2AMLogic/gf180-sar-adc/sim/README.md

# sim/ — evidence record format

This directory holds simulation testbenches and their results. Results are
**append-only evidence**: once a record is written, it is never edited or
deleted. A re-run — even one that corrects a mistake — mints a new record
with a new ID; a correction references the record it supersedes rather than
overwriting it in place.

This convention exists because CLAUDE.md commits this repo to two rules that
need a concrete schema to be enforceable:

- **Verification is the product.** No claim without a testbench. PVT
  corners on every recorded result (see "Corner matrix run" below).
- **`sim/` results are append-only evidence.** Re-runs get new records;
  records are never edited or deleted.

## Provenance: ported from gf180-bandgap

Per CLAUDE.md ("bootstrap from the sim-harness pattern... once it lands"),
this format is **ported from `2AMLogic/gf180-bandgap`'s `sim/README.md`**
rather than designed from scratch. The directory/naming convention,
record-id and corner-id schemes, and the base summary-record schema are kept
identical to upstream. Divergences exist only where an ADC-specific need
requires them; each is called out at the point it occurs, and summarized
here:

1. **Corner matrix is not fixed to a specific PVT list.** Upstream's
   bandgap `CLAUDE.md` states an explicit matrix (−40/27/125 °C, ±10%
   supply, process corners) that its README quotes directly. This repo's
   `CLAUDE.md` states the *rule* ("PVT corners on every recorded result")
   without a repo-wide fixed matrix — the actual corner list is pinned by
   the ratified spec (#1) and produced by the corner runner (#2), neither of
   which exists yet. The "Corner matrix run" field below is therefore
   normative on *what a record must state*, not on a specific numeric list.
2. **Five ADC-specific field groups added**: dynamic-test (FFT) metadata,
   a linearity methodology field, an extended Monte Carlo convention (seed +
   mismatch scope), a noise methodology field, and a characterization
   record variant. None of these exist upstream — the bandgap block has no
   analog-to-digital conversion, code density, or coherent-sampling
   concerns. See "ADC-specific extensions" below.
3. Everything else (directory layout, `<record-id>` / `<corner-id>` schemes,
   the base summary-record field list, the append-only rule, and the
   extracted-vs-schematic / `Supersedes` semantics) is unchanged from
   upstream, so that #2 (this repo's corner runner, bootstrapped from the
   same upstream repo) does not have to reconcile gratuitous drift.

## Directory / naming convention

Each testbench topic gets its own experiment directory:

```
sim/
  <experiment-slug>/                 # e.g. inl-dnl, enob-fft, comparator-noise,
                                      # mc-cdac-mismatch, device-characterization
    testbench/                       # testbench netlist(s) / xschem export used
    netlist-snapshots/
      <record-id>.spice              # frozen DUT netlist used for this record
    corners/
      <record-id>/
        <corner-id>.log              # raw ngspice output per PVT point
                                      # e.g. ss_-40c_2.97v.log
    records/
      <record-id>.md                 # append-only summary record
```

- **`<experiment-slug>`** — short, descriptive, kebab-case name for what is
  being verified (`inl-dnl`, `enob-fft`, `comparator-noise`,
  `mc-cdac-mismatch`, `device-characterization`, ...). One directory per
  distinct claim being tested, not per run.
- **`<record-id>`** — unique and traceable:
  `<YYYYMMDD>-<HHMMSS>-<short-git-sha>` (e.g. `20260730-143000-9f2a1cd`).
  Re-runs simply mint a new `<record-id>`; nothing under `records/` is ever
  edited in place. The same `<record-id>` ties together the netlist
  snapshot, the raw per-corner logs, and the summary record for one run.
- **`<corner-id>`** — `<process-corner>_<temp>c_<supply>v.log`, e.g.
  `ss_-40c_2.97v.log`, `tt_27c_3.30v.log`, `ff_125c_3.63v.log`.
- **`testbench/`** is not versioned per record — it holds the current
  testbench netlist(s)/xschem export(s) used to generate records. If the
  testbench itself changes in a way that could affect comparability across
  records, note that in the new record's summary (e.g. under Claim or a
  free-text note).

## Summary record format

Each run produces one `records/<record-id>.md` file. All records carry the
base fields below; records substantiating specific kinds of claims (dynamic
test, linearity, Monte Carlo, noise, characterization) also carry the
matching ADC-specific extension fields.

### Base fields (ported from upstream, unchanged)

- **Record ID** — the `<record-id>` for this run (matches the filename and
  the corresponding `netlist-snapshots/` / `corners/` subdirectory).
- **Claim** — which spec parameter/line this record substantiates (reference
  the ratified spec, e.g. `spec/<file>.md#<anchor>`, once ratified specs
  exist — see #1).
- **Netlist provenance** — `schematic` (`design/...`) or `extracted`
  (post-layout, `layout/...`). Required so post-layout re-runs are
  distinguishable from the original schematic-level record.
- **Corner matrix run** — explicit list of (process corner, temperature,
  supply) points actually executed. Must be the full PVT matrix pinned by
  the ratified spec (#1) / produced by the corner runner (#2) unless the
  record states why a subset was used (see "Subset-corner justification"
  below).
- **Statistical convention** (when applicable, e.g. Monte Carlo mismatch
  analysis) — see the Monte Carlo extension below for the ADC-specific
  fields this carries in addition to upstream's base N-samples-and-sigma.
- **Result** — per-corner pass/fail, plus an overall pass/fail against the
  ratified spec value. (Characterization records use "Measured value(s)"
  instead — see the Characterization-record variant below.)
- **Links** — paths to the testbench file(s), the frozen netlist snapshot,
  and the raw per-corner logs used to produce this record.
- **Timestamp / author** — when the record was created and who (human or
  agent) created it.
- **Supersedes** (optional) — the prior `<record-id>` this record
  supersedes, for corrections or for a post-layout extracted re-run that
  reports a schematic-vs-extracted delta against the schematic-level
  record. Mirrors the status/supersession language used for `spec/`
  decision records (see #6), so both conventions read as one house style.

  **A record with no `ok` point supersedes nothing.** A run in which every
  point errored (fleet timeout, Spot reclamation, a broken deck) measured
  nothing, so it cannot replace a record that did measure the deck — and
  because `sim/` is append-only, a measurement-free chain tip is permanent
  once committed. `run_corners.py` therefore **withholds** a requested
  `--supersedes` pointer when `points_ok` is 0: the record is still written
  as evidence of the attempt, but its field reads
  `(none — no point reached ok, so this record supersedes nothing; requested
  <id> withheld)`, which the chain checker reads as "no edge". The run also
  prints a note to stderr saying so; the exit code is unchanged. A run with
  **at least one** `ok` point keeps its pointer, partial or not.

  One record predates this rule and is wrong:
  `sim/sar-logic-functional-gates/records/20261113-080712-3eed6a0.md` has
  0/45 points `ok` yet declares `Supersedes: 20260917-044312-c7ff0ff`. It
  cannot be edited (append-only) and no measurement-free record can undo a
  `Supersedes` edge — only a measured successor can move the tip. The repair
  is therefore the next measured `sar-logic-functional-gates` record naming
  `20261113-080712-3eed6a0` as its own `Supersedes` target (owned by #753).

#### Subset-corner justification

A record may legitimately run fewer than the full PVT matrix (e.g. a
Monte Carlo mismatch distribution evaluated at nominal PVT only, or a
behaviorally-accelerated linearity sweep run at a reduced corner set to
bound simulation time). This is allowed, but the record's "Corner matrix
run" field must **state which corners were run and why the rest were
omitted** — an unexplained subset is not a valid record.

#### Correction-supersession vs distinct-claim distinction

`Supersedes` is only for records that **replace** a prior result for the
*same claim* (a correction, or a schematic → extracted re-run of the same
claim). A new record that tests a **different** claim about the same DUT
(e.g. a Monte Carlo distribution check following a corner-matrix pass/fail
check on the same parameter) is not a correction and must leave
`Supersedes` empty — see the two base worked-example records below, which
illustrate exactly this distinction.

### ADC-specific extensions

These fields have no upstream equivalent; each is required only on records
substantiating the corresponding kind of claim.

- **Dynamic-test (FFT) metadata** — required on any record substantiating an
  FFT-derived claim (ENOB, SNDR, SFDR, THD, ...):
  - **N samples** — FFT record length.
  - **Input frequency / coherent bin** — analog input frequency and the
    integer FFT bin it lands on under coherent sampling
    (`f_in = bin * f_s / N`, with `bin` coprime to `N`).
  - **Window** — `none` for coherent sampling (the default and preferred
    method); otherwise the windowing function name (e.g. `hann`,
    `blackman-harris`) and why coherent sampling was not used.
  - **Sampling rate** — `f_s` in Hz/MS/s.
- **Linearity methodology** — required on any INL/DNL record; states the
  code-set/method used, not left implied:
  - `full-1024-code-ramp` — every code exercised (exhaustive, most
    expensive).
  - `reduced-code-set-major-carry` — a reduced set concentrated at
    major-carry transitions (CDAC segment boundaries).
  - `code-density` — histogram/code-density method (e.g. sine-wave
    histogram) rather than a deterministic ramp.
  - `behavioral-accelerated` — a behaviorally-accelerated block substitutes
    for full transistor-level simulation on some portion of the codes;
    state which portion.
  - Free text after the tag should give the exact code count / transition
    list / acceleration method used.
- **Monte Carlo convention** — extends the base "Statistical convention"
  field. In addition to upstream's N samples and sigma level, a Monte Carlo
  record on this repo also states:
  - **Seed handling** — fixed seed value(s) used, or the seed-sweep policy
    (e.g. `seeds 1-500`, or ngspice's `.options seed=...` value(s)).
  - **Scope** — `mismatch-only` or `mismatch+process`, i.e. whether process
    (global) variation was included alongside device mismatch.
  - **Sigma level** — the sigma level the pass/fail criterion corresponds to
    (e.g. "±3σ within spec target").
- **Noise methodology** — required on any noise-budget record; states which
  method the claim rests on:
  - `transient-noise` — ngspice transient-noise analysis; must also state
    the **seed** and a **duration justification** (e.g. settling-time
    margin, noise-floor convergence check) so the run is reproducible and
    its length is defensible.
  - `ac-based` — an AC-noise-analysis-derived estimate (e.g. integrated
    output-referred noise from an `.noise` or `.ac` analysis with a stated
    integration bandwidth).
  - `both` — both methods were run and reported; state how they were
    reconciled (e.g. AC estimate as a bound, transient-noise as the
    reported claim).

### Characterization-record variant

A subset of records (e.g. device characterization, #4) report **measured
values under stated corner conditions** rather than pass/fail against a
ratified spec line — there may be no spec line yet, or the record's purpose
is to inform one. These records use the same base fields with two
modifications:

- **Result** is replaced by **Measured value(s)** — the measured
  quantity/quantities, each paired with the corner condition(s) it was
  measured at. No pass/fail verdict is required (though one may be added
  once a ratified spec line exists, via a later record referencing this one
  under Links).
- **Data provenance** (new, required) — where the measured value's inputs
  came from:
  - `model-card-monte-carlo` — derived from the gf180mcu PDK model card's
    Monte Carlo mismatch statistics.
  - `foundry-documentation` — taken from foundry-published device
    documentation/datasheets.
  - `literature-assumption-with-derating` — a literature-sourced assumption,
    with the derating applied and its rationale stated.
  - Free text after the tag should identify the specific source (model
    card revision, document title/section, or literature citation) and any
    derating factor applied.

## Extracted vs schematic semantics

Unchanged from upstream. **Netlist provenance** states `schematic` or
`extracted`; a post-layout extracted re-run of an existing claim lives in
the *same* experiment directory with its own `<record-id>`,
`Netlist provenance: extracted`, and a `Supersedes` field carrying a
schematic-vs-extracted delta summary in its Result (or Measured value(s))
section. The extracted record **appends alongside** the schematic record —
it never replaces or edits it; both remain readable as the evidence trail
CLAUDE.md requires.

## Digital-flow evidence (synthesis, place-and-route, STA) lives outside `sim/`

The SAR-logic sequencer's digital flow (`klt synthesize` / `klt
place-and-route` / STA against the DR-0023 gate-level netlist) is **not**
an ngspice testbench, so it does not use this directory's
`testbench/`/`corners/`-per-PVT-point shape. It follows a parallel,
analogous convention instead, established by issue #272's synthesis driver
and reused by every follow-on:

```
design/sar-logic/flow/
  synth_sar_ctrl.py / sta_sar_ctrl.py    # flow drivers (one per klt verb)
  sta_sar_ctrl_postroute.py              # post-route klt sta re-run, once a routed DEF exists
  flow_env.py                            # the one git/klt provenance implementation every driver imports
  sar_ctrl/
    netlist/<top>.<lib-tag>.synth.v      # regenerated in place, like sim/'s testbench/
    sta/<top>.sdc                        # documentation SDC, regenerated in place
    reports/<record-id>.<lib-tag>.*.json # exact klt request/response per run
    records/<record-id>.<lib-tag>.<verb>.md  # append-only evidence record
```

Same append-only rule for `records/`, same `<record-id>` grammar
(`<YYYYMMDD>-<HHMMSS>-<short-git-sha>`, `<lib-tag>`-suffixed — e.g.
`mcu7t5v0`), same "PVT corners on every recorded result" discipline
(CLAUDE.md) — just keyed to the standard-cell library's liberty corners
(`tt_025C_3v30`, `ss_125C_3v00`, ...) rather to this directory's
`<process>_<temp>c_<supply>v` transistor-level corner-id scheme. See
`design/sar-logic/flow/sar_ctrl/records/` for the synthesis (#272),
pre-route STA (#275, DR-0023 follow-on (c) — placement-estimate
substitution, superseded for signoff purposes but kept as historical
evidence per the append-only rule below), place-and-route (#274/#279), and
post-route STA (#275 addendum — real `klt sta` against the routed DEF; the
signoff-relevant timing record going forward, per its own `Supersedes`
field) evidence.

## Running a grid on the batch fleet (`--backend`)

Dispatch workers are shared hosts that must not run multi-corner `ngspice -b`
grids themselves; they export `KLT_SIM_BACKEND=batch` and send grids to the
Spot batch fleet through `klt sim`. `sim/run_corners.py` does this natively
(`sim/harness/batch.py`), and the result lands in the **same** append-only
record format as a local run:

```
# on a dispatch host ($KLT_SIM_BACKEND=batch): a multi-point grid goes to the fleet
python3 sim/run_corners.py sar-logic-timing-gates --timeout 3600

# explicit
python3 sim/run_corners.py <experiment> --backend batch      # or: remote
python3 sim/run_corners.py <experiment> --backend local      # on THIS host (single point, or no dispatch marker)
```

- **`--backend auto` (default)** follows `$KLT_SIM_BACKEND`. When it names an
  off-host backend and the grid has more than one point, the grid is exported
  as a `klt sim` request and is never run on this host; a single point stays
  local (what `klt sim` itself does). With the variable unset the behaviour
  is exactly what it always was.
- **Dispatch hosts refuse local grids.** `--backend local` on a multi-point
  grid while `$KLT_SIM_BACKEND` is `batch`/`remote` is an error unless
  `--allow-local-grid` is also given (for a host that really is a simulation
  box).
- **The backend is always passed to `klt` explicitly** (`klt sim --backend
  batch`, resolved from `$KLT_SIM_BACKEND` under `auto`). A `klt` release that
  predates `$KLT_SIM_BACKEND` (0.5.x, e.g. a `--klt-cmd` pinned to match an
  older fleet runner) ignores the variable and would run the grid on this
  host; the explicit flag makes it submit or fail, never run locally. For
  `batch` the harness uses `klt sim --batch-set`, which is batch-only by
  contract; a klt that predates `--batch-set` (klayout-tools#2869) fails the
  submit with a usage error rather than running anything.
- **No local fallback.** A failed submit (no capacity, rejected request, job
  failure with no report) exits 3 having recorded nothing. It is not retried
  on this host's cores; report the error and re-submit.
- **What is exported.** `tb.json` -> **one `klt sim` request per supply
  value** (issue #505), submitted together with `klt sim --batch-set` (the
  batch backend; `--backend remote` submits them one by one). Each request
  carries the corner bundles as `corners.process` (one `.lib` section per
  device family, in the PDK's order), the temperatures as
  `corners.temperature_c`, `--timeout` as `options.timeout_s`, and the
  analysis + `meas` lines + `measure` expressions as the analysis and
  `measurements[]`; together the requests cover the same process x supply x
  temperature factorial as a local run. Each request's circuit body (`.param`
  set, `design.ngspice`, the `mim_cap_*` aliases, `.options`, the testbench
  fragment) binds `.param vdd_val=<that supply>` at parse time, exactly as
  the local runner's per-point deck does, and the bodies differ in that line
  only. There is deliberately **no `corners.supply_v`**: that axis is an
  ngspice `alter` on a *source*, `vdd_val` is a `.param` (klt rejects it), and
  re-keying the axis onto the DC rails would leave everything else the
  testbenches derive from `vdd_val` -- clock pulse amplitudes, `vref`/`vcm`,
  the XSPICE bridge thresholds, `/vdd_val` terms in measurements -- at nominal
  (a silently wrong corner). Results are matched back to grid points by
  (process, temperature, *the supply of the request that produced them*). A
  request that comes back without a report (refused, capacity, job failure)
  turns every point of its supply into an `error` point, never `ok`; only a
  set in which no request produced a report exits 3 with nothing recorded.
  The generated files are `sim/.work/<experiment>/<record-id>/klt/vdd<i>-<V>v.{spice,json}`
  (plus `set-report.json`, klt's aggregate envelope); the frozen copies are
  `netlist-snapshots/<record-id>.batch-body.vdd<i>-<V>v.spice` and
  `corners/<record-id>/klt-request.vdd<i>-<V>v.json` /
  `klt-report.vdd<i>-<V>v.json` / `klt-set-report.json`. When klt grows a
  parameter corner axis (`corners.params`, klayout-tools#3035) this can
  collapse back to a single request. `--klt-cmd` must name a klt that has
  `--batch-set`.
- **What is refused (never approximated).** `klt sim` runs one analysis per
  corner, then `.meas` cards and expressions. A manifest whose `analyses`
  contain anything else (`setseed`, `let`, `linearize`, `alterparam`,
  `noise` after another analysis, ...) is refused with the offending line
  named, as is a testbench fragment that reads the per-point `temp_c`
  `.param` (klt's temperature axis sets `.temp` only). Run those with
  `--backend local`.
- **Record format.** Unchanged: netlist hash, manifest hash, corner matrix,
  per-point status, git commit and clean-tree flag (sampled before the run),
  toolchain pins and their check. A batch record adds an *Executed via*
  line in the Environment section: backend, runner PDK, the models-library
  hash, and per supply request its fleet job id, instance, the runner's klt
  version and compatibility, and the generated-body / request hashes.
- **Pins are checked on the fleet's values.** The open_pdks hash and ngspice
  major are compared against `sim/toolchain.json` using what `klt` reports
  the *runner* used (not this host's tools); a drift is refused unless
  `--allow-toolchain-drift`, exactly as locally.
- **Per-point honesty is preserved.** A corner `klt` reports as timed out is
  an `error` point reading `ngspice timed out after <--timeout>s` (the same
  text the local runner writes); a corner whose ngspice log shows an aborted
  analysis (`Timestep too small`, issue #341) or whose log could not be
  retrieved is `failed`, never `ok`; a point missing from the report is an
  `error`, never dropped.
- **Runner/client version skew.** The fleet image's `klt` must equal the
  submitting client's (`--runner-version-check enforce`, default; use
  `--klt-cmd 'uvx --from klayout-tools==X.Y.Z klt'` for a throwaway matching
  client rather than touching the host's tool). `--runner-version-check
  warn` runs anyway; the skew and its one certain consequence (the
  `numdgt=10` print precision may not have been applied) are stamped into
  the record, and a run that depends on `--ngspice-threads` or
  `--save-measured-vectors` (which an older runner silently ignores) is
  refused rather than recorded.
- **Smoke record.** `sim/sar-logic-timing/records/20261008-160023-8477a2e.md` is
  a 3-point (tt/ss/ff, 27 C) grid that ran end to end on the batch fleet
  (job `klt-sim-06a37517edf7`), recorded as a labelled subset.
- **Fleet runner image caveat.** A runner klt older than the client refuses
  the job under `enforce`, and one older than 0.6 rejects `measurements[].expr`
  (any measurement that reads a vector or operating point); `.meas`-only
  experiments run under `--runner-version-check warn` with the skew stamped.
- **Runner version observed (2026-10-14, issue #505).** Client klt
  `0.7.1.dev410+ge992cfa5a699` (the host tool); the fleet runner reported
  klt `0.7.0`, ngspice 46, `runner_compatibility: match`, for all three jobs
  of a 3-supply x tt x 27 C smoke of the **extracted** `adc-inl-dnl` deck
  (`klt-sim-c3eefee9ea5e`, `klt-sim-649402e7b443`, `klt-sim-74ba93b19301`;
  `--no-write`, so no record). All three points `ok`; klt's
  `environment.netlist_sha256` for each job equals the sha256 of the body
  carrying that job's `.param vdd_val=` line, and the body's one `.include`
  (`design.ngspice`; the extracted fragment itself is inline) was staged by
  that runner. No runner/client mismatch was
  found; the client-side rejection of the old `corners.supply_v` request was
  reproduced first with client `0.7.1.dev407+g051c1336210e`.
- **Measurements.** An expression over `meas` results (`(b-a)*1e9`) is sent as
  a `.meas ... param='...'` card, which every runner version can run; one
  that reads a vector or an operating point (`v(out)`, `i(vsup)`) is sent as
  a `measurements[].expr`, which needs a runner that has it.

## Stored evidence (artifact store, not git)

Since issue #636 ([DR-0041](../spec/decision-records/DR-0041-evidence-bytes-in-artifact-store.md))
the bytes of a **new** recorded run are not committed. `sim/run_corners.py`
stages the netlist snapshot(s) and the raw per-corner logs in the git-ignored
`sim/.work/.stage/<experiment>/`, stores each file with
`klt artifact put`, and commits only:

- `manifests/artifacts/<experiment>-<record-id>.manifest.json` — name, size,
  sha256 and `artifact:<key>` URI of every stored object; and
- `records/<record-id>.md` — the usual record, whose **Netlist snapshot** and
  **Raw logs** links read `(stored, not in git; manifest ...)` and which ends
  in a `## Stored evidence` table (name, size, sha256 per object).

So `netlist-snapshots/` and `corners/<record-id>/` exist in this tree only for
records taken before #636; for newer records they are the *logical* paths in the
manifest's `name` fields. Fetch one object, hash-verified, with
`klt artifact get <manifest>#<name> -o <out>`; check them all with
`klt artifact verify <manifest>` (needs `$KLT_ARTIFACT_BROKER`, set on fleet
workers). Evidence bytes are private, manifests are public.

**Fail closed.** If `$KLT_ARTIFACT_BROKER` is unset, `klt` lacks `artifact put`
(or predates klayout-tools `7e3561f`), or the broker is unreachable or refuses,
a recorded run exits **10 before simulating**, and a store that fails after the
grid keeps the staged bytes under `sim/.work/.stage/` and commits nothing.
There is no fallback that commits the bytes. `--no-write` runs need no store.

Campaign outputs that do not go through the corner runner (a `klt sim`
campaign, a PEX batch, a layout-side run) are staged anywhere git-ignored or
outside the repo and stored with:

```bash
python3 sim/run_store_evidence.py <bench> <run-id> <staged-dir> --summary <summary.md> \
    [--kind campaigns|records|corners|reports] [--under layout/adc-top/economy]
```

which commits the manifest plus `<home>/<kind>/<run-id>.md` (the summary with
the "Stored evidence" table appended) and refuses a staged directory inside the
tracked tree. Older evidence stays committed where it is; nothing is rewritten.

**Enforced in CI.** `scripts/check_artifact_manifests.py check` (stdlib only)
validates every manifest, requires `artifact:` URIs, fails if a stored object's
bytes are also committed and fails if a PR adds new files under
`sim/*/corners/`; manifests are append-only like `records/`. Tests:
`sim/tests/test_check_artifact_manifests.py`, `sim/tests/test_evidence_store.py`.

## Append-only rule

`records/*.md` files are never edited or deleted after creation. A re-run or
a correction always creates a new record with a new `<record-id>`. If it
corrects or replaces a prior result, it references that prior record via
**Supersedes** rather than overwriting it. This applies even to typo fixes —
the append-only guarantee is what makes `sim/` usable as an evidence trail;
"fixing" an existing record in place would defeat that.

**Enforced in CI.** `sim/tools/check_append_only_records.py` (`npm run
check:records`, part of `check:ci`) diffs the PR head against its merge base
and fails on any modified, renamed, deleted or type-changed file under any
directory named `records/` (`sim/*/records`, `signoff/records`,
`layout/**/records`, `design/**/records`, ...). New files pass; a correction
is a new superseding record. `signoff/evidence` is regenerated, not
append-only, and is not guarded. The only escape hatch is a reviewed entry in
`sim/tools/append_only_allowlist.txt` (`<path>  # <justification>`,
justification mandatory; empty by default). Negative control:
`sim/tests/test_check_append_only_records.py`.

**Index superseded records.** A record cannot be edited to point forward at
its replacement, so list each superseding record next to the record it
supersedes, in an index that is *not* under a `records/` directory: the
`README.md` of the directory that owns the `records/` directory (for example
`layout/adc-top/economy/README.md`). A `records/INDEX.md` would be frozen by
the check above after its first commit. The index is an ordinary editable
file; adding an entry never touches a record file.

**Footprint (report-only).** `sim/tools/evidence_footprint.py` (`npm run
report:evidence-footprint`, last step of `check:ci`) lists tracked bytes per
`sim/<experiment>/` (`--records` adds per-record rows) and compares them with
the ceilings in `sim/tools/evidence_footprint_budget.json`. It never fails CI
unless run with `--strict`, and never modifies evidence. The retention
question it measures is DR-0039 (proposed). Test:
`sim/tests/test_evidence_footprint.py`.

## Worked example

Directory layout for an INL/DNL linearity claim, followed by a Monte Carlo
mismatch re-check of a related claim on the same DUT (illustrating the
correction-supersession vs distinct-claim distinction):

```
sim/
  inl-dnl/
    testbench/
      tb_inl_dnl_ramp.spice
    netlist-snapshots/
      20260730-143000-9f2a1cd.spice
      20260731-101500-2b6e0f1.spice
    corners/
      20260730-143000-9f2a1cd/
        tt_27c_3.30v.log
        ss_-40c_2.97v.log
        ff_125c_3.63v.log
        ...
      20260731-101500-2b6e0f1/
        tt_27c_3.30v.log
        ...
    records/
      20260730-143000-9f2a1cd.md
      20260731-101500-2b6e0f1.md
```

`records/20260730-143000-9f2a1cd.md` (placeholder values — no ratified spec
values exist yet, see #1):

```markdown
# Record 20260730-143000-9f2a1cd

- **Record ID**: 20260730-143000-9f2a1cd
- **Claim**: `spec/adc.md#inl-dnl` — INL/DNL over the full code range,
  TBD LSB target (placeholder; ratified spec pending #1; draft target in
  README.md is < 1 LSB / stretch < 0.5 LSB)
- **Netlist provenance**: schematic (`design/sar_adc.sch`)
- **Corner matrix run**:
  - Process: tt, ss, ff
  - Temperature: −40 °C, 27 °C, 125 °C
  - Supply: 2.97 V, 3.30 V, 3.63 V (±10% of 3.3 V)
  - (9 corner points total; see testbench for exact point list — matrix
    pinned by ratified spec #1 / produced by corner runner #2, both
    pending, so this list is illustrative pending those)
- **Statistical convention**: N/A (corner-matrix claim, not a distribution
  claim)
- **Linearity methodology**: `full-1024-code-ramp` — all 1024 codes
  exercised via a monotonic ramp input (placeholder methodology; issue #13
  will confirm the production method)
- **Result**:
  - tt/27C/3.30V: PASS, max|INL| = 0.42 LSB, max|DNL| = 0.31 LSB
    (placeholder values)
  - ss/-40C/2.97V: PASS (placeholder value)
  - ff/125C/3.63V: PASS (placeholder value)
  - ... (remaining corners: PASS, placeholder values)
  - **Overall: PASS** (placeholder — pending ratified spec, #1)
- **Links**:
  - Testbench: `sim/inl-dnl/testbench/tb_inl_dnl_ramp.spice`
  - Netlist snapshot: `sim/inl-dnl/netlist-snapshots/20260730-143000-9f2a1cd.spice`
  - Raw logs: `sim/inl-dnl/corners/20260730-143000-9f2a1cd/`
- **Timestamp / author**: 2026-07-30T14:30:00Z, agent-builder
- **Supersedes**: (none — first record for this claim)
```

`records/20260731-101500-2b6e0f1.md` — a later Monte Carlo mismatch check of
CDAC-induced linearity spread on the same DUT (illustrates the Monte Carlo
extension fields; this is a distinct claim from the corner-matrix record
above, not a correction of it, so it does not use Supersedes):

```markdown
# Record 20260731-101500-2b6e0f1

- **Record ID**: 20260731-101500-2b6e0f1
- **Claim**: `spec/adc.md#inl-dnl-mismatch-spread` — INL/DNL spread under
  CDAC capacitor mismatch, untrimmed (placeholder; ratified spec pending
  #1)
- **Netlist provenance**: schematic (`design/sar_adc.sch`)
- **Corner matrix run**: nominal corner (tt/27C/3.30V) only — mismatch
  distribution is evaluated at nominal PVT; see Statistical convention and
  Subset-corner justification above
- **Statistical convention**: N = 500 Monte Carlo samples, ±3σ spread
  reported against the untrimmed spec target
  - **Seed handling**: seeds 1–500 (`.options seed=<n>`, one run per seed)
  - **Scope**: mismatch-only (process held at nominal `tt` corner)
- **Linearity methodology**: `reduced-code-set-major-carry` — mismatch
  spread evaluated at CDAC major-carry transitions only, not the full
  1024-code ramp, to keep the 500-sample sweep tractable (placeholder
  methodology)
- **Result**: ±3σ max|INL| and max|DNL| spread within untrimmed spec
  (placeholder value) — **Overall: PASS** (placeholder — pending ratified
  spec, #1)
- **Links**:
  - Testbench: `sim/inl-dnl/testbench/tb_inl_dnl_mc.spice`
  - Netlist snapshot: `sim/inl-dnl/netlist-snapshots/20260731-101500-2b6e0f1.spice`
  - Raw logs: `sim/inl-dnl/corners/20260731-101500-2b6e0f1/`
- **Timestamp / author**: 2026-07-31T10:15:00Z, agent-builder
- **Supersedes**: (none — distinct claim from 20260730-143000-9f2a1cd, not a
  correction of it)
```

A later post-layout extracted re-run of the original corner-matrix claim
would live under the same `inl-dnl/` experiment directory with its own
`<record-id>`, `Netlist provenance: extracted (layout/sar_adc.gds ->
extracted netlist)`, and a `Supersedes: 20260730-143000-9f2a1cd` field
carrying a schematic-vs-extracted delta summary in its Result section — see
#17.

The remaining ADC-specific field groups not shown in the two records above
follow the same pattern; each is a required addition to the base schema on
the record types below, not a separate document:

- A dynamic-test (ENOB/SNDR/SFDR/THD) record adds the **Dynamic-test (FFT)
  metadata** block (N samples, input frequency / coherent bin, window,
  sampling rate) alongside the base fields — see #13.
- A noise-budget record adds the **Noise methodology** field
  (`transient-noise` with seed/duration justification, `ac-based`, or
  `both`) — see #9.
- A device-characterization record (e.g. CDAC cap, switch, comparator
  input-pair characterization) uses the **Characterization-record variant**
  (Measured value(s) + Data provenance instead of Result) — see #4.
