2AMLogic/gf180-sar-adc/layout/adc-top/README.md

# layout/adc-top/ — the block-level layout of `design/adc-top/`

Issue #57. This directory holds the **drawn block layout** for the ADC's
analog core and the code that generates it, plus the flat SPICE references
`klt lvs` compares the extraction against.

Everything here is generated. The generators are the reviewable source of
the GDS, not the GDS itself — same rule `layout/drc/cells/` already set for
its proof cells, for the same reason: the deck is upstream-owned and grows,
so a stream that cannot be rebuilt is evidence with a short shelf life.

```
layout/adc-top/
  lib/
    geometry.py      gf180mcu primitives + the two-layer channel router
    place.py         flattened-device-list -> placed, routed row
    netlist.py       design/ SPICE parser, flattener, LVS-reference writer
  cells/
    gen_adc_cells.py       generates the five leaf cells below
    adc_drv.*              local T-gate driver          (2 devices)
    adc_tgate.*            CDAC bottom-plate T-gate     (2 devices)
    adc_tgate_dum.*        superseded input sampling switch (4 devices) --
                            DR-0014 dropped it from `adc_top`/`adc_block`'s
                            composition; still drawn/LVS-matched standalone
                            (`design/adc-top/adc_top.spice` still defines it)
    adc_cdac_cell.*        one weighted CDAC position   (16 devices + 1 cap,
                            the cap wired and LVS-checked -- issue #70)
    adc_tp_sw.*            top-plate V_cm switch (DR-0014) (4 devices)
  gen_comparator.py        generates the comparator cells
    comparator.*           comparator + load resistors  (27 devices + 2 R)
    comparator_nores.*     same, resistor bodies omitted
  gen_adc_top.py           generates the block
    adc_top.*              the block: exactly adc_top.spice
                            (296 transistors + 1024 unit MiM caps)
    adc_block.*            the assembled block: + comparator
                            (323 transistors + 1024 unit MiM caps)
    area.json              the as-drawn area tally
  parasitics/              PDK-bound, parasitic-aware extraction (issue #17)
                           -- see parasitics/README.md, a separate directory
                           with its own runner/records/reports
  sar_ctrl/                the SAR-logic sequencer's placed-and-routed macro
                           (issue #274) -- see sar_ctrl/README.md; driven by
                           design/sar-logic/flow/pnr_sar_ctrl.py, not by a
                           generator in this directory (its "source" is the
                           synthesized netlist + `klt place-and-route`, not
                           hand-placed KLayout primitives)
```

For each cell `X`: `X.gds` (the layout), `X.spice` (`klt extract`'s output,
regenerated, never hand-edited), `X.ref.spice` (the flat LVS reference) and
`X.lvs.json` (the `klt lvs` request document).

## Reproducing it

```bash
python3 layout/adc-top/cells/gen_adc_cells.py
python3 layout/adc-top/gen_comparator.py
python3 layout/adc-top/gen_adc_top.py
git status --short layout/adc-top/          # should be empty: byte-reproducible

python3 layout/drc/run_drc.py --check       # every cell here, asserted
python3 layout/lvs/run_lvs.py --check       # every extraction + LVS case, asserted
```

The two runners are `layout/`'s existing ones (issues #15 and #51). These
cells are listed in their manifests rather than given a third runner, so
this repo keeps **one** append-only DRC record trail and **one** LVS record
trail with one set of assertions behind them.

## Results

**Latest records (issue #378, `adc_block.gds` `501f3985…`)**: DRC
[`layout/drc/records/20260923-084515-5f13cf9.md`](../drc/records/20260923-084515-5f13cf9.md)
(clean on both streams), LVS
[`layout/lvs/records/20260923-084536-5f13cf9.md`](../lvs/records/20260923-084536-5f13cf9.md)
(`match`, 0 mismatches, **extracted netlists byte-identical** to the
pre-#378 ones), ERC
[`layout/erc/records/20260923-084733-5f13cf9.md`](../erc/records/20260923-084733-5f13cf9.md),
IR/EM
[`layout/power/records/20260923-084734-5f13cf9.md`](../power/records/20260923-084734-5f13cf9.md)
and signoff
[`signoff/records/20260923-084903-5f13cf9.md`](../../signoff/records/20260923-084903-5f13cf9.md).
The change is the block-level supply straps moving from Poly2 to Metal2
([DR-0037](../../spec/decision-records/DR-0037-block-level-supply-straps-on-metal2.md)):
it moves conductors, not connectivity, so every structural verdict is where
it was and the droop verdict is what moved — all four labelled landing sites
now meet DR-0034's 33 mV budget at both resistance corners.

Earlier records, kept as written — note that this list predates issues #356
and #378 and is not re-derived here: DRC
[`layout/drc/records/20260817-185713-40cfeb8.md`](../drc/records/20260817-185713-40cfeb8.md),
LVS
[`layout/lvs/records/20260817-185722-40cfeb8.md`](../lvs/records/20260817-185722-40cfeb8.md)
— issue #215's **strap-corridor re-derivation** (both top-level supply
corridors derived from the geometry they tie rather than from
`top.bbox().right`): devices, nets and pin counts are unchanged everywhere
(1349/198/71 for `adc_block`, as before), and so are the extracted netlists
themselves, byte for byte — this step moves corridors, not connectivity;
`klt drc`/`klt lvs` are clean and matched on `comparator`/`comparator_nores`/
`adc_top`/`adc_block`. Prior records: issue #215's load-resistor **fold**
(each 150 kΩ `ppolyf_u_1k` body drawn as a four-leg serpentine instead of a
150 µm straight run; counts unchanged, each body still ONE connected polygon
extracting as ONE device at exactly 150 000 Ω), DRC
[`layout/drc/records/20260817-144045-ae0b956.md`](../drc/records/20260817-144045-ae0b956.md)
/ LVS
[`layout/lvs/records/20260817-144056-ae0b956.md`](../lvs/records/20260817-144056-ae0b956.md);
issue #196's DR-0019 unit-cap resize
(`C_u` = 17.24 fF / 2.7136 µm plate → 35.6528 fF / 4.0 µm plate, tiling
pitch 5.1136 µm → 6.4 µm; devices, nets and pin counts unchanged — the
resize moves plate geometry, not connectivity), DRC
[`layout/drc/records/20260817-010430-e38d9b7.md`](../drc/records/20260817-010430-e38d9b7.md),
LVS
[`layout/lvs/records/20260817-010443-e38d9b7.md`](../lvs/records/20260817-010443-e38d9b7.md);
issue #118's resistor markers (`comparator`/
`adc_block` device_count, net_count and pin_count all move; see "Resistors,
and why there are two comparator cells" below for the full re-baseline and
`layout/lvs/cells/cells.json` for the exact numbers), DRC
[`layout/drc/records/20260806-233236-56be937.md`](../drc/records/20260806-233236-56be937.md),
LVS
[`layout/lvs/records/20260806-233251-56be937.md`](../lvs/records/20260806-233251-56be937.md).
Prior records: issue #116's floating differential-input fix, DRC
[`layout/drc/records/20260806-193859-68ad582.md`](../drc/records/20260806-193859-68ad582.md),
LVS
[`layout/lvs/records/20260806-193909-68ad582.md`](../lvs/records/20260806-193909-68ad582.md);
before that, issue #91's fourth-leg input-pin label (`pinp`/`pinn`,
`ADC_TOP`/`ADC_BLOCK` pin_count 63→65 / 67→69; devices/nets/DRC status
unchanged, a label adds no geometry or connectivity), DRC
[`layout/drc/records/20260805-122538-e8017f2.md`](../drc/records/20260805-122538-e8017f2.md),
LVS
[`layout/lvs/records/20260805-122516-e8017f2.md`](../lvs/records/20260805-122516-e8017f2.md).
Prior records: the CDAC array's plate routing and
its 1024 extracted unit capacitors (issues #85/#86), DRC
[`layout/drc/records/20260804-184332-9d8422d.md`](../drc/records/20260804-184332-9d8422d.md),
LVS
[`layout/lvs/records/20260804-184401-9d8422d.md`](../lvs/records/20260804-184401-9d8422d.md),
taken against the pinned `klt` at `af5791b`. Prior to that: the MiM-stack fix (issue #70), DRC
[`layout/drc/records/20260804-205502-a0f8784.md`](../drc/records/20260804-205502-a0f8784.md),
LVS
[`layout/lvs/records/20260804-205512-a0f8784.md`](../lvs/records/20260804-205512-a0f8784.md);
the area re-pitch (issue #67),
DRC
[`layout/drc/records/20260804-181054-4097611.md`](../drc/records/20260804-181054-4097611.md),
LVS
[`layout/lvs/records/20260804-181107-c672a81.md`](../lvs/records/20260804-181107-c672a81.md);
the DR-0014 redraw (issue #66), DRC
[`layout/drc/records/20260804-100548-688c2eb.md`](../drc/records/20260804-100548-688c2eb.md),
LVS
[`layout/lvs/records/20260804-100640-688c2eb.md`](../lvs/records/20260804-100640-688c2eb.md);
and the pre-DR-0014 bring-up (issue #62), DRC
[`layout/drc/records/20260801-225603-7866d03.md`](../drc/records/20260801-225603-7866d03.md),
LVS
[`layout/lvs/records/20260801-225959-7866d03.md`](../lvs/records/20260801-225959-7866d03.md).

| Cell | Devices | `klt drc` | `klt lvs` vs. `design/` |
|---|---|---|---|
| `adc_drv` | 2 | clean | match, 0 mismatches |
| `adc_tgate` | 2 | clean | match, 0 mismatches |
| `adc_tgate_dum` (superseded, standalone only) | 4 | clean | match, 0 mismatches |
| `adc_cdac_cell` | 16 + **1 MiM cap** | clean | match, 0 mismatches |
| `adc_tp_sw` | 4 | clean | match, 0 mismatches |
| `comparator_nores` | 27 | clean | match, 0 mismatches |
| `comparator` | 27 + **2 R** | clean | match, 0 mismatches |
| **`adc_top`** | **296 + 1024 MiM caps** | **clean** | **match, 0 mismatches** |
| **`adc_block`** | **323 + 2 R + 1024 MiM caps** | **clean** | **match, 0 mismatches** |

Every case above is a genuine `mismatch_count: 0` as of issue #118 -- the
comparator's two 150 kohm load resistors are now real `ppolyf_u_1k` devices
(not a Poly2 short needing a net merge, see "Resistors" below), so `pop`/
`pon` are LVS-checked, not just DRC-checked geometry, in both the
`comparator` and `adc_block` cases.

**`adc_top`'s LVS target is `design/adc-top/adc_top.spice` exactly** — two
`adc_cdac_side` arrays (each cell's fourth, one-hot leg to `V_in` included,
DR-0014) and the two per-side top-plate `V_cm` switches (`adc_tp_sw`,
DR-0014), the same composition `sim/adc-enob-fft/testbench/` instantiates.
`adc_block` is that plus `design/comparator/comparator.spice`'s comparator,
strapped to the top plates and the analog rails. `adc_tgate_dum` (the
dedicated input sampling switch DR-0014 superseded) is no longer part of
either composition, but `design/adc-top/adc_top.spice` still defines it
(DR-0014-comment-marked), so it stays drawn and LVS-matched standalone —
see `cells/gen_adc_cells.py`'s own docstring.

## What the matching plan asked for, and what is drawn

Against [`../floorplan-matching-plan.md`](../floorplan-matching-plan.md).
Every row is either *implemented* or a **stated deviation** — nothing is
silently skipped.

| Plan | Status | Where / why |
|---|---|---|
| §1.1 512 unit positions per side, plain binary, free-MSB | implemented | 32 × 16 grid per side, 1024 units total; per-weight census in `area.json` (`256`:256 … `1`:1, `term`:1) |
| §1.2 MiM `cap_mim_2f0fF`, `C_u` = 35.6528 fF at 4.0 µm (DR-0019; was 17.24 fF at 2.7136 µm) | implemented, **and now DRC-checked** | `geometry.draw_mim_cap`; the FuseTop plate is drawn at the ratified 4.0 µm and Metal4 is derived from `MIMTM.3`. The deck checks `MIMTM.1`/`.2`/`.3` and Metal2/3/5 as of the issue #70 pin — see "The MiM stack" below |
| §1.3 common-centroid unit-cap tiling | implemented, with a stated caveat | `gen_adc_top.centroid_tiling` — centro-symmetric position pairs, bit-reversed deal; common-centroid *by construction*, not by inspection. Exact for every even-count weight; the two single-unit groups are exact only *combined* — see "Caveat" below. Asserted by [`sim/tests/test_layout_centroid_tiling.py`](../../sim/tests/test_layout_centroid_tiling.py) |
| §1.3 full dummy ring | implemented | one extra tile all round, identical drawn geometry, electrically floating |
| §1.3 routing kept off the capacitor dielectric | implemented | nothing crosses a plate: over the array there is only the Metal5 top-plate mesh (the plates' own terminal). The per-weight bottom-plate interconnect (#85) runs in the inter-row and inter-column gaps between MiM footprints — Metal1 row trunks below each row, Metal2 spines in a gap — and the block-level routing (#86) runs *under* both arrays, below their bottom edge. All switch/driver routing stays Metal1/Poly2 in a separate region |
| §1.4 single top-plate net per side, short path from the electrical centre, P/N symmetric | implemented, **and now verified** | Metal5 row straps + a spine on the array's own centre, identical on both sides, continued down out of the cell to `topp`/`topn` (#86). `klt extract` reports each side's 512 top plates on one net, and `klt lvs` matches it |
| §1.4 no daisy-chaining | implemented | mesh, not chain |
| §1.5 sampling switch at the array's input edge, not inside the array | implemented | `ADC_TOP_SW` (the `adc_tp_sw` top-plate `V_cm` switch, DR-0014) placed beside the arrays, same floorplan slot the superseded `adc_tgate_dum` used to occupy |
| §1.5 dummy placed symmetrically w.r.t. its main device | **superseded** | this row describes DR-0013's dummy-compensated input sampling switch (`adc_tgate_dum`), which DR-0014 removed from the converter. Still true of `adc_tgate_dum` where it is still drawn (device order `XDN XN | XN XDN` / `XDP XP | XP XDP`), but that cell is no longer in `adc_top`/`adc_block`'s composition. The switch that IS in the composition now, `adc_tp_sw`, is deliberately NOT dummy-compensated — `design/adc-top/adc_top.spice`'s own comment on the subckt explains why (its channel always opens at `V_cm`, a signal-independent node, so there is no input-dependent injection left to compensate) |
| §1.5/DR-0013 dummy drawn as a **finger count** (7 of 16 fingers) | **superseded** | applied to `adc_tgate_dum`, no longer in the composition (see row above); N/A to `adc_tp_sw` |
| §1.6 decode switches adjacent to their own weighted position | implemented | one placement group per weighted cell, in MSB→LSB order |
| §2.1 preamp branches common-centroid **including** the load resistors | **partial** | resistors: yes, genuinely (A-B-B-A, two segments each). Transistors: mirror-symmetric adjacent pairs, **not** common-centroid. See "Single-finger devices" |
| §2.3 regeneration nodes kept away from top-plate routing | implemented | placement order preamp → latch → inverters → SR latch, so `outp`/`outn` and `clk` sit at the far end of the cell from `vinp`/`vinn` |
| §2.4 guard rings around the comparator and the CDAC array | implemented | one contacted `Comp`/`Contact`/`Metal1` ring around the whole analog core, and a second around the reserved digital region. Since issue #356 (DR-0035) both are **closed** annuli (the `Metal1` used to be four corner-open bars), `Pplus` 31/0-marked, contacted with `CO.1`-compliant 0.22 µm square arrays rather than long bars, labelled `vss` and routed into the block's own `vss` island — they were drawn but strapped to nothing before that |
| §2.4 physical spacing between SAR logic and the analog core, ring on the boundary | implemented | 20 µm gap, separately-ringed reserved region. Since issue #667 (DR-0043) the reserve sits in a **top-right notch** of the analog core and the analog ring is L-shaped around it (`geo.draw_notched_guard_ring`); block bbox 151,827 → 128,765 µm² (measured, `economy/records/20261101-063000-f44f1140.md`). Area figures further down that quote 599.35 × 253.32 µm / 151,827 µm² describe the earlier band placement |
| §3 dedicated analog supply routing | implemented | `vdd`/`vss`/`vref`/`vcm` are analog-domain trunks strapped between the two decode banks and the comparator; the digital region carries its own, separate, unlabelled rails |
| §2.4/§3 the SAR-logic sequencer itself | **placed and routed, as a separate macro** | DR-0010 keeps the sequencer and output register at rung 1 as the executable specification. A gate-level netlist exists (DR-0023 adopted the PDK's thick-oxide `gf180mcu_fd_sc_mcu7t5v0`/`mcu9t5v0` standard cells at the block's 3.3 V digital rail — their netlists bind `nfet_05v0`/`pfet_05v0` under the pinned open_pdks `f6eeac7`, subcircuit wrappers on the `*fet_06v0` model cards DR-0023 cited by name, re-counted in [DR-0044](../../spec/decision-records/DR-0044-standard-cell-device-under-f6eeac7.md); issue #272 synthesized `design/sar-logic/rtl/sar_ctrl.v` against both and chose `mcu7t5v0` — `design/sar-logic/rtl/README.md`) and, as of issue #274 (DR-0023 follow-on (b), `klt place-and-route`), it is placed, routed and DRC-clean at `layout/adc-top/sar_ctrl/sar_ctrl.gds` — see "Area, as drawn" below for the fit evidence against the reserved footprint. It is a standalone macro artifact, not yet merged into `adc_top.gds`/`adc_block.gds`'s own top cell (hard-macro composition is out of this issue's scope). **Timing** (DR-0023 follow-on (c), issue #275): the `mcu7t5v0` netlist meets DR-0003's 62.5 ns bit-cycle budget with wide margin at every corner in DR-0023's ratified 3.3 V corner grid plus the two supplementary corners the library ships. An initial **PRE-ROUTE** result (`klt place-and-route --target_stage place`, worst-corner setup slack +56.21 ns at `ss_125C_3v00`, 90% of the period) has since been superseded by a **post-route** result: real `klt sta` (`design/sar-logic/flow/sta_sar_ctrl_postroute.py`) against #274/#279's routed, DRC-clean DEF (`layout/adc-top/sar_ctrl/sar_ctrl.def`) also **PASSes** at every corner — worst-corner setup slack +56.37 ns at `ss_125C_3v00` (90% of the period), worst-corner hold slack +0.65 ns at `ff_n40C_3v60`. See `design/sar-logic/flow/sar_ctrl/records/20260915-093934-7ab8971.mcu7t5v0.sta_postroute.md` (signoff-relevant going forward, disclosed limitations included) and the earlier `design/sar-logic/flow/sar_ctrl/records/20260914-235615-7022eab.mcu7t5v0.sta.md` (pre-route, kept for history). The post-route run still times from OpenSTA's own DEF/LEF-geometry RC estimate, not routing-extracted parasitics — a **SPEF-annotated** signoff number (`klt extract --parasitics`, not yet run) is still owed |

### Deviation: single-finger devices, not multi-finger / split matched pairs

Every MOSFET is drawn as **one** gate stripe at its full drawn `W`. A real
tapeout of a 80 µm PMOS would fold it into fingers, and a real matched pair
would be split and interleaved. Both are impossible to *verify* here, and
this repo's standard is that an unverifiable claim is not made:

* `design/adc-top/adc_top.spice` models each switch leg as one lumped SPICE
  device at its full `W` — that is the literal LVS target;
* the pinned `klt`'s LVS engine (`klayout_tools/lvs.py`, wrapping
  `klayout.db.NetlistComparer`) never calls `Netlist.combine_devices()` on
  either side, so a folded or interleaved device extracts as N parallel
  MOSFETs and is reported as `device.unmatched` against that one lumped
  device. Read out of the installed `klt`, not assumed.

Consequences, stated rather than hidden:

* **DR-0013's finger-count dummy** ("7 of the main device's 16 fingers, so
  the ratio survives process bias on the drawn width") is not literally
  drawn on `adc_tgate_dum` (kept standalone-drawable and LVS-matched, but no
  longer in `adc_top`/`adc_block`'s composition — DR-0014). The ratio is
  drawn as a width instead — which is exactly the construction DR-0013
  rejected. What *is* honoured is the placement half of the requirement:
  symmetric, immediately-adjacent dummies. Moot for the switch actually IN
  the composition now, `adc_tp_sw`: it is deliberately not dummy-compensated
  at all (see the matching-plan table above).
* **§2.1's common-centroid input pair** is drawn as a mirror-symmetric
  adjacent pair (`Xmb Xmip Xmin Xmt`, identically oriented, in one row),
  which cancels a gradient *between* the pair's local environments but not
  the first-order gradient across each device — that needs splitting. The
  **load resistors**, which the extraction deck cannot see as devices at
  all, ARE split and placed genuinely common-centroid (A-B-B-A).

Filed generically upstream as
[klayout-tools#261](https://github.com/2AMLogic/klayout-tools/issues/261),
now **closed**: klt's LVS has an opt-in `options.combine_devices` (off in every
committed `*.lvs.json`; the unchanged single-finger layout still matches with
it on — `economy/records/20261030-223000-be1c350.md`). The text above describes
the pin this section was written against.

### Deviation: contacts as bars, not discrete squares

The real DRM (`CO.1`) fixes contacts at 0.22 × 0.22 µm in an array. This
deck's `contact.width.1` enforces only the minimum-width half of that rule
(`decks/gf180mcu.py`'s own docstring says so), so one wide contact bar per
source/drain is legal *here* and is not legal on a real mask deck. A
deliberate use of an already-documented curated-deck approximation, taken to
keep the geometry tractable at 323 transistors.

### The MiM stack, and what issue #70 changed

The unit capacitor used to be drawn with `cw`/`cl` taken as the **Metal4**
size and FuseTop derived by insetting it (capped at 0.3 µm). That is
backwards, and it was wrong twice over:

* `cw`/`cl` are the PDK subcircuit's own `c_width`/`c_length`, i.e. the
  **FuseTop plate** — the thing whose area sets the capacitance. Insetting
  it drew a 2.114 µm plate where the then-ratified device was 2.7136 µm, i.e.
  a 10.9 fF unit where `C_u` was 17.24 fF (the ratified plate is now 4.0 µm /
  35.6528 fF — DR-0019, issue #196 — but the defect and its fix predate that
  resize and are stated here at the sizes they happened at);
* the inset could not reach `MIMTM.3`'s 0.6 µm Metal4-over-FuseTop overlap
  at any size, because it was capped at 0.3 µm. Every one of the 1224 drawn
  stacks per block was illegal — invisibly, because the deck had no rule on
  those layers at the old pin.

`geometry.draw_mim_cap` now takes the **plate** and derives everything else
from the DRM:

| Drawn | Size | Rule |
|---|---|---|
| FuseTop (the device) | `cw` × `cl` = 4.0 µm | ratified `C_u`, `spec/cdac-sizing-memo.md` §4 / [DR-0019](../../spec/decision-records/DR-0019-cdac-unit-cap-resize-for-gain-error-margin.md) |
| Metal4 (bottom plate) | plate + 0.6 µm each side | `MIMTM.3` = `mim.enclosing.fusetop.1` |
| tiling pitch | plate + 2 × 0.6 + 1.2 = **6.4 µm** | + `MIMTM.1` = `mim.space.1` |
| Via4 + Metal5 pad (device mode only) | 0.26 µm, ≥ 0.4 µm inside Metal4 | `MIMTM.2` = `mim.enclosing.via4.1` |

All three MiM rules, plus Metal2/Metal3/Metal5 width and space, are checked
by the pinned deck. `adc_cdac_cell`, `adc_top` and `adc_block` report
**clean** against them — the first time a clean report over this block's
capacitor geometry has meant anything at all.

**The area cost is real and is the DRM's, not this layout's**: 6.4 µm is
the tightest a 4.0 µm MiM unit can legally be tiled on gf180mcu (it was
5.1136 µm at the pre-DR-0019 2.7136 µm plate). See
"Area, as drawn" — the block no longer fits DR-0006's row, and that is
recorded rather than dialled away.

### The CDAC plate interconnect, as drawn (issues #85 + #86)

Landed in two parts under issue #81, and now complete. Every one of the
1024 real unit positions is a **recognised** MiM device
(`CAP_MK`/`MIM_L_MK` + Via4) with **both** plates wired to the net
`design/adc-top/adc_top.spice` names, so `klt extract` reports 1024
`cap_mim_2f0_m4m5_noshield` devices in each block and `klt lvs` matches them.
The 200 dummy-ring tiles per block stay unmarked and inert — same drawn MiM
stack, no markers, no Via4, no riser — which is what makes them edge-matching
geometry rather than 200 extracted devices on floating nets.

**Part 1 (#85), inside each `ADC_CDAC_ARRAY_{P,N}` cell:** one full-width
Metal1 "row trunk" per (row, weight-present-in-that-row), placed just below
the row and marching downward by `TRUNK_PITCH`; one Via3/Via2/Via1 riser per
real unit (`geometry.draw_mim_bottom_riser`) onto its own trunk; and one
vertical Metal2 "spine" per weight in a dedicated inter-column gap, landing a
Via1 on every row's trunk so the per-row segments merge into one array-wide
net.

**Part 2 (#86), at the block level (`_route_cdac_plates`):** each spine now
runs on down to the array cell's own bottom edge (`SPINE_EXIT_Y`), so all ten
present themselves at one known Y, and twenty-two top-level routes join them
to the rest of the block —

* nine per side: spine → that side's decode-bank trunk for the same internal
  node its four T-gates share (`XS<P|N>.X<w>.bp`);
* one per side: the terminating unit's spine → the shared `vcm` rail
  (DR-0011's 512th position, fixed to `V_cm` and never switched);
* one per side: the Metal5 top-plate mesh → `topp`/`topn`, the nets the
  top-plate `V_cm` switches already drive. Without this the 512 caps of a side
  sat on a *floating* 512-device net, which the extraction showed plainly.

**Why this is a Metal2/Metal3 route and not this file's usual Metal1/Poly2.**
Every other top-level tie here (`geometry.stitch`, the `vdd`/`vss`/`vcm`
bridge) is a Metal1 trunk plus a Poly2 strap, because when they were drawn the
extraction deck exposed one metal level. That constraint is gone at the pinned
commit, and `draw_mim_bottom_riser` already relies on its replacement: **Metal2
carries no connectivity to Metal1 except through a Via1**, so a Metal2 route
may run straight over a decode bank's whole device row and over every trunk in
its channel and touch only the one trunk it drops a via onto.

That matters because the two-layer model made this a genuinely hard floorplan
problem: side P's array sits at the **top** of the block while side P's decode
bank sits at the **bottom**, with side N's full-width transistor row physically
in between, so no Metal1 path exists at all. On Metal2 it is an ordinary
channel route. Each net is one "Z" — a vertical Metal2 drop at the spine's own
X, a horizontal Metal3 lane at a Y unique to that net, and a vertical Metal2
rise/drop at a landing X inside the target trunk, ending in one Via1. Lanes are
Metal3 and verticals are Metal2, so a vertical crossing a foreign lane carries
no connectivity, and correctness reduces to two independent *checked*
conditions: every lane has its own Y, and every vertical has its own X
(`_pick_column` searches for one and raises if it cannot find one — the same
search-and-assert discipline `_clear_offset` and the `bridge_y0` loop use, one
metal level down, for the same reason: a same-layer touch between two
differently-named nets is an LVS merge, not a DRC violation).

**It costs no area.** The band between the decode banks and the arrays carries
no Metal2 or Metal3 whatsoever, so the twenty-two lanes are drawn into space
the block already occupies; the spines' extension runs down an inter-column gap
they already sit in, inside the dummy ring's own bounding box. `adc_top` and
`adc_block` measure 0.10585 mm² and 0.12100 mm² — byte-identical dimensions to
issue #70's draw. Nothing in this change moves the DR-0017 overrun in either
direction.

The same construction was already proven end to end at the leaf before it was
replicated: `adc_cdac_cell` draws one unit cap with both plates wired — Via4 up
to a Metal5 `top` pin, Via3/Via2/Via1 down onto the `bp` trunk — and
`klt extract` reports a `cap_mim_2f0_m4m5_noshield` between exactly those two
nets (issue #70).

**One thing the reference had to get right**, because it is easy to get wrong:
`adc_cdac_side` models each weight as **one lumped capacitor of the whole
weight's area** (its own comment says why — 1022 unit cells would multiply
simulation cost and change no number), while the layout draws `m` **unit-size**
caps in parallel. Same capacitance, different device list. So
`gen_adc_top.py` constructs 1024 fresh unit-size `nl.Device(kind="cap", …)`
objects — one per real drawn position, at `topp`/`topn` and its weight's `bp`
net — rather than reusing the flattened schematic's nine-per-side lumped
devices, and passes those to `netlist.write_reference(..., include_caps=True)`.

### Capacitance: what the extractor says, and why it used to differ

`klt extract` reports **35.6528 fF** for the drawn 4.0 µm unit plate
(`cells/adc_cdac_cell.spice`, `C$17 bp top 3.56528e-14`). The PDK model card
(`cap_mim_2f0fF` in `sm141064.ngspice`, and
`sim/device-characterization-report.md` §1.2, which reproduces it to four
significant figures against measurement) gives the same number for the same
geometry:

```
model card:  C = 1.99 fF/µm² · W·L + 0.2383 fF/µm · 2(W+L)
             = 31.840 + 3.813 = 35.6528 fF
deck:        C = 1.99 fF/µm² · W·L + 0.2383 fF/µm · 2(W+L)
             = 35.6528 fF                      (0.0 %)
```

**This section used to record a −14.6 % gap, and that gap is now closed.**
The extraction deck's MiM model originally carried an area term only
(`C = 2.0 fF/µm² · W·L`, 14.7316 fF at the old 2.7136 µm plate against the
card's 17.245 fF), so the whole difference was the missing **perimeter/fringe
term** — proportionally worse the smaller the plate, which put a unit
capacitor close to the worst case. That was filed generically upstream and
fixed: the pinned deck has both terms (`lib/netlist.py` mirrors it as
`DECK_MIM_AREA_CAP_F_UM2` + `DECK_MIM_PERIM_CAP_F_UM`), and the two models
now agree exactly. The closure is recorded here rather than the gap.

**The decision this section records still stands**, and is what made the
closure possible without touching silicon: the layout draws the plate at the
ratified size (now 4.0 µm, [DR-0019](../../spec/decision-records/DR-0019-cdac-unit-cap-resize-for-gain-error-margin.md);
2.7136 µm before it) and any delta is *reported*. The alternative — growing
the plate so the extractor's number lands on the ratified `C_u` — would have
changed the physical device to compensate for a missing term in a tool's
model, i.e. made the drawn capacitor no longer the capacitor `design/` and
`sim/` simulate. Nothing in `spec/` moves either: `C_u` at the ratified plate
is untouched, because the drawn geometry *is* that device. The LVS reference
states the deck's number so `klt lvs` checks what it can actually check — the
capacitor's connectivity and its drawn plate geometry — instead of failing on
a modelling difference no layout change could close.

Filed generically upstream:
[klayout-tools#512](https://github.com/2AMLogic/klayout-tools/issues/512).

### Caveat: the two single-unit groups are on-centre only *combined*

`centroid_tiling` puts every **even**-count weight group on the array centre
exactly, because each such group owns whole centro-symmetric position pairs
— no first-order gradient term can survive. The two **odd**-count groups
(the weight-1 bit and DR-0011's terminating unit, one unit each) cannot own
a whole pair, so they share one: their *combined* centroid is exact, and
that is the only guarantee.

The pair they share is dealt like any other, so it is **not** the
centre-most pair. As drawn, it is `(30, 7)` / `(1, 8)` in the 32 × 16 array
— each of the two units sits (14.5, 0.5) pitches, ≈ (56.8, 2.0) µm, off
centre in opposite directions. The resulting error is a
`displacement × gradient × C_u` term against a **one**-unit weight, i.e. the
two smallest and least DNL-consequential positions in the array, which is
why the deal is left alone rather than special-cased. It is recorded here,
and pinned by
[`sim/tests/test_layout_centroid_tiling.py`](../../sim/tests/test_layout_centroid_tiling.py),
so it cannot change — in either direction — without a test saying so.

*(This corrects a `centroid_tiling` docstring that claimed the two odd
groups were each displaced by "half a pitch", found in review of PR #62; the
placement is unchanged, only the claim about it.)*

## What is and is not verified

**Verified, by a committed record:**

* every Comp / Poly2 / Contact / Metal1 / Nwell width, space and enclosure
  rule in the pinned deck, over all nine cells (`klt drc`, clean);
* **the MiM capacitor stack's geometry** — `MIMTM.1` (bottom-plate spacing,
  1.2 µm), `MIMTM.2` (bottom-plate overlap of Via4, 0.4 µm) and `MIMTM.3`
  (bottom-plate overlap of the top plate, 0.6 µm), plus Metal2/Metal3/Metal5
  width and space, over all 1224 unit-capacitor footprints per block
  (`klt drc`, clean, issue #70). This row was in the "not claimable" list
  below until the pin bump, and the geometry failed `MIMTM.3` 4896 times
  when the rule first ran against it;
* the full transistor-level connectivity and every `W`/`L` of all 296
  devices `design/adc-top/adc_top.spice` defines, and of the comparator's 27
  (`klt lvs`, match);
* **one MiM capacitor as a device**, end to end: `adc_cdac_cell`'s unit cap
  extracts as a `cap_mim_2f0_m4m5_noshield` between `top` and `bp` and
  `klt lvs` matches it against `design/`. Its extracted capacitance is
  35.6528 fF for the drawn 4.0 µm plate, which now agrees exactly with the
  model card — see "Capacitance" above for the fringe-term gap this used to
  carry, and why the plate was never resized to close it;
* **the CDAC array's capacitors, as devices** (issues #85 + #86). Both blocks
  extract **1024** `cap_mim_2f0_m4m5_noshield` devices — 512 real unit
  positions per side, 511 weighted plus DR-0011's terminating unit — and
  `klt lvs` matches every one of them against a reference generated from the
  drawn unit list. Each side's 512 top plates land on one `topp`/`topn` net
  (degree 514 with the top-plate switch's own two transistors); each weight's
  units land on that weight's own decode-bank node `XS<P|N>.X<w>.bp`; each
  side's terminating unit lands on `vcm`. The extracted net count falls from
  199 to 177 in `adc_top` — the twenty-two nets that were floating after #85
  are exactly the twenty-two this routing joined, which is a stronger check
  than the device count alone (a mis-routed spine would leave a stray net, not
  a missing device);
* the CDAC tiling's own matching claim — every even-count weight group's
  centroid is the array centre exactly, the two single-unit groups' combined
  centroid is the array centre exactly, and their individual offset is the
  one stated in the caveat above (`sim/tests/test_layout_centroid_tiling.py`,
  exact rational arithmetic, no PDK and no KLayout needed). DRC and LVS are
  both blind to *which* unit position belongs to which weight, so without
  this test nothing checks the tiling at all.

**Not verified, and not claimable:**

* **array capacitance to the model card's accuracy.** The array's *topology*
  is now verified (512 units per side on the right nets, above), and with it
  the extracted per-side total — 512 × 14.7316 fF = 7.543 pF. That is not
  512 · `C_u` = 8.827 pF, and the whole difference is the deck's missing
  fringe term, not the drawn geometry: the plate is the ratified 2.7136 µm and
  the unit count is the census in `area.json`. See "Capacitance" below, and
  [klayout-tools#512](https://github.com/2AMLogic/klayout-tools/issues/512).
  Nothing here re-measures the array against the model card; that is `sim/`'s
  claim, not `layout/`'s.
* **capacitance to the model card's accuracy.** Even where a capacitor
  *is* extracted, the deck's MiM model is area-only and reads 14.6 % low on
  a unit-sized plate — see "Capacitance" above and
  [klayout-tools#512](https://github.com/2AMLogic/klayout-tools/issues/512).
* **resistance.** The pinned deck now *has* a `ppolyf_u` resistor device
  class, but it recognises a resistor by its `RES_MK`/`SAB`/`Pplus`
  markers, none of which this layout draws — so the comparator's two 150 kΩ
  poly bodies still extract as plain Poly2 conductors, and `klt extract`
  now says so out loud (the "unmodelled poly" warning both block cells
  carry, pinned by shape count in `layout/lvs/cells/cells.json`). `klt drc`
  checks their drawn width/space/enclosure; nothing checks that they are
  150 kΩ. Marking them is the resistor analogue of what #70 did for the
  MiM cap and is not done here.
* **parasitics.** Out of scope by construction — that is #17, which the
  pin bump in this change unblocks (`klt extract --parasitics` exists at
  the pinned commit and runs on these cells).

## Resistors, and why there are two comparator cells

**Issue #118.** The comparator's two 150 kohm p+ poly load resistors are
drawn WITH `SAB` (49/0) + `RES_MK` (110/5) + `Resistor` (62/0) markers
(`lib/place.draw_poly_resistor`), so `klt extract`'s gf180mcu deck recognises
each body as a real device (`klayout-tools#222`/`#299`) instead of an
ordinary Poly2 conductor. `pop`/`pon` stay distinct nets in the full
`comparator` cell too, and both resistors are genuinely LVS-checked, not
just DRC-checked geometry.

**What is NOT reachable: the schematic's original `ppolyf_u_2k` (2000
ohm/sq) assumption.** At this repo's pinned `klt` commit, the PDK's
`_1k`/`_2k`/`_3k` high-sheet-rho poly flavours all key off the SAME drawn
marker geometry (`SAB`+`RES_MK`+`Resistor`), selected only by a build-time
deck option (`POLY_RES`) this curated deck does not implement — so a drawn
resistor can only ever extract as `ppolyf_u_1k` (1000 ohm/sq, the PDK's own
default) here, never `_2k`/`_3k`, regardless of how the markers are drawn.
Tracked upstream, open: [klayout-tools#595](https://github.com/2AMLogic/klayout-tools/issues/595)
("no way to select WHICH shared-geometry sheet-rho flavour a resistor
family extracts as"). `design/comparator/comparator.spice` is sized for
`ppolyf_u_1k` (`r_width=1u r_length=150u`, `150 * 1000 ohm/sq = 150 kohm`),
not for the schematic's original `_2k` assumption at half the length.

**Why each resistor is now ONE straight body, not two series segments.**
Before issue #118, each 150 kohm resistor was split into two series
segments placed A-B-B-A for a common-centroid layout — free to do while the
resistors were unmodelled shorts, since the LVS reference could apply
whatever net merge the split needed. Now that each resistor is a real,
class-and-value-identical device, a two-segment split extracts as two
75 kohm devices in series against the schematic's one lumped 150 kohm
device — a genuine device-count mismatch. So each resistor is drawn as one
single body: a **stated deviation** from the matching plan's common-centroid
recommendation for the resistors specifically (not the transistors, see
"What the matching plan asked for" below), at the benefit of a genuinely
LVS-verified resistance and topology. At issue #118 that single body was a
150 µm **straight run**, and it grew the comparator cell's footprint
(99.3 x 158.5 um / 15 739 um^2, was 99.3 x ~93 um pre-#118 — `adc_block`
moved 0.121 mm^2 -> 0.154 mm^2, +27%). Issue #215 folded it; see the next
section.

**Why the body is now FOLDED, and why that is not the split (issue #215).**
Each body is drawn as a serpentine of four vertical legs joined alternately
at the top and the bottom (`lib/place.draw_poly_resistor`,
`gen_comparator.RESISTOR_LEGS`). That is a **shape** change, not a series
split: the merged serpentine is ONE connected polygon, so `klt extract`
still recognises exactly one `ppolyf_u_1k` device per resistor, and the
device-count mismatch #118 exists to prevent is not reintroduced. The
generator asserts both properties before it inserts the shapes — one polygon,
and a merged drawn area exactly `r_width * r_length`.

*Why the area identity is what is asserted.* This deck's
`DeviceExtractorResistorWithBulk` derives resistance from the marked
region's **area over the port width**, not from a centre-line length —
measured directly: a two-leg fold of a nominal 150 µm x 1 µm body at a
600 nm leg gap extracts as `150600` Ω, i.e. exactly
`sheet_rho * drawn_area / port_width`, the 600 nm of extra corner metal
included. The leg length is therefore solved from that model
(`legs * leg_len + (legs - 1) * leg_gap = r_length`), so both bodies still
extract at exactly `150000` Ω and LVS compares clean on the device VALUE,
not merely its presence.

*What the area model does not capture, stated rather than compensated.* A
right-angle corner carries roughly 0.56 of a square, not the full square its
area contributes, so the **physical** resistance of a folded body is about
0.44 squares per corner under the extracted number — ~1.8 % at four legs
(6 corners of 150 squares). That error is common-mode across the two
identically drawn loads, so the preamp's differential balance is untouched;
it moves the pair's absolute value, which the design already treats as a
process-spread quantity (poly sheet-rho spread is tens of percent).
Compensating for it would mean drawing MORE area than the schematic
declares, which would put the extracted value at odds with the reference —
trading a checked property for an unchecked one. Recorded here instead.

*Why four legs and not two.* Both were built and measured, and re-measured
after the strap corridors moved (below), so the trade is quoted at the
shipped geometry: `legs=2` gives a slightly smaller BLOCK bbox
(148,928 vs. 150,536 µm², −1.07 %) but leaves the body 75.2 µm tall, so the
cell is still resistor-bound and its local utilization is 0.175 — still
under the 0.25 "matched pairs" red-flag floor the economy review measured
this cell against. At `legs=4` the body stands 37.75 µm above the row
baseline, under the 40 µm the preamp's own `w=40u` input pair already
occupies, so the resistor stops setting the cell's height at all:
`COMPARATOR` is 112.63 x 47.05 µm at 0.291 local utilization.
`gen_comparator.RESISTOR_LEGS`' own comment carries the full table so #198
can weigh the 1.07 % against it directly.

*One more constant went away with it.* The comparator's right-hand escape
margin — the reach its `vdd`/`vss` trunks must have to clear the resistor
columns before the channel is packed — was a hand-tuned 18 µm at
`gen_adc_top.py`'s call site, with ~10 µm of unexplained slack over the
columns it was sized for. `gen_comparator.build_into` now derives that floor
from the columns' own span (`place.resistor_column_width`), so a change to
the fold count or to the schematic's resistor sizing moves it instead of
silently outgrowing it.

**Why `pop`/`pon` carry a Metal1 label even though they are not
hierarchical ports.** Empirically, `klt lvs`'s `NetlistComparer` cannot
always deterministically resolve which of `pop`/`pon` is which once both
resistors are present as real, class-and-value-identical devices hanging
off the same `vdd` hub: without a label, the full `comparator` case reports
9 mismatches (`device.unmatched`, `net.merged`, `topology`) even though the
drawn connectivity is correct (confirmed: an isolated
differential-pair-plus-resistor-load reproduction compares clean; only the
full circuit's much larger `vdd` fan-out trips it). A Metal1 label gives
both sides the same net NAME, so the comparer's name-based matching
resolves the pair directly — a standard LVS disambiguation technique, not a
hack. The cost is two extra declared pins on `COMPARATOR` (9 -> 11) and
`ADC_BLOCK` (69 -> 71); see `gen_comparator.draw_load_resistors`'s
docstring.

`comparator_nores` (identical placement and routing, resistor bodies not
drawn) predates this fix — it originally existed to give LVS a case where
`pop`/`pon` could not collapse onto `vdd` through an unmodelled resistor
short. It is KEPT here as an independent standalone check of the
preamp-to-latch connectivity in isolation from the resistor devices, not
because the full `comparator` case still needs it to keep `pop`/`pon`
distinct (it does not, as of issue #118).

## The routing model, in one paragraph

When this block was drawn, `klt extract`'s gf180mcu deck declared **one**
metal level and no vias, so the only interconnect LVS could see was Metal1
plus Poly2 (joined only through Contact). Every net therefore had to close
in a two-layer planar graph. *(That constraint has since lifted — the pinned
deck carries Metal1–Metal5 and Via1–Via4, klayout-tools#220/#238 — and the
MiM stack's plate wiring uses the upper levels. The transistor-level routing
below is deliberately left as drawn: it is DRC-clean and LVS-matched, and
re-routing 323 devices onto a five-level stack is its own piece of work with
its own evidence to produce, not a free side-effect of a toolchain bump.)*
The
construction: devices in one row with their gate heads down; one horizontal
Metal1 "trunk" per net in a channel below, **left-edge packed** so nets whose
spans do not overlap share a track; every terminal drops to its trunk on a
vertical Poly2 riser that passes under every foreign trunk without
connecting to it. Top-level straps between separately-placed blocks use the
same discipline (`geometry.stitch`), with the corridor asserted free of Comp
(a Poly2 strap over diffusion is a parasitic MOSFET) and free of Poly2 (it
would short to whatever riser is already there). **The three block-level
`vdd`/`vss` straps are the exception since issue #378**
(`geometry.stitch_metal2`,
[DR-0037](../../spec/decision-records/DR-0037-block-level-supply-straps-on-metal2.md)):
they run on Metal2 with one Via1 per trunk, because poly at 7.3 Ω/sq made
the block's droop verdict depend on which labelled site a parent landed the
supply at. Metal2 needs no Comp/Poly2 clearance — it carries no
connectivity downward without a drawn via — so that variant asserts
`metal2.space.1` clearance against existing Metal2/Via1 instead. This is the single biggest
shape driver in the directory and it is a tool limitation, not a design
choice — already tracked upstream as
[klayout-tools#220](https://github.com/2AMLogic/klayout-tools/issues/220),
independently re-encountered here. That fix is now IN this repo's pinned
commit, so the constraint no longer binds; what still holds this shape is
that nothing has re-drawn it yet.

Three real defects this bring-up hit and the assertions that now catch them,
recorded because each one produced a *DRC-clean* layout that was
electrically wrong:

1. per-net Metal1 buses with Metal1 stubs merged four nets into one
   (`klt extract` reported the net as `"clk,clkb,vin,vout"`) — fixed by the
   Poly2-riser scheme, which cannot express that failure;
2. a trunk extension requested *after* the channel was packed silently drew
   nothing, leaving two `vdd` pins and two `vss` pins in the extracted block
   — now `Channel.extend()` is declared before packing and
   `Channel.drop()` after `finish()` is a hard error;
3. a top-level strap grown along its own track shorted to the net sitting
   next along it (`cmpclk,ibias,topn`) — now `Channel.extend_drawn()`
   refuses to grow a trunk past a track-mate, and `geometry.stitch()`
   refuses to place a contact outside the trunk it is meant to land on.

## Area, as drawn

Supersedes [`../floorplan-matching-plan.md`](../floorplan-matching-plan.md)
§4's planning tally, per that section's own instruction ("should be
superseded … rather than edited in place") — it is left untouched. Numbers
below are bounding boxes from `area.json`, written by the generator, as of
the MiM-stack correction (issue #70).

| Region | As drawn (issue #118) | Previous (#116/#91, pre-#118) | §4.2's estimate |
|---|---|---|---|
| CDAC array, per side (512 units + dummy ring + top-plate mesh) | 15,688 µm² (172.7 × 90.9 µm) | 15,688 µm² | — |
| CDAC arrays, both sides | **31,376 µm²** | 31,376 µm² | 12,000–16,000 µm² (§4.2 subtotal) |
| CDAC decode bank, per side (144 devices — DR-0014's fourth leg, 9 × 16) | 15,787 µm² | 15,787 µm² | (inside the §4.2 subtotal) |
| CDAC decode banks, both sides | **31,575 µm²** | 31,575 µm² | — |
| Top-plate `V_cm` switches, both sides (8 devices, DR-0014's `adc_tp_sw`) | **889 µm²** | 889 µm² | 800–1,500 µm² |
| Comparator (27 devices + 2 resistors) | **19,272 µm²** (99.3 × 158.5 µm) | 12,100 µm² (99.3 × ~93 µm) | 1,500–3,000 µm² |
| Analog core incl. guard ring | **121,752 µm²** | 88,387 µm² | — |
| SAR-logic reserved region incl. its ring | **7,624 µm²** | 7,624 µm² | 1,000–5,000 µm² |
| **Block total (`adc_block`, 527.4 × 292.9 µm)** | **154,458 µm² = 0.15446 mm²** | 121,005 µm² = 0.12100 mm² | ~0.02–0.03 mm² |
| `adc_top` alone (no comparator), 461.4 × 229.4 µm | 105,853 µm² = 0.10585 mm² | 105,853 µm² = 0.10585 mm² | — |

> The decode bank and comparator rows are cell bounding boxes measured
> *after* the block-level rail stitch has been drawn into them, so they
> track the position of the far stitch column, not the number of devices in
> the cell. The banks did not grow — the same 144 devices sit at the same
> pitch; their rail trunks now reach further right (see below). Stated
> because the raw number invites the opposite reading.

**Issue #118 grows the comparator, and therefore `adc_block`, again.**
Making the load resistors real, individually-recognised devices retired the
two-series-segment common-centroid split (see "Resistors, and why there are
two comparator cells" above): each 150 kohm resistor is now one single
straight `ppolyf_u_1k` body at `r_length=150u` (was two 37.5 µm segments at
`ppolyf_u_2k`'s `r_length=75u`, halved). The comparator cell's height alone
carries that: 99.3 × ~93 µm -> 99.3 × 158.5 µm, +65.5 µm, +14,272 µm² for
the cell; `adc_block`'s own height moves 229.4 -> 292.9 µm (the same +63.5
µm, propagated through the block-level rail stitch), and its total area
moves **0.12100 mm² -> 0.15446 mm² (+27.6%, +33,453 µm²)**. This is a real,
stated cost of the fix, not an oversight: keeping the split would have
extracted as two 75 kohm devices in series against the schematic's one
lumped 150 kohm device -- a genuine LVS device-count mismatch, not a
cosmetic one (see "Resistors" above for the full reasoning). A denser
single-body layout (e.g. folding the 150 µm run, or narrowing `r_width`
instead of doubling `r_length`) was not pursued in this increment; it is a
candidate for a follow-up if the area cost below is not acceptable.
**That follow-up landed — issue #215 took the "folding" option; see the
issue #215 update at the end of this section.**

**Against the ratified `< 0.1 mm²` row (DR-0006): 0.15446 mm², i.e. 154 % of
budget — OVER it, by 54,458 µm², and now also OVER the `< 0.13 mm²` bound
[`DR-0017`](../../spec/decision-records/DR-0017-adc-top-area-budget-overrun.md)
proposed (still status **proposed**, not ratified) for the PRE-#118 overrun.**
DR-0006's own row is left exactly as ratified — an agent does not edit a
ratified spec row to make a result pass, and this increment does not bump
DR-0017's proposed number either, since DR-0017 is itself not yet ratified
and doing so would compound one unratified proposal on top of another. The
recovery pass the ORIGINAL overrun asked for (issue #80) was done and came
up empty: see "Why recovery to `< 0.1 mm²` is infeasible" below -- issue
#118's growth is layered on top of that already-negative result, not a new
attempt at recovery. **This is routed to the operator alongside DR-0017**:
the ratified target revision DR-0017 asks for needs to account for this
new number (0.15446 mm², not 0.12100 mm²) before it is ratified, or a
follow-up issue needs to fund a denser resistor layout first. Nothing
downstream may quote 0.09619 mm² OR 0.12100 mm² as this design's area any
more.

**Update (issue #196, DR-0019 unit-cap resize): the as-drawn block area is
now `0.18045 mm²`** (`area.json`; `adc_top` alone is `0.12424 mm²`). The CDAC
unit plate moved 2.7136 µm → 4.0 µm and its legal tiling pitch with it
(5.1136 µm → 6.4 µm), so the two arrays grow 31,376 → 49,339 µm² and the
decode banks and reserved SAR-logic region grow with the taller array they
pitch against. This is the physically-built consequence of a ratified sizing
decision, recorded here as-measured. **It is deliberately NOT reconciled
against DR-0006's ratified `< 0.1 mm²` row or DR-0017's proposed `< 0.13 mm²`
bound in this increment** — that reconciliation is issue #198, and DR-0019
already anticipated it ("surfaced, not absorbed"). Nothing downstream may
quote 0.15446 mm² as this design's area any more either.

**Update (issue #215, load-resistor fold): the as-drawn block area is now
`0.15365 mm²`** (`area.json`, `block_total: 153652.359`; `adc_top` alone is
unchanged at `0.12424 mm²` — its GDS is byte-identical, the comparator is
not in it). Each 150 kΩ load-resistor body is drawn as a four-leg
serpentine instead of a 150 µm straight run (see "Resistors, and why there
are two comparator cells" above), which takes `COMPARATOR` from
121.63 × 158.45 µm (19,272 µm²) to 116.93 × 47.05 µm (5,502 µm²) and, with
it, the block's own comparator-bound top and right edges: 616.13 × 292.87 µm
→ 611.43 × 251.30 µm, i.e. **180,446 → 153,652 µm² (−26,794 µm², −14.85 %)**
at utilization 0.3516 → 0.4094. Nothing else moved: the CDAC arrays'
`cdac_array_per_side` and the top-plate switches' `tp_switches` rows of
`area.json` are unchanged to the digit, the ratified `C_u` (DR-0019) and the
decode banks' `comp.space.1`-floored pitch (#67/#69) are untouched, and both
resistors still extract as one `ppolyf_u_1k` device each at exactly
150 000 Ω. **This is still deliberately NOT reconciled against DR-0006's
ratified `< 0.1 mm²` row or DR-0017's proposed `< 0.13 mm²` bound** — that
reconciliation is issue #198, to which this recovery is an input. Nothing
downstream may quote 0.18045 mm² as this design's area any more either.

**Update (issue #215, strap-corridor re-derivation): the as-drawn block area
is now `0.15054 mm²`** (`area.json`, `block_total: 150536.239`; `adc_top`
alone is now `0.12319 mm²`). This is R1, the right-side dead corridor, and
it took the issue's second candidate: re-derive the block's right-edge
computation so the reached span matches the routing that actually needs it.
Two corridors were derived from `top.bbox().right` and therefore chased
whatever happened to be furthest right when they ran —

* the top-plate switch cell's `vdd`/`vss`/`vcm` bridge dropped into the
  **decode banks** at `max(bank_w, top.bbox().right) + 6 µm` = 595.73 µm,
  i.e. 152 µm past the banks it exists to reach. It now lands one column
  pitch past the banks' own cross-bank stitch corridor (443.86 µm), the
  nearest X already proven clear of both things `geometry.stitch` asserts;
* the comparator's own `vdd`/`vss` strapped at `top.bbox().right + 2.5 µm`,
  i.e. past the comparator, which is what made a *corridor* — not any drawn
  device — the block's rightmost geometry. It now straps in
  `SWITCH_CMP_GAP` (477.00 / 477.70 µm), the same Comp-free gap
  `topp`/`topn` and the bridge's near end already use.

**616.13 × 292.87 µm → 611.43 × 251.30 → 599.03 × 251.30 µm**, i.e.
**180,446 → 153,652 → 150,536 µm² across the two #215 steps (−29,910 µm²,
−16.57 %)**, at utilization 0.3516 → 0.4094 → **0.4146**. The block's right
edge is now `COMPARATOR`'s own cell edge plus the guard ring, not air. Both
decode banks lose 3,673 µm² of *cell* bbox each (−20 %, utilization
0.449 → 0.552) because their bbox no longer carries a 112 µm rail stub that
existed only to reach the far corridor. Nothing electrical moved: the
extracted netlists are byte-identical, `klt lvs` still matches at 1,349
devices / 198 nets / 71 pins, and `cdac_array_per_side` / `tp_switches` are
unchanged to the digit. **Still deliberately NOT reconciled against
DR-0006's ratified `< 0.1 mm²` row or DR-0017's proposed `< 0.13 mm²`
bound** — that is issue #198. Nothing downstream may quote 0.15365 mm² as
this design's area any more either.

**Update (issue #274, SAR-logic sequencer place-and-route): the "SAR-logic
reserved region incl. its ring" row in the table above (7,624 µm², an
issue #118-era snapshot) is stale.** The same #215 strap-corridor
re-derivation above grows the analog core, and `gen_adc_top.py`'s digital
footprint tracks it — `digital_box`'s own width is
`max(SAR_RESERVED_W, analog_ring.width() // 3)`, and the wider analog ring
now drives that `// 3` term past the nominal `SAR_RESERVED_W` floor. The
currently committed `area.json` (regenerated byte-identical against
`origin/main` at this update's own commit) reports
`areas_um2.sar_logic_reserved` = **8,646.028 µm²** (ring-inclusive), i.e. a
ring-exclusive core box of 199.21 × 40.0 µm = **7,968.4 µm²** — not
7,624 µm². Nothing downstream may quote 7,624 µm² as the reserved
SAR-logic footprint any more; that table cell is left as drawn, per this
file's own "supersede rather than edit in place" convention for the "Area,
as drawn" table.

Issue #274 (DR-0023 follow-on (b)) placed and routed #272's synthesized
`sar_ctrl_a` gate netlist (`gf180mcu_fd_sc_mcu7t5v0`) via
`klt place-and-route` inside an EXPLICIT floorplan sized to exactly match
this current 199.21 × 40.0 µm core box (0 margin either dimension) — see
`design/sar-logic/flow/pnr_sar_ctrl.py` and its own evidence record under
`design/sar-logic/flow/sar_ctrl/records/`. **It fits**: `target_stage:
"route"` completed (`status: "ok"`), `route_drc_violation_count: 0`,
`antenna_violation_count: 0`, `klt drc --deck gf180mcu` clean (0
violations) against the merged, routed GDS at `utilization_pct` 67.72 % of
the reserved core. The routed layout artifacts (merged GDS, DEF, as-built
Verilog) are committed at `layout/adc-top/sar_ctrl/sar_ctrl.{gds,def,v}` —
a **separate** macro alongside `adc_top.gds`/`adc_block.gds`, not merged
into either's own top cell (hard-macro composition into the analog block's
GDS is not this issue's scope). No SDC/STA claim is made (follow-on (c),
issue #275, a separate filed issue) — see that record's own "No SDC/STA
claim" section.

**Silicon-economy evidence (issues #208, #215).** Current record: the
post-corridor re-measure
[`layout/adc-top/economy/records/20260817-185745-40cfeb8.md`](economy/records/20260817-185745-40cfeb8.md)
(raw JSON/renders under the sibling
[`economy/reports/20260817-185745-40cfeb8/`](economy/reports/20260817-185745-40cfeb8/)
directory) — `bbox_area_um2` cross-checked against `area.json`'s
`block_total` (exact match, both `150536.239`), utilization **0.4146**,
inside the review rubric's 0.40–0.65 mixed-signal band. It quantifies issue
#215's R1 step, tabulates the width chain the block now sits 0.8 µm above,
and states plainly which part of the right-column whitespace is a
re-partitioning artefact of `largest_empty_regions` and which left the
layout outright (1,873 µm², measured directly). It issues **no verdict** (it
is a re-measure, not a review).

Intermediate record — the post-fold (R2) re-measure:
[`layout/adc-top/economy/records/20260817-144100-ae0b956.md`](economy/records/20260817-144100-ae0b956.md)
(sibling
[`economy/reports/20260817-144100-ae0b956/`](economy/reports/20260817-144100-ae0b956/)) —
`bbox_area_um2` `153652.359`, utilization 0.4094.

Prior record — the `revise` review that raised R1/R2: `klt economy` +
`economy-review`
[`layout/adc-top/economy/records/20260817-130012-09d8259.md`](economy/records/20260817-130012-09d8259.md)
(sibling
[`economy/reports/20260817-130012-09d8259/`](economy/reports/20260817-130012-09d8259/)) —
`bbox_area_um2` `180445.9931`, utilization 0.3516, verdict **revise**: the
CDAC arrays and decode banks are legitimately spent (DR-0019-driven and
DRC-floor-driven respectively), but the review named a ~23,000 µm²
right-side dead corridor and the comparator's own 8.55%-utilized internal
bbox as recoverable area, filed as follow-up issue #215 and recovered
above. Both records are inputs to #198's ratification decision, not
ratifications themselves.

**Update (issue #198): a reconciliation is proposed, pending operator
ratification.**
[DR-0024](../../spec/decision-records/DR-0024-adc-top-area-budget-reconciliation.md)
proposes revising DR-0006's `Area` row to `< 0.16 mm²` and recording the
current as-built `150,536.239 µm²` (0.150536 mm², 94.1 % of that bound) as
the value it bounds — using the current, post-#215 figure rather than the
stale `0.18045 mm²` DR-0019 built or DR-0017's own stale `0.12100 mm²` /
`< 0.13 mm²` proposal, and explicitly superseding DR-0017. Status
**proposed**; DR-0006's own row and DR-0017's `Superseded by` back-pointer
are edited at ratification, not by this update. Until that lands, the
"deliberately NOT reconciled" statements above still describe the
as-ratified state of the repo accurately — only a *proposal* for the
reconciliation exists so far, not the reconciliation itself.

**Update (issue #280): the "Area, as drawn" table above is an issue #118
snapshot and was never regenerated after #196/#215's geometry moved it —
this refreshes every row from the currently committed `area.json`, not
just the totals the #196/#215/#274 updates above happened to call out.**
The original table's own rows (`As drawn (issue #118)` / `Previous
(#116/#91, pre-#118)`) are left exactly as drawn, per this section's own
"supersede rather than edit in place" rule; nothing below changes any
geometry, only what is reported about it (out of scope per this issue).

| Region | Current, read live off `area.json` | Source |
|---|---|---|
| CDAC array, per side (512 units + dummy ring + top-plate mesh) | 24,669.600 µm² (216.4 × 114.0 µm) | `areas_um2.cdac_array_per_side` / `dimensions_um.cdac_array` |
| CDAC arrays, both sides | **49,339.200 µm²** | `areas_um2.cdac_arrays_total` |
| CDAC decode bank, per side (144 devices) | 14,650.700 µm² | `areas_um2.decode_bank_per_side` |
| CDAC decode banks, both sides | **29,301.400 µm²** | `areas_um2.decode_banks_total` |
| Top-plate `V_cm` switches, both sides (8 devices, DR-0014's `adc_tp_sw`) | **889.278 µm²** | `areas_um2.tp_switches` |
| Comparator (27 devices + 2 resistors) | **5,299.2415 µm²** (112.63 × 47.05 µm) | `areas_um2.comparator`; dims from a live `build()` query — `area.json` does not persist a per-cell comparator dimension pair |
| Analog core incl. guard ring | **113,489.937 µm²** | `areas_um2.analog_core_with_guard_ring` |
| SAR-logic reserved region incl. its ring | **8,646.028 µm²** | `areas_um2.sar_logic_reserved` (already read live as of issue #274, unchanged here) |
| **Block total (`adc_block`, 599.03 × 251.3 µm)** | **150,536.239 µm² = 0.150536 mm²** | `areas_um2.block_total` / `dimensions_um.block` |
| `adc_top` alone (no comparator), 490.2 × 251.3 µm | 123,187.260 µm² = 0.123187 mm² | live `build(subckts, None, cell_name=CELL_NAME)` query — `area.json` only tallies whichever cell `gen_adc_top.py`'s own `main()` built *last* (`adc_block`), so `adc_top`'s own standalone figure is not persisted in the file at all, only printed to stdout when the generator runs |

Read at the committed `area.json`'s own last-touching commit
(`076d545`, 2026-08-17, issue #215's strap-corridor re-derivation PR
#223) — see that file's own `git log -p -- layout/adc-top/area.json` for
provenance, the same citation discipline
`design/sar-logic/flow/pnr_sar_ctrl.py`'s `derive_reserved_footprint()`
uses for the SAR-logic row. `git status --short layout/adc-top/` was
empty when this table was built (this update ran the same regeneration
recipe "Reproducing it" above gives, and diffed nothing), so every figure
above is the same one a fresh `python3 layout/adc-top/gen_adc_top.py` run
produces today, not a value copied out of prose elsewhere in this file.

What moved and was never given its own row-level update before now:

* **CDAC array/decode bank per side** grew with DR-0019's unit-cap resize
  (issue #196, 2.7136 µm → 4.0 µm plate; committed `area.json` at
  `6dfb50b`) — the array from 15,688 to 24,669.6 µm², the decode bank from
  15,787 to 18,467.5445 µm² — then issue #215's strap-corridor
  re-derivation (`076d545`, the same commit this table reads) narrowed the
  decode bank back down to 14,650.700 µm² per side (its far rail-stitch
  column pulled in with the re-derived corridor, same mechanism as the
  block-level width recovery). Only the block/analog-core *totals* were
  called out at either update at the time; these two per-cell rows were
  left silently stale until now.
* **Comparator** is smaller than either issue #215 update paragraph
  states (5,502 µm² after the load-resistor fold) because the *second*
  #215 step — the strap-corridor re-derivation — also pulled in the
  comparator's own `vdd`/`vss` corridor (see "strap-corridor
  re-derivation" above), narrowing its cell from 116.93 × 47.05 µm to
  112.63 × 47.05 µm. Both #215 paragraphs quote the block-level total
  correctly (153,652 → 150,536 µm²); neither restates the comparator's
  own cell area at the final figure, which is why it reads low here
  against that prose.
* **Decode bank, per side** as tallied in the current `adc_block` build
  (14,650.700 µm², used above) differs from the same cell measured inside
  a standalone `adc_top` build (13,585.919 µm², no comparator in the
  composition) — both are genuine, live numbers for two different
  compositions of the same generator; the table above reports the
  `adc_block` figure throughout, matching this file's existing convention
  of tallying `adc_block`'s composition except in the `adc_top`-alone row.
* **Analog core, SAR-logic reserved region and block total** already
  carried live figures via the #274 update above; this table just puts
  them alongside the rest instead of leaving them as the only rows an
  outside reader could trust.

Nothing downstream may quote the issue #118 table's per-row figures
(15,688 / 15,787 / 19,272 / 121,752 / 7,624 µm² etc.) as this design's
current area breakdown any more; use the table immediately above instead.

**Update (issue #356): the table above is a pre-tap snapshot.** Drawing an
n+ well tap inside all 25 `Nwell` islands and strapping both substrate-tie
rings to `vss`
([DR-0035](../../spec/decision-records/DR-0035-well-taps-and-tie-straps.md))
grew the block. Per this section's own "supersede rather than edit in place"
rule the #280 table is left exactly as drawn; these are the same rows read
live off the currently committed `area.json`, with the delta stated:

| Region | Current (`501f3985…`) | Was (#280 table) | Δ |
|---|---|---|---|
| CDAC array, per side | 24,669.600 µm² | 24,669.600 | — |
| CDAC arrays, both sides | **49,339.200 µm²** | 49,339.200 | — |
| CDAC decode bank, per side | 15,069.600 µm² | 14,650.700 | +418.900 (+2.86 %) |
| CDAC decode banks, both sides | **30,139.200 µm²** | 29,301.400 | +837.800 |
| Top-plate `V_cm` switches, both sides | **916.318 µm²** | 889.278 | +27.040 (+3.04 %) |
| Comparator | **5,304.873 µm²** | 5,299.2415 | +5.632 (+0.11 %) |
| Analog core incl. guard ring | **114,505.908 µm²** | 113,489.937 | +1,015.971 (+0.90 %) |
| SAR-logic reserved region incl. its ring | **8,646.028 µm²** | 8,646.028 | — |
| **Block total (`adc_block`, 599.35 × 253.32 µm)** | **151,827.342 µm² = 0.151827 mm²** | 150,536.239 = 0.150536 mm² | **+1,291.103 (+0.86 %)** |

**Update (issue #378): the decode-bank rows above moved again, by 12.600 µm²
per side.** [DR-0037](../../spec/decision-records/DR-0037-block-level-supply-straps-on-metal2.md)
carries the block-level `vdd`/`vss` straps on Metal2, and
`CMP_SUPPLY_PITCH` widens the comparator's two supply columns from a 700 nm
to a 900 nm pitch (`metal2.space.1` is 280 nm against `poly2.space.1`'s
240), so both banks' trunks reach 200 nm further into that corridor. The
block's own bounding box, `block_total` and every other row are unchanged —
this is +0.08 % on one region, not a floorplan move.
| `adc_top` alone (no comparator), 490.5 × 253.3 µm | 0.12426 mm² | 0.123187 mm² | +0.00107 mm² |

The growth is **one 0.8 µm horizontal strip per stacked device row**, not per
well: `TAP_ACTIVE_GAP` (0.4 µm of `comp.space.1` clearance) plus `TAP_COMP_H`
(0.4 µm of tap diffusion) added to the top of each `Nwell` island, which is
why the shallow decode banks pay the largest *relative* cost (+2.77 %) and
the deep CDAC arrays — which contain no PMOS and therefore no well — pay
nothing at all. The rings' `Pplus` markers add 0.16 µm on each side of the
block's bounding box, which is most of the width change.

**This does not reopen DR-0024.** That record proposes bounding the area at
`< 0.16 mm²` against a then-current 0.150536 mm² (94.1 % of the bound); the
new figure is 94.9 % of the same bound. DR-0035 ratifies no new area value
and DR-0024 continues to stand on its own terms, against the new number.
Documents that still quote `0.150536 mm²` as the as-built figure —
`signoff/evidence/characterization-summary.analog.json` and the
characterization summary it wraps, `docs/chipalooza/challenge-3-proposal.md`,
`sim/t1-checklist-reread-20260825.md`, DR-0024's own context table — are
append-only evidence or dated re-reads carrying their own vintage, and the
verdict each of them records (**FAIL** against the ratified `< 0.1 mm²` row)
is unchanged by a 0.86 % move.

### Why it went over (issue #70)

The 0.09619 mm² above was measured on a MiM stack that could not be
manufactured as drawn. Every unit capacitor violated `MIMTM.3` (0.6 µm
Metal4-over-FuseTop overlap; 0.3 µm was drawn) and the tiling pitch was set
from the plate + `MIMTM.1` alone, with the 2 × 0.6 µm of bottom-plate ring
simply missing. Drawing it legally costs, per unit position,
2.7136 + 2 × 0.6 + 1.2 = 5.1136 µm of pitch instead of 3.914 µm — a factor
of 1.31 in each direction, on the one structure the block has 1224 of.

The three contributions, in order of size:

* **the arrays themselves**: 18,265 → 31,376 µm² (+13,111). Unavoidable at
  this unit size; it is the DRM's number.
* **the block got taller with them**: 209.0 → 229.4 µm, i.e. exactly the
  array's own +21.6 µm. Nothing else in the vertical stack moved.
* **`adc_block` got wider than `adc_top` for the first time**: 461.4 →
  527.4 µm. The arrays sit side by side, so their +40.8 µm each pushes the
  top-plate switch and the comparator right — far enough that the
  comparator now extends past the decode banks' own right edge. The far
  rail-stitch column has to clear all of it, and the fix at the time was to
  derive it from what is actually drawn (`max(bank_w, top.bbox().right) +
  6 µm`) rather than from `bank_w`, which is what it assumed before.
  Without *some* fix the block does not build at all: `geometry.stitch`
  refuses to run a Poly2 strap over the comparator's diffusion, which is
  exactly how the stale assumption surfaced.

  *Superseded by issue #215.* R1 named this expression as a candidate to
  re-derive, and re-deriving it is what the R1 step did. The `max(bank_w,
  top.bbox().right)` form is correct but far more than the requirement: it
  reaches past every cell placed *after* it too, so in `adc_block` the
  bridge landed 152 µm past the decode banks it exists to reach — a
  right-side corridor whose only content was three rail trunks crossing it
  to get there. The requirement is the **banks'** own geometry (their device
  rows end at `row_x1`; their last cross-bank riser sits at
  `stitch_x0 + (n−1) × 1 µm`), and `far_x` is now one column pitch past
  that. Both properties `geometry.stitch` asserts still hold by
  construction, and the derivation no longer depends on placement order —
  it is computed with the comparator's own supply corridor, before the
  comparator is built, so neither corridor can be pushed outward by
  something drawn later. The block's width is now a chain of drawn cells and
  seven strap columns with 0.8 µm of slack in it, tabulated in
  [`economy/records/20260817-185745-40cfeb8.md`](economy/records/20260817-185745-40cfeb8.md)
  → "The width floor this floorplan now sits against".

  What #215 did **not** do is move `COMPARATOR` itself, R1's other named
  candidate. Its left edge is pinned behind the `topp`/`topn` strap columns,
  those behind the top-plate switch cell's diffusion, and that behind the
  CDAC arrays; every alternative placement examined moves the `topp`/`topn`
  strap to the comparator's right and adds ~190–250 µm of Metal1 to the CDAC
  **top plate**, which under DR-0011 top-plate sampling is the converter's
  summing node. That is a parasitics trade needing its own decision record
  and PEX re-run, not a silent layout tweak; the ~24,800 µm² still empty in
  the right column is named and measured in the same record rather than left
  to look un-noticed.

**What was NOT done to get the number down**: the plate was not shrunk. A
2.114 µm plate (what the old construction actually drew) tiles at 4.514 µm
and would have brought the block back to ~0.104 mm², but it is a 10.9 fF
unit capacitor, not the ratified 17.24 fF one — see "Capacitance" above.
Making a ratified area row pass by quietly drawing a different device than
the one `design/` and `sim/` use is precisely the trade `CLAUDE.md` forbids.

### Why recovery to `< 0.1 mm²` is infeasible (issue #80)

Issue #80 asked whether a *legal* floorplan pass — the same category of fix
#67/#69 used — could recover the overrun without shrinking the plate or the
decode bank below its DRC floor. It cannot, and the two levers it named are
both spent. The check is reproducible:
[`area_feasibility.py`](area_feasibility.py) rebuilds the block in-memory at
each candidate and reports the resulting bounding box.

* **CDAC-array aspect ratio is already at its minimum.** The array is
  common-centroid tiled over 512 unit positions, so only factor pairs of 512
  are legal shapes, and the shipped **32 × 16 is the smallest block of them
  all** (0.12100 mm²). Every other pair is worse — 16 × 32 → 0.14494,
  64 × 8 → 0.16113, 8 × 64 → 0.22114 mm² — because the two arrays sit side by
  side, so a taller/narrower array multiplies its added height against the
  block's larger width and its saved width against the smaller height. Making
  the arrays wider/shorter loses even faster (the width change is doubled
  across the two sides).
* **The block's packing floor already exceeds the budget.** The decode bank is
  one row of 144 single-finger devices at the `comp.space.1` DRC floor #69
  established, so its width `bank_w` = 440.94 µm is a rule, not a choice; the
  block height 229.4 µm is the analog stack (two banks + the DRM-floored array
  + region gaps + guard ring) plus DR-0008's 20 µm analog/digital isolation
  gap and DR-0010's 40 µm SAR-logic reserve. Their product,
  **440.94 × 229.4 = 101,168 µm² > 100,000 µm²**, bounds the block from below
  *before any whitespace, comparator overhang, or corridor is counted* — so no
  legal packing pass, however tight, gets under the row.
* **Folding the decode devices does not recover area.** This bullet used to
  say the lever was blocked on LVS device-merge
  ([klayout-tools#261](https://github.com/2AMLogic/klayout-tools/issues/261));
  that is fixed upstream (opt-in `combine_devices`), and issue #668 measured the
  lever: folding shrinks a bank's height but grows its width faster, so the
  block got larger in every case tried
  (`economy/records/20261030-223000-be1c350.md`).

Every remaining path to `< 0.1 mm²` requires relaxing something ratified or
DRC-checked (the `C_u` plate, the `comp.space.1` bank pitch, or the
DR-0008/DR-0010 isolation reserve), which an agent does not do silently. The
decision is therefore routed to the operator as **proposed**
[DR-0017](../../spec/decision-records/DR-0017-adc-top-area-budget-overrun.md),
which recommends revising the target row to `< 0.13 mm²` rather than dialling
the layout to fit a number the pinned DRM makes unreachable.

### How it got back inside the row (issue #67) — superseded by the above

DR-0014's redraw (#66) measured 0.1136 mm² — 114 % of budget, over it by
13,623 µm², a regression from the pre-DR-0014 draw's 0.0991 mm² (#62). That
number stands as recorded; it is not restated away here. What changed is the
layout, in one place:

* **Two construction constants were sized by nothing in particular, and a
  decode bank pays for both on every device column it draws.**
  `geometry.COLUMN_GAP` — the gap between adjacent device columns' active
  islands — sat at 900 nm against a `comp.space.1` of 280 nm, and
  `place.NWELL_KEEPOUT` at 1600 nm against a clearance whose governing rule
  (`nwell.space.1`) is 600 nm. Both are now set from the threshold they exist
  for plus stated headroom: 400 nm (= 280 + 120) and 900 nm (giving
  Nwell-edge-to-foreign-NMOS-active `COLUMN_GAP + NWELL_KEEPOUT -
  NWELL_MARGIN` = 800 nm = 600 + 200). A bank crosses a column boundary 144
  times and a well boundary 17 times per side, so that is ~83 µm off the
  bank's own width per side, 16,319 → 13,763 µm² (−16 %).
* **The banks set the block's right edge, so the block narrowed with them.**
  543.6 → 460.2 µm. The height is **unchanged at 209.0 µm** — nothing in the
  vertical stack (bank channel depths, `REGION_GAP`, the array, the
  analog/digital separation) moved at all, which is the clearest evidence
  that this was a width-only, per-column change and not a floorplan
  rearrangement.
* **The comparator's reported area falls the same way it rose** (10,318 →
  6,657 µm², vs. 6,564 pre-DR-0014). Its 27-device cell is unchanged in kind;
  it is narrower for the same per-column reason as everything else, and its
  `vdd`/`vss` trunks no longer have to reach as far right, because the decode
  banks' rail column came back left with them.
* **The SAR-logic reserved region shrank with the block** (7,855 → 6,665 µm²)
  because its footprint is `max(120 µm, analog-ring-width / 3)` wide by
  40 µm tall, and the analog ring narrowed. It is still 152.9 × 40 µm of
  reserved area, comfortably above its own 120 × 40 µm floor — the reserve
  was not shaved to buy budget.
* **Nothing else moved.** Same 323 devices, same netlist, same placement
  order, same common-centroid tiling (`test_layout_centroid_tiling.py` still
  passes unchanged), same two-layer routing model, same floorplan structure.
  The arrays' own numbers (9,133 µm² per side) are byte-identical, because
  the MiM pitch is set by the PDK's `MIMTM.3` spacing and not by any of this.
  *(That last sentence was true of #67's change and false about the pitch:
  the pitch was missing `MIMTM.3`'s ring entirely — issue #70.)*

Why this is a verified change and not an argued one: `comp.space.1` is a rule
the pinned deck **checks**, so drawing at 400 nm is a claim `klt drc` can
falsify — and the DRC record above is it. Every other clearance that crosses
a column boundary (S/D poly risers, S/D Metal1 drop stubs, S/D contact bars,
gate heads) is looser than `comp.space.1` by construction, and each is now
asserted at import in `lib/geometry.py` beside the pre-existing
device-internal asserts, so "`comp.space.1` is the binding rule here" is
checked rather than asserted in prose. The one clearance the deck does **not**
cover — the DRM's "Nwell to unrelated COMP", which is not in the pinned deck
at all — is asserted per drawn row in `place._assert_nwell_clearances`, which
is the only place it could be caught.

What has **not** changed is the pair of verification-driven constructions that
still dominate this block's area: single-finger devices spending area linearly
in `W`, and single-metal-level planar routing forcing one horizontal track per
simultaneously-live net. Closing either upstream gap
([#261](https://github.com/2AMLogic/klayout-tools/issues/261),
[#220](https://github.com/2AMLogic/klayout-tools/issues/220)) would still move
this number by roughly a factor of two on the dominant term; neither is
available at this repo's pinned `klt` commit, and nothing here claims
otherwise. This change bought margin inside the current toolchain's
constraints, which is what was available to buy.

## Friction filed upstream

Per `CLAUDE.md`'s friction protocol — tool capability only, described
generically, never this design's specifics.

| Gap | Upstream issue | Filed by this work? |
|---|---|---|
| MiM capacitor device model is plate-**area** only — no perimeter/fringe term — so extracted `C` is systematically low against the PDK's own model card (−14.6 % at a unit-sized plate, worse as plates shrink) | [#512](https://github.com/2AMLogic/klayout-tools/issues/512) | **yes — new** (issue #70) |
| LVS has no device-merge step, so a folded / split / interleaved matched device cannot be compared against a lumped schematic device | [#261](https://github.com/2AMLogic/klayout-tools/issues/261) | closed upstream (opt-in `combine_devices`, see the deviation section above); filed by #57 |
| Extraction deck exposes one metal level and no vias, so an LVS-verifiable layout must be two-layer planar | [#220](https://github.com/2AMLogic/klayout-tools/issues/220) | no — filed and closed upstream, and **the fix is now in this repo's pinned commit** |
| Extraction decks recognise MOS only — no capacitor or resistor device class | [#219](https://github.com/2AMLogic/klayout-tools/issues/219), [#222](https://github.com/2AMLogic/klayout-tools/issues/222), [#225](https://github.com/2AMLogic/klayout-tools/issues/225) | no — closed upstream, and **the capacitor half is now in the pinned commit and used here** |
| DRC deck has no MiM / upper-metal rule coverage | [#188](https://github.com/2AMLogic/klayout-tools/issues/188) | no — filed by #15; **closed upstream and now in the pin**, which is what found this block's 4896 `MIMTM.3` violations |
| A stream drawn entirely on uncovered layers reports `clean`; no coverage manifest | [#189](https://github.com/2AMLogic/klayout-tools/issues/189) | no — filed by #15; the deck now emits a `coverage` block naming checked layers and skipped rules |
| No `klt extract` RC parasitic path (matters for #17) | [#216](https://github.com/2AMLogic/klayout-tools/issues/216) | no — filed and closed upstream; **`--parasitics` is in the pin as of issue #70** |
| gf180mcu's curated extraction deck has no tap/well-label layer, so every PMOS body lands on an anonymous, un-biased, non-pin net — blocks a faithful resimulation of the extracted netlist, distinct from the LVS-compare accommodation `body_net_of` already implements | [#555](https://github.com/2AMLogic/klayout-tools/issues/555) | **yes** — filed by #17; **no longer bites this block as of issue #356.** `ExtractionDeck.tap` is still `None`, but the deck *does* carry implant-narrowed `tap_pplus` (31/0) / `tap_nplus` (32/0) derivations, and now that DR-0035 draws and marks the taps, `klt extract` reports every PMOS body on `vdd` and every NMOS body on `vss` in `adc_top`/`adc_block` — `vsubs` is gone from both extracted netlists and the deck's own "anonymous net with no DC bias path" warning no longer fires. The filing stands for **unmarked** streams, which this repo still has (`lvs_unit`, the stand-alone comparator cells) |

## What this unblocks, and what it does not

**#17 (post-layout extracted re-run) is unblocked by this change.** It
needed three things that did not exist together before: a DRC-clean layout
including its MiM stack, `klt extract --parasitics`, and an extracted
netlist that contains a capacitor at all. The first two are now true of
`adc_top.gds`/`adc_block.gds` at the pinned commit — `klt extract
--parasitics` runs on them and emits lumped RC per net.

The third is now true at the block too (issues #85 + #86): `adc_top.gds` and
`adc_block.gds` extract 1024 `cap_mim_2f0_m4m5_noshield` devices on the nets
`design/adc-top/adc_top.spice` names, so a block-level post-layout netlist from
this flow is a netlist of switches **with the CDAC in it**, not without. #17 no
longer has to work from the leaf cell plus a schematic array. What it must
still carry into its own record is the extractor's area-only MiM model (each
unit reads 14.7316 fF against the model card's 17.245 fF — see "Capacitance"
above), which is a modelling difference no layout change closes and which
therefore belongs in #17's provenance rather than being silently absorbed.

**#17's own follow-on work — the parasitic extraction itself, a PDK-bound
extraction that resimulates against `sm141064.ngspice` directly, and a newly
found blocking gap in doing so — lives in
[`parasitics/`](parasitics/README.md)**, not in this file: `gen_adc_top.py`
regenerates `adc_top.gds`/`adc_block.gds` here, and `parasitics/`'s own runner
(`run_extract_parasitics.py`) extracts parasitics from the committed output,
so the two stay cleanly separated (this directory draws and LVS-matches the
layout; `parasitics/` is the one downstream consumer of it #17 needs).
