2AMLogic/gf180-sar-adc/sim/harness/README.md

# sim/harness — the PVT corner runner

Reproducible ngspice simulation against the gf180mcu PDK. This document covers
**how to run** the harness, **how to write a testbench**, and **how this
harness diverges from the gf180-bandgap pattern it was ported from**.

The *output* of a run — directory layout, record-id format, the summary record
field set, and the append-only rule — is defined by
[`sim/README.md`](../README.md), not here. That convention is authoritative;
this harness exists to produce records that conform to it.

```
sim/
  run_corners.py            CLI entry point (stdlib python3, no venv)
  env.sh                    `source sim/env.sh` to export the same PDK to your shell
  selftest.sh               harness acceptance test (unit tests, PVT run, negative control)
  pdk.json                  committed PDK defaults (variant, extra search roots)
  toolchain.json            pinned tool versions, checked before every run
  harness/                  the runner itself (this directory)
  tests/                    harness unit tests (no PDK, no ngspice required)
  .work/                    generated ngspice decks (git-ignored, disposable)

  <experiment-slug>/        one per claim under test -- see sim/README.md
    testbench/              tb.json + netlist fragment      <- you write these
    netlist-snapshots/      frozen netlist per record       <- pre-#636 records only; newer ones are
    corners/<record-id>/    raw <corner-id>.log per PVT point   stored (manifests/artifacts/)
    records/<record-id>.md  append-only summary record
```

## Quick start

```bash
python3 sim/run_corners.py --check-env      # is ngspice + the PDK present?
python3 sim/run_corners.py --list           # experiments, corners, corner sets
python3 sim/run_corners.py smoke-sar-bias   # run the full PVT grid, mint a record
bash sim/selftest.sh                        # prove the harness works (writes nothing)
```

`sim/selftest.sh` takes ~25 minutes on a laptop: it runs all eight committed
testbenches twice (once normally, once sabotaged), and the Monte Carlo and
transient ones dominate. `--quick` skips to a single PVT point, but see the
warning it prints: a single point cannot verify corner switching.

## Prerequisites

| Tool | Why | Install |
|---|---|---|
| `ngspice` | simulation | `brew install ngspice` / `apt-get install ngspice` |
| gf180mcu PDK | device models | `pip install ciel==2.6.1 && ciel enable --pdk-family gf180mcu -l gf180mcu_fd_pr <hash>` (hash = `open_pdks` in `sim/toolchain.json`) |
| `xschem` | schematic capture (optional for simulation) | build from source, see `docs/environment-setup.md` |
| python3 ≥ 3.9 | the harness | stdlib only, no packages |

Full bootstrap, including pinned versions: [`docs/environment-setup.md`](../../docs/environment-setup.md).

The harness never hardcodes a PDK path. It resolves one, in order:

1. `GF180_PDK_PATH` — the *variant* directory, e.g. `~/.ciel/gf180mcuD`
   (the one containing `libs.tech/`).
2. `PDK_ROOT` (+ `PDK`, default `gf180mcuD`) — the open_pdks / OpenLane convention.
3. `sim/pdk.local.json` — machine-local, git-ignored.
4. `sim/pdk.json` — committed defaults.
5. Built-in search roots: `~/.ciel`, `~/.volare` (legacy, lower priority),
   `/usr/share/pdk`, `/usr/local/share/pdk`, `~/share/pdk`, `/opt/pdk`.
   Among the hits, a tree whose `SOURCES` open_pdks revision equals the
   `sim/toolchain.json` pin wins over an earlier stray one; if none matches,
   the first is used and the toolchain gate reports the pin mismatch (fatal
   unless `--allow-toolchain-drift`). A tree with no readable `SOURCES` is
   `unknown`, never a pass.

If nothing is found the runner exits 3 with install instructions rather than
producing a misleading result. `sim/run_corners.py --print-env` emits the
resolved paths as shell exports; `source sim/env.sh` applies them so that an
interactive ngspice or xschem session uses the identical PDK.
`sim/smoke_test/run_smoke_test.sh` uses the same resolver when `PDK_ROOT`/`PDK`
are unset, so the install check and the corner runner can never end up testing
different PDKs.

### Pinned versions are checked, not just recorded

Finding *a* PDK is not enough. The open_pdks hash **is** the device model set:
a run against a different revision produces numbers that are not comparable
with anything already under `sim/`, and it produces them silently — no error,
no obviously wrong value. That is the same class of failure as a corner runner
stuck on typical.

So `sim/toolchain.json` pins the toolchain and the runner checks it **before
simulating a single point**:

| Pin | Rule |
|---|---|
| `open_pdks` | exact hash match |
| `ngspice_min_major` | floor — newer is allowed and recorded, older is refused |
| `python_min` | floor |

A drift is fatal (exit 3, nothing simulated, nothing written). To re-validate
against a newer PDK on purpose, pass `--allow-toolchain-drift`: the run
proceeds and every record it writes carries the drift as a banner at the top
and a line in its Environment section, so drifted evidence cannot be mistaken
for pinned evidence. `--check-env` reports pin status separately from tool
availability — exit `3` means something is **missing**, exit `1` means
everything is installed but a pin **drifted** — and `sim/selftest.sh` keys off
that distinction so a drifted machine gets a hard failure rather than a
misleading "tools unavailable, skipping".

The pins and the version table in `docs/environment-setup.md` §1 are kept in
sync by a unit test; changing one without the other fails the self-test.

### Execution-environment provenance in the record (issue #468)

A record's Environment section carries, besides the short `ngspice` string the
pin check uses:

- **Platform and hostname** of the process that ran the harness. On a
  `--backend batch` run these describe the *launcher*, not the worker, and the
  record says so; worker platform/hostname are listed only if klt reported them
  (otherwise unavailable).
- **The full `ngspice --version` output**, verbatim, in a fenced block (local
  runs). Nothing is inferred beyond it: compiler, KLU and OpenMP appear only if
  the banner prints them. An empty or failed version command renders as
  "unavailable".
- **The front-end compatibility note** each point's own output printed
  (`No compatibility mode selected!` / `Compatibility modes selected: hs a`),
  as `uniform`, `inconsistent` (more than one note, with the corners that
  printed each) or `unavailable`. A point with no note (timeout, batch point
  with no log) contributes nothing; a missing note is **never** read as "no
  compatibility mode". The init file (`spinit` / `~/.spiceinit`) that supplied
  the mode is not identified.

Records written before this change lack these keys and render
"not recorded"; no existing record is edited.

**Front-end-mode policy: left host-controlled.** The harness does not write a
`.spiceinit` or neutralise host init files. The only controlled one-binary A/B
on record (`sim/dr0014-sampling/investigations/20261021-issue-623-compat-probe.txt`,
ngspice-46, `ff_-40c_3.63v`) found that forcing `ngbehavior=hsa` changed the
compatibility note and nothing else in the ngspice output, so pinning the mode
would not remove the cross-host difference it was meant to; and changing the
simulation default would need its own `spec/` decision record and a paired
before/after. The observed note is now recorded per point instead. That A/B
was one corner on one worker and is diagnostic, not a PVT result.

## The PVT grid

`CLAUDE.md` requires PVT corners on every recorded result. The defaults are
baked into `corners.py` and are what a testbench gets unless its manifest says
otherwise:

- **Temperature**: −40, 27, 125 °C
- **Voltage**: nominal ±10 % (3.3 V flavor → 2.97 / 3.3 / 3.63 V)
- **Process**: see below

gf180mcu has no single global corner switch — each device family carries its
own `.lib` section in `sm141064.ngspice`, so a named corner here is a bundle of
six sections (MOS, resistor, BJT, diode, MOS cap, MIM cap):

| Corner | Meaning |
|---|---|
| `tt` | everything typical |
| `ff` / `ss` | every device family fast / slow |
| `fs` / `sf` | fast-N/slow-P and slow-N/fast-P, passives typical |
| `cap_ff` / `cap_ss` | **both** capacitor families skewed, rest typical |
| `mim_ff` / `mim_ss` | MiM cap skewed (the CDAC unit element), rest typical |
| `moscap_ff` / `moscap_ss` | MOS cap skewed, rest typical |
| `res_ff` / `res_ss` | resistor sheet rho skewed, rest typical |

Corner sets: `tt` (1), `mos` (5, the default), `cdac` (7 — the capacitor
families a CDAC's linearity rides on), `full` (13, every defined corner).
`full` × 3 temperatures × 3 supplies = 117 operating points.

**Why the capacitor corners matter here.** The five MOS corners leave both
capacitor families at `*_typical`, so a MOS-only sweep would never notice a
broken `mimcap`/`moscap` include — and a 10-bit CDAC's accuracy rides on the
unit capacitor far more than on the MOS skew. Any experiment whose claim
depends on capacitance must use `cdac` or `full`, not the default `mos`.

**MoM capacitors are not modelled.** The open gf180mcu PDK ships no MoM /
lateral-flux capacitor subckt (neither `sm141064.ngspice` nor
`sm141064_mim.ngspice` defines one), so there is no MoM `.lib` section to
sweep. A MoM-based CDAC would have to be substantiated by parasitic extraction
rather than a model corner. This is a PDK limitation, not a harness one, and
it is an input to the CDAC topology decision — not something the harness can
paper over.

Each point becomes one `<corner-id>` — `<process>_<temp>c_<supply>v`, the
naming `sim/README.md` ratifies — and one raw log under `corners/<record-id>/`.

A recorded run (no `--no-write`) needs the fleet artifact store: the logs and
the netlist snapshot are stored with `klt artifact put` and only a manifest and
the record are committed (`evidence_store.py`; `sim/README.md`, "Stored
evidence"). With no broker the run exits 10 before simulating.

**Friction filed upstream.** The corner bundles above, and the
variant→metal-stack table in `pdk.py` that binds the `mim_cap_*` aliases, are
both hand-maintained tables of PDK metadata that no tool exposes — and both
fail silently when wrong (the deck still runs; a family just stays typical, or
a plausible-but-wrong device model gets instantiated). Per `CLAUDE.md`'s
friction protocol that is logged generically on the public tracker as
[`2AMLogic/klayout-tools#68`](https://github.com/2AMLogic/klayout-tools/issues/68).
Until a tool owns it, these tables are the workaround, and
`--sabotage-corners` is what keeps them honest.

Override any axis from the command line:

```bash
python3 sim/run_corners.py device-cdac-cap --corner-set full -j 8
python3 sim/run_corners.py smoke-sar-bias --corners tt mim_ss --temps -40 125
python3 sim/run_corners.py smoke-sar-bias --supply 1.8 --supply-tol 0.10
```

**Subsets need a reason.** `sim/README.md` requires every record's *Corner
matrix run* field to be the full mandated matrix "unless the record states why
a subset was used". The runner enforces that: if the grid you asked for is
missing a mandated temperature, a mandated supply, or has fewer than three
process corners, it refuses to write a record unless you supply
`--subset-reason '<why>'` (copied verbatim into the record), or pass
`--no-write` because you are only debugging.

```bash
# debugging: runs, records nothing
python3 sim/run_corners.py smoke-sar-bias --corners tt --temps 27 --supply-tol 0 --no-write

# a deliberate, justified subset: runs and records, with the reason on the record
python3 sim/run_corners.py smoke-sar-bias --corners tt --temps 27 \
    --subset-reason "nominal-only mismatch sweep; distribution claim, see Statistical convention"
```

## Corner-sensitivity: proving the sweep is real

The failure this harness is built to prevent is **silent**: a runner that
appears to sweep PVT but simulates typical everywhere — a wrong model include,
an ignored parameter, a mistyped corner-bundle name — produces plausible
numbers with no error, and every record built on it is worthless. Three
mechanisms guard against it, in increasing strength.

**1. `min_spread_pct` (grid-wide).** Ported from upstream. Asserts a
PVT-sensitive measurement moved *somewhere* across the grid.

**2. `min_spread_pct_by_axis` / `max_spread_pct_by_axis` (per axis).** The
grid-wide floor is not enough: it passes happily when the temperature axis
moves and the process axis is stuck on typical. For each axis, the harness
slices the grid so the other two axes are held fixed, measures the spread
within each slice, and checks the **weakest** slice against the floor — so one
dead slice cannot hide behind the others. `report.axis_sensitivity()` computes
this, and every record carries the resulting table whether or not the
testbench checks it.

An axis with fewer than two levels in the grid was never swept, so nothing
about it was verified. That is reported as a **failure**, not a pass — unless
the run is already declared non-evidence (`--no-write`) or carries a written
`--subset-reason`.

**3. `--sabotage-corners` (the negative control).** Flags and thresholds can
themselves be wrong. This flag keeps every corner *name* but forces every
model section to typical, reproducing the exact silent failure above. A
healthy testbench **must fail** under it. `sim/selftest.sh` stage 4 runs both
repo testbenches this way and fails the whole self-test if either passes.
Sabotaged runs force `--no-write`, so they can never enter the evidence tree.

Concretely, on `smoke-sar-bias`: sabotage leaves the grid-wide spread of
`vgs_nfet` at ~17 % (temperature is still moving it), which a grid-wide floor
would accept — while the process-axis spread collapses to 0 % and the per-axis
floor catches it. That gap is exactly why mechanism 2 exists.

### A point that aborted mid-transient is never `ok` (issue #341)

The same silent-failure argument applies one level down, to a single point.
When ngspice gives up on a transient part-way through — `doAnalyses: TRAN:
Timestep too small`, then `tran simulation(s) aborted` — it still evaluates
and prints every `meas` it can compute from the data it *did* get. So the
truncated run's output is not visibly different from a completed one if you
only check that the measurements the manifest named came back.

On a manifest with exactly one measurement, and that measurement an
unbounded-right `meas ... MAX ... FROM=...`, this is guaranteed to fool a
parse-only check: `MAX` over a sixth of the requested window always yields a
number. `runner.analysis_aborted()` therefore scans the raw output for the
abort markers and `run_point` consults it **before** scoring anything `ok`,
regardless of whether every measurement parsed. An aborted point comes back
`status="failed"` with the abort line in its message, which is what makes the
record render `ERROR — …` for it and keeps the whole record out of `pass`.

This is deliberately narrower than the harness's general `Error`/`Fatal`
scan: ngspice also prints recoverable per-measurement complaints (`Error:
measure tdr_b when(WHEN) : out of interval`) while the analysis itself runs
to completion, and those must not disqualify a point whose manifest
measurements all came back. Only the three markers that mean *the analysis
stopped* do.

There is no second, stop-time-based check, and the reason is measured rather
than assumed: ngspice's trailing `Reference value :` progress lines are
throttled, so on committed evidence a run that genuinely reached its stop
time can print a last reference value as low as 20 % of it
(`sim/adc-inl-dnl/corners/20260805-230438-048ff7e/tt_-40c_2.97v.log`,
3.91 µs of a `tran ... 20u`). Comparing that number against the manifest's
`tran` stop time would fail completed runs across the tree. Catching a silent
early stop that prints no marker at all needs a sentinel measurement in the
deck, not a heuristic on the log.

## Where the grid runs: `--backend`

`run_corners.py` runs the grid on this host's ngspice by default, or exports it
as a `klt sim` request for the batch fleet (`--backend batch`, or automatically
when `$KLT_SIM_BACKEND` names an off-host backend and the grid has more than one
point). The exporter is `harness/batch.py`; the format of the record it writes,
what it refuses to export and the version-skew policy are in
`sim/README.md` section "Running a grid on the batch fleet".

## Writing a testbench

Create `sim/<experiment-slug>/testbench/` with a manifest and a netlist
fragment. The slug is the experiment directory from `sim/README.md`: one per
distinct claim under test, kebab-case.

`tb.json`:

```json
{
  "name": "my-experiment",
  "description": "one line, shows up in --list and in the record",
  "claim": "spec/adc.md#inl-dnl",
  "netlist": "my_tb.spice",
  "nominal_supply_v": 3.3,
  "supply_tolerance": 0.1,
  "temperatures_c": [-40, 27, 125],
  "corners": ["cdac"],
  "analyses": ["op"],
  "params": {"iload": "10u"},
  "options": ["reltol=1e-5"],
  "measure": {"vref": "v(vref)", "iq_ua": "-i(vsup)*1e6"},
  "checks": {
    "vref": {
      "min": 1.15,
      "max": 1.25,
      "max_spread_pct": 2.0,
      "min_spread_pct_by_axis": {"process": 2.0}
    }
  },
  "evidence": {"record_kind": "corner-matrix"}
}
```

`claim` is the default for the record's **Claim** field — the ratified spec
line this experiment substantiates. `--claim` overrides it per run.

The netlist is a **fragment**, not a complete deck. It must not contain
`.include`, `.lib`, `.temp`, `.control`, `.endc` or `.end` — the harness owns
all of those, which is what lets one netlist sweep the whole grid unedited.
The loader rejects fragments that break this rule instead of silently pinning
every corner to 27 °C. The harness hands the fragment:

| Parameter | Value |
|---|---|
| `vdd_val` | supply for this PVT point |
| `vdd_nom` | nominal supply, for ratio measurements |
| `temp_c` | temperature for this PVT point (also applied via `.temp`) |
| `mim_cap_1f0` / `mim_cap_1f5` / `mim_cap_2f0` | CDAC unit-cap subckts, see below |

The PDK names its MIM subckts after the metal pair the capacitor sits between
(`cap_mim_2f0_m4m5_noshield`), which is a property of the **variant**, not of
the device. So no testbench in this repo names a metal stack: the harness
emits `mim_cap_<density>` wrapper subckts bound to the resolved variant's
stack (`MIM_STACK_BY_VARIANT` in `pdk.py`, derived from the PDK's own DRC
variant table). An unrecognised variant is a loud error, never a guessed
stack.

Those wrappers take `c_width`, `c_length` and `dtemp` (default 0). `dtemp` is
forwarded because `.temp` is global to a deck, so a temperature coefficient
cannot be measured *within* one PVT point without a per-instance temperature
offset — a tempco read off the grid's temperature axis is arithmetic a reader
performs on the record table, not a measured quantity a `checks` entry can
bound. `sim/device-cdac-cap/` uses `dtemp={125-temp_c}` and friends to pin
instances to absolute temperatures, and the grid's own temperature axis then
serves as the independent cross-check.

Each `measure` entry becomes `let m_<name> = <expr>` followed by `print` inside
the control block, so the expression must reduce to a **scalar**: fine for
`op`; for `tran`/`ac` reduce with `maximum()`, `mean()`, `v(out)[0]`, etc.
Note that manifest `params` become `.param` directives in *netlist* scope and
are **not** visible inside the `.control` block — write literals in `measure`
expressions.

### The `meas` result-precision floor

**A `meas` result is carried at ~6 significant digits, so a quantity read off a
node biased near mid-rail is quantized to ~1 µV before any `measure` expression
sees it.** On a 3.3 V design that floor is ~1 µV at a 1.65–1.7 V node and ~2 µV
at the rail. It is a property of the `meas` result, not of the solver:
`.options vntol`, `reltol` and `set numdgt` do **not** move it. Tightening
`vntol` buys solver accuracy; it buys no reported resolution.

This matters whenever a deck differences two large levels to extract a small
displacement — kickback, charge injection, droop, any "before minus after" on a
biased node. The symptom is unmistakable and worth grepping a record for: every
point reports an **exact integer** count of the floor step (…, −1, 0, +1, +2 µV
…) across the whole grid, and the corner log shows the two levels differing in
their last printed digit (`bp0 = 1.70000e+00`, `bp1 = 1.70001e+00`).

Rules:

- **Do not claim resolution below the floor**, and do not quote a
  floor-quantized quantity to more figures than the floor supports. State the
  result as a **bound** ("below the ±1 µV resolution of this measurement, which
  is N decades under the budget") rather than as a point value.
- **Do not "fix" it with `.options`.** If a deck needs the extra decades, `meas`
  a quantity that is *already small* — a behavioural node carrying the
  difference itself, referenced near 0 V — so the 6 significant digits land on
  the effect instead of on the bias point.
- Worked example and its correction: `sim/comparator-kickback/` and
  `spec/comparator-budget-memo.md` §5.2.

`checks` are evaluated after the sweep. Unknown keys and unknown axis names
are rejected at load time, because a silently-ignored `min_spread_pct` is the
exact failure this harness exists to catch:

| Key | Applies to | Meaning |
|---|---|---|
| `min` / `max` | every point | hard limit; failure names the offending corner-id |
| `max_spread_pct` | the grid | `(max−min)/\|mean\|` must stay under the limit |
| `min_spread_pct` | the grid | must *exceed* it — asserts the sweep really moved |
| `min_spread_pct_by_axis` | one named axis | the **weakest** slice must exceed it |
| `max_spread_pct_by_axis` | one named axis | the **strongest** slice must stay under it |

Axis names: `process`, `temperature`, `supply`.

### Evidence extensions

`sim/README.md` adds five ADC-specific field groups on top of the base record.
Declare them in the manifest's `evidence` block or pass them per run; both are
**validated** (`harness/evidence.py`), so a mistyped methodology tag is an
error rather than free text nobody notices:

| Group | Manifest keys / CLI flags |
|---|---|
| Dynamic-test (FFT) | `fft_n`, `fft_input_hz`, `fft_bin`, `fft_window`, `fft_fs_hz` |
| Linearity methodology | `linearity_method` (one of the four ratified tags) |
| Monte Carlo convention | `mc_seed`, `mc_scope`, `mc_sigma` |
| Noise methodology | `noise_method`, `noise_seed`, `noise_duration_justification` |
| Characterization variant | `record_kind: characterization` + `data_provenance` |

Rules the validator enforces, straight from `sim/README.md`: a
characterization record must carry `data_provenance`; a windowed FFT record
must say why coherent sampling was not used; a `transient-noise` record must
state its seed and justify its duration; a Monte Carlo record must state seed
handling, scope and sigma level together.

## What a run writes

One run mints one `<record-id>` (`<YYYYMMDD>-<HHMMSS>-<short-git-sha>`) and
writes, under `sim/<experiment-slug>/`:

| Path | Contents |
|---|---|
| `records/<record-id>.md` | the append-only summary record (the fields from `sim/README.md`, the per-axis sensitivity table, and an Environment section with PDK / MIM stack / ngspice / platform / hostname / full ngspice banner / observed front-end mode / harness / git provenance) |
| `netlist-snapshots/<record-id>.spice` | verbatim frozen copy of the testbench fragment, with its sha256 |
| `corners/<record-id>/<corner-id>.log` | raw ngspice output, one file per PVT point |

Nothing is ever overwritten: the runner refuses to write over an existing
record or snapshot, and mints a later record-id if one is somehow already
taken. Corrections and re-runs get a new record-id and reference the prior one
with `--supersedes <record-id>`. Do not edit or delete anything under
`records/`, `netlist-snapshots/` or `corners/` — see the append-only rule in
`sim/README.md`. (The repo's `.gitignore` has a blanket `*.log`; it explicitly
re-admits `sim/*/corners/*/*.log` so the evidence a record links to is
actually committed.)

A run taken against a dirty working tree says so in the record's **Netlist
provenance** field and is not citable as a clean-tree result.

Exit codes: `0` pass · `1` a check failed (or, for `--check-env`, a pinned
version drifted) · `2` a simulation failed or did not converge · `3`
environment problem (no ngspice, no PDK, unknown PDK variant, unpinned
toolchain drift, bad manifest, unjustified PVT subset, non-conforming evidence
fields).

Generated decks land in `sim/.work/<experiment-slug>/<record-id>/` and are
git-ignored, so a failing corner can be reproduced by hand with
`ngspice -b sim/.work/<slug>/<record-id>/<corner-id>.spice`.

On the `klt sim` batch path, the deck of every point that did not score `ok`
(error, timed out, failed) is also copied next to its committed log under
`corners/<record-id>/`, so the exact deck ngspice ran survives the disposable
`.work/` tree. `ok` points keep only the `.work/` copy.

## Re-running one manifest against a different (extracted) netlist

A post-layout re-run must measure **the same claim, the same way**, or the
schematic-vs-extracted delta is a delta between two measurement decks and not
between two circuits. So the harness does not want a second copy of the
manifest — it wants the same manifest pointed at a different netlist:

```bash
python3 sim/run_corners.py adc-inl-dnl \
    --netlist sim/adc-inl-dnl/testbench/tb_adc_inl_dnl_extracted.spice \
    --netlist-provenance "extracted (<what was extracted, and any remediation>)" \
    --corners tt ss ff --ngspice-threads 1 -j 6 --timeout 600 --supersedes <schematic-record-id>
```

### Correction: cap ngspice's own thread count instead of forcing `-j 1`

The subsection below (`-j 1 --timeout 1200`) is the original, and still
correct, diagnosis of the oversubscription hazard — read it first. But `-j 1`
is a **stronger fix than necessary**: it forecloses parallelism entirely to
avoid oversubscription, when `--ngspice-threads 1` (added after that section
was written) removes the oversubscription directly, by capping what each
`ngspice` point spins up rather than how many run concurrently. That leaves
`-j` free to scale with the host again.

Measured directly on this issue's `cdac`-set extracted re-run (63 points,
8-core host): a single point at `--ngspice-threads 1` is genuinely
single-threaded (**~71 s wall ≈ ~70 s user CPU**, a ~1.0× ratio, vs. the
~7.3× ratio the section below measures at the OpenMP default). At
`--ngspice-threads 1 -j 6` the full 63-point grid completed in **1100 s
wall** — no timeouts, no retries — against a naive extrapolation of the
`-j 1` guidance's own 27-point/2436 s figure to 63 points (~5680 s). That is
better than a 5× wall-time improvement from one flag, with **bit-identical
measured results** (per `--ngspice-threads`'s own `--help` text) because it
changes ngspice's internal scheduling, not the circuit or the analysis.

**"Bit-identical" is a claim about the measured values, not about the step
sequence** — the two come apart on stiff decks, and only the first of them
holds everywhere. Measured full-length on `sim/sar-logic-functional-gates`
(synthesized standard cells, `tran 20n 64500n`, issue #309): `num_threads=1`
and `num_threads=4` give all 16 `m_*` values identical to all ten printed
digits, while their accepted-timestep sequences diverge at the **2nd** accepted
timepoint and end 11590 against 11538 points. See the
`--save-measured-vectors` section below for the same distinction and the full
derivation.

**Updated guidance**: pass `--ngspice-threads 1` on every deck whose
single-point CPU/wall ratio is high (both extracted and schematic decks
qualify — see the timing rule two paragraphs below), then pick `-j` from the
host's core count as you normally would. Reserve bare `-j 1` (no
`--ngspice-threads`) for hosts where `--ngspice-threads` is unavailable
(pre-dates this flag) or when debugging a single point in isolation.

#### Pick `-j` from your CPU *quota*, not from `nproc`

"The host's core count" is the wrong input if the process is running under a
cgroup CPU quota — an agent session, a container, a CI runner. Check it
before sizing a grid, because the answer is not visible in `nproc`:

```bash
cat /sys/fs/cgroup"$(cut -d: -f3 /proc/self/cgroup)"/cpu.max   # "<quota> <period>"; "max" = unlimited
```

A value of `100000 100000` is a hard **1.0 CPU**, whatever `nproc` says. Under
a fixed quota `-j N` does not buy N-way throughput — it divides the same
quota N ways, so every point runs N times slower and none of them finish any
sooner. Measured on `sim/sar-logic-timing-gates` under exactly that quota:
`-j 5` gave each of five points 0.17–0.18 of a core, while the same work at
`-j 1` ran one point at ~0.9 of a core. **When the quota is 1.0 CPU and a
single point costs hours, run one point.** Corollary for a long deck: a
subset chosen for cost should be chosen as *which points*, never as "more
points, each slower".

…**but a cgroup quota is only one of the ways a host lies to you**, and the
corollary above does not survive a change of host class. Measured on an
18-core Apple M5 Max running the same deck (issue #303,
`sim/sar-logic-timing-gates/investigations/20260917-issue-303-five-loop-composition-cost.md`):
there is no cgroup, `nproc` says 18, `top` reports a steady **61 % idle** —
and a CPU-bound process still gets only **0.089–0.110 of a core**, with
`taskpolicy -B`, `taskpolicy -t 0 -l 0` and `nice` unable to move it. There
`-j` behaved the *opposite* way to the quota case: four concurrent ngspice
processes measured ~0.17 core each and sixteen measured ~0.13 each, i.e.
aggregate throughput rose from ~0.7 to ~2.1 cores as processes were added,
even though each individual point ran slower.

So do not port either rule between hosts — port the measurement. Before
sizing a grid, ask the host directly what a CPU-bound process gets:

```bash
python3 - <<'PY'
import time, os
t0 = time.time(); c0 = os.times()
while time.time() - t0 < 10: pass
c1 = os.times()
print('cpu_frac %.3f' % ((c1.user - c0.user) / (time.time() - t0)))
PY
```

Then repeat it with a candidate `-j` worth of load running. If the per-process
share holds up as processes are added, `-j` buys throughput; if it divides,
it does not. Neither `nproc`, nor load average, nor `cpu.max` answers that on
its own.

### When output *retention*, not CPU, is what stops a long run: `--save-measured-vectors`

The knob above is about CPU. On a long transient over a large deck the
binding constraint is often **memory**, and it fails much less legibly: by
default ngspice keeps *every* node voltage and branch current of the deck,
at every accepted timepoint, in RAM for the whole run — whether or not any
`meas` line reads it.

Measured on `sim/sar-logic-timing-gates/` (five synthesized ~181-cell DUT
instances sharing one clock, ~6300 output vectors), issue #303:

| | resident set | wall to a 0.25 µs truncation | accepted timepoints |
|---|---|---|---|
| default retention | 686 MB at 190 ns → 866 MB at 229 ns (**~4.6 MB per simulated ns**) | 708 s | 2574 |
| `--save-measured-vectors` | flat **~160 MiB** | 549 s | 2039 |

Extrapolated over that manifest's ratified `tran 5n 8.5u 0 5n`, the default
needs **~39 GB for one point** — so on a 15.7 GB host the ratified transient
cannot finish at all, at any `-j`, and a *grid* of concurrent points
exhausts RAM within the first simulated microsecond. The failure mode is
an OOM kill or a swap-death hours in, not a clean error, which is why this
is worth checking *before* a long grid rather than after.

**Buy this knob for memory, not for speed.** The 708 s → 549 s column above
looks like a 22% speed-up and is not one: the two runs took *different
numbers of accepted timepoints* (2574 against 2039), and per accepted
timepoint they cost 0.275 s and 0.269 s — the same to within 2%.

`--save-measured-vectors` emits an ngspice `save v(a) v(b) …` line naming
exactly the node voltages the manifest itself reads — both its `analyses`
lines and its `measure` expressions. It restricts **output**, not the
system: the solver is handed the identical network either way. What that
does *not* license is an assumption that the **accepted-timestep sequence** is
also invariant. Those are two separate claims, and they come apart on stiff
decks — so keep them apart when reading a record:

| deck | measured values, full A/B | accepted-timepoint counts |
|---|---|---|
| `sim/sar-logic-timing` (ideal XSPICE) | identical, 10/10 digits | **identical** (19/19) |
| `sim/cdac-bit-settling` (real PDK devices) | identical, 10/10 digits | **identical** (13/13) |
| `sim/sar-logic-functional-gates` (synthesized standard cells, full 64.5 µs) | identical, 10/10 digits, all 16 measurements | **differ**: 11589 (no save list) vs 11590 (save list) |
| `sim/sar-logic-timing-gates` (synthesized standard cells) | untested at full length — see below | **differ**: 2574 vs 2039 to the same 250 ns |

The same split holds for `--ngspice-threads` on the gate-level decks: 11590
vs 11538 accepted timepoints at `num_threads` 1 vs 4 on
`sar-logic-functional-gates` (same 16 identical measured values), and 2039 vs
4311 on `sar-logic-timing-gates`. On the gate-level class the divergence
starts at the **2nd or 3rd accepted timepoint** — i.e. essentially at once,
before the circuit has done anything — and the measurements still agree to
ten digits 64.5 µs later. Every such trajectory is a valid solution of the
same system within the solver's own tolerance; the perturbation lands in a
thresholded local-truncation-error comparison, not in the network.

**Practical consequence.** Both flags are safe to turn on or off without
invalidating a measured value, on every deck A/B'd so far including a
full-length gate-level one. They are *not* provenance you can vary when you
are reproducing a **step sequence** or comparing accepted-timepoint counts
between records — quote and match them for that. `sar-logic-timing-gates`
itself is still untested at full length (the only A/B there is the 0.25 µs
truncation above, which stops before every measurement window, so its
"identical" all-zero, partly `out of interval` `meas` output is vacuous rather
than reassuring); treat its values as reproducible to the solver's tolerance
until someone can afford two full-length points there.

Derivation and raw data: the full-length A/B is
`sim/sar-logic-functional-gates/investigations/20260918-issue-309-flag-measurement-neutrality.md`
(issue #309); the cost and truncated-probe work is
`sim/sar-logic-timing-gates/investigations/20260917-issue-303-transient-cost-and-retention.md`
(issue #303).

**Do not try to price either flag on a shared host.** Three concurrent
full-length `sar-logic-functional-gates` runs of measurably different work
(11589 / 11590 / 11538 accepted timepoints, at `num_threads` 1 / 1 / 4)
finished within **27 s of each other after 2 h 27 min**, and four concurrent
runs of the same 2×2 accrued CPU time equal to within 2.6 s out of 1082. The
scheduler equalises the share; wall time measures that, not the knob. Use the
per-accepted-timepoint normalisation instead (#303 Finding 3), which survives
contention.

It is **off by default**, so every deck composes byte-identically to before
the flag existed and no existing record's deck changes under it. It
**refuses** (exit `3`, before any point runs) on a manifest that references
a vector the save list cannot express — a differential `v(a,b)`, a branch
current `i(...)`, or a device parameter `@dev[param]` — rather than silently
omitting a vector a `meas` line needs; 9 of this repo's manifests are
refused on that rule today (`adc-power`, `comparator-preamp-noise`,
`comparator-regeneration`, `device-comparator-gm-id`, `device-switch-leakage`,
`device-switch-ron`, `dr0014-sampling`, `smoke-sar-bias`, `top-plate-cpar`)
and simply run at the default retention.

**Rule of thumb**: watch `ps -o rss= -C ngspice` for the first minute of any
new long-transient deck. If the resident set is climbing by tens of MB per
minute, work out where it lands at the manifest's own stop time before
committing a grid to it.

### KLU was evaluated for the gate-level decks and not adopted (no flag)

`ngspice-46` on this repo's hosts is compiled with the KLU direct linear
solver (`** Compiled with KLU Direct Linear Solver` in its own banner), but
every deck the harness generates uses the default, SPARSE 1.3. KLU is
normally faster than SPARSE for large, sparse, strongly asymmetric matrices
— exactly the shape of `sim/sar-logic-timing-gates/`'s synthesized
standard-cell deck, the one deck in this repo whose per-point cost actually
blocks a ratified grid (issue #303). That made it worth measuring — issue
#308.

**Measured, and not adopted.** On `sim/sar-logic-timing-gates/` at the same
0.25 µs truncation #303 used, KLU and SPARSE cost the same to within 0.6%
per accepted timepoint (user CPU time) — indistinguishable from noise on a
host shared with other agents' runs — and KLU's peak resident set was
slightly *higher*, not lower (174 MB against 169 MB). The wall-time gap
between the two runs (766 s → 672 s, 12%) is explained almost entirely by a
different number of accepted timesteps (2669 → 2357, 12% fewer), the exact
same false-positive shape `--save-measured-vectors` above turned out to
have on this deck. There is no measured reason to add a `--solver`/`--klu`
flag: it would add API surface for an effect too small to distinguish from
host contention, on the one deck that would need a genuine per-step win to
matter.

**Measurement-neutral, for what that is worth.** A full-length A/B on
`sim/sar-logic-timing` (ideal XSPICE, 18/18 accepted timepoints) and
`sim/cdac-bit-settling` (real gf180mcu devices, 11/11 accepted timepoints)
gives measured values identical to all ten printed digits under both
solvers, even though the two solvers pick *different* accepted-timestep
sequences to get there (expected: different factorisations of the same
tolerance-bounded problem). So switching solvers is safe on this repo's
testbenches; it is just not a fix for anything here. Full derivation:
`sim/sar-logic-timing-gates/investigations/20260918-issue-308-klu-solver-evaluation.md`.

If a future deck's profile differs enough that KLU's asymptotic advantage
over SPARSE actually shows up outside measurement noise, re-run this A/B on
that deck specifically rather than assuming this negative result transfers
— `option klu` inside the `.control` block (or `.options klu` at netlist
scope) is the confirmed ngspice-46 syntax, verified against
`src/spicelib/analysis/cktsopt.c`'s `OPT_KLU` handling and empirically
against this repo's own decks; see the investigation doc for exactly how to
inject it into a harness-generated deck.

### Run an extracted deck at `-j 1`, with a raised `--timeout`

`-j 1 --timeout 1200` above is **load-bearing, not a stylistic preference**, and
is the single most likely thing to waste an hour on this path.

`ngspice-46` is itself OpenMP-multithreaded and a single point of an extracted
deck already saturates the host: one point of `tb_adc_inl_dnl_extracted.spice`
measured **86 s wall / 628 s CPU on an 8-core machine**. `run_corners.py`'s
default `jobs = min(8, cpu_count)` therefore oversubscribes ~8× on a deck like
this. Total throughput is not merely unimproved — the wall time of *each* point
inflates past the default **300 s** per-point timeout and the whole grid fails
at once. A first attempt at the 27-point `tt/ss/ff` grid under the defaults
returned **0/27 points, every one `ngspice timed out after 300s`**, after 1200 s
of wall clock. The same grid at `-j 1 --timeout 1200` completes normally.

The schematic decks are ~10× smaller and so complete a *single* point much
faster in absolute terms, but **the same OpenMP oversubscription applies to
them too — smaller is not immune, just cheaper to hit.** A single point of
the schematic `adc-inl-dnl` deck (`tb_adc_inl_dnl.spice`, the `cdac`
corner-set baseline behind record `20260805-220405-bff6eaf`) measured **32 s
wall / 249 s CPU** standalone — a ~7.8× ratio, not materially better than the
extracted deck's ~7.3×. Confirmed directly: the same corner that converges in
34 s alone timed out past the default 300 s when run as one of four
concurrent points under `-j 4`. The rule of thumb is therefore **not**
"schematic decks are safe at higher `-j`" — it is: **any deck whose
single-point CPU time exceeds its wall time by more than ~2× is already
parallel, and `-j` above 1 will only take wall time away from it, regardless
of device count.** Time one point with `--corners tt --temps 27
--supply-tol 0 --no-write` before committing to a grid, on *every* deck, not
just extracted-netlist ones.

`--netlist` substitutes the fragment named by `tb.json` and re-validates the
substitute against the same forbidden-directive rule (a substituted netlist may
no more pin `.temp` or the supply than the manifest's own may). Everything else
— `analyses`, `measure`, `checks`, `evidence`, the claim — is the manifest's,
unmodified. **The substitute must therefore use the same net names** the
manifest's measure expressions read; generating it from the same source the
schematic deck is generated from is the way to guarantee that (see
`layout/adc-top/parasitics/gen_extracted_inl_dnl_tb.py`, which ports
`gen_adc_top.py`'s input ladder and shadow DAC rather than restating them).

`--netlist-provenance` is **mandatory** whenever `--netlist` is given: the
runner exits `3` rather than record a post-layout run under the manifest's
default `schematic` provenance. It accepts `schematic` or any string starting
with `extracted`; a testbench that is *always* run post-layout can instead
carry `"netlist_provenance": "extracted (...)"` in its own `tb.json`.

The extracted record appends **alongside** the schematic record in the same
experiment directory (`sim/README.md` → "Extracted vs schematic semantics"),
and the delta between the two is derived from the two committed records by

```bash
python3 sim/tools/schematic_vs_extracted.py adc-inl-dnl \
    --schematic <record-id> --extracted <record-id> [--only NAME ...]
```

so no number in a published delta table is transcribed by hand. The
project-level write-up that tool feeds is
[`sim/extracted-delta-summary.md`](../extracted-delta-summary.md).

### When the extraction cannot resolve a block boundary the schematic deck measured

Some manifests measure *per-block* quantities on separately-instantiated
sources. An extraction can merge those blocks: `sim/adc-power/` splits the
supply five ways (`vddc`/`vddd`/`vddt`/`vrefs`/`vcms`), but the drawn layout
has **one** supply rail, so the extracted `.SUBCKT ADC_TOP` exposes a single
`vdd` pin and `vddd` (CDAC bottom-plate drivers) and `vddt` (the top-plate
V_cm switch) cannot be told apart post-layout.

The rule when this happens: **coarsen the reported breakdown, never the
claim, and say so in the record.** The extracted deck still runs the
unmodified manifest — the merged block's whole current lands on one of the
two measure expressions and the other reads a construction-zero, so the
`p_total_*` spec-line row is unchanged. The comparison is then made
like-for-like by summing the *same* columns on *both* sides:

```bash
python3 sim/tools/schematic_vs_extracted.py adc-power \
    --schematic <record-id> --extracted <record-id> \
    --sum p_core_f050_uw=p_cdac_f050_uw+p_trk_f050_uw \
    --only p_core_f050_uw p_total_f050_uw
```

`--sum` accepts only a sum of bare column names and is applied identically to
both records, so it cannot be used to make two different quantities look
comparable. What it must **not** be used for is hiding the merge: the record
has to state which blocks merged and which column now reads zero by
construction, or a reader will read that zero as "this block draws no power".

## The repo testbenches

`sim/smoke-sar-bias/` and `sim/device-cdac-cap/` are the harness's own
acceptance tests, not circuit deliverables. Both are needed: sabotaging only
one hides the other.

**`smoke-sar-bias`** (`op`, `mos` corner set) — four independent branches:

1. an ideal resistor divider — its *ratio* must read exactly 0.5 at all 45
   points (the PVT-invariant control), while its *absolute* value must track
   the supply and nothing else;
2. a diode-connected `nfet_03v3` at a supply-independent 10 µA — proves the
   MOS `.lib` section and `.temp` both take effect;
3. an `nfet_03v3` sampling switch, gate at vdd, 50 mV across the channel —
   `Ron` moves with all three axes, so it is what the per-axis floors lean on;
4. a `ppolyf_u` poly resistor — proves the resistor sections load.

**`device-cdac-cap`** (`ac`, `cdac` corner set) — effective capacitance of the
MiM unit cap (2.0 / 1.5 / 1.0 fF/µm²) and the 3.3 V MOS cap, from a 1 MHz AC
probe, plus effective density vs unit size, voltage coefficient and (via
per-instance `dtemp`) temperature coefficient. This is the only thing in the
repo that exercises the `mimcap`/`moscap` sections, and it is written as a
**characterization** record (measured values + data provenance, no spec
pass/fail) because no ratified spec line exists yet.

### The device-characterization testbenches (#4)

Six further experiments produce the device numbers the CDAC, comparator and
switch design issues budget against. Their results are summarized, with
provenance and corner conditions per number, in
[`sim/device-characterization-report.md`](../device-characterization-report.md). They are ordinary
testbenches — nothing about them is special to the harness — but they are all
in `selftest.sh`'s `EXPERIMENTS` list, because a characterization record built
on a fake corner sweep would silently corrupt four downstream design efforts:

| Slug | Analysis / corner set | Answers |
|---|---|---|
| `device-switch-ron` | `op`, `mos` | R_on vs input level for NMOS / PMOS / T-gate, and which PVT corner is worst |
| `device-switch-charge-injection` | `tran`, `mos` | pedestal and its input-dependence onto a CDAC-plausible hold cap |
| `device-switch-leakage` | `op`, `mos` | off-state hold-node leakage, with null controls for junction leakage and for the deck's own numerical floor |
| `device-comparator-gm-id` | `op`, `mos` | gm/Id over three decades and constant-current V_th |
| `device-comparator-flicker-noise` | `noise`, `mos` | input-referred noise density and flicker corner at both `fnoicor` settings |
| `device-mismatch-mc` | `op` + Monte Carlo, `mos` | the Pelgrom A_Vt the PDK actually applies |

Two things these testbenches taught the harness, both preserved as comments in
the manifests concerned:

- **A per-axis floor on temperature or supply does not survive
  `--sabotage-corners`.** Sabotage forces the *model sections* to typical; the
  temperature and supply axes keep moving. Three of the six passed sabotage
  when first written for exactly that reason. Every one now carries a
  **process**-axis floor on at least one measurement.
- **`device-mismatch-mc` is the documented exception in kind**: its headline
  result (A_Vt) is corner-independent *by construction*, since `par_vth` lives
  in the `fets_mm` subckt rather than in any corner section. Rather than invent
  a floor its physics cannot support, it measures a subthreshold V_th proxy
  (`vgs_n_a_mv`) purely as a corner-sensitivity anchor, and asserts the
  corner-*invariance* of the sigma with a `max_spread_pct_by_axis` ceiling.

### `sim/smoke-sar-bias/` vs `sim/smoke_test/` — two different jobs

The repo has two things with "smoke" in the name. They are deliberately
distinct and neither replaces the other:

| | `sim/smoke_test/` | `sim/smoke-sar-bias/` |
|---|---|---|
| Question it answers | "is my *install* correct?" | "is the *harness* correct?" |
| Scope | one point (tt, 27 °C, nominal) | the full 45-point PVT grid, plus the negative control |
| Path exercised | xschem netlisting → `$PDK_ROOT/$PDK` shim → ngspice | `sim/run_corners.py` → corner shim → ngspice → record writer |
| Run it | `sim/smoke_test/run_smoke_test.sh` | `bash sim/selftest.sh` |
| Output | `sim/smoke_test/smoke_test.log` (evidence of an install) | an append-only record under `sim/smoke-sar-bias/records/` |
| Owns | `docs/environment-setup.md`'s acceptance step | this harness's acceptance criteria |

`sim/smoke_test/` is the first thing to run on a fresh machine. `sim/selftest.sh`
runs *after* that passes. A green `smoke_test` with a red `selftest.sh` means
the harness is broken; the reverse cannot happen, because the harness cannot
run without a working install.

## xschem

`design/xschemrc` resolves the PDK the same way the harness does and sources
the PDK's own xschemrc, so gf180mcu symbols and this repo's `design/`,
`design/symbols/` and every `sim/<experiment-slug>/testbench/` are all on the
library path:

```bash
source sim/env.sh
cd design && xschem
```

Schematic netlists are written to `design/netlist/`. To simulate a schematic,
strip it to a fragment (or netlist a testbench schematic without its
`.control`/`.end` block) and point a `tb.json` at it — the corner runner is
agnostic about whether the fragment was typed or generated.

Note: xschem itself is not required to run any of the above; the corner runner
only needs ngspice and the PDK.

## Divergences from the gf180-bandgap pattern

Per `CLAUDE.md`, this harness is **ported from `2AMLogic/gf180-bandgap`**
(commit `58024be`) rather than designed from scratch. Module layout, PDK
resolution, deck composition, manifest schema, record-id scheme and the
append-only writer are kept identical so a future upstream reconciliation is
cheap. `sim/README.md` records the same provenance for the record format
itself, and this list is the harness-side companion to it. Nothing below is a
silent fork.

1. **Capacitor-dominated corners replace the bandgap's BJT/resistor ones.**
   Upstream adds `res_*` and `bjt_*` corners because a bandgap rides on
   resistor rho and BJT Is/beta. A SAR ADC has no BJT and rides on the CDAC,
   so this repo adds `cap_ff/ss`, `mim_ff/ss`, `moscap_ff/ss` and a `cdac`
   corner set, and keeps `res_*` for the bias/reference network. The
   six-family bundle structure is unchanged.
2. **Per-axis sensitivity checks (`*_spread_pct_by_axis`) are new.** Upstream
   has only the grid-wide `min_spread_pct`, which passes when one axis is
   stuck. See "Corner-sensitivity" above for why that is not sufficient here.
3. **`--sabotage-corners` and `sim/selftest.sh` stage 4 are new.** Upstream's
   self-test verifies the harness runs; it does not verify that corner
   switching is detectable when it breaks.
4. **The evidence writer implements `sim/README.md`'s five ADC extension
   groups** (`harness/evidence.py`), which have no upstream equivalent, and
   validates them. Upstream's writer knows only the base fields — and
   upstream's own harness PR had to be reworked because it was built before
   its record format was ratified. Building the extensions in from the start
   is the direct lesson from that.
5. **MIM subckts are bound to the PDK variant** (`MIM_STACK_BY_VARIANT`,
   `mim_cap_*` wrapper subckts). Upstream has no CDAC and never instantiates a
   MIM cap, so it has no equivalent.
6. **Manifest validation is stricter**: unknown `checks` keys and unknown axis
   names are rejected at load time.
7. **Testbench names differ** (`smoke-sar-bias` / `device-cdac-cap` vs
   upstream's `smoke-bias`), because the acceptance circuits are ADC devices.
8. **The toolchain is pinned and enforced** (`sim/toolchain.json`,
   `harness/toolchain.py`, `--allow-toolchain-drift`). Upstream records the
   versions it found in each record but does not check them, so a PDK bump
   silently changes every subsequent result. See "Pinned versions are checked"
   above.

A formal `spec/` decision record for these divergences is deferred to #6,
which lands the decision-record template this repo does not yet have; until
then this section is the authoritative list.
