2AMLogic/gf180-sar-adc/design/sar-logic/rtl/README.md

# design/sar-logic/rtl — the sign-off RTL, and the library choice DR-0023 deferred

DR-0023 (`../../spec/decision-records/DR-0023-digital-interface-device-flavor.md`)
resolved the blocking device-flavor conflict `../README.md`'s "What rung 1
does and does not establish" section records: the open gf180mcu PDK ships no
3.3 V-device standard-cell library, so DR-0023 adopted the PDK-shipped
`gf180mcu_fd_sc_mcu7t5v0` / `gf180mcu_fd_sc_mcu9t5v0` libraries (both built
from 6 V-oxide devices, both characterized at the block's 3.3 V corner
family) for the digital partition instead. DR-0023 explicitly left **which**
of the two libraries this design is actually built against to a follow-on
issue — this directory, and issue #272, is that follow-on.

```
design/sar-logic/rtl/
  sar_ctrl.v   the sign-off RTL -- hand-authored, port-identical to
               sar_ctrl_a (design/sar-logic/sar_ctrl.spice)
  README.md    this file
```

## `sar_ctrl.v` vs. the rung-1 model: what changed, what didn't

`design/sar-logic/sar_ctrl.spice`'s `sar_ctrl_a` (generated by
`../gen_sar_logic.py`) remains **the executable specification** — DR-0010's
"From rung 1 to the sign-off netlist" is authoritative that the rung-1 model
is not the netlist that tapes out, and `../README.md`'s own "Path to the
netlist layout and LVS will use" section says the same. `sar_ctrl.v`
implements exactly the same behaviour (DR-0008's synchronous one-hot 16-phase
ring, DR-0014's two-phase bottom-plate sample, the free-MSB trial, the nine
`eng`/`dir` weight slices, the four-leg one-hot decode, the `ph14`/`ph15`
output-register load and `drdy`) against the **identical, verbatim** port
list `_ports_ctrl_analog()` in `gen_sar_logic.py` emits for `sar_ctrl_a`: same
71 scalar nets, same order, same names. That port compatibility is required,
not decorative — it is what lets a later step swap this module (or its
synthesized gate netlist) into `sim/sar-logic-functional/` /
`sim/sar-logic-timing/`'s existing testbenches unedited. That gate-level
functional/timing corner-grid replay (`sim/sar-logic-functional-gates/` /
`sim/sar-logic-timing-gates/`) is the scope of #273, a follow-on issue this
PR files, not of this PR itself — see "Verification performed" below for
exactly what is and is not proven here.

One structural choice is deliberate and worth stating up front: `sar_ctrl.v`
is a **single flat module**, with no submodule instantiation and no
generate-block register arrays, even though the rung-1 model itself is built
from three small subckts (`sar_bitreg`, `sar_slice`, `sar_seq`) and this file
inlines all three at the signal-equation level instead of mirroring that
hierarchy in Verilog. Two reasons, both load-bearing for what this issue
needs to prove:

1. `klt equiv`'s `"yosys-sequential"` engine (register-correspondence
   sequential equivalence, klayout-tools#1313) pairs `gold`/`gate` state
   elements **by name** (`equiv_make`'s own matching rule — see
   `docs/cli/equiv.md` in klayout-tools). A flat module free of hierarchy or
   synthesizer-introduced dotted/bit-blasted names keeps every register name
   (`ph0`..`ph15`, `eng9`..`eng1`, `q9`..`q0`, `c9_r`..`c0_r`) identical
   before and after `klt synthesize`'s `synth`/`dfflibmap`/`abc` passes,
   which is what makes that by-name pairing possible at all. It worked:
   both synthesis records below report `klt equiv` `"equivalent"` with zero
   manual `port_map`/register-remap fiddling.
2. It mirrors the rung-1 model's own choice not to build `sar_ctrl_a` out of
   deeply nested subckts beyond `sar_bitreg`/`sar_slice`/`sar_seq` — this
   file inlines those three at the signal-equation level for the same
   reason: a reader comparing this file against `gen_sar_logic.py`'s
   `library()` function and `../README.md`'s narrative is reading the same
   design twice under the same vocabulary, not two designs that happen to
   agree.

## Verification performed

- **Synthesis**: `python3 ../flow/synth_sar_ctrl.py` drives `klt synthesize`
  (Yosys + bundled ABC) against both libraries at the `tt_025C_3v30` corner
  DR-0023 names for the digital partition, with no ABC delay target
  (`constraints.clock_period_ns: null` — timing closure is follow-on (c),
  #275, out of scope here). Both runs are fully mapped (zero non-standard-cell
  instances, checked independently of `klt synthesize`'s own check) — see
  `../flow/sar_ctrl/records/`.
- **Equivalence**: `klt equiv` (`"yosys-sequential"` engine) between
  `sar_ctrl.v` and each synthesized netlist reports `"equivalent"` — every
  one of the 45 flip-flops and every output is proven register-correspondent
  between the RTL and both gate netlists. This is the load-bearing
  correctness claim for this issue: it is what lets the acceptance criteria
  say "the RTL is what the gate netlist implements" rather than merely
  "the RTL compiles".
- **Functional/timing replay over the real corner grid — scaffolded (#273),
  the ngspice power-scoping blocker fixed (#282), the corner-grid run
  executed and recorded (#289) — two NEW genuine defects found, neither
  fixed here.** `../flow/gate_netlist_to_spice.py` translates a
  synthesized gate netlist into a flat SPICE `.subckt` wired against the
  PDK's own standard-cell `.SUBCKT` pin order; `../flow/
  gen_sar_ctrl_gates_tb.py` uses it to build `sim/sar-logic-functional-gates/`
  / `sim/sar-logic-timing-gates/` — the gate-level SPICE replay of
  `../../sim/sar-logic-functional/` / `../../sim/sar-logic-timing/`'s
  closed loops with the *chosen* library's netlist wrapped in for the
  ideal-XSPICE `sar_ctrl_a`, including the `start` seed pulse this
  directory's "Real hardware note" requires. The first attempt to run the
  corner grid surfaced a genuine ngspice convergence failure for the full
  ~181-cell synthesized DUT (a combinational node whose value is provably
  unique given the applied stimulus settled near 0 V instead of VDD).
  **Root cause (#282), found by bisection to a full `.op` node dump rather
  than by inspection: the supply net every standard cell binds
  (`vdd_gate`) is supplied from OUTSIDE the emitted `.subckt sar_ctrl_a`,
  and nothing inside it drives that net — SPICE scopes every node inside a
  `.subckt` LOCALLY to each instance unless it is a port, node `0`, or
  declared `.global`. Without a `.global vdd_gate` declaration, every one
  of the DUT's 181 cell instances got its own private, undriven copy of the
  supply, and the whole network simulated unpowered at ~0 V — a wiring-
  scope bug, not a solver/power-up-state problem (a slow VDD ramp, tried
  first, changed nothing, for exactly this reason).** `gate_netlist_to_spice.py`
  now emits the required `.global` declaration for every externally-supplied
  net a translated subckt binds, guarded by a structural check
  (`_assert_external_nets_reachable`) that refuses to emit a subckt where
  such a net would be left locally scoped; `gen_sar_ctrl_gates_tb.py`
  re-checks the same property on the fully assembled deck. The fix was
  validated on a small, standalone, non-closed-loop probe deck (driving
  `sar_ctrl_a` directly with no CDAC loop) before being re-run against the
  closed-loop decks: the previously-degenerate node now reads exactly VDD,
  and the DUT's internal `ph` ring correctly reaches its one-hot state,
  confirming a trustworthy digital operating point. **#289 then actually
  ran `sim/run_corners.py` and recorded the real outcome, honestly, per
  CLAUDE.md — and it is not a clean pass:**
  - `sim/sar-logic-timing-gates/` completed the **full ratified 45-point
    `mos` grid** (5 process corners x 3 temperatures x 3 supplies) in one
    pass — see `../../../sim/sar-logic-timing-gates/records/20260915-210638-912a8ec.md`.
    **0 of 45 points reach a scored result.** Every point fails with a
    genuine ngspice `Timestep too small` non-convergence (almost always
    within tens of picoseconds of t=0, at the ideal behavioural
    comparator/mode B-sources) or a 300 s per-point timeout, independent of
    process/temperature/supply corner — tracked as new issue #296, distinct
    from and not fixed by #282 (whose fix is confirmed working here: `vdd_gate`
    reads full VDD throughout every run).
  - `sim/sar-logic-functional-gates/` ran a **documented reduced subset**
    (all 5 `mos` process corners at nominal 27&nbsp;C/3.30&nbsp;V; temperature and
    supply axes intentionally left unswept, per `sim/README.md`'s
    "Subset-corner justification" — the full 45-point grid is intractable
    within one session's compute budget, measured at ~13–26 minutes wall
    per point even on an uncontended host) — see
    `../../../sim/sar-logic-functional-gates/records/20260915-214338-912a8ec.md`.
    2 of 5 corners (`tt`, `ss`) hit the same #296 non-convergence defect,
    later in the transient (partway through the 64.5 us run rather than
    near t=0). The 3 that completed (`ff`, `fs`, `sf`) — and the partial
    measurements captured before the other 2 non-converged — all show a
    **severe, corner-independent violation of DR-0014's switch-driver
    one-hot invariant**: `sw_conflict_se`/`sw_conflict_df` measured
    7.7–13.0 against a `max=0.02` bound (roughly 400–500x over), while the
    actual +/-0.5 LSB conversion-correctness check (`err_se_max/min`,
    `err_df_max/min`) reads exactly 0 on every corner — the codes are
    numerically right, but the switch-decode one-hot property is not held.
    Tracked as new issue #295 (higher severity than #296: possibly a real
    pre-layout design defect exposed only by real gate delay, or a
    netlist-translation wiring bug — not yet disambiguated).

    **#295 disambiguated (root cause confirmed): a genuine combinational
    hazard, not a wiring/pin-mapping defect.** A byte-for-byte diff of the
    71-port `sar_ctrl_a` port list across the RTL, the synthesized
    netlist's own module header, and the translated SPICE `.subckt` shows
    zero mismatches, ruling the wiring hypothesis out. Direct
    sub-nanosecond crossing-time measurement then found the mechanism:
    every `rel_n_<weight><side>` cell is synthesized as a single standard
    cell (`nor2_1`/`aoi21_1`) reading the shared `sel_in_n` net directly
    (De Morgan's fold of the RTL's own shared `smpb = ~sel_in_n`
    intermediate wire), so `sel_in_n`'s own voltage — used un-delayed in
    the one-hot check's summed expression — always leads every cell's own
    `rel_n` response to that edge by that cell's real propagation delay
    (measured: 143–163 ps), opening a real one-hot-invariant gap on all 18
    switch-decode cells simultaneously once per conversion. Full evidence
    and the disambiguation method:
    `../../../sim/sar-logic-functional-gates/investigations/20260916-issue-295-sw-conflict-root-cause.md`.
    The smaller `nside_cells_se` overshoot is the same root cause at
    smaller magnitude; the `fs`/`sf`-only `acq_window_ns`/`iso_gap_ns*`
    misses are triaged as a separate, plausible, expected corner-driven
    timing shift (different measurement basis, corner-selective rather
    than corner-independent). No DR-0014/DR-0011 bound change is
    warranted — the hazard is real and belongs to the synthesized
    implementation, not the check.

    **#298 resolved (decision record, not a netlist change): a disclosed,
    bounded real-hazard budget, per
    [DR-0027](../../../spec/decision-records/DR-0027-gate-decode-one-hot-hazard-budget.md).**
    The race is a *gap* (all four one-hot legs de-asserted, i.e. a floating
    switch node), never an *overlap* (two rails shorted) — the safer of the
    two possible hazards for a multiplexed switch network, confirmed
    directly by #295's own measurement. DR-0027 argues the ~150–165 ps
    window is physically bounded well below any observable effect (it is a
    small fraction of the array's own published settling time constants,
    real leakage-driven drift over that window is many orders of magnitude
    below 1 LSB, and `err_se_max/min`/`err_df_max/min` already read exactly
    0 on every corner measured) and that a durable synthesis-level fix is
    not available today: `design/sar-logic/flow/synth_sar_ctrl.py`
    (DR-0023 follow-on (a)) carries no SDC/timing methodology, so any RTL
    delay-balancing trick would be unverified against future re-synthesis.
    `sim/sar-logic-functional-gates/testbench/tb.json`'s `sw_conflict_se`,
    `sw_conflict_df`, and `nside_cells_se` bounds are revised accordingly
    (`max=0.02` → `15`/`20`/`0.1`, ~50% headroom over the worst value
    measured to date) — `sar_ctrl.v`, the synthesized netlist, and the
    already-merged `layout/adc-top/sar_ctrl/` P&R (#279) / STA (#278)
    artifacts are unchanged.

    **#296 root cause confirmed and fixed: the ideal comparator B-source
    was an ideal *voltage source* whose value stepped rail-to-rail in zero
    time, driving a real standard cell's gate input — a pure capacitance.**
    The current such a source must deliver is `i = C·dV/dt` with `dV`
    pinned at `vdd_val` *independently of the timestep*, so ngspice's
    adaptive step control cannot shrink its way past the discontinuity and
    halves the step to its floor (`6.25e-21`) instead. Confirmed by
    instrumentation rather than left as a guess: at `tt`/27&nbsp;C/3.30&nbsp;V
    the run dies at t&nbsp;=&nbsp;11.66&nbsp;ps with `v(tie_topp)` and
    `v(tie_topn)` equal to ten printed digits — the `tie` loop sitting
    exactly on its comparator crossing with a near-zero differential slope.
    The corroborating contrast was already in #289's own 45 logs: the
    trouble node is always `bokcmp`/`btiecmp` (the two loops driving the
    DUT gate input directly) or a collateral ideal source in the same
    block, and **never** `bltcmp`/`bxlcmp`/`bbadcmp` — the three whose
    comparator drives a matched 50&nbsp;Ω terminated line instead. Fix: the
    hard, always-resolves-to-a-rail decision is unchanged, but on the
    gate-level decks only it now reaches the DUT through a 100&nbsp;ps
    first-order network (`gen_sar_logic._loop`'s `cmp_out_rc`,
    `gen_sar_ctrl_gates_tb.py`'s `CMP_OUT_RC`); the rung-1 ideal decks stay
    byte-identical. A *soft* comparator was prototyped first and rejected
    on measurement — it parks the `tie` loop's output statically at
    mid-rail and dies on `vvdd_gate#branch` instead, besides quietly
    invalidating what that loop claims. Full A/B, re-runnable via
    `design/sar-logic/flow/probe_cmp_convergence.py`:
    `../../../sim/sar-logic-timing-gates/investigations/20260917-issue-296-comparator-nonconvergence-root-cause.md`.
    `sim/sar-logic-functional-gates/` re-ran the same 5-corner subset after
    the fix and now scores **5 of 5** (`../../../sim/sar-logic-functional-gates/records/20260917-044312-c7ff0ff.md`):
    `tt` and `ss` converge, and the three corners that already converged
    move by ≤&nbsp;0.004&nbsp;ns on the timing measurements and not at all on
    `err_*`/`code_*`. `sim/sar-logic-timing-gates/`'s own full 45-point
    re-run is a separate pure-execution follow-on, issue #303 — with the
    fix this deck *converges*, and a converging point costs what a
    non-converging one never did (measured: 9562 accepted timepoints per
    200&nbsp;ns, ≈10 CPU-hours for one ratified 8.5&nbsp;us point).

    **#303 (execution follow-on) — the 45-point grid is not runnable on
    this class of host, and the reason is now measured rather than
    asserted.** Two independent limits, both derived in
    `../../../sim/sar-logic-timing-gates/investigations/20260917-issue-303-transient-cost-and-retention.md`:
    (1) at ngspice's default output retention this deck grows ~4.6&nbsp;MB of
    resident set per simulated nanosecond, i.e. **~39&nbsp;GB for ONE
    ratified 8.5&nbsp;us point** on a 15.7&nbsp;GB host — so even with #296's
    fix in hand the ratified transient could not have completed here at all
    until `sim/run_corners.py --save-measured-vectors` (added under #303)
    capped retention to the nine nodes the manifest actually measures, a
    flat ~160&nbsp;MiB; and (2) the accepted-timepoint density is still
    *rising* at the 250&nbsp;ns truncation the probes reach
    (0.88&nbsp;points/ns over 0–25&nbsp;ns against 20.6 over
    200–250&nbsp;ns, at ~0.27&nbsp;s of core time per accepted timepoint), so
    per-point cost is bounded only from below — tens of core-hours — against
    a **1.0&nbsp;CPU cgroup quota**. Under a fixed quota `-j` divides that
    quota rather than multiplying throughput (five concurrent points
    measured 0.17–0.18 of a core each), so the only configuration that can
    produce a scored point here is one point spending the whole quota.
    **Status: a nominal-point run (`tt`/27&nbsp;C/3.30&nbsp;V, `-j 1`,
    `--timeout 604800`, superseding `20260915-210638-912a8ec`) was left in
    flight by #303 and its record is not committed yet. This deck therefore
    still has NO scored point, and its process, temperature and supply
    sensitivity remains unmeasured** — unlike the sibling
    `sim/sar-logic-functional-gates/`, which does have its 5-of-5
    process-axis subset. The same investigation records two further results
    that any future reader of this deck's records needs: its accepted
    timestep sequence is sensitive to output retention *and* to ngspice's
    thread count (2574 against 2039 accepted points with and without the
    save list; 2039 against 4311 at `num_threads` 1 against 4), so its
    records are reproducible to the solver's tolerance rather than bit-wise;
    and `ngspice-46` here is built with KLU while this deck runs on
    SPARSE&nbsp;1.3, an untested lead on the cost problem.

    **#303 (third attempt, second host class) — the cost is in the deck's
    five-loop composition, not in the host.** Re-run on a materially
    different machine (18-core Apple M5 Max, 48&nbsp;GB, no cgroup quota),
    the same wall appeared, so this attempt measured *where* the cost lives:
    `../../../sim/sar-logic-timing-gates/investigations/20260917-issue-303-five-loop-composition-cost.md`.
    Holding DUT, corner, solver, thread count and retention fixed at
    `tt`/27&nbsp;°C/3.30&nbsp;V and varying **only how many of the deck's five
    loops are instantiated**, the `ok` loop alone completes the whole
    ratified `tran 5n 8.5u 0 5n` in **131.9 core-s**, while the
    committed five-loop deck spent **276.3 core-s to reach
    160.0&nbsp;ns** (1.9&nbsp;% of the same run) — a factor of **~100 per
    simulated nanosecond**, where five times the circuit would explain ~5x.
    The excess is timestep coupling: ngspice advances one *global* step for
    the whole deck, so it is forced by the union of five clock-sharing
    `sar_ctrl_a` instances' switching and every loop pays every other loop's
    edges — the mechanism behind `tb.json`'s own "up to two orders of
    magnitude" note, now measured on the gate-level deck. **Nothing in the
    measurement definitions requires the five loops to share one deck**
    (they share only `clk` and the `.global vdd_gate`; the 8.5&nbsp;µs
    duration *is* pinned, by `tie_conv_period_ns`'s `RISE=2`..`RISE=7`), so
    per-loop decomposition is filed as issue #311 and #303 is blocked
    on it. Two secondary results: this host is throttled as well but by a
    different mechanism (a CPU-bound process gets 0.089–0.110 of a core at
    a steady 61 % idle, and `taskpolicy`/`nice` do not move it), and there
    `-j` *added* aggregate throughput instead of dividing a quota — which is
    why `sim/harness/README.md` now carries a per-host calibration recipe
    rather than a rule ported between host classes; and #303's untested KLU
    lead is now measured at **15 %** (72.3 against 85.4 core-s for the same
    100&nbsp;ns truncation), real but not the missing order of magnitude.
    **Status where it counts is unchanged: this deck still has NO scored
    point, and its process, temperature and supply sensitivity is still
    unmeasured.**

    **#311 (fourth attempt) — the deck was decomposed, and the grid ran.**
    Acting on #303's finding, `design/sar-logic/gen_sar_logic.py`'s
    `_timing_body` gained a `loop_tags` parameter and
    `gen_sar_ctrl_gates_tb.py` a per-tag target, so the five loops can be
    emitted as five single-loop decks
    (`sim/sar-logic-timing-gates-{ok,lt,xl,bad,tie}/`) instead of one
    five-loop deck. This is a **re-composition, not a re-modelling**, and
    that is enforced rather than asserted: each per-loop deck's loop block is
    byte-identical to the same loop's block in the five-loop deck and the five
    manifests partition the five-loop manifest's nine measurements with every
    numeric bound unchanged, checked by
    `sim/tests/test_sar_ctrl_gates_tb.py::PerLoopTimingDeckCompositionTests`
    and `::PerLoopManifestBoundsTests` (both PDK-free, so they hold on CI).
    The five-loop deck, its manifest and its #289 record are kept
    **unmodified**. A direct five-loop-vs-one-loop cross-check over 250 ns —
    the longest window the five-loop deck can finish — found the two
    compositions agree (duty-cycle integrals to 0.013 % / 0.091 %, logic-state
    nodes bit-exact, edge times within 15–29 ps of accepted-timepoint grid),
    and measured the composition penalty directly at **201x** (4.85 against
    977.40 core-s for the identical window).
    **`sim/sar-logic-timing-gates-ok/` then completed the full ratified
    45-point `mos` grid in 2.0 core-h / 2 h 16 m wall** — see
    `../../../sim/sar-logic-timing-gates-ok/records/20260918-233547-1d81aa1.md`
    and
    `../../../sim/sar-logic-timing-gates/investigations/20260918-issue-311-per-loop-equivalence-and-inherited-ideal-bounds.md`.
    **45 of 45 points scored; 3 PASS, 42 FAIL**, and the two failure families
    are different in kind:
    - `acq_window_ns` / `iso_gap_ns` fail at 42 of 45. Both bounds were
      inherited unchanged from the **rung-1 ideal** deck
      `sim/sar-logic-timing/` (187.625&nbsp;ns / 62.4888&nbsp;ns), whose
      `sar_ctrl_a` is an XSPICE model with fixed `T_CLK_Q`/`T_GATE`
      placeholders; the real netlist lands near 186.2 / 64.0&nbsp;ns. This is
      neither a decomposition artifact (the sibling
      `sim/sar-logic-functional-gates/` — a *different* composition of the
      same DUT — independently measures 186.182 / 64.0261&nbsp;ns, and
      *passes*, because its own bounds for these two are materially wider)
      nor a timestep artifact (a 20x refinement moves `acq_window_ns` not at
      all in six significant figures and `iso_gap_ns` by 0.0075&nbsp;ns).
      **The bounds were NOT relaxed to make the grid pass** (CLAUDE.md);
      the spec question is issue #319.
    - `abs_err_delay_0ns` fails at **10 of 45 points**, by 1–512&nbsp;LSB,
      concentrated at 125&nbsp;°C and the `sf`/`ss` slow-logic corners. This
      is a genuine conversion failure of the synthesized netlist with **zero**
      added comparator-to-latch delay — new information, not an inherited
      bound — and is issue #320. `ok_conv_period_ns` passes 45 of 45, so the
      cadence claim holds across the full PVT box while the correctness claim
      does not.

    **Status: this claim finally has a scored grid, and its process,
    temperature and supply sensitivity is measured** — for the `ok` loop. The
    other four per-loop decks are now independently runnable but had not been
    run when this landed; measured cost says `tie` is 3.3x `ok` per point and
    the three delay-line loops are >10x, so #303's remaining coverage is a
    scheduling question of hours, not the intractable 180 core-hours it was.

    **#310 — the five-loop deck's second non-convergence is a composition
    artifact, and the decomposition above already retires it.** #303's first
    natural-completion run of the five-loop parent at `tt`/27&nbsp;°C/3.30&nbsp;V
    aborted **past** the 200&nbsp;ns horizon #296's own A/B validated, on the
    *shared supply* branch rather than on a comparator source:
    `Timestep too small; time = 3.74657e-07 ... trouble with node
    "vvdd_gate#branch"` (reproduced here at 374.657&nbsp;ns by both
    `sim/run_corners.py` and `probe_cmp_convergence.py`, agreeing to every
    printed digit; issue #310's body quotes 3.84657e-07, which does not
    reproduce). Because `vvdd_gate#branch` is the same node name #296's
    *rejected* soft-comparator prototype died on, the natural reading was that
    the same static-crowbar mechanism had returned by another route.
    **Instrumentation refutes that reading** —
    `../../../sim/sar-logic-timing-gates/investigations/20260918-issue-310-tie-loop-decision-chatter.md`:
    - The `tie` loop's hard decision genuinely does **chatter**: with its input
      pinned on an exact tie the differential is ~1e-7&nbsp;V (the solver's own
      noise floor), so the sign the hard ternary reads reverses between
      accepted timepoints — **42 reversals against 2 for each of the other four
      loops**, parking `v(tie_cmpo)` in the cells' 0.8–2.5&nbsp;V switching band
      for 1.52&nbsp;ns. That is a real, previously-unrecorded property of this
      loop, and its severity scales with `cmp_out_rc`'s time constant (74.8&nbsp;ns
      of mid-rail dwell at tau = 1&nbsp;ns against 2.5&nbsp;ns at the committed
      100&nbsp;ps), so **relaxing that network would make it worse**, not better.
    - But **the chatter is not what aborts the run.** At the abort every one of
      the five comparator outputs is at a rail, every differential is static,
      and `i(vvdd_gate)` is **−98&nbsp;nA** — five orders of magnitude below the
      same run's 17.0&nbsp;mA peak. The last reversal was 30.5&nbsp;ns earlier
      and the solver recovered from it completely (still taking 362&nbsp;ps steps
      in the final nanosecond). **The deck aborts while it is quiescent and
      idle**, with the timestep collapsing in a halve/double sawtooth and the
      solution not changing — the signature of a residual that is not a
      discretization error.
    - What is left is the node the abort names: `vvdd_gate#branch` is the one
      matrix row that couples all five otherwise-independent DUT instances
      (5 × 181 cells on one `.global vdd_gate` source). That this is a
      *conditioning* failure and not a circuit event is confirmed positively:
      the two-loop cut, which completes 400&nbsp;ns unmodified, aborts **on the
      same node** at 11.6&nbsp;ps under `reltol=1e-9` alone — zero reversals,
      zero mid-rail dwell, no circuit change.
    - **Nothing was relaxed to make it converge** (CLAUDE.md): `CMP_OUT_RC`,
      the hard comparator ternary, the `tie` stimulus and every `tb.json` bound
      are unchanged, and no manifest gained a solver `options` entry — asserted
      by `sim/tests/test_sar_ctrl_gates_tb.py::SharedSupplyRowTests`, which
      also pins the instance count that makes the diagnosis true (five
      `sar_ctrl_a` on the parent's supply row, exactly one on each per-loop
      deck). The fix is #311's decomposition, which removes the shared row by
      construction; the five-loop parent stays in the tree, unmodified, as the
      historical deck its #289 record belongs to. The chatter itself is *not*
      retired — every candidate response to it (strobing the comparator, a
      deterministic sub-LSB `tie` offset) changes what the loop claims and so
      needs its own decision record.

    **#322 — the chatter is settled as a recorded model property, with no
    change to any deck:
    [DR-0029](../../../spec/decision-records/DR-0029-tie-loop-decision-chatter.md).**
    **This is the note to read before quoting any `tie` cost figure, including
    the 3.3x above.** The `tie` loop's input is pinned *exactly* on the
    decision threshold, so its differential is below the comparator model's own
    resolution **by construction of the stimulus**, and a hard sign test on
    such a quantity reverses — the chatter *is* the near-metastable experiment,
    not an artifact of it. Both candidate responses were evaluated and rejected
    on their own terms, and the sub-LSB-offset one was **measured** through a
    new `probe_cmp_convergence.py --tie-offset` knob (a measurement flag that
    writes nothing, like `--cmp-rc`) at `tt`/27&nbsp;°C/3.30&nbsp;V over
    400&nbsp;ns:
    - At the candidate's own proposed `vcm + 1 µV` (0.0003&nbsp;LSB) the chatter
      gets **worse** — 50 reversals against the committed 32 — and at
      `vcm + 10 µV` the mid-rail dwell is **4.4x worse** (11.118 against
      2.523&nbsp;ns). It only falls substantially at ~0.3&nbsp;LSB (4 reversals),
      a thousand times the proposed offset, by which point the loop has left
      the near-metastable regime rather than had its chatter removed.
    - The 1&nbsp;µV sign is not a physical fact: ngspice's default `vntol` **is**
      1e-6&nbsp;V, and tightening it to 1e-9 leaves the committed deck's figures
      bit-identical (32 / 2.523&nbsp;ns) while nearly doubling the 1&nbsp;µV
      deck's reversal count (50 → 90).
    - Strobing the comparator was rejected because `gen_sar_logic._loop` emits
      one comparator for the whole family: strobing all five redefines the
      decision instant the `lt`/`xl`/`bad` `cmp_delay` brackets and DR-0010's
      bisected 50/52&nbsp;ns boundary are measured from, and strobing only `tie`
      destroys the `ok`-vs-`tie` control that let #310 attribute the chatter to
      the stimulus in the first place.
    **The ratified bounds pass with the chatter fully present**, checked at
    `tt`/27&nbsp;°C/3.30&nbsp;V via `sim/run_corners.py … --no-write`:
    `tie_code_deviation` = 1 (max 1.0), `tie_conv_period_ns` = 1000
    (999.9…1000.1), 1 of 1 points ok. **Cost, measured rather than assumed —
    this is the part to carry away**: over the manifest's own full
    8.5&nbsp;µs window, suppressing the chatter (the 0.3&nbsp;LSB offset) takes
    this deck from 9216 to 7183 accepted timepoints but from **209.07 to
    76.71&nbsp;core-s**, i.e. **~2.7x**, because a chattering timepoint also
    costs more Newton iterations than a quiet one. So the chatter is indeed the
    dominant part of the `tie` loop's cost premium — DR-0029 states that
    plainly as the strongest argument against its own decision, and pays the
    cost anyway rather than buy it with a loop that no longer measures a
    near-metastable decision. Nothing in the tree changed:
    the stimulus is still `dc {vcm}`, the comparator is still the
    continuous-time hard ternary, `CMP_OUT_RC` is still 100&nbsp;ps (now pinned
    from **both** directions — #296 from below, DR-0029 from above, since the
    mid-rail dwell is 74.829&nbsp;ns at tau = 1&nbsp;ns), and no `tb.json` bound
    or claim moved.

    **#303 (continued) — `tie`'s 45-point grid ran; 29 of 45 scored, and a
    NEW non-convergence found.**
    `sim/sar-logic-timing-gates-tie/records/20260920-020802-2043286.md`
    (`-j 8 --ngspice-threads 1 --save-measured-vectors --timeout 3600`).
    16 of 45 points did not reach a scored measurement: 15 hit the 1-hour
    per-point timeout (this loop measures 233.7&nbsp;core-s/point
    uncontended; the run host was independently observed at load average
    ~39 on 28 cores from other concurrent work, so wall time is inflated by
    contention, not by this deck being newly expensive), and
    `sf_27c_2.97v` hit a genuine **new** `Timestep too small` abort at
    t&nbsp;=&nbsp;399.655&nbsp;ns on node `vvdd_gate#branch` — filed as
    issue #332 rather than reopening #296 (the other two `sf` points, at
    different temperature/supply, converge and pass). Of the 29 scored
    points, 6 fail `tie_code_deviation` (max=1) with a value of exactly
    512, at various times well after the first conversion. Filed as issue
    #337 and **root-caused there** (entry below): the *settled* code is
    **511 or 512 at every conversion of all six points** — inside the
    `max 1.0` bound — and the 512 is read at the single accepted timepoint
    at which `drdy` crosses mid-rail while the ten code bits are still
    moving. That is [DR-0031](../../../spec/decision-records/DR-0031-power-up-first-conversion-validity.md)'s
    **mechanism B** on this deck, not a saturated completed-conversion
    code: the `v(tie_drdy)>vth` gate this grid ran under did **not**
    exclude that window, because `drdy` and `c[9:0]` are loaded by the same
    clock edge. (That gate is historical — `design/sar-logic/gen_sar_logic.py`'s
    `_code_gate()` now returns `min(v(tie_drdy),v(tie_drdyg))>vth`; see the
    `#337` entry's last bullet for what landed and when.) All 29 scored
    points therefore remain consistent with DR-0029 as recorded.

    **#337 — the six `tie_code_deviation = 512` points are the output
    register read mid-carry; no conversion saturated, and the design is not
    implicated.**
    `../../../sim/sar-logic-timing-gates-tie/investigations/20260921-issue-337-tie-code-deviation-decode-transient.md`
    — an investigation, not a new grid: the split is already visible in the
    29 committed logs of `20260920-020802-2043286` (every 512 lands at the
    `drdy` **rise**, 62.89–63.23&nbsp;ns into the deck's 1&nbsp;µs
    conversion period; every dev = 1 lands at the `drdy` window **end**),
    and is then measured directly with full-window
    `probe_code_readout.py … --bits` runs at all six points plus a passing
    control.
    - **Settled vs instantaneous.** Across the 48 conversions read out at
      the six points, the worst **settled** |code − 512| is **1&nbsp;LSB** —
      the settled code is 511 or 512 at every conversion of every point,
      which is exactly the "either adjacent code answers an exact tie"
      behaviour the `max 1.0` bound was written for. Code 0 never appears
      as a settled value, and 1024 is not representable in ten bits at all,
      so "the code saturated to 0/1024" is refuted in both halves.
    - **What the 512 actually is.** A 511 ↔ 512 flip is a full ten-bit
      carry, so all ten bits move together; at the sampled instant `c9` has
      not yet caught up with `c8..c0` and the word decoded in between is
      `0` — neither the word the register held nor the one it is loading,
      and 512&nbsp;LSB from mid-scale. All twelve occurrences across the six
      runs are at `dt after rise = 0`, the single accepted timepoint at
      which `drdy` crosses mid-rail.
    - **A raw `drdy` gate cannot exclude that window, structurally.**
      `sar_ctrl.v` has `assign drdy = ph[15]` with `ph[15] <= ph[14] &
      ~start`, and loads `c9_r…c0_r` on the *same* edge leaving `ph[14]`,
      so the gate opens at the instant the data it gates begins to change.
      The `btiedev` comment `gen_sar_logic.py` carried at the time ("gating
      on `drdy` restricts the measurement to windows where the register
      holds a completed conversion's result") **was** measurably false as
      written, and `ff_27c_3.63v` is the proof: its 512 is at conversion
      #1, decoding the register's *power-up* word. That comment is no
      longer in the file: #327 / PR #371 replaced it, and
      `gen_sar_logic.py` now quotes the sentence back as the claim DR-0031
      corrected ("It does not, and issue #337 measured it not doing so"),
      alongside the settling-guard block that makes the sentence true.
    - **The correction moves no bound — and it has since landed.** A
      ≥ 0.25&nbsp;ns settling guard after the `drdy` rise takes all six
      points to 0 or 1&nbsp;LSB with zero conversions above `max 1.0`, and
      0.25&nbsp;ns through 5&nbsp;ns give the identical answer at every
      point — not a tuning knob. The window to clear is
      0.0002–0.055&nbsp;ns on this deck (against `ok`'s
      0.186–0.199&nbsp;ns), so DR-0031 part 2's ≥ 0.25&nbsp;ns floor covers
      `tie` with no deck-specific value. That floor is **proposed, not
      ratified** — DR-0031's header reads `Status: proposed — requires
      operator sign-off` — and is cited here only as that record's own
      measured requirement, not as a ratified bound. The #337
      investigation itself changed nothing in the tree, and the record
      `20260920-020802-2043286` stands unedited (append-only,
      `sim/README.md`). The execution, issue **#327**, has since merged as
      PR #371 (2026-09-22) and **is in this tree**: `gen_sar_logic.py`
      gates `btiedev` on a settled `drdy` (`CODE_SETTLE_GUARD_NS = 0.5`
      ns — 2x the ≥ 0.25&nbsp;ns floor — reached through the buffered RC
      copy `tie_drdyg`), and
      `../../../sim/sar-logic-timing-gates-tie/testbench/tb.json`'s
      code-error measurement now reads
      `meas tran dev_tie MAX v(tie_dev) FROM=1.5u`, after the discarded
      first conversion, rather than `FROM=0.1u`. **No bound moved**:
      `tie_code_deviation`'s `max 1.0`, every other `tb.json` limit,
      `sar_ctrl.v` and the stimulus are unchanged, as that manifest's own
      notes state ("DR-0031 part 2 (issue #327) CORRECTED THE INSTRUMENT,
      NOT THE BOUND" / "NO BOUND MOVED"). Because the gate change moves this
      deck's netlist hash, `20260920-020802-2043286` is evidence for the
      **old** instrument, not the current one — `tb.json`'s own DR-0031
      part 2 note says exactly that.
    - **DR-0029 is implicated in the carries, not in the failures, and its
      supersede trigger is not fired by this grid.** The chatter is why
      this deck carries at all: a loop pinned on the threshold latches 511
      on one conversion and 512 on the next, and every flip is a full
      ten-bit carry (measured: up to 8 carries in 8 conversions, against
      one mid-scale carry per run for `ok`/`lt`/`xl`/`bad`), which made
      `tie` the family's **most** exposed deck for #327's correction to
      cover. But 512 is reported at 12 of the 26 carries and at 0 of the
      30 non-carry conversions — being *caught* is decided by whether the solver
      accepted a timepoint inside a ≤ 0.055&nbsp;ns window, not by the
      converter (`tt_27c_3.30v` carries three times, reports none, and
      passes the grid with dev = 1) — and no settled code ever failed, so
      DR-0029's own condition for being superseded ("a corner where
      `tie_code_deviation` actually fails") is not met by this grid. The
      chatter model, the stimulus and every bound stand.

    **#303 (continued) — `lt` and `xl` ran their 45-point grids, and NOT ONE
    POINT of either reached the end of the ratified `tran 5n 8.5u 0 5n`.**
    Both records are committed
    (`../../../sim/sar-logic-timing-gates-lt/records/20260920-182006-2422cac.md`,
    `../../../sim/sar-logic-timing-gates-xl/records/20260921-021359-2422cac.md`;
    both `-j 12 --ngspice-threads 1 --save-measured-vectors --timeout 7200`,
    launchd-dispatched so ngspice ran at normal QoS), and **both must be read
    together with the audit of their own raw logs**,
    `../../../sim/sar-logic-timing-gates/investigations/20260921-issue-303-delay-line-decks-abort-mid-transient.md`,
    because the records' Result tables read better than the logs do:
    - `lt`: 35 of 45 points hit the 7200&nbsp;s per-point cap; the other 10 all
      aborted with `doAnalyses: TRAN: Timestep too small` between
      t&nbsp;=&nbsp;1.29 and 2.37&nbsp;µs (15–28&nbsp;% of the window), on
      `vvdd_gate#branch` at 9 of 10 and `vltmode#branch` at the 10th. The
      record scores those 10 as 7&nbsp;PASS / 3&nbsp;FAIL.
    - `xl`: 39 of 45 hit the cap; the other 6 all aborted the same way between
      t&nbsp;=&nbsp;1.43 and 2.71&nbsp;µs, all on `vvdd_gate#branch`. The
      record scores those 6 as 6&nbsp;FAIL (4–507&nbsp;LSB).
    - **Why an abort is scored at all**: these decks declare exactly one
      manifest measurement, an unbounded-right `meas … MAX … FROM=0.1u`, so
      ngspice still emits a number from the truncated transient and
      `sim/harness/runner.py`'s only error test — "is any manifest measurement
      missing?" — never fires. Those values therefore describe ~1.5
      conversions, not the seven the measurement is defined over. The harness
      defect is issue **#341**; the records are committed **unedited**
      (append-only, `sim/README.md`) rather than corrected in place.
    - **Why the aborts are new information**: they are neither #296 (no
      comparator source is named; these loops drive a matched 50&nbsp;Ω line)
      nor #310 (a per-loop deck has exactly one `sar_ctrl_a`, so five
      instances cannot be sharing a supply row). The only structural
      difference from `ok` — same DUT, same instance count, same window, same
      comparator model, 45 of 45 with zero aborts — is the ideal lossless
      `tltd`/`txld` transmission line. That is the leading hypothesis, it is
      **unconfirmed** (no instrumented probe has been run), and it is issue
      **#343**.
    - `xl`'s wall times are additionally inflated by host contention for the
      run's first 3 h 48 m (a launchd-respawned duplicate `lt` grid, 24
      ngspice jobs on 18 cores; that duplicate's output was discarded, never
      scored) — see the operator note on #303. Contention can turn an abort
      into a timeout but not a completed transient into an abort.

    - `bad` (`records/20261020-011850-edf81f4.md`, #303, run on the Spot
      batch fleet via `klt sim --batch-set`, `--timeout 3400`, the fleet's
      3600&nbsp;s whole-job ceiling minus margin): **0 of 45 scored** — 42
      points hit the 3400&nbsp;s per-point cap and 3 (`tt_-40c_3.63v`,
      `fs_27c_3.30v`, `sf_27c_3.63v`) failed with `aerr_bad` producing no
      value because `options.save_mode` was `"netlist"` on the runner and the
      measured vector was not retained. The cap is below the ~10&nbsp;CPU-h
      per-point cost measured for the five-loop deck and is **not** shown to
      be "too slow" for `bad`'s own loop: no point ran to completion, so
      `bad`'s negative-control claim (a late decision MUST corrupt the
      conversion) is **unverified**. The record carries a toolchain-drift
      banner (runner `open_pdks` differs from the pin; ngspice version
      unparseable), so it is not comparable with the pinned `lt`/`xl`/`tie`
      records.

    **Status: `bad` is measured only in the sense that its grid ran (0 of 45
    scored), and `lt` and `xl` likewise — none has a single point that
    completed the ratified transient, so this deck family's
    added-comparator-delay claim is still unverified at
    `cmp_delay` = 40 / 50 / 70&nbsp;ns.** Per the operator direction recorded
    on #303 (2026-09-21), further grids of this size belong on the Spot batch
    fleet (`klt sim --backend batch`, blocked on 2am#961 / 2am#962), not on a
    dispatch host; and any future cap must be derived from a full-length
    point, since 7200&nbsp;s was justified from a 0.5&nbsp;µs truncated probe
    and is wrong by more than an order of magnitude.

  Both new findings are genuine, measured, and recorded rather than
  tightened away (CLAUDE.md: "no claim without a testbench", "Verification
  is the product") — #295 was disambiguated and resolved via DR-0027 at
  #298, and #296's root cause is confirmed and fixed above. #274 (P&R) and
  #275 (STA closure), already merged against the unchanged netlist, needed
  no re-accounting once #298 resolved decision-record-only rather than with
  a netlist change, and #296 changes only the testbench's comparator
  model — never `sar_ctrl.v` or the synthesized netlist — so they need none
  here either.

## Library choice: `gf180mcu_fd_sc_mcu7t5v0`

Both libraries synthesize cleanly and both are proven equivalent to the RTL
(see the two records under `../flow/sar_ctrl/records/`), so the choice comes
down to area against `layout/adc-top/README.md`'s §2.4 reserved SAR-logic
footprint — the thing DR-0023 explicitly named as this issue's own deciding
factor ("compare against `layout/adc-top/README.md`'s §2.4 reserved
sequencer footprint").

| Library | Cell instances | `area_um2` (Liberty, cell area only) | Sequential area |
|---|---|---|---|
| `gf180mcu_fd_sc_mcu7t5v0` (7-track) | 181 | **4,961.152** | 2,864.736 |
| `gf180mcu_fd_sc_mcu9t5v0` (9-track) | 187 | **6,917.702** | 3,556.224 |

(Exact numbers, both libraries, both from the same RTL source and the same
`tt_025C_3v30` corner — see the two synthesis records for the full cell
census.)

`layout/adc-top/README.md`'s as-drawn table gives the SAR-logic reserved
region (incl. its guard ring) as **7,624 µm²**, against §4.2's own original
estimate of 1,000–5,000 µm². Both libraries' *cell* area is a lower bound on
what real place-and-route will need — routed standard-cell area is
routinely 20–40% over raw cell area once cell-to-cell routing, pin access
and any required whitespace are counted, and neither of those numbers is
available yet (place-and-route is follow-on (b), #274, not this issue). Against
that reserved footprint:

- `mcu9t5v0` leaves only 706 µm² of headroom (6,918 of 7,624) before any
  routing overhead at all — comfortably inside a 10–15% routing overhead
  budget, but not inside anything larger, and *already* above §4.2's whole
  original 1,000–5,000 µm² estimate range.
- `mcu7t5v0` leaves 2,663 µm² (35% of the reserved region) before routing
  overhead — enough margin to absorb a real P&R run's overhead and still sit
  near the top of §4.2's original estimate range, not near or past it.

**Choice: `gf180mcu_fd_sc_mcu7t5v0`.** It is smaller on every axis measured
here (28% fewer µm², 6 fewer cell instances, 19% less sequential area) with
no equivalence, mapping, or warning difference between the two runs, and its
margin against the already-drawn reserved footprint is the difference
between "P&R has room to work" and "P&R has almost none" once real routing
overhead is counted. This is a density-vs-reserved-footprint choice, exactly
the kind DR-0023 deferred to this issue — it is not a re-ratification of
DR-0023 itself (DR-0023's own decision, adopting *both* libraries as the
legal set for the digital rail, is untouched), and it is not an area-budget
decision under DR-0024 (pending ratification, out of scope here) either: it
only picks a member of the set DR-0023 already legalized. Both netlists
stay committed under `../flow/sar_ctrl/netlist/` regardless of this choice,
so the un-chosen library's evidence is not thrown away — a later P&R
attempt against `mcu9t5v0` remains possible and auditable if the reserved
footprint itself is ever revisited (DR-0024).

When the gate-level SPICE functional/timing replay (#273) is built, it should run against this chosen library's netlist only —
running it against both would double the replay cost for a library this
issue is not recommending, and the equivalence proof above already
establishes both netlists are functionally identical to the same RTL, so a
functional divergence between the two synthesized netlists is not a
possibility either replay could newly discover.

## Real hardware note: seeding the ring at power-up

> **Seeding the ring is necessary but NOT sufficient (issue #320, DR-0031).**
> The remedy below is correct for `ph[15:0]` and covers nothing else.
> `start` does not reach the `eng[9:1]`, `q[9:0]` or `c[9:0]` registers at
> all — measured on the committed gate netlist by walking all 45 flip-flops'
> D-cones (`sim/tests/test_probe_code_readout.py::ResetStructureTests`) —
> and those flags clear only at `endconv = ph[13]`, i.e. *inside* the first
> conversion, after its own sample and its first nine bit trials. So **the
> first conversion after power-up runs its binary search against an
> arbitrary, PVT-dependent set of already-engaged CDAC weights and produces
> a wrong code**, and no `start` pulse of any length prevents it (while
> `start` is high the ring is pinned at `ph[0]`, so `arm`/`endconv` never
> fire). Measured at 8 of 45 PVT points on the first scored gate-level grid,
> at 1, 5, 28 and 252 LSB of code error. Real hardware must therefore
> **assert `start` for ≥ 1 clock AND discard exactly one conversion** before
> consuming any `drdy` word. Exactly one: `endconv` clears all nine flags on
> the edge leaving conversion 1's last bit trial, so conversion 2 onward is
> a function of the input alone — measured as conversions #2–#8 being exact
> at every point read out, including the two worst. Full root cause:
> `sim/sar-logic-timing-gates-ok/investigations/20260919-issue-320-first-conversion-and-decode-transient.md`;
> disposition, and the RTL-reset alternative it routes to a follow-on:
> `spec/decision-records/DR-0031-power-up-first-conversion-validity.md`.

The rung-1 XSPICE model seeds its one-hot ring with an initial condition
(`ic=1` on `ph15`'s flip-flop) that has no synthesizable Verilog counterpart
and no counterpart in a real standard-cell flip-flop either (`dffq_1` carries
no reset pin at all — see the cell census in either synthesis record).
`sar_ctrl.v`'s `ph` register therefore powers up in `x` (simulation) or an
arbitrary, unknown state (silicon) rather than the ring's legal one-hot
state. **Real hardware must assert `start` for at least one clock after
power-up** before relying on any other output of this module — asserting
`start` forces `ph[0]` high and every other `ph` bit low on the very next
clock edge regardless of the register's power-up state (`sar_ctrl.v`'s own
`always` block: `ph[0] <= start | ph[15]`, `ph[k] <= ph[k-1] & ~start` for
every other `k`), which re-establishes the one-hot invariant unconditionally.
This is a real hardware requirement the ideal rung-1 model's `ic=1` masked,
and it is why the two upstream ideal decks (`sim/sar-logic-functional/`,
`sim/sar-logic-timing/`) never drive their `_start` net above 0: their
`sar_ctrl_a` never carries this gap in the first place. The follow-on
gate-level replay decks will need to assert `start` for one clock at the top
of every run for exactly this reason — noted here so that follow-on work
does not have to re-derive it.

They did (`START_PULSE_CLOCKS = 2` in
`design/sar-logic/flow/gen_sar_ctrl_gates_tb.py`), and it was not enough —
see the callout at the top of this section. The sentence "before relying on
any other output of this module" above is what this note got wrong: the ring
becomes trustworthy on the next clock edge, but the *conversion* does not
become trustworthy until the one already in flight has completed and cleared
the engaged-weight state behind it.
