2AMLogic/gf180-sar-adc/spec/timing-budget-memo.md

# Conversion timing budget — worst-corner closure at 1 MS/s and the 2 MS/s stretch

**Status**: design memo, supporting the ratified Latency/conversion-timing row
in `README.md#target-specification` (not itself a decision record — see
`spec/decision-records/README.md`).
**Issue**: #12. **Consumes**: `spec/decision-records/DR-0003-clocking.md`
(#7, clock source/multiplier and jitter budget), `spec/cdac-sizing-memo.md`
§4/§5.3 (#8, unit cap and per-bit settling load), `spec/comparator-budget-memo.md`
§6 (#9, measured worst-case regeneration delay), `spec/decision-records/DR-0007-track-switch-topology.md`
(#10, track-window settling margin), `spec/decision-records/DR-0008-sar-logic-synchronous.md`,
`spec/decision-records/DR-0009-no-redundancy.md`, `spec/decision-records/DR-0010-mixed-signal-sim-strategy.md`
and `spec/decision-records/DR-0005-interface-scope.md` (#11, sync/async choice,
clock multiplier, cycle allocation, interface scope, and the still-open
transistor-level logic-delay gap).
**Does not re-derive**: DR-0003's aperture-jitter budget (cited, §5 below),
`spec/prior-art-survey.md` §1.4's placeholder cycle-allocation arithmetic
(superseded throughout by the closed dependencies' real numbers — see §1).

Every number below is either consumed from a closed, cited dependency, or
derived from those dependencies' own reported values using a convention this
repo has already established elsewhere (cited at the point of use). Nothing
here reuses `spec/prior-art-survey.md` §1.4's placeholder `C_u = 5 fF` /
`R_on = 1 kΩ` / `t_settle ≈ 19.5 ns` arithmetic.

---

## 0. What this memo does not decide

This memo consumes, and does not re-decide:

- **Sync vs. async and the clock multiplier** — DR-0008 ratifies synchronous
  SAR logic, `M = 16` (16 MHz @ 1 MS/s, 32 MHz @ 2 MS/s stretch). This memo
  budgets the resulting cycle count; it does not re-argue the choice.
- **The cycle allocation** — the ratified `README.md#target-specification`
  Latency row and DR-0003 already fix **4 sample cycles + 10 bit-trial
  cycles + 2 reset/output cycles = 16** at `M = 16`. This memo checks whether
  the physical processes that have to happen *inside* those allocated
  cycles actually fit, at the worst corner — it does not propose a different
  cycle count. (§3.4 below notes one place a *different, non-ratified*
  upstream draft number was used inconsistently — DR-0007's own settling
  margin used an unratified 300 ns acquisition estimate rather than the
  ratified 250 ns window — and corrects it without changing DR-0007's
  Decision.)
- **The interface scope** — DR-0005 ratifies a 10-bit parallel output
  register in scope for simulation-complete, with SPI deferred. This memo
  budgets that register's readout window; it does not reopen the scope
  question.
- **The aperture-jitter budget** — DR-0003 separately closes a budgeted rms
  aperture-jitter constraint (`≤ 250 ps rms` @ 1 MS/s, `≤ 180 ps rms` @
  2 MS/s stretch, evaluated at Nyquist with a 6 dB margin). That constraint
  bounds ENOB via sample-instant uncertainty; it is a **different closure
  condition** from this memo's conversion-*period* closure, and is cited,
  not re-derived, in §5.

---

## 1. Budget structure and worst-corner selection

Per the curator guidance on this issue, the budget is the explicit sum:

```
T_conversion ≤ 1 / f_s        (1000 ns @ 1 MS/s; 500 ns @ 2 MS/s stretch)

T_conversion = T_track (#10, worst-corner settling margin)
             + N × T_bitcycle,  N = 10
             + T_readout (#7/#11 interface scope)

T_bitcycle = T_CDAC_settle (#8, worst-corner)
           + T_comparator_regen (#9, worst-corner, measured)
           + T_logic_delay (#11, worst-corner — STILL OPEN, see §4)
```

**Worst corner: `ss_125c_2.97v`** (slow process **+** low supply **+** high
temperature, simultaneously, not evaluated independently) — the same
compounded corner `README.md#target-specification`'s Rate row already names
as binding for settling, and the corner every closed dependency this memo
cites (independently) measured as its own worst point over a full 45- or
117-point PVT grid:

- #9's comparator regeneration delay: worst at `ss_125c_2.97v`
  (`sim/comparator-regeneration/records/20260801-050155-109944e.md`).
- #10's/#4's T-gate `R_on`: worst at `ss_125c_2.97v`
  (`sim/device-switch-ron/records/20260731-191216-5f5288b.md`).
- #8's CDAC per-bit settling: error already at the simulator's numeric floor
  at every corner including `ss_125c_2.97v`
  (`sim/cdac-bit-settling/records/20260731-231537-1ee5578.md`).

**Both temperature extremes are represented, not assumed away.** Each of the
three full-grid sweeps above independently swept `-40/27/125 °C`; in every
one, the **hot** corner (`125 °C`, combined with slow process and low
supply) is the worst point, not the cold one — subthreshold mobility and
gain degradation at high temperature dominate over any cold-corner effect
for these particular quantities. This is stated because the acceptance
criteria for this issue explicitly calls out both extremes; the closed
dependencies already checked both, and hot wins in every term this memo
consumes.

---
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
