2AMLogic/gf180-sar-adc/spec/cdac-sizing-memo.md

# CDAC sizing memo — unit cap from kT/C + matching budget

**Status**: design memo, feeds the pending ratified spec (#1). Not a decision
record (see `spec/decision-records/README.md` — this is derivation/analysis,
cited *from* decision records, not itself one).
**Issue**: #8. **Consumes**: DR-0011 (switching-scheme choice),
`sim/device-characterization-report.md` §1–§5.1 (measured/derated device
data), DR-0002 (reference-drive envelope).
**Feeds**: #9 (comparator CM budget — see DR-0011), #12 (settling budget,
§5), #14 (Monte Carlo mismatch model, §3), #15/#16 (array size, §5).

---

## 0. Scope and topology recap
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
