2AMLogic/gf180-sar-adc/spec/prior-art-survey.md

# Prior-Art Survey: SAR ADC Architectures for gf180mcu

**Status:** survey / research deliverable. Not a decision record.
**Issue:** #3. **Feeds:** #1 (spec ratification), #7 (scope decisions), #8 (CDAC),
#9 (comparator), #10 (sample switch), #11 (SAR logic), #13 (testbench suite).
**Compiled:** 2026-07-30.

---

## 0. Scope and how to read this document
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
