2AMLogic/gf180-sar-adc/layout/adc-top/economy/reports/20260817-130012-09d8259/images/quadrant-NE/overview.png

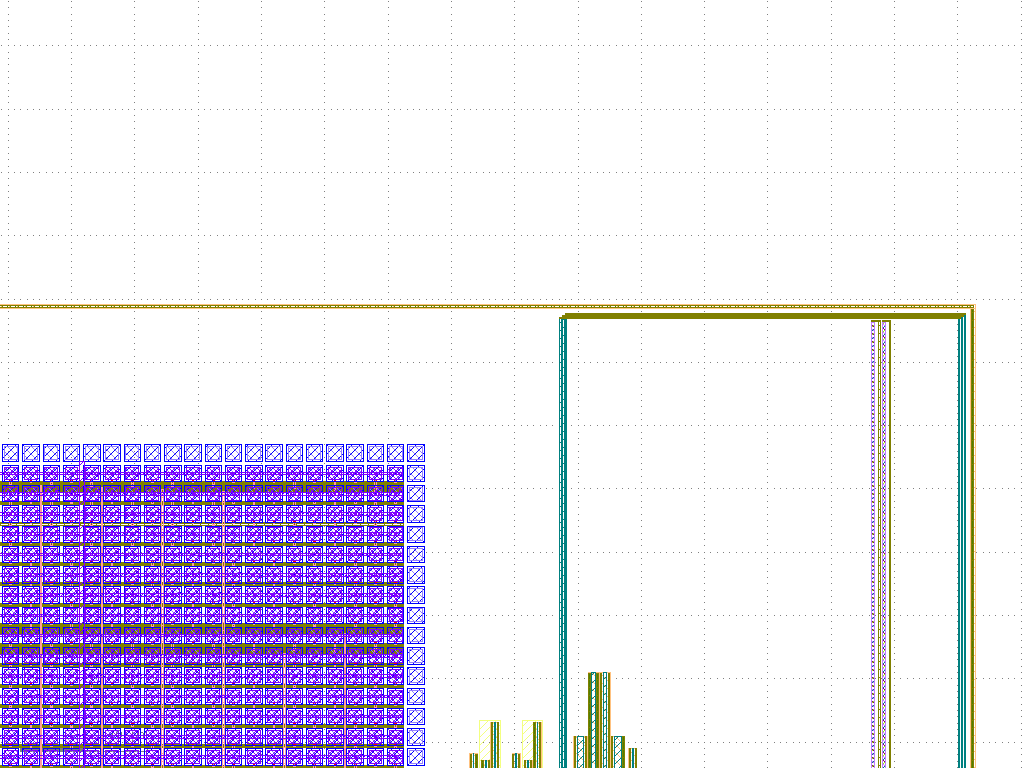
layout/adc-top/economy/reports/20260817-130012-09d8259/images/quadrant-NE/overview.png
