2AMLogic/gf180-sar-adc/layout/adc-top/economy/reports/20260817-144100-ae0b956/images/quadrant-SE/overview.png

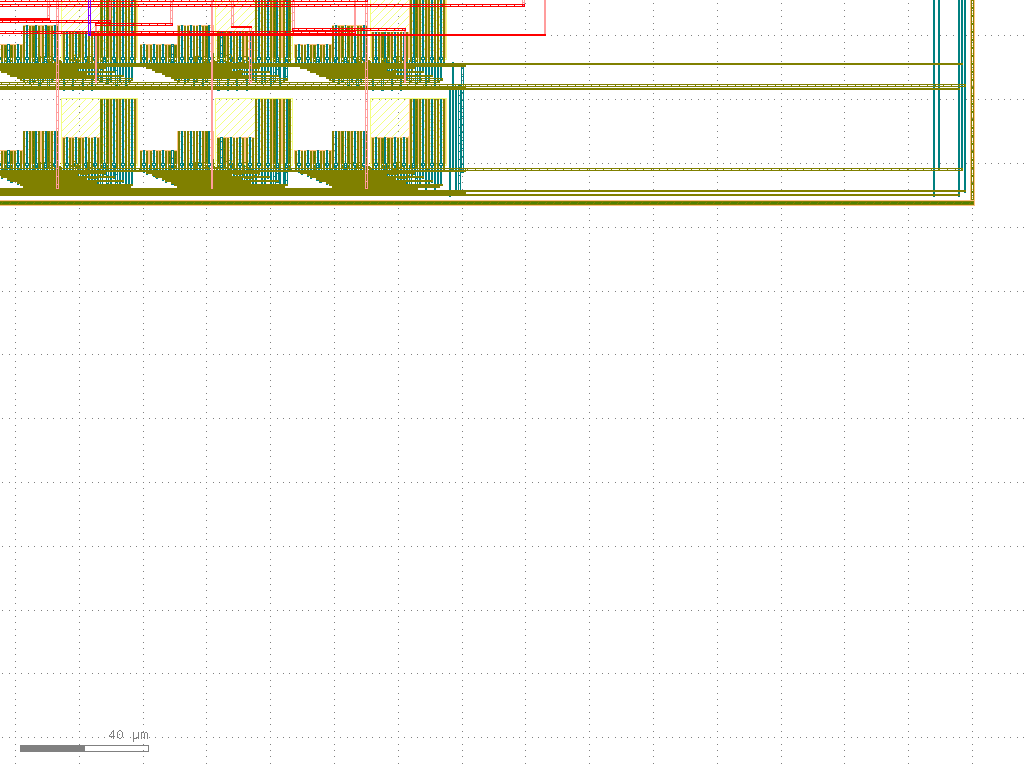
layout/adc-top/economy/reports/20260817-144100-ae0b956/images/quadrant-SE/overview.png
