2AMLogic/gf180-sar-adc/layout/adc-top/economy/reports/20260817-185745-40cfeb8/images/quadrant-NE/overview.png

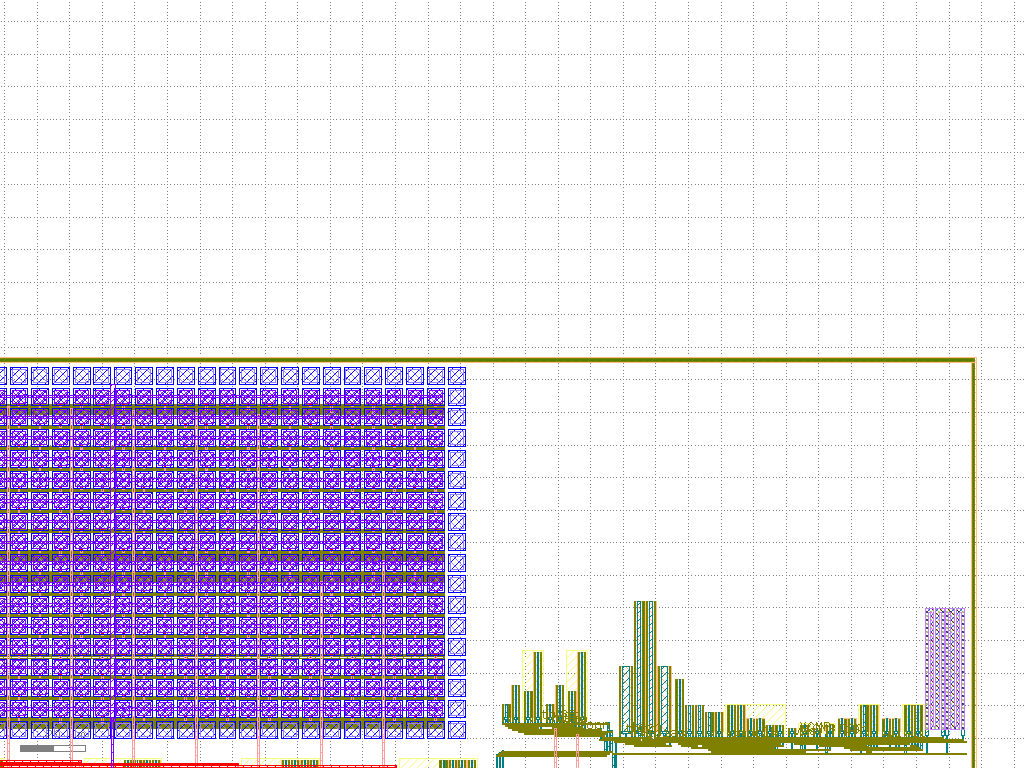
layout/adc-top/economy/reports/20260817-185745-40cfeb8/images/quadrant-NE/overview.png
