2AMLogic/gf180-sar-adc/docs/environment-setup.md

# Environment Setup: xschem + ngspice + gf180mcu (macOS / Homebrew)

Bootstrap steps for the open-source design/sim flow described in
[`CLAUDE.md`](../CLAUDE.md): xschem (schematic capture / netlisting) +
ngspice (simulation) against the gf180mcu PDK (fetched via
[ciel](https://github.com/fossi-foundation/ciel)).

This doc is intended to be followed **verbatim, from a clean shell**, on any
fresh machine or agent session.

**Ported from `2AMLogic/gf180-bandgap@58024be`** per `CLAUDE.md`'s bootstrap
rule. The install steps are identical — the sister canary repos deliberately
share one bootstrap and one pinned PDK hash — and only the acceptance step
(§5, §7) is specific to this repo.

Recorded on macOS (Darwin, arm64) with Homebrew. If you are on a different
OS, the `xschem` source build steps are the same; substitute your platform's
package manager for the Homebrew dependency installs.

A worked **Linux** install of the simulation half of this toolchain (no xschem)
is scripted in
[`.github/workflows/nightly-pdk.yml`](../.github/workflows/nightly-pdk.yml):
ngspice built from the upstream release tarball at the pinned major, and the
gf180mcu PDK fetched with ciel at the pinned hash below. It is executable
documentation — it runs nightly, so it cannot rot silently the way a prose
install guide can.

## 1. Versions used to validate this doc (2026-07-31)

| Tool | Version | Source |
|---|---|---|
| xschem | **3.4.7** (tag `3.4.7`, commit `92dd8fe5f4d5c1057489710d8a22f18fdc9d7ed0`) — also recorded machine-readably as `xschem_tag`/`xschem_commit` in `sim/toolchain.json`, so the nightly's from-source build (`.github/workflows/nightly-pdk.yml`) and this table cannot silently diverge | built from source, see §2 |
| ngspice | **46** | Homebrew (`ngspice`) |
| ciel | **2.6.1** | pip (`ciel==2.6.1`), in a venv — never a host-wide install |
| gf180mcu PDK | commit hash **`f6eeac7dad085ffcc829ccfd721f7b4ce39edcf7`** | `ciel enable` |
| python3 | **3.14.6** (≥ 3.9 required) | Homebrew; stdlib only, no venv |
| Build deps | `cairo`, `tcl-tk@8`, `xorgproto`, XQuartz (cask), `bison`, `flex` | Homebrew / macOS system tools |
| scipy | **1.17.1** (≥ 1.17.0 required) — *only* for `sim/mc-cdac-mismatch/testbench/mc_cdac_mismatch.py` and `sim/comparator-offset-gof/testbench/analyze_gof.py`; every other script under `sim/`, including `run_corners.py` itself, is stdlib(+numpy)-only | `pip install scipy` (also recorded as `scipy_min` in `sim/toolchain.json`) |

The gf180mcu hash above is the one every sister gf180 canary repo should
reuse verbatim (pinned, not "latest" — re-running `ciel ls-remote --pdk-family gf180mcu` later
will show newer hashes; do not silently switch to them without updating this
doc and re-validating §5 and §7).

The table above covers the **simulation** half of the flow. The digital
synthesis half (`klt` + Yosys, which produced the committed gate-level
netlists under `design/sar-logic/flow/sar_ctrl/netlist/`) has its own,
separate pin — see [§8](#8-digital-synthesis-toolchain-klt--yosys).

**These pins are enforced, not just documented.** The same values live in
machine-readable form in [`sim/toolchain.json`](../sim/toolchain.json), and the
corner runner checks them **before simulating a single point**:

| Pin | Rule | Why |
|---|---|---|
| `open_pdks` hash | exact match | the hash *is* the device model set — a different revision produces numbers no other record under `sim/` is comparable with, silently and with no error |
| `ngspice_min_major` | floor (newer allowed, and recorded) | a run on an engine older than the validated one is not something this repo has ever verified |
| `python_min` | floor | the harness is written against it |

A mismatch is fatal: the runner exits `3` having simulated nothing, rather than
emitting a partial or incomparable result. To re-validate the repo against a
newer PDK deliberately, pass `--allow-toolchain-drift` — every record written
under that flag is stamped with the drift, both as a banner at the top of the
record and in its Environment section, so drifted evidence can never be
mistaken for pinned evidence. Changing a pin means editing **both**
`sim/toolchain.json` and this table in the same change (a unit test fails if
they disagree) and re-running `bash sim/selftest.sh`.

`sim/toolchain.json` also carries `xschem_tag` / `xschem_commit` (§2's pin,
repeated verbatim). That pair is **not** in the table above and is not checked
by `run_corners.py --check-env` — `sim/smoke_test/run_smoke_test.sh` already
fails outright if xschem is simply missing, and there is no xschem-version
banner comparison wired up (unlike ngspice's `ngspice-<major>`). Its job is to
give `.github/workflows/nightly-pdk.yml`'s from-source xschem build a single
source of truth for its cache key and clone ref, instead of retyping the tag
in the workflow.

`sim/toolchain.json` likewise carries `scipy_min` (the row above), and it is
**also not checked** by `run_corners.py --check-env` — deliberately, not by
oversight. Every pin in the enforced table is a dependency of the generic PVT
harness itself, so `--check-env` sits directly on the path where a drift would
otherwise silently corrupt a record. scipy is different: it is a hard runtime
dependency of exactly two standalone testbenches
(`sim/mc-cdac-mismatch/testbench/mc_cdac_mismatch.py` and
`sim/comparator-offset-gof/testbench/analyze_gof.py`), neither of which
`run_corners.py` or CI ever imports (`spec/monte-carlo-methodology-memo.md`
§2.1, §5), so `--check-env` never runs on their code path regardless. A missing or
old scipy already fails immediately and loudly there — a plain Python
`ImportError`/`AttributeError` the first line the script executes — which is
the same class of signal a bespoke check would add, unlike an unpinned
`open_pdks` hash, which fails silently with a plausible-looking wrong answer.
The pin is recorded so it stays machine-readable and in sync with this table,
not because a runtime check is needed on top of Python's own failure mode.

## 2. Build xschem from source

`xschem` has **no Homebrew formula** on macOS (`brew search xschem` / `brew
info xschem` both come back empty; there is no relevant tap, and there is no
MacPorts `port` binary either as a fallback). Build it from the upstream
[xschem](https://github.com/StefanSchippers/xschem) repository:

```bash
# Build dependencies (Homebrew + macOS system tools):
brew install cairo tcl-tk@8 xorgproto
brew install --cask xquartz   # provides /opt/X11 (X11 headers/libs)
# bison and flex ship with the macOS command line tools (/usr/bin/bison,
# /usr/bin/flex) -- no separate install needed on a machine with Xcode CLT.

# Clone the exact tag this doc was validated against:
git clone --branch 3.4.7 https://github.com/StefanSchippers/xschem.git
cd xschem
git rev-parse HEAD   # expect 92dd8fe5f4d5c1057489710d8a22f18fdc9d7ed0

# tcl-tk@8 is keg-only on Homebrew -- point configure/make at it explicitly:
export PATH="/opt/homebrew/opt/tcl-tk@8/bin:$PATH"
export PKG_CONFIG_PATH="/opt/homebrew/opt/tcl-tk@8/lib/pkgconfig:$PKG_CONFIG_PATH"
export LDFLAGS="-L/opt/homebrew/opt/tcl-tk@8/lib"
export CPPFLAGS="-I/opt/homebrew/opt/tcl-tk@8/include"

./configure --prefix=/opt/homebrew
make -j4
make install PREFIX=/opt/homebrew
```

(On Intel Macs, substitute `/usr/local` for `/opt/homebrew` throughout.)

Verify the headless netlist mode works against a trivial schematic (no GUI,
no PDK needed for this check):

```bash
xschem -n -x -q -r /opt/homebrew/share/doc/xschem/examples/lm317.sch -o /tmp
# no "Error:" lines expected; produces /tmp/lm317.spice
```

`-n` (netlist), `-x`/`--no_x` (headless, no X11 window), `-q` (quit after),
`-r`/`--no_readline` (safe for non-interactive/redirected stdin+stdout).

### A note on `~/.xschem/xschemrc` (machine-specific gotcha)

xschem loads, in order: the system-wide `xschemrc`, then
`~/.xschem/xschemrc` (**user**-level, overrides the system one), then a
project-local `./xschemrc` in the current working directory (overrides
both) — **or** whatever file `--rcfile <path>` points at, if given.

If a machine already has a stale/unrelated `~/.xschem/xschemrc` (e.g. left
over from a prior, unrelated project), it can silently override
`XSCHEM_LIBRARY_PATH` and break even the generic `devices/` symbol library
(`l_s_d(): Symbol not found: ...` for every basic symbol). This repo does
**not** rely on `~/.xschem/xschemrc` being correct — see
[`design/xschemrc`](../design/xschemrc), a project-local rc file that resets
`XSCHEM_LIBRARY_PATH` explicitly. Always invoke xschem for this repo with
`--rcfile design/xschemrc` (see §5) so behavior does not depend on
whatever is (or isn't) in any given machine's user-level dotfile.

## 3. Fetch the gf180mcu PDK via ciel

```bash
python3 -m venv .venv-ciel && .venv-ciel/bin/pip install 'ciel==2.6.1'   # or: uvx --from 'ciel==2.6.1' ciel ...
ciel --version                                           # expect 2.6.1 (or record whatever is installed)
ciel ls-remote --pdk-family gf180mcu                     # lists available commit hashes, newest first
ciel enable --pdk-family gf180mcu \
  -l default -l gf180mcu_osu_sc_gp9t3v3 -l gf180mcu_osu_sc_gp12t3v3 \
  f6eeac7dad085ffcc829ccfd721f7b4ce39edcf7
```

`ciel enable` downloads the version if it is not installed yet, then makes it
the active one. The pin is the single value in `sim/toolchain.json`
(`open_pdks`); the harness refuses a PDK tree whose `SOURCES` revision differs
from it. A leftover `~/.volare` tree from the previous pin is searched after `~/.ciel` and is
never preferred over a tree at the pinned revision, but it is not a substitute
for one: if it is the only tree, the harness reports a pin mismatch.

### Why that `-l` list, and why it is not shorter

**`-l`/`--include-libraries` *selects* the library set — it does not add to a
default.** In `ciel` 2.6.1, `Family.resolve_libraries()` returns exactly the
libraries named by `-l`; it unions the family's default set only for the
literal token `default`, and returns every library the family knows for `all`.
So `-l gf180mcu_fd_pr <hash>` — the command this section used to show — installs
*only* `gf180mcu_fd_pr`, which is not enough to reproduce this repository's
committed evidence.

For `gf180mcu`, `ciel`'s default set is five libraries:

| Library | In `ciel`'s `gf180mcu` default set? | Needed here for |
|---|---|---|
| `gf180mcu_fd_pr` | yes | device models — every ngspice run |
| `gf180mcu_fd_sc_mcu7t5v0` | yes | `sar_ctrl` synthesis/P&R/STA/DRC/LVS (DR-0023) |
| `gf180mcu_fd_sc_mcu9t5v0` | yes | the second 5 V standard-cell library DR-0023 compares |
| `gf180mcu_fd_io` | yes | nothing in this block reads it; it arrives with `default` |
| `gf180mcu_fd_ip_sram` | yes | nothing in this block reads it; it arrives with `default` |
| `gf180mcu_osu_sc_gp9t3v3` | **no** | DR-0044's 3.3 V-device standard-cell evidence |
| `gf180mcu_osu_sc_gp12t3v3` | **no** | DR-0044's 3.3 V-device standard-cell evidence |

The two OSU-sourced 3.3 V libraries are the reason the selection is spelled out:
they are **outside** `ciel`'s `gf180mcu` default set, so neither a bare
`ciel enable` with no `-l` nor `-l default` alone brings them down, and
DR-0044's `libs.ref/` listing cannot be reproduced without them.

**The evidence hosts carry exactly these seven libraries.** `-l default -l
gf180mcu_osu_sc_gp9t3v3 -l gf180mcu_osu_sc_gp12t3v3` resolves to the same seven
directories DR-0044's committed `ls gf180mcuD/libs.ref/` listing shows
([DR-0044](../spec/decision-records/DR-0044-standard-cell-device-under-f6eeac7.md)),
so following this section gives you the install the records were taken on.
Verify the selection without downloading anything:

```bash
uvx --from 'ciel==2.6.1' python -c "from ciel.families import Family; \
  print(sorted(Family.by_name['gf180mcu'].resolve_libraries( \
    ['default','gf180mcu_osu_sc_gp9t3v3','gf180mcu_osu_sc_gp12t3v3'])))"
# -> the same 7 names as DR-0044's libs.ref/ listing
```

`-l all` is deliberately **not** used: at this pin it resolves to 14 libraries,
i.e. seven more than any record in this repository reads, and it is a superset
of — not a match for — the evidence install. Naming the seven explicitly is
equivalent but drifts silently if `ciel`'s default set changes, so `default`
plus the two OSU names is preferred.

**CI installs a narrower set on purpose, and that is not a contradiction.**
`.github/workflows/nightly-pdk.yml` passes `-l gf180mcu_fd_pr -l
gf180mcu_fd_sc_mcu7t5v0` to keep its cache small; it covers what the nightly
jobs actually read and no more. The seven-library selection here is the
*human bootstrap* set — the one that reproduces every committed record,
including the DR-0044/DR-0045 OSU listings the nightly does not exercise.

This creates `~/.ciel/gf180mcuA` / `gf180mcuB` / `gf180mcuC` / `gf180mcuD`
(symlinks into `~/.ciel/ciel/gf180mcu/versions/<hash>/...`) — one
directory per gf180mcu variant. Per `CLAUDE.md` and the block's 0–3.3 V input
range, this repo uses the 3.3 V flavor, variant **`gf180mcuD`**.

The variant letter also fixes the **metal stack**, which matters for the CDAC:
per the PDK's own `libs.tech/klayout/drc/README.md` variant table, `gf180mcuD`
is `metal_level=5LM` with `mim_option=B`, so its MIM capacitor sits between
metal 4 and metal 5 and the corresponding model subckts are
`cap_mim_*_m4m5_noshield`. The harness encodes that mapping
(`MIM_STACK_BY_VARIANT` in `sim/harness/pdk.py`) so no testbench has to name a
metal stack; `sim/run_corners.py --check-env` prints the resolved stack.

## 4. `PDK_ROOT` / `PDK` environment convention

```bash
export PDK_ROOT="$HOME/.ciel"      # ciel's PDK root
export PDK="gf180mcuD"             # the 3.3V variant this repo targets
```

So `$PDK_ROOT/$PDK` resolves to `~/.ciel/gf180mcuD`, and the ngspice
models live under `$PDK_ROOT/$PDK/libs.tech/ngspice/`.

Add this as a small sourceable snippet rather than a one-off manual export,
e.g. append to your shell profile:

```bash
# gf180-sar-adc: xschem/ngspice/gf180mcu env (see docs/environment-setup.md)
export PDK_ROOT="$HOME/.ciel"
export PDK="gf180mcuD"
```

Demonstrate it survives a fresh shell:

```bash
$ echo $PDK_ROOT $PDK
/Users/you/.ciel gf180mcuD
```

Equivalently, from inside the repo: `source sim/env.sh`, which exports the
same variables plus `GF180_PDK_PATH`, `GF180_MODELS` and
`XSCHEM_USER_LIBRARY_PATH`, all derived from whatever PDK the harness itself
resolved — so xschem and the corner runner can never disagree about which PDK
is in use.

### Relocated README tool-table detail (issue #475)

The README's tool-version table is length-capped. The `gf180mcu PDK` row's original install and compatibility text, relocated verbatim:

> | gf180mcu PDK | open_pdks commit `f6eeac7dad085ffcc829ccfd721f7b4ce39edcf7` (`sim/toolchain.json`'s `open_pdks` pin — an **exact** match, not a floor: the hash *is* the device model set) | [ciel](https://github.com/fossi-foundation/ciel) 2.6.1: `pip install ciel==2.6.1 && ciel enable --pdk-family gf180mcu -l default -l gf180mcu_osu_sc_gp9t3v3 -l gf180mcu_osu_sc_gp12t3v3 f6eeac7dad085ffcc829ccfd721f7b4ce39edcf7` (`-l` *selects* the library set rather than adding to it — see §3 for why the two OSU libraries must be named). An IIC-OSIC-TOOLS environment that already exports a compatible `PDK_ROOT`/`PDK` for this same open_pdks hash works too — this repo's harness resolves the PDK through the standard `PDK_ROOT`/`PDK` convention (`docs/environment-setup.md` §4), `~/.ciel` first, so it does not care which tool populated `PDK_ROOT`, only that the hash matches |

## 5. Smoke test: xschem netlist -> ngspice sim, referencing gf180mcu models

[`design/smoke_test.sch`](../design/smoke_test.sch) is a throwaway
sample-and-hold primitive — **not** SAR ADC content, just enough to exercise
the full toolchain: `VIN (1.0 V)` into the source of one gf180mcu 3.3 V nfet
(`nfet_03v3_dss`) used as a sampling switch, gate held on at 3.3 V by
`VSAMPLE`, drain (`vhold`) loaded by an ideal 1 pF hold capacitor and pulled
up to `VDD` through a 10 kΩ resistor so the operating point is well defined.

The gf180mcu model include is deliberately **not** hardcoded into the
schematic (no machine-specific `$PDK_ROOT` path baked into version-controlled
files) — [`sim/smoke_test/run_smoke_test.sh`](../sim/smoke_test/run_smoke_test.sh)
generates a small `sim/smoke_test/pdk_include.spice` shim from the
`PDK_ROOT`/`PDK` environment variables at run time (git-ignored: it is a
derived artifact, regenerated on every run, not committed evidence), then:

1. Netlists `design/smoke_test.sch` with `xschem -n -x -q -r --rcfile
   design/xschemrc -o sim/smoke_test design/smoke_test.sch`, producing
   `sim/smoke_test/smoke_test.spice` (git-ignored — it is regenerated, and
   xschem stamps the generating machine's absolute path into it).
2. Runs `ngspice -b smoke_test.spice` from `sim/smoke_test/`, computing the
   operating point.

Run it (after §3 is done — §4's exports are optional, see below):

```bash
sim/smoke_test/run_smoke_test.sh
```

No environment setup and no hand-editing is required: if `PDK_ROOT`/`PDK` are
unset, the script resolves the PDK through the harness (`sim/run_corners.py
--print-env`) so the smoke test and the corner runner can never disagree about
which PDK is under test. Exported `PDK_ROOT`/`PDK` still win, which is what
makes the two paths equivalent:

```bash
export PDK_ROOT="$HOME/.ciel"      # optional — pins the smoke test to a
export PDK="gf180mcuD"             # specific install instead of the resolver
sim/smoke_test/run_smoke_test.sh
```

If the PDK genuinely cannot be found, the script says so and exits non-zero
before netlisting anything.

Pass `--no-write` to run the same check without appending to
`sim/smoke_test/smoke_test.log` — for a throwaway re-run, or for any automated
runner, which must never add machine-generated sections to an append-only
evidence log:

```bash
sim/smoke_test/run_smoke_test.sh --no-write   # same run, recorded nowhere
```

Expected: exits 0, no `Error:` lines, and `sim/smoke_test/smoke_test.log`
(committed, append-only — each run appends a new dated section rather than
overwriting prior runs, per `CLAUDE.md`'s "`sim/` results are append-only
evidence") ends with the operating-point voltages, e.g.:

```
v(vdd) = 3.300000e+00
v(vsample) = 3.300000e+00
v(vin) = 1.000000e+00
v(vhold) = 1.025608e+00
ngspice-46 done
```

`v(vhold)` sits just above `v(vin)` because the 10 kΩ pull-up pushes ~230 µA
through the closed switch's on-resistance. That the value is *not* exactly
1.0 V is the point: a real device model is in the loop.

## 6. Reproducibility checklist

- [ ] From a **new terminal** (nothing pre-sourced from a prior session),
      confirm `xschem --version` reports `XSCHEM V3.4.7` and `ngspice -v`
      reports `ngspice-46`.
- [ ] Confirm `echo $PDK_ROOT $PDK` resolves correctly after sourcing your
      shell profile snippet from §4 (not just in the shell where you first
      set it).
- [ ] Confirm the gf180mcu hash in use is the **pinned** one recorded in §1
      (the `open_pdks` line of the tree's `SOURCES` file), not silently "whatever `ls-remote`
      shows as newest today." `python3 sim/run_corners.py --check-env` checks
      this for you and prints `pins    : OK` only when every pin is satisfied;
      `pins    : DRIFT` (exit 1) names each tool that does not match.
- [ ] Run `sim/smoke_test/run_smoke_test.sh` **from a shell with nothing
      sourced** and confirm it exits 0 with no `Error:` lines in its output.
- [ ] Run `bash sim/selftest.sh` and confirm it ends with
      `PASS: harness is functional end to end and corner switching is verified.`

## 7. Next: the PVT corner harness

Everything above establishes the *install*. The evidence-producing harness
sits on top of it and resolves the same PDK by a superset of the same rules
(`GF180_PDK_PATH` -> `PDK_ROOT` + `PDK` -> `sim/pdk.local.json` ->
`sim/pdk.json` -> the usual install prefixes, `~/.ciel` first; among those, a tree at the pinned revision wins), so the
`PDK_ROOT`/`PDK` exports from §4 are all it needs:

```bash
python3 sim/run_corners.py --check-env   # what the harness resolved, or how to fix it
python3 sim/run_corners.py --print-env   # shell exports for the resolved PDK
source sim/env.sh                        # same exports, for xschem and ad-hoc ngspice
bash sim/selftest.sh                     # unit tests + PVT sweeps + the negative control
```

`bash sim/selftest.sh` takes ~2.5 minutes and is the acceptance step that
matters: passing §5 only proves the tools are installed. Stage 4 of the
self-test re-runs the same testbenches with every model section forced to
typical and requires them to **fail** — that is the only thing that
distinguishes a working corner sweep from one that silently simulates typical
everywhere.

`design/xschemrc` follows the same resolution order, so xschem and the corner
runner never disagree about which PDK is in use; compare
`sim/run_corners.py --print-env` against the path xschem reports if you ever
suspect they have drifted apart.

The full harness reference — PDK resolution, corner definitions, how to write
a testbench manifest, the corner-sensitivity guarantees, and why
`sim/smoke_test/` (this document's install check) and `sim/smoke-sar-bias/`
(the harness's own acceptance test) are two different things — is
[`sim/harness/README.md`](../sim/harness/README.md). The record format it
writes into is [`sim/README.md`](../sim/README.md).

## 8. Digital synthesis toolchain (`klt` + Yosys)

Everything above is the *simulation* toolchain. The block's digital partition
(`design/sar-logic/rtl/sar_ctrl.v`) additionally goes through RTL synthesis to
a gf180mcu standard-cell netlist, driven by
[`design/sar-logic/flow/synth_sar_ctrl.py`](../design/sar-logic/flow/synth_sar_ctrl.py)
over `klt synthesize` / `klt equiv` (Yosys + its bundled ABC). That path has
its own pin, because the committed netlists under
`design/sar-logic/flow/sar_ctrl/netlist/` are **byte-reproducible only on the
build that wrote them** (issue #316):

| Tool | Version | Source |
|---|---|---|
| klt (klayout-tools) | **0.4.0** (a `+g<sha>[.dirty]` local segment on `klt --version` is a checkout marker, not a different release, and is ignored) | [`2AMLogic/klayout-tools`](https://github.com/2AMLogic/klayout-tools) — **frozen synthesis provenance**: the build that minted the committed netlists, a source checkout of 0.4.0. A `klayout-tools==0.4.0` release has since been published to PyPI, but it has not been verified here to reproduce these bytes, so treat the PyPI wheel as unproven for `GateNetlistDriftTests` (see the note below the table) |
| Yosys (on `$PATH`, and used by `klt synthesize`) | **0.69+post** (git sha1 `143eb14f9cc55d6f8927e68523b0c9d2166ed02c`) | whatever your platform ships / a source build; `klt` resolves the `yosys` on `$PATH` |
| gf180mcu PDK | the same pinned hash as §1 (the standard-cell liberty files come from it) | `ciel enable`, see §3 |
| gf180mcu standard-cell libraries | `gf180mcu_fd_sc_mcu7t5v0` / `gf180mcu_fd_sc_mcu9t5v0`, `tt_025C_3v30` corner (DR-0023) | PDK, `libs.ref/…/lib/` |

**Which `klt` do I install?** It depends on the flow; this section's pin is
only the *synthesis* one, and it records history rather than an install
recipe. The layout/signoff flows pin their own builds (`klt` is on PyPI):

| Flow | Pin | Source of truth |
|---|---|---|
| DRC, LVS, parasitic extraction (`layout/`) and IR/EM (`layout/power/`) | `uv tool install klayout-tools==0.6.0` (plus pip `klayout==0.30.10`) | `layout/toolchain.json`, `layout/power/toolchain.json` |
| ERC (`layout/erc/`) and T1 signoff (`signoff/`) | git commit `67d617f` (`0.5.0+g67d617f899c7`), deliberately **not** 0.6.0 (`run_erc.py --check` fails under it; see `layout/toolchain.json`'s issue #426 paragraph) | `layout/erc/toolchain.json`, `signoff/toolchain.json` |

The nightly workflow (`.github/workflows/nightly-pdk.yml`, job `klt-layout`)
installs these pins into throwaway venvs and re-runs the layout runners.

**Why an exact Yosys pin, and not a floor.** `klt synthesize`'s output is a
function of the RTL *and* of the exact Yosys/ABC build that maps it. Two
Yosys releases produce two different netlists from identical RTL — both
correct, both fully mapped, both provably equivalent to the RTL, just mapped
differently. Measured on `sar_ctrl.v` with **no RTL change at all**:

| Library | Yosys 0.69+post (committed) | Yosys 0.33 |
|---|---|---|
| `mcu7t5v0` | 181 cells, `area_um2` 4961.152 | 189 cells, `area_um2` 5051.1552 |
| `mcu9t5v0` | 187 cells, `area_um2` 6917.7024 | 196 cells, `area_um2` 7050.3552 |

(Committed column: the evidence records
`design/sar-logic/flow/sar_ctrl/records/20260910-224930-2d1394f.*.md`. Yosys
0.33 column: measured on a host with native Yosys 0.33 while verifying issue
#314, reported in issue #316 — both netlists were `klt equiv`
`equivalent` to the RTL in that run, i.e. the difference is mapping, not
drift.)

So a fresh synthesis reproduces the committed bytes only on the pinned build.

**What that means for you if your Yosys is a different build.** You can still
run everything: the RTL flow, `klt equiv`, the gate-level testbenches. What
you must **not** do is re-run `synth_sar_ctrl.py` and commit the result as if
it were a drift fix — that would overwrite correct goldens with
version-skewed ones and silently re-baseline every downstream artifact built
on them (the STA and P&R records under
`design/sar-logic/flow/sar_ctrl/records/`, and `layout/adc-top/`'s reserved
footprint). Re-baselining the committed netlists is a deliberate act that
needs a decision record under `spec/decision-records/` and a re-run of those
downstream artifacts, not a side effect of a failing test.

**The pin is enforced, and the enforcement is honest about what it can
check** ([`sim/tests/test_sar_ctrl_gate_netlist.py`](../sim/tests/test_sar_ctrl_gate_netlist.py)):

| Check | What it asserts | Runs when |
|---|---|---|
| `PinnedToolchainProvenanceTests` | both committed netlists name one Yosys build, and that build (version + git sha) plus the klt version above appear **in this section** | always — no tools, no PDK needed, so this table cannot drift from the artifacts |
| `GateNetlistEquivalenceTests` | each committed netlist is still formally equivalent to the current `sar_ctrl.v` (`klt equiv`, `yosys-sequential`) | any `klt` + `yosys` + PDK — **this** is the RTL-vs-netlist drift guard |
| `GateNetlistDriftTests` | a fresh `synth_sar_ctrl.py` run reproduces the committed bytes | only on the pinned `klt`/`yosys` above; **skips** elsewhere, with an explicit "do not regenerate" message |

The Yosys row of the pin table is not hand-maintained trivia: the test parses
it out of the committed netlist's own `/* Generated by Yosys <version> (git
sha1 <sha> …) */` preamble and asserts both halves appear in this section, so
changing the netlists without updating this doc fails the test suite (and
vice versa). The klt row is the one value with no in-artifact witness — it
lives as `PINNED_KLT_VERSION` in that test file, sourced from the evidence
record `design/sar-logic/flow/sar_ctrl/records/20260910-224930-2d1394f.mcu7t5v0.md`,
and is asserted against this section the same way.

Verify your own install against the pin:

```bash
klt --version     # synthesis pin only: expect klt 0.4.0 (a +g<sha>[.dirty] suffix is fine)
yosys -V          # expect Yosys 0.69+post (git sha1 143eb14f9cc5…) for byte-exact repro
python3 -m unittest -v sim.tests.test_sar_ctrl_gate_netlist
```

On a matching host every check above runs. On any other build
`GateNetlistDriftTests` reports `skipped` with the reason, and the two checks
that do not depend on the toolchain version still run — that is the intended
outcome, not a failure to fix. (A fourth class, `YosysBuildParsingTests`,
unit-tests the version gate's own banner parsing and prefix-tolerant sha
comparison, so the gate above is itself verified rather than trusted.)
