2AMLogic/gf180-sar-adc/sim/characterization-summary.md

# Full-ADC characterization summary — one row per ratified spec line

Issue #174 (T1 item 8, `2AMLogic/gf180-sar-adc#169`'s closing verdict row 8).
This is the single aggregated, current answer to "what is this converter's
measured performance, right now, against the ratified target spec" — every
row of `README.md#target-specification` (DR-0006), its **latest** verified
value, its verdict, and a dated citation to the record that produced it.

**This block is mixed-signal, and so is this document.** The per-spec-row
table below is the **analog partition**'s characterization; the
[digital partition](#digital-partition-sar_ctrl_a--fmax-area-and-power-across-the-corner-set)
(the routed `sar_ctrl_a` SAR-sequencer macro) has its own section further
down carrying what T1 item 8 asks of a digital partition specifically —
Fmax, area and power across the corner set, not just functional pass/fail.
`signoff/gf180-sar-adc.manifest.json` cites this one document **twice**,
once per partition, through two separate generic evidence envelopes under
`signoff/evidence/` (issue #339); each envelope names the section it
asserts, so neither partition's row is graded on the other's evidence.

**This document creates no numbers of its own.** It is a pointer table, not a
re-derivation: every figure below is transcribed from an append-only `sim/`
record or from `spec/testbench-suite-memo.md` / `sim/extracted-delta-summary.md`
/ `sim/issue-17-acceptance-review.md`, and the citation in the "Source" column
is where a reader goes to see the full methodology, the whole PVT grid, and
the raw per-corner data — not just this row's headline number. Where
schematic-level and post-layout (extracted) results both exist, the extracted
result is the one this document reports as governing (the precedent
`sim/extracted-delta-summary.md` §7.1 states and `README.md`'s own Status
table already follows), with the schematic number carried alongside it.

## Freshness

**As of commit `93ddfe3` (2026-09-21).** This is not merely a statement that
the source documents below exist — it is a re-read of each of them against
that exact commit, done for this document. The re-read is the reason the
`signoff/` manifest may cite this file at all: a generic evidence envelope
asserting `status: "pass"` over a document nobody has re-read is a claim
about a date, not about a design (issue #339).

| Source document | Re-read against | What changed since the previous (2026-08-25, `ed74762`) re-read |
|---|---|---|
| `README.md#target-specification` | `93ddfe3` | **Exactly one change to the ratified table since the previous re-read: a new `V_CM` row** (PR #262, DR-0026) — the row this document was missing, added below. Every other target-spec row is byte-unchanged (`git diff ed74762..93ddfe3 -- README.md`); the one other table row that moved is the **Status** table's `Schematics` row (PR #276/#279, the digital partition's RTL → synthesis → P&R), which is not a spec row and is aggregated in the digital section instead |
| `spec/testbench-suite-memo.md` | `93ddfe3` | §12 item 3 rewritten by PR #262: "V_cm is an ideal source" is no longer *unbudgeted* (DR-0026 derives `Z_vcm ≤ 220 Ω` / `C_dec ≥ 40 nF`) and is no longer *assumed conservative* (`sim/vcm-drive-impedance/` measures a real ≈ 0.2 LSB shift at the budget). Every schematic-side number in the table below should be read accordingly — see the new `V_CM` row |
| `sim/extracted-delta-summary.md` | `93ddfe3` | Unchanged since `ed74762` (PR #258, DR-0025). §4.13's clean-tree re-takes remain the governing extracted vintage for all five extracted campaigns |
| `sim/issue-17-acceptance-review.md` | `93ddfe3` | Unchanged since its 2026-08-14 "8 of 8 AC PASS" disposition update — re-verified current, not stale |
| `sim/device-characterization-report.md` | `93ddfe3` | Unchanged since 2026-07-31 — device-level scope, explicitly not full-ADC; this document is the full-ADC companion, not a replacement |
| `design/sar-logic/flow/sar_ctrl/` + `sim/sar-logic-*` | `93ddfe3` | **Entirely new since the previous re-read**: RTL → synthesis → equivalence → P&R → post-route STA for the digital partition, plus seven gate-level SPICE-replay campaign directories (six with committed records; `sim/sar-logic-timing-gates-bad/` holds a testbench and no record yet). Aggregated in the new [digital-partition section](#digital-partition-sar_ctrl_a--fmax-area-and-power-across-the-corner-set) |

### Partial update — 2026-09-23, issue #381 (NOT a new full re-read)

**The full re-read above still stands at `93ddfe3` (2026-09-21); this is a
narrower, declared update on top of it, not a replacement for it.** Issue #381
re-extracted `layout/adc-top/parasitics/` against the post-DR-0035 /
post-DR-0037 geometry and re-ran all five extracted campaigns over the same
PVT grids they already covered. What this pass touched, and only this:

- **The five extracted-campaign rows** (ENOB, SFDR, INL/DNL, `Gain error,
  systematic`, `Input structure`'s post-layout `R_on`, `Power @ 1 MS/s`) now
  quote and cite the new governing records; each also retains the record it
  supersedes. Per-campaign before/after tables:
  [`sim/extracted-delta-summary.md`](extracted-delta-summary.md) §4.14.
- **The `Area` row** now quotes `layout/adc-top/area.json`'s current
  `block_total` (151,827.342 µm²), re-derived at build time, rather than the
  pre-#356 150,536.239 µm².
- **No verdict moves in either direction.** Every row that passed still
  passes; ENOB, SFDR and Area still FAIL, on the same rows and at the same
  worst corners.

**The currency gap this pass declared is now closed** by the #389 pass below,
which reconciled the `Supply` row against PR #387's rewrite of
`README.md#target-specification`. It is no longer a gap this document carries.

### Partial update — 2026-09-23, issue #358 (NOT a new full re-read)

**The full re-read above still stands at `93ddfe3` (2026-09-21); like the
#381 pass above, this is a narrower, declared update on top of it.** Issue
#358 — DR-0026's named follow-up — re-ran the ratified decks against a real
external `V_cm` drive network at DR-0026's derived budget, over each deck's
own governing PVT grid, as paired same-commit arms. What this pass touched,
and only this:

- **The `V_CM` row** now carries a measured full-PVT result against the
  ratified rows, replacing the one-temperature / one-supply exploratory
  sensitivity sweep it previously cited. Findings, method, and what was not
  run: [`sim/vcm-full-pvt/README.md`](vcm-full-pvt/README.md).
- **The follow-up list above** that named #358 as an open gap.
- **No verdict moves**, no row was added or removed, no other row's value or
  citation was touched, and no bound, target or manifest check was changed.
- `spec/testbench-suite-memo.md` §12 item 3 was rewritten by the same pass, so
  the Freshness table's row for that document above (which still describes
  PR #262's version of §12 item 3, citing the ≈ 0.2 LSB exploratory figure)
  should be read against the new §12 item 3 rather than the old one.

**Gaps this pass declares rather than closes**: the campaign's **extracted**
arms ran on the pre-#381 extraction vintage, which the #381 pass above
superseded while #358 was in review — so the `V_cm` delta has *not* been
re-taken on the current governing extraction at the time of that pass — **since
closed by the #392 pass below**. `ENOB`/`SFDR` and the extracted power deck were not re-run
against the network at all.

### Partial update — 2026-09-23, issue #389 (NOT a new full re-read)

**The full re-read above still stands at `93ddfe3` (2026-09-21); like the two
passes above, this is a narrower, declared update on top of it.** PR #387
(issue #379) rewrote `README.md#target-specification`'s **Supply** row after
that re-read, to carry [DR-0036](../spec/decision-records/DR-0036-vdd-decoupling-budget.md)'s
external decoupling figure (`≥ 40 nF` at the `V_DD` pin), its source-impedance
budget (`≤ 3 Ω` in the switching band, `Z_vdd ≈ ≤ 1.6 Ω @ 2 MS/s` at the
stretch rate) and a required-but-unsized on-die local decoupling term inside
`ADC_BLOCK`. This pass reconciles this document's `Supply` row with that row.
What it touched, and only this:

- **The `Supply` row** now states all three clauses of the post-#387 ratified
  row, reports the ±10 % window and the DR-0036 budget as two separately
  verified halves, and cites
  [`sim/adc-rail-current/`](adc-rail-current/records/20260923-002945-1cefe83.md)
  for the 34.383980 mA CDAC switching peak (and the 39.5421 / 40.120 µA
  averages) the budget is derived from.
- **The "not yet measured" list** gained the unsized on-die `ADC_BLOCK`
  decoupling term, which is a required deliverable with no value to put in a
  row.
- **The Freshness gap #381 declared** — this exact reconciliation — is removed
  above, because this pass closes it.
- **No verdict moves, no other row was touched, and no bound, target or
  manifest check was changed.** No figure in this pass is new: every number
  is transcribed from DR-0036, from `sim/adc-rail-current/`'s committed record
  or from `layout/power/`'s, exactly as this document's own "creates no
  numbers of its own" contract requires.

**DR-0036 is *proposed*, not operator-ratified.** Its own status line reads
"proposed — requires operator sign-off", and `README.md`'s Supply row embeds
that caveat inline. The `Supply` row below therefore reports **against** the
proposed budget while saying it is unratified — the same footing on which the
`Area` row reports DR-0024's proposed `< 0.16 mm²`. Nothing here should be read
as operator sign-off having happened.

**Gaps this pass declares rather than closes**: when this pass was written, no deck
drove `V_DD` through a real source network at the budget (every deck modelled
the supply islands as ideal DC sources), so the budget had **no measured
verdict** — filed as **#393**, **since run** on the four governing extracted
decks (the `V_CM` row's #358 done for this rail; no ratified row responds, see
the `Supply` row; the four schematic pairs were not run); the switching event's
charge is bounded from a window average rather than integrated (**#386**); and
DR-0036 step 8's 523 Ω effective resistance was read off the **pre**-Metal2-strap
`layout/power/` solve, which #378 / PR #388 superseded *after* DR-0036 merged
— DR-0036's own Consequences require whichever of the two is settled second to
re-read the other, and that re-read has not happened.

### Partial update — 2026-09-24, issue #395 (NOT a new full re-read)

**The full re-read above still stands at `93ddfe3` (2026-09-21); like the
three passes above, this is a narrower, declared update on top of it.** The
`V_CM` row's #358 campaign published its power arm with the sign of `i(vcms)`
reversed: the generated deck's V_cm ammeter (`sim/vcm-drive-impedance/gen_vcm_variant.py`)
was wired positive-terminal-to-the-source, the reverse of the ideal source
line it substitutes for, so the `p_vcm` term folded into `p_total` carried the
wrong sign in the V_cm arm and in **only** that arm. What this pass touched,
and only this:

- **The `V_CM` row's Power sentence.** `worst p_total 207.884 → 223.961 µW,
  margin 4.81× → 4.47×` is withdrawn and replaced by the corrected re-run,
  `207.884 → 203.608 µW, margin 4.81× → 4.91×`. The direction of the effect
  reverses: at DR-0026's budget the network leaves worst-case total power
  marginally *lower* than the ideal source does, because `C_dec` supplies the
  switching transients the pin would otherwise deliver.
- **Nothing else.** No other row, value, verdict, citation, bound, target or
  manifest check was touched. The `Power @ 1 MS/s` row itself is **not**
  affected: it cites the extracted governing record, which was never part of
  the V_cm campaign, and the campaign's own ideal-source control (207.884 µW)
  carries no ammeter and is unchanged.

**No verdict moves.** `p_vcm_*` carries no bound in
`sim/adc-power/testbench/tb.json`, and every `p_total_*` stayed an order of
magnitude inside the 1 mW check under both the wrong and the right sign, so
all 27 points read PASS either way. The error was a wrong *number* in a
passing row, not a missed failure.

Evidence: the superseded record is
[`20260923-114021-836a876`](adc-power/records/20260923-114021-836a876.md)
(kept, per this repo's append-only `sim/` convention); the corrected one is
[`20260924-041435-cda7de5`](adc-power/records/20260924-041435-cda7de5.md),
which names it in its own `Supersedes` field. Mechanism, the corrected
paired table, and the reproduction fidelity of the unchanged columns:
[`sim/vcm-full-pvt/README.md`](vcm-full-pvt/README.md) §"The power arm's sign
error".

**Gaps this pass declares rather than closes**: all three gaps the #358 entry
declared: **#392 has since been closed** (see the #392 pass below); `ENOB`/`SFDR` plus the
extracted power deck are still never run against the network. This pass re-ran exactly
one arm of one deck and corrected exactly one sentence.

### Partial update — 2026-10-07, issue #393 (NOT a new full re-read)

**The full re-read above still stands at `93ddfe3` (2026-09-21); like the
four passes above, this is a narrower, declared update on top of it.** Issue
#393 — the `V_DD` counterpart of #358, filed by the #389 pass above — replaced
the ideal supply-island sources in the four governing **extracted** decks with
one shared pin network at the edge of
[DR-0036](../spec/decision-records/DR-0036-vdd-decoupling-budget.md)'s budget
(`Z_vdd = 3 Ω`, `C_dec = 40 nF`) and ran each deck as paired same-commit arms
over its own grid. What this pass touched, and only this:

- **The `Supply` row** gained a `(2b)` paragraph carrying the measured result,
  and its verdict and citation cells now say the converter's sensitivity to the
  budget is measured (nil on every ratified row) while the budget's own sag
  still has no measured verdict (**#386**). Findings, method and what was not
  run: [`sim/vdd-full-pvt/README.md`](vdd-full-pvt/README.md).
- **The #389 entry's gaps paragraph** and **the "not yet measured" list** now
  mark #393 as run on the extracted decks, without striking the gap they
  originally declared.
- **No verdict moves.** No ratified row changes status in either arm; ENOB,
  SFDR and Area still FAIL, at the same worst corners. No row was added or
  removed, and no bound, target or manifest check was changed. DR-0036 stays
  *proposed*, and its 40 nF / 3 Ω figures and 0.5 LSB denominator are
  unchanged.

**Gaps this pass declares rather than closes**: the four **schematic** pairs
were wired but not run; the network carries no package inductance, on-die rail
resistance or on-die decoupling; the switching event is still bounded rather
than integrated (**#386**); and the gain-error ideal arm reproduces its cited
record's term only to 0.000981 → 0.001006 LSB (same PASS, same corner, not
bit-identical, cause not isolated). *(2026-10-09: cause since isolated by
issue #459. It is a cross-environment solver-path difference, not a deck
change. See the #459 entry below.)*

### Partial update — 2026-10-08, issue #432 (NOT a new full re-read)

**The full re-read above still stands at `93ddfe3` (2026-09-21).** Issue #428
moved T1 item 7 (analog) to `met` on a block-scoped `klt pex` run, and this
document still described `klt pex` as structurally blocked. Issue #432 touched
exactly two places here, both in the ANALOG half: the `klt pex (T1 item 7)`
bullet of "What is not yet measured" (a dated update appended; the older
comparator-interface failure labelled historical) and the PR #184 line in the
history list above (labelled historical). Plus this entry.

- **Scope of the new fact**: one nominal PVT point of the declared 117-point
  grid; the full-grid fleet submission failed with
  `batch_runner_version_mismatch`. Record:
  [`sim/adc-block-pex/records/20261008-185501-c618a90d.md`](adc-block-pex/records/20261008-185501-c618a90d.md).
- **No verdict moves.** No per-spec-row cell, bound, target or manifest check
  changed; ENOB, SFDR and Area still FAIL. The new run's delta rows are not
  ratified-row measurements. No `sim/` record was edited.

### Partial update — 2026-10-09, issue #437 (NOT a new full re-read)

**The full re-read above still stands at `93ddfe3` (2026-09-21).** Issue #437
added `sim/tools/check_characterization_summary.py`, a headless check of the
`Source (dated)` column of the per-spec-row table (see "How this document is
kept in sync" below). Every sim-record link in that column now carries a
citation-local `<!-- evidence role=… mode=… -->` marker (hidden when rendered).
Running the check for the first time found three currency defects. All three
are fixed here, from committed records only, with no new simulation:

- **`Supply` row rendering**: an unescaped `|Δ|` in its value cell split the
  row into 7 cells. GitHub drops cells beyond the header's 5, so the rendered
  row showed `Δ` as its Verdict and a fragment of the value prose as its
  Source, and the real Verdict and Source cells were not shown. Now escaped.
- **`INL / DNL` row, 3σ mismatch figure**: quoted the *pre-resize*
  `σ_u = 0.737 %` margins (5.96σ / 11.9σ, record `20260801-093800-c033611`).
  Now quotes the as-built `σ_u = 0.5000 %` `klt yield` figures (8.812σ /
  17.627σ, records `20260816-125421-737d16e` + `20260812-132011-f613571`). The
  old figures are kept in the cell as history. The same cell called the
  PR #149 `klt yield` bundle pre-resize, which its own record contradicts for
  the DNL/INL measurements. That sentence is corrected and the old wording is
  stated. No verdict moves: both vintages pass.
- **`V_CM` row**: the Power pair's network arm `20260923-114021-836a876` was
  cited without its issue #395 successor `20260924-041435-cda7de5`, which the
  value cell already quoted. The successor is now cited and the old arm is
  marked superseded.

Every other newer same-campaign record the check surfaced was classified, from
its own provenance, as a control arm, a sensitivity arm, a candidate design or
a smoke subset rather than a replacement. Each has an exact, reasoned entry in
`sim/tools/characterization_citation_exceptions.json`. Two of those entries
point at follow-ups filed by this pass instead of resolving anything: **#459**
(the #393 gain-error ideal arm does not bit-reproduce its citation) and
**#460** (the `Clock` row's record predates #371's deck correction).
**No verdict, bound, target or manifest check changed.** **Coverage limits,
stated**: the check covers only this one column's links into
`sim/<campaign>/records/`. Plain-text record IDs (such as the `Latency` row's),
links to `layout/` records, the narrative sections and the digital-partition
section are not checked. The check orders records by filename timestamp and
follows declared `Supersedes` edges. It does not judge whether a figure is
transcribed correctly.

### Partial update — 2026-10-09, issue #459 (NOT a new full re-read)

**The full re-read above still stands at `93ddfe3` (2026-09-21).** Issue #459
asked why the #393 ideal-supply control arm
(`sim/dr0014-sampling/records/20261007-071907-800bf53.md`) reads the
`Gain error, systematic` term at 0.0010063 LSB while the governing record
(`…20260923-104443-904af96.md`) reads 0.000981002 LSB at the same corner
(`ff_-40c_3.63v`). This was answered from committed records, snapshots and
raw corner logs only. **No simulation was run.** Full analysis, scripts and
their verbatim outputs:
[`sim/dr0014-sampling/investigations/20261009-issue-459-gain-error-control-arm-delta.md`](dr0014-sampling/investigations/20261009-issue-459-gain-error-control-arm-delta.md).

- **Cause.** The two runs used different ngspice execution environments.
  The governing run was on the `/home/ubuntu` host family (Python
  3.12.3, `ngspice-46`, no compatibility mode). The control arm was on a
  `/Users/rwalters` workstation (Python 3.14.8, `ngspice-46`, front-end
  compatibility mode `hs a`). The OS of each (Linux, macOS) is inferred from
  those install paths only, and where `hs a` was set is not recorded. Here
  "environment" means everything the records do not pin: the ngspice
  build/platform, the `hs a` mode, the ngspice init state and the PDK model
  bytes at each install path (only the open_pdks commit is recorded). From
  identical recorded inputs (deck, manifest, harness, PDK pin), the two
  environments reach t = 0 operating points that differ only at
  floating-point residue (≤ 8.7e-11 LSB on near-zero readout nodes). At
  24 of 27 corners the adaptive transient then takes a different
  accepted-timepoint path. At `ff_-40c_3.63v` this shifts all five
  `tp_inj_p_l*` levels by about −0.0067 LSB (≈ 24 µV, inside the default
  `RELTOL`/`VNTOL` band). The term is max − min, so the common part cancels
  and the +2.53e-5 LSB level-to-level residue is left. That residue is the
  whole gap.
- **Excluded.** Each of these is excluded with committed evidence:
  - a deck change: both snapshots hash to the recorded `4fea809d…`. The
    `git diff 904af96..800bf53` deck change is the governing run's dirty
    tree, later committed in `96a8546a`;
  - the manifest: unchanged;
  - the harness: no commits between the two runs;
  - transcription: all 2,322 record cells match the logs;
  - dirty-tree status: a dirty-vs-clean extracted pair is bit-identical;
  - run-to-run non-determinism: six same-environment repeat pairs, on both
    host families, are bit-identical.
- **Not isolated.** Committed records cannot separate the ngspice
  build/platform, the `hs a` front-end mode, the init state and the PDK
  install bytes, because they always change together. At three corners
  the two runs agree on all 43 measurements to ≤ 3.83e-7 LSB (plus one
  last-printed-digit count, 1.0e-5 LSB, on `dres_dc1_lsb` at
  `ff_27c_3.63v`), against 1.0e-4 to 6.9e-3 LSB at the other 24. That is
  consistent with both environments elaborating the same circuit, models
  and options, but does not prove it. The one
  pinned-binary A/B that would split the parts could not run this pass: this
  worker has `ngspice-42` (`pins: DRIFT`), and the fleet refused the 0.7.0
  client the same day (#430). The investigation records this as a
  follow-on. Records also do not render platform, hostname, the full ngspice
  banner or the ngspice init state.
- **Inherited wording explained.** The control arm's `Netlist provenance`
  says "dirty working tree at `904af96`". That clause was copied verbatim
  from the governing record by `sim/vdd-full-pvt/run_full_pvt.sh` and
  describes the governing run. The control arm's own tree was clean
  (`800bf53`).
- **Citation decision.** The `Gain error, systematic` row keeps
  `20260923-104443-904af96` as governing, at 0.000981002 LSB. The control
  arm confirms its verdict, worst corner and figure to 2.6 % from a clean
  tree. It does not supersede it. The row's value cell gained one sentence.
  The exact #437 exception tuple
  `(Gain error, systematic, extracted, …104443-904af96.md, …071907-800bf53.md)`
  is kept, and its reason now names the cause. **No verdict, bound, target,
  measurement definition or manifest check changed. No `sim/` record was
  edited.**

### Currency defects found by the 2026-09-21 re-read, and their disposition

The 2026-08-25 hand re-read (`sim/t1-checklist-reread-20260825.md` §8) scored
this document PASS with **one named currency defect**. That defect and five
more found by this pass are settled here, so the `pass` the signoff envelope
asserts is a statement about the document's *current* contents rather than
about the date it was last touched:

1. **`Gain error, mismatch` still reported `FAIL` at 2.12σ for a reason this
   document itself falsified** (§8 of the 2026-08-25 re-read; filed as
   **#239**). **Settled before this pass**, by PR #241 and PR #243 — the row
   below reads `PASS as built` at `sigma_to_spec = 3.13` and cites the
   governing post-resize record. Re-verified against `93ddfe3`: the row's
   stated reason and its citation now agree with each other and with
   `README.md`. #239 is closed.
2. **The Freshness banner named `607d6e6` (2026-08-16)** while the table
   below cited records dated 2026-08-25 — the banner was falsified by the
   document's own contents, which is exactly the defect class (1) is.
   **Settled**: re-read and re-stamped against `93ddfe3` above.
3. **No `V_CM` row**, although `README.md#target-specification` grew one on
   2026-08-25 (DR-0026) and this document's stated contract is one row per
   ratified table row. **Settled**: row added below.
4. **The `Clock` row cited a superseded record.**
   `sim/sar-logic-timing/records/20260802-102758-d8a363d.md` carries
   `Supersedes: 20260801-033032-06bad60`, and `06bad60` was what this
   document cited — precisely the drift "How this document is kept in sync"
   below tells a reader to file. **Settled**: re-pointed, with the
   superseded record still named.
5. **The `Resolution` / `Latency` / `Interface` rows cited the pre-DR-0014
   controller's functional record.** `20260801-041242-96c2ea7` is not
   formally superseded (its successor's `Supersedes` chain runs through a
   different record), but it was taken on the DR-0006-era sequencer, and the
   controller this design now builds is DR-0011 + DR-0014's.
   **Settled**: the current controller's record is now the one quoted, with
   the original retained as the first proof.
6. **Three places still described PR #149 as unlanded.** It merged as
   `617de90` on 2026-08-17 — eight days *before* the previous re-read — so
   this document reported an open PR as open for a month after it closed.
   **Settled**, and sharpened: the format gap #149 closed has been replaced
   by a narrower currency gap (that envelope is at the pre-resize `C_u`),
   which is now what the three places say.

Two further things this pass found and **did not** absorb, because they are
outside an aggregation-and-assertion pass and are filed instead: the same
superseded `06bad60` / pre-DR-0014 `96c2ea7` citations also appear in
`spec/testbench-suite-memo.md`'s coverage map, `spec/timing-budget-memo.md`
and `docs/chipalooza/challenge-3-proposal.md` (**#357**), and the ADC-level
decks have not been re-run against a real V_cm network at full PVT, which
DR-0026 itself names as a follow-up (**#358**).

**#358 is closed as of 2026-09-23** and the `V_CM` row below now carries a
measured result rather than that gap: four decks re-run as paired
same-commit arms against a real V_cm network at DR-0026's budget, over their
own governing grids, including the **extracted** netlist the `INL / DNL` row
is cited from. **No ratified row moves outside its bound** — and the
worst-case margin that statement rests on is now a measured number rather than
an untested assumption: **0.2126 LSB** of remaining headroom against the
ratified `< 1 LSB` window (`dnl_t767_t768_lsb`, `ss_125c_2.97v`), which is a
materially stronger statement than the one this list recorded as missing.
Three gaps are carried forward rather than closed: two decks named there are
still not re-run (`ENOB`/`SFDR`, and the extracted power netlist), both wired
into `sim/vcm-full-pvt/run_full_pvt.sh` with the reasons recorded in
[`sim/vcm-full-pvt/README.md`](vcm-full-pvt/README.md); and that campaign's
**extracted** arms were taken on the pre-#381 extraction vintage, which
issue #381 superseded while #358 was in review, so the V_cm delta has not been
re-taken on the current governing extraction at that time — now done, see the
#392 pass below.

### Partial update — 2026-10-15, issue #392 (NOT a new full re-read)

**The full re-read above still stands at `93ddfe3` (2026-09-21); like the
#381 and #358 passes above, this is a narrower, declared update on top of
it.** Issue #392 re-took the extracted `adc-inl-dnl` V_cm pair on the post-#381
netlist, over the same 27-point grid, as paired same-commit arms on the Spot
batch fleet (`klt sim --batch-set`, issue #505's per-supply export). What this
pass touched, and only this:

- **The `V_CM` row's extracted-netlist figures** now quote the new pair
  [`20261015-000027-74685b3`](adc-inl-dnl/records/20261015-000027-74685b3.md) (ideal control) and
  [`20261015-001125-74685b3`](adc-inl-dnl/records/20261015-001125-74685b3.md) (network at DR-0026's budget) in
  place of the pre-#381 pair's headroom, which is retained as history.
- **No verdict moves**, no bound, target or manifest check was changed, and no
  other row was touched.

### Partial update — 2026-10-15, issue #439 (NOT a new full re-read)

**The full re-read above still stands at `93ddfe3` (2026-09-21).** Issue #439
re-took the block-scoped `klt pex` run behind T1 item 7 (analog) across the
committed 117-point grid on the Spot batch fleet. The #432 pass above had
recorded it at one nominal PVT point. This pass touched exactly one place, the
`klt pex (T1 item 7)` bullet of "What is not yet measured", where a dated
update was appended and the earlier one-point scope was marked superseded.
Plus this entry.

- **Scope of the new fact**: all 117 PVT points of the committed request,
  468/468 delta rows passing. Record:
  [`sim/adc-block-pex/records/20261015-071816-0dacd542.md`](adc-block-pex/records/20261015-071816-0dacd542.md).
- **No verdict moves.** No per-spec-row cell, bound, target or manifest check
  changed, and ENOB, SFDR and Area still FAIL. The delta rows are not
  ratified-row measurements. No `sim/` record was edited.

**Toolchain provenance of the analog partition's extracted numbers (issue
#189, 2026-08-21)**: every extracted row below
that cites a post-#215 (`…076d545`) or post-#228 (`…bbed59c`) record — i.e.
every extracted row currently marked governing in this table — was measured
against a deck generated from a `layout/toolchain.json` `klt` pin of
`85b8125fb012f6038883ab884490a3caa3d41db3` (superseding `875eac3`, PR #195),
which carries junction area/perimeter (`AS=`/`AD=`/`PS=`/`PD=`) on every
extracted MOS device — a real SPICE-model input, not cosmetic text. Full
accounting of how that pin bump reached every currently-governing extracted
number (and the one isolated, same-geometry delta it produced on its own):
`sim/extracted-delta-summary.md`'s "Toolchain provenance" banner, immediately
before its §1.

**Toolchain provenance of the digital partition's numbers**: `klt 0.4.0`
(`+g74af2bbbb2bd` for the post-route STA runs), OpenROAD
`26Q3-1510-g6cb3f2b704`, yosys `0.69+post`, gf180mcu `gf180mcuD` at
open_pdks `c6d73a35f524070e85faff4a6a9eef49553ebc2b` — each response JSON
carries its own `provenance` block, and the digital section below names the
file behind every figure.

**PRs incorporated when this document was first written (2026-08-16),
retained as the record of where two of its rows came from** — not a
statement about what is current:

- **PR #182** (issue #172, T1 item 6): `klt yield`-format statistical evidence
  for the Gain error, mismatch / Offset error / CMRR rows —
  `sim/mc-cdac-mismatch/yield-evidence/`, `sim/comparator-offset-mc/yield-evidence/`.
  This is where the **Gain error, mismatch 2.12σ FAIL** finding came from —
  a real, newly-quantified, non-layout finding. **That finding is now
  superseded**: DR-0019's resize is built, and the row below reads
  `PASS as built` at 3.13σ (the currency defect #239 named, and settled).
- **PR #184** (issue #173, T1 item 7): a genuine `klt pex` run against the
  post-layout comparator — `sim/comparator-pex/`. It fails structurally (a
  DUT-interface mismatch `klt pex` cannot bridge), re-grading item 7 from
  "N/A by construction" to "tried, blocked, filed upstream" — see the Rate /
  comparator-inclusive-extraction row's Notes below.
  *(Historical: this comparator-scoped failure was later superseded for item
  7 by the block-scoped run in the 2026-10-08 update under "What is not yet
  measured" below.)*

**Known incompleteness, stated rather than silently absorbed**: the INL/DNL
row's own `klt yield` reformat (**PR #149**) **has landed** — `617de90`,
2026-08-17, `sim/mc-cdac-mismatch/yield-evidence/klt-yield-report.json`,
carrying `dnl_at_256_lsb_*` / `inl_at_256_lsb_*` measurements at N = 20 000
with a seeded negative control. So the *format* gap this document used to
report is closed. What replaces it is a **currency** gap, which is a
different and smaller thing: that envelope was built at the **pre-resize**
`C_u = 17.24 fF` this design no longer draws, so it is superseded evidence,
and **no post-resize `klt yield` envelope of the INL/DNL row exists**. The
INL/DNL figures below are therefore still reported from the post-resize
`sim/adc-inl-dnl/` records directly, and `signoff/`'s item 6 cites the
post-resize `yield-evidence-177/` envelope (the Gain-error-mismatch row)
rather than this one.

**Update (issue #656)**: that wording is retained above as history. A
post-resize `klt yield` envelope of the INL/DNL row now exists:
`sim/mc-cdac-mismatch/yield-evidence-656/klt-yield-report.json` (record
[`20261028-190000-5489f3a`](mc-cdac-mismatch/records/20261028-190000-5489f3a.md)),
built from the committed as-built `σ_u = 0.5000 %` N = 20 000 population,
measuring the worst-over-codes `max_dnl_lsb` / `max_inl_lsb` against the
ratified ±1 LSB row (DR-0006): `status: pass`, `sample_size` sufficient,
`sigma_to_spec` 7.66 (DNL) / 10.60 (INL); the ±1 LSB INL negative control is
not detected (stated in the record). Behavioral CDAC-only model, nominal PVT.

## Per-spec-row status

| Spec row (README target) | Target | Latest verified value | Verdict | Source (dated) |
|---|---|---|---|---|
| Resolution | 10 bit | 10 bits resolved (architectural, `sar-logic` decode proof), re-confirmed on the **current** DR-0011 + DR-0014 controller | **PASS** (rung-1 ideal sequencer model, DR-0010; the rung-2 gate-level re-check is in the digital-partition section below and is **not** closed) | [`sim/sar-logic-functional/records/20260802-110241-131989b.md`](sar-logic-functional/records/20260802-110241-131989b.md) <!-- evidence role=governing mode=schematic --> (**current controller**, DR-0011 bit-trial switching + DR-0014 two-phase sample / four-leg one-hot; supersedes `20260802-094246-16ec0f1`); [`sim/sar-logic-functional/records/20260801-041242-96c2ea7.md`](sar-logic-functional/records/20260801-041242-96c2ea7.md) <!-- evidence role=historical mode=schematic --> (first proof, DR-0006-era sequencer — retained, not superseded via a `Supersedes` chain, but predates DR-0014) |
| Rate (1 MS/s) closure | 1 MS/s (2 MS/s stretch) | Settling τ 1.258 → 1.560 ns; comparator delay 0.863 → 1.257 ns; all three post-layout inputs (`R_WORST_BIT_OHM` 648 Ω, `C_WORST_BIT_F` 2.40712 pF, `T_COMP_REGEN_NS` 1.257 ns) | **PASS — all three inputs post-layout** (2026-08-14, issue #116; closes the sync lag issue #174 fixes in `README.md`) | [`sim/timing-budget-closure/records/20261020-175429-bc92f79.md`](timing-budget-closure/records/20261020-175429-bc92f79.md) <!-- evidence role=governing mode=extracted --> (re-qualified under open_pdks `f6eeac7`, issue #595; supersedes `20260814-220124-f613571`); disposition: [`sim/issue-17-acceptance-review.md`](issue-17-acceptance-review.md) AC7 |
| ENOB @ Nyquist | > 9.0 (> 9.5 stretch) | **Re-run at the physically-implemented DR-0019 resize (`C_u = 35.6528 fF`, issue #204): schematic 8.5064 bits worst (`ss_125c_2.97v`)** — a regression from the pre-resize 9.163 bits, and now below the > 9.0 target at 2 of 9 grid points (`ss_125c_2.97v` 8.5064, `ss_125c_3.30v` 8.968). **The extracted (governing) side has now been re-taken at the same resize (issue #218): 8.857 bits worst (`tt_125c_3.63v`), below the > 9.0 target at 2 of 9 points (`tt_125c_3.63v` 8.857, `ss_125c_2.97v` 8.969)**, against the 9.103 bits the pre-resize extraction reported — all nine corners degrade, by 0.088–0.878 bits. The extracted grid's worst corner is *not* the schematic's: at `ss_125c_2.97v` the extracted core reads 8.969 against schematic 8.506 **Re-taken again after issue #215's comparator load-resistor fold and supply-corridor re-derivation (issue #224): 8.857 bits worst (`tt_125c_3.63v`) and 60.40 dB worst SFDR — byte-for-byte the same worst-corner figures as the pre-#215 vintage.** Only 2 of 9 corners move at all (`ss_125c_3.63v` +0.026 bits, `tt_125c_2.97v` +0.040 bits, both improving, neither a worst corner). **Re-taken again as a clean-tree re-take (issue #249): 8.857 bits worst (`tt_125c_3.63v`), byte-identical per-sample codes and figures at all nine corners** — the superseded `20260817-215657-076d545` was taken against a dirty working tree and was not citable as a clean-tree result; the design is unchanged, so this re-take confirms rather than moves the figure. **The candidate fix (#211's orthogonal control: the acquisition-leg T-gate widened 2.068×, cited at the end of this row) is evaluated and NOT adopted (issue #249, DR-0025)**: items 1/2/4 of the five deferred measurements cost little, but item 5's `klt`-verified re-layout shows the same width change grows `adc_block` area +17.00 % (150,536.239 → 176,126.8006 µm²), pushing it +76.1 % over the still-ratified `< 0.1 mm²` Area target and +10.1 % over even DR-0024's still-unratified proposed `< 0.16 mm²` relaxation — adopting it would trade this row's FAIL for a worse one on Area. `CDAC_SW_WN`/`CDAC_SW_WP` remain `10u`/`20u` **Re-taken again against the drawn-well-tap re-extraction (issue #381, DR-0035/#356 + DR-0037/#378): 8.855 bits worst (`tt_125c_3.63v`) — the same worst corner, −0.002 bits, still below `> 9.0` at the same 2 of 9 points.** Per-corner moves span −0.082 … +0.078 bits; two corners reproduce every figure exactly (no conversion code flips there). The geometry change does not move this row | **FAIL** (governing extracted result at the current design, and schematic; re-confirmed on a clean tree, issue #249) — regression flagged, not absorbed; #215's layout change does not move this row, and the one measured candidate fix is not adoptable (DR-0025) | [`sim/adc-enob-fft/records/20260825-061750-d00911a.md`](adc-enob-fft/records/20260825-061750-d00911a.md) <!-- evidence role=historical mode=extracted --> (extracted, clean-tree, pre-#356 geometry, issue #249, supersedes `20260817-215657-076d545`; `sim/extracted-delta-summary.md` §4.13.2); [`sim/adc-enob-fft/records/20260817-215657-076d545.md`](adc-enob-fft/records/20260817-215657-076d545.md) <!-- evidence role=historical mode=extracted --> (extracted, dirty-tree, post-#215 layout, issue #224, supersedes `20260817-180617-c4693f9`); [`sim/adc-enob-fft/records/20260817-180617-c4693f9.md`](adc-enob-fft/records/20260817-180617-c4693f9.md) <!-- evidence role=historical mode=extracted --> (extracted, pre-#215, resized `C_u`, issue #218, supersedes `20260807-054805-e8cd2b8`); [`sim/adc-enob-fft/records/20261105-081016-f3046d6.md`](adc-enob-fft/records/20261105-081016-f3046d6.md) <!-- evidence role=current mode=schematic --> (schematic, re-qualified at open_pdks `f6eeac7` on the batch fleet, issue #594, `Supersedes: 20260817-080939-afb1b3a`); [`sim/adc-enob-fft/records/20260817-080939-afb1b3a.md`](adc-enob-fft/records/20260817-080939-afb1b3a.md) <!-- evidence role=historical mode=schematic --> (schematic, resized `C_u`, issue #204, supersedes `20260814-193205-f613571`; itself superseded by `20261105-081016-f3046d6`, retained append-only); `sim/extracted-delta-summary.md` §4.12.2/§4.13.2 ; [`sim/adc-enob-fft/records/20261105-125230-b281aa8.md`](adc-enob-fft/records/20261105-125230-b281aa8.md) <!-- evidence role=governing mode=extracted --> (**extracted, full 27-point grid, GOVERNING for temperature coverage**, issue #430: 27/27 completed on the batch fleet; worst composed ENOB **8.734 bits at `ss_-40c_2.97v`** (cold governs; 27 C worst 8.873, 125 C worst 8.856), at or below 9.0 at 8 of 27 points, row stays **FAIL**; analysis: [`sim/adc-enob-fft/investigations/20261105-issue-430-27pt-temperature-coverage-result.md`](adc-enob-fft/investigations/20261105-issue-430-27pt-temperature-coverage-result.md); the 125 C legs reproduce the 125 C-only nine-point figures above, which remain valid for that subset); [`sim/adc-enob-fft/records/20260923-111149-904af96.md`](adc-enob-fft/records/20260923-111149-904af96.md) <!-- evidence role=governing mode=extracted --> (**extracted, GOVERNING, post-DR-0035/DR-0037 re-extraction**, issue #381, supersedes `20260825-061750-d00911a`; `sim/extracted-delta-summary.md` §4.14.2); **mechanism isolated (issue #211)**: [`sim/dr0019-cu-sweep-findings.md`](dr0019-cu-sweep-findings.md) — the loss tracks the acquisition time constant `R_on·C_arr`, and an orthogonal control at the ratified `C_u` with only the acquisition T-gate widened recovers 9.170 bits worst-corner (schematic, 125 °C subset), above the target at all nine points; **candidate NOT adopted, decision + full synthesis of all five deferred measurements**: [`spec/decision-records/DR-0025-acquisition-leg-widening-not-adopted.md`](../spec/decision-records/DR-0025-acquisition-leg-widening-not-adopted.md) |
| SFDR @ Nyquist | ≥ 62 dB (≥ 65 stretch) | **Re-run at the physically-implemented DR-0019 resize (`C_u = 35.6528 fF`, issue #204): schematic 56.41 dB worst (`ss_125c_2.97v`)** — **FAIL by 5.59 dB, widened from the pre-resize 0.67 dB gap** (61.33 → 56.41 dB at the same worst corner; 8 of 9 grid points got worse, one — `ff_125c_3.30v` — improved by +0.43 dB). The **64.38 dB extracted** figure below is now **STALE**: measured against the historical `C_u = 17.24 fF` layout, before #196/#202 physically implemented the resize, and has not been re-taken against the current design. **The switch's own contribution to this row now fails it too** (issue #197): `sim/track-switch-thd/`, whose `R_on`-modulated tracking-lag distortion is *linear* in the array capacitance, loses 4.96–5.77 dB at all 117 points and drops below the ratified 62 dB at **11 of 117** where **0 of 117** did pre-resize (worst single-ended 64.81 → **59.04 dB** at `ss_27c_2.97v`; true-differential 66.04 → **60.09 dB**, below 62 dB at 3 of 117). The measured loss matches the 6.31 dB the `C_load` ratio predicts to within 0.3 dB on the `tg1` branch, which is what makes it a mechanism rather than a coincidence — a datum for #211 **The extracted (governing) side has now been re-taken at the same resize (issue #218): 60.40 dB worst (`ff_125c_3.63v`), missing ≥ 62 dB at 4 of 9 points** (60.40, 60.84, 60.98, 61.09), against the 64.38 dB the pre-resize extraction reported — all nine corners degrade, by 2.89–7.21 dB. This row therefore has a valid governing result again (it had none while the extracted side was pre-resize) **and that result is a FAIL, by 1.60 dB. Re-taken again after issue #215's layout recovery (issue #224): 60.40 dB worst (`ff_125c_3.63v`), the identical figure and corner** — 8 of 9 points delta exactly 0, the remaining 2 improve slightly (`ss_125c_3.63v` +0.96 dB, `tt_125c_2.97v` +0.10 dB), neither a worst corner. **Re-taken again as a clean-tree re-take (issue #249): 60.40 dB worst (`ff_125c_3.63v`), byte-identical per-sample codes and figures at all nine corners** — the superseded `20260817-215657-076d545` was taken against a dirty working tree and was not citable as a clean-tree result; the design is unchanged, so this re-take confirms rather than moves the figure. **The candidate fix (#211's orthogonal control, cited at the end of this row) is evaluated and NOT adopted (issue #249, DR-0025)**: items 1/2/4 of the five deferred measurements cost little, but item 5's `klt`-verified re-layout shows the same width change grows `adc_block` area +17.00 % (150,536.239 → 176,126.8006 µm²), pushing it +76.1 % over the still-ratified `< 0.1 mm²` Area target and +10.1 % over even DR-0024's still-unratified proposed `< 0.16 mm²` relaxation — adopting it would trade this row's FAIL for a worse one on Area. `CDAC_SW_WN`/`CDAC_SW_WP` remain `10u`/`20u` **Re-taken again against the drawn-well-tap re-extraction (issue #381, DR-0035/#356 + DR-0037/#378): 60.41 dB worst, the worst corner shifting from `ff_125c_3.63v` to `ff_125c_2.97v` on a 0.01 dB difference, still missing `>= 62 dB` at the same 4 of 9 points.** Per-corner moves span −0.97 … +0.68 dB. The geometry change does not move this row | **FAIL** (governing extracted result at the current design, and schematic; gap widened, not narrowed; the switch's own share of the row now fails independently; re-confirmed on a clean tree, issue #249) — the extracted side no longer rescues this row, as it did pre-resize; #215's layout change does not move it further, and the one measured candidate fix is not adoptable (DR-0025) | [`sim/adc-enob-fft/records/20260825-061750-d00911a.md`](adc-enob-fft/records/20260825-061750-d00911a.md) <!-- evidence role=historical mode=extracted --> (extracted, clean-tree, pre-#356 geometry, issue #249, supersedes `20260817-215657-076d545`; `sim/extracted-delta-summary.md` §4.13.2); [`sim/adc-enob-fft/records/20260817-215657-076d545.md`](adc-enob-fft/records/20260817-215657-076d545.md) <!-- evidence role=historical mode=extracted --> (extracted, dirty-tree, post-#215 layout, issue #224, supersedes `20260817-180617-c4693f9`); [`sim/adc-enob-fft/records/20260817-180617-c4693f9.md`](adc-enob-fft/records/20260817-180617-c4693f9.md) <!-- evidence role=historical mode=extracted --> (extracted, pre-#215, resized `C_u`, issue #218, supersedes `20260807-054805-e8cd2b8`); [`sim/adc-enob-fft/records/20261105-081016-f3046d6.md`](adc-enob-fft/records/20261105-081016-f3046d6.md) <!-- evidence role=current mode=schematic --> (schematic, re-qualified at open_pdks `f6eeac7` on the batch fleet, issue #594, `Supersedes: 20260817-080939-afb1b3a`); [`sim/adc-enob-fft/records/20260817-080939-afb1b3a.md`](adc-enob-fft/records/20260817-080939-afb1b3a.md) <!-- evidence role=historical mode=schematic --> (schematic, resized `C_u`, issue #204, supersedes `20260814-193205-f613571`; itself superseded by `20261105-081016-f3046d6`, retained append-only); [`sim/adc-enob-fft/records/20260814-193205-f613571.md`](adc-enob-fft/records/20260814-193205-f613571.md) <!-- evidence role=historical mode=schematic --> (schematic pre-resize baseline); [`sim/track-switch-thd/records/20261105-082853-9de35aa.md`](track-switch-thd/records/20261105-082853-9de35aa.md) <!-- evidence role=current mode=schematic --> (switch contribution at the resized `C_u`, re-qualified on the batch fleet, issue #618; supersedes `20260817-142956-72d15de`, itself issue #197, which superseded `20260801-020125-267871b`); `sim/extracted-delta-summary.md` §4.12.2/§4.13.2 (§7.1/§7.3 for the pre-resize baseline, §4.10 for the schematic-only interim reading); `spec/testbench-suite-memo.md` §11.2 item 8b, §11.9.11 ; [`sim/adc-enob-fft/records/20261105-125230-b281aa8.md`](adc-enob-fft/records/20261105-125230-b281aa8.md) <!-- evidence role=governing mode=extracted --> (**extracted, full 27-point grid, GOVERNING for temperature coverage**, issue #430: 27/27 completed on the batch fleet; worst SFDR **57.96 dB at `ss_-40c_2.97v`** (cold governs; 27 C worst 58.75, 125 C worst 60.41), below 62 dB at 13 of 27 points, row stays **FAIL**; analysis: [`sim/adc-enob-fft/investigations/20261105-issue-430-27pt-temperature-coverage-result.md`](adc-enob-fft/investigations/20261105-issue-430-27pt-temperature-coverage-result.md); the 125 C legs reproduce the 125 C-only nine-point figures above, which remain valid for that subset); [`sim/adc-enob-fft/records/20260923-111149-904af96.md`](adc-enob-fft/records/20260923-111149-904af96.md) <!-- evidence role=governing mode=extracted --> (**extracted, GOVERNING, post-DR-0035/DR-0037 re-extraction**, issue #381, supersedes `20260825-061750-d00911a`; `sim/extracted-delta-summary.md` §4.14.2); **mechanism isolated (issue #211)**: [`sim/dr0019-cu-sweep-findings.md`](dr0019-cu-sweep-findings.md) — SFDR falls −19.00 dB/decade of `C_u` at the worst corner against the −20 dB/decade an acquisition-RC bow predicts, `V_REF` droop and the `C_arr/(C_arr+C_par)` divider excluded by an orthogonal control; DR-0019's rejected 33.00 fF sizing measures 56.07 dB, so no admissible smaller resize recovers the row; **candidate NOT adopted, decision + full synthesis of all five deferred measurements**: [`spec/decision-records/DR-0025-acquisition-leg-widening-not-adopted.md`](../spec/decision-records/DR-0025-acquisition-leg-widening-not-adopted.md) |
| INL / DNL | < 1 LSB (< 0.5 stretch) | **Re-run at the physically-implemented DR-0019 resize (`C_u = 35.6528 fF`, issue #203): nominal PVT (schematic) INL 0.1100 LSB (`inl_t384_lsb`, `cap_ss_125c_2.97v`) / DNL 0.0938 LSB (`dnl_t128_t129_lsb`, `cap_ss_125c_2.97v`)** — essentially unchanged from the pre-resize schematic baseline (worst \|INL\| 0.1036 → 0.1100 LSB, +0.0064; worst \|DNL\| 0.1036 → 0.0938 LSB, −0.0098), both still ~4.5–5.3× inside the < 0.5 LSB stretch target, all 63/63 `cdac`-grid points PASS, nothing moved outside the ratified target. Cited from the **clean-tree** re-take `20260817-131106-abf9c75`; the first re-run of this campaign (`20260817-110133-54c6e96`) was taken against a dirty working tree and so is not citable as a clean-tree result (`sim/harness/README.md`) — it is retained as append-only evidence and superseded, and the clean re-take reproduces it to 5–6 significant digits on a different host and ngspice minor version (worst \|INL\| and worst \|DNL\| identical at the precision reported here). **The extracted (governing) side has now been re-taken at the same resize (issue #218): worst \|INL\| 0.5284 LSB (`inl_t896_lsb`, `ss_125c_2.97v`) and worst \|DNL\| 0.7278 LSB (`dnl_t767_t768_lsb`, same corner), against 0.148 / 0.098 LSB pre-resize** — 27/27 points still PASS the ratified `< 1 LSB` row, but **both now sit outside the `< 0.5 LSB` stretch target**, which the pre-resize extraction cleared by ≈ 3.4×. Flagged, not absorbed: the stretch is a target rather than a ratified bound, so the row's verdict does not flip, and the schematic side moved only 0.1036 → 0.1100 LSB, so this is a post-layout interaction (2.068× array charge through the same drawn in-path resistance), not the resize alone; 3σ mismatch **at the as-built DR-0019 `σ_u = 0.5000 %`**: `klt yield` `status: pass` on all four DNL/INL measurements, N = 20 000 — `sigma_to_spec` **8.812 (DNL) / 17.627 (INL) against the ratified ±1 LSB row** and 4.404 / 8.812 against the ±0.5 LSB stretch; the 3× `σ_u` negative control is detected on 3 of the 4 (not on INL at ±1 LSB, a window ≈ 17.6σ wide). **Corrected by issue #437**: until then this row quoted the *pre-resize* `σ_u = 0.737 %` figures — DNL PASS 5.96σ margin, INL PASS 11.9σ margin at the ratified baseline (record `20260801-093800-c033611`) — which describe a unit cap this design no longer draws; both vintages pass, so no verdict moves. **Re-taken again after issue #215's layout recovery (issue #224): worst \|INL\| 0.528287 LSB and worst \|DNL\| 0.727556 LSB, both at the identical corner and transition** — a noise-floor move of +0.03 % / −0.03 % on the pre-#215 figures, no verdict change. **Re-taken again against the drawn-well-tap re-extraction (issue #381, DR-0035/#356 + DR-0037/#378): worst \|INL\| 0.517546 LSB (−2.03 %) and worst \|DNL\| 0.681240 LSB (−6.37 %), both still at `ss_125c_2.97v`, 27/27 PASS** — a sub-percent-to-few-percent improvement, both still inside the ratified `< 1 LSB` row and both still outside the `< 0.5 LSB` stretch, so no verdict moves in either direction (`sim/extracted-delta-summary.md` §4.14.1) | **PASS on the ratified row** (governing extracted re-run at the current design, schematic, and 3σ mismatch) — **stretch target still missed post-layout**, flagged | [`sim/adc-inl-dnl/records/20260923-095400-904af96.md`](adc-inl-dnl/records/20260923-095400-904af96.md) <!-- evidence role=governing mode=extracted --> (**extracted, GOVERNING, post-DR-0035/DR-0037 re-extraction**, issue #381, supersedes `20260817-214114-076d545`; `sim/extracted-delta-summary.md` §4.14.1); [`sim/adc-inl-dnl/records/20260817-214114-076d545.md`](adc-inl-dnl/records/20260817-214114-076d545.md) <!-- evidence role=historical mode=extracted --> (extracted, pre-#356 geometry, post-#215 layout, issue #224, supersedes `20260817-162837-3a9afd2`; `sim/extracted-delta-summary.md` §4.13.1); [`sim/adc-inl-dnl/records/20260817-131106-abf9c75.md`](adc-inl-dnl/records/20260817-131106-abf9c75.md) <!-- evidence role=current mode=schematic --> (schematic, resized `C_u`, issue #203, **clean tree**, supersedes `20260817-110133-54c6e96`); [`sim/adc-inl-dnl/records/20260817-110133-54c6e96.md`](adc-inl-dnl/records/20260817-110133-54c6e96.md) <!-- evidence role=historical mode=schematic --> (same campaign, **dirty tree — not citable**, superseded, supersedes `20260805-220405-bff6eaf`); [`sim/adc-inl-dnl/records/20260817-162837-3a9afd2.md`](adc-inl-dnl/records/20260817-162837-3a9afd2.md) <!-- evidence role=historical mode=extracted --> (extracted, pre-#215, resized `C_u`, 27-point `tt`/`ss`/`ff` grid, issue #218, supersedes `20260807-081223-6bd9d80`; `sim/extracted-delta-summary.md` §4.12.1); [`sim/mc-cdac-mismatch/records/20260801-093800-c033611.md`](mc-cdac-mismatch/records/20260801-093800-c033611.md) <!-- evidence role=historical mode=other --> (3σ mismatch at the **pre-resize** `σ_u = 0.737 %` — this row's mismatch citation until issue #437, now history); [`sim/mc-cdac-mismatch/records/20260816-125421-737d16e.md`](mc-cdac-mismatch/records/20260816-125421-737d16e.md) <!-- evidence role=current mode=other --> (DR-0019 as-built N = 20 000 campaign, issue #177 — DNL/INL re-confirmed at the resized `σ_u`); [`sim/mc-cdac-mismatch/records/20260812-132011-f613571.md`](mc-cdac-mismatch/records/20260812-132011-f613571.md) <!-- evidence role=current mode=other --> (`klt yield` re-analysis of that same N = 20 000 data — the source of the as-built mismatch figures in this row); [`sim/mc-cdac-mismatch/records/20261028-190000-5489f3a.md`](mc-cdac-mismatch/records/20261028-190000-5489f3a.md) <!-- evidence role=current mode=other --> (**post-resize `klt yield` envelope of the worst-over-codes DNL/INL population**, issue #656, `sim/mc-cdac-mismatch/yield-evidence-656/klt-yield-report.json`: `status: pass`, N = 20 000, `sigma_to_spec` 7.66 / 10.60 at ±1 LSB); `klt yield` reformat of this row **landed** as PR #149 (`617de90`, [`sim/mc-cdac-mismatch/yield-evidence/klt-yield-report.json`](mc-cdac-mismatch/yield-evidence/klt-yield-report.json)). Until issue #437 this cell called that bundle pre-resize (`C_u = 17.24 fF`) and superseded; that was wrong for this row — record `20260812-132011-f613571`'s own History note says it was repointed at the resized design before merge, and the report's four DNL/INL measurements read `sigma_to_spec` 8.812 / 4.404 / 17.627 / 8.812, the resized figures. Only the bundle's co-committed `gain_error_mismatch_lsb` measurement (2.122σ) is pre-resize, and it is the `Gain error, mismatch` row's history, not this row's |
| Offset error | ≤ 2 LSB, untrimmed | Comparator-only (schematic-level, not `ADC_BLOCK`-inclusive) 3σ-mismatch: worst-corner σ 0.398789 LSB, `cpk` 1.66, `sigma_to_spec` 4.99σ, zero samples outside limits at N = 150 (`klt yield` `status: fail` is a **sample-size artifact** — N = 150 cannot support a 3σ/99.73% claim at 95% CI; 1365 samples would). Deterministic (non-statistical) extracted-core systematic offset: −0.597…−4.357 mV across the 45-point grid, well inside the 12.89 mV (2 LSB) bound | **Not measured as a comparator-inclusive (`ADC_BLOCK`) 3σ statistical population** (issue #89 Scope item 2's remaining work); everything measured so far clears its bound with wide margin | [`sim/comparator-offset-mc/records/20260816-050504-66a0e2e.md`](comparator-offset-mc/records/20260816-050504-66a0e2e.md) <!-- evidence role=governing mode=other --> (`klt yield`, issue #172, clean-tree 45/45); [`sim/comparator-regeneration/records/20260814-215626-f613571.md`](comparator-regeneration/records/20260814-215626-f613571.md) <!-- evidence role=governing mode=extracted --> (deterministic extracted-core offset, issue #116) |
| Gain error, mismatch | ≤ 0.5 LSB, untrimmed, excluding V_REF error | **As built (`C_u = 35.6528 fF`, the resize physically implemented by issue #196/PR #202): `sigma_to_spec = 3.13`, `klt yield` `status: pass`**, N = 20 000, negative control at 3× `σ_u` correctly detected, DNL/INL re-confirmed to still pass at this `σ_u`. This is a nominal-PVT mismatch quantity, not a corner sweep (`spec/testbench-suite-memo.md` §5.3/§6 "Subset-corner justification"), so it needs no PVT re-verification beyond the resize itself — it is governing at the current design. **Superseded pre-resize history**: at the historical `C_u = 17.24 fF` this design no longer draws, 2.12σ was measured against the ratified 3σ condition — 0.708 LSB at 3σ, `klt yield` `status: fail` (genuine, not a sample-size artifact: N = 20 000, negative control at 3× `σ_u` correctly detected) | **PASS as built** — the resize (issue #196/PR #202) closes the gap the pre-resize measurement reported; no spec value relaxed, no testbench retuned | [`sim/mc-cdac-mismatch/records/20260816-125421-737d16e.md`](mc-cdac-mismatch/records/20260816-125421-737d16e.md) <!-- evidence role=governing mode=other --> (issue #177, **governing, as built**; `sim/mc-cdac-mismatch/yield-evidence-177/klt-yield-report.json`); [`sim/mc-cdac-mismatch/records/20260816-044942-56fbe50.md`](mc-cdac-mismatch/records/20260816-044942-56fbe50.md) <!-- evidence role=historical mode=other --> (issue #172, pre-resize `C_u = 17.24 fF`, **superseded**); `spec/decision-records/DR-0019-cdac-unit-cap-resize-for-gain-error-margin.md`; `spec/testbench-suite-memo.md` §12 item 8c |
| Gain error, systematic | ≤ 0.5 LSB, untrimmed, excluding V_REF error | **Re-run at the physically-implemented DR-0019 resize (`C_u = 35.6528 fF`, issue #197): schematic 0.0021–0.0039 LSB** (was 0.0045–0.0088 LSB pre-resize) — the row *improves* 2.26×, to ~127× inside the bound, because `C_par` does not scale with `C_u` while `C_arr` does. **The extracted (governing) side has now been re-taken at the same resize (issue #218): 0.00013–0.00048 LSB**, itself a −70.7 % improvement on the 0.00046–0.0016 LSB the pre-resize extraction reported, i.e. **~1047× inside the bound** (was ~307×). Both sides move the same way, for the same reason: `C_par` does not scale with `C_u`, so the injected charge is diluted into a 2.068× larger array. **Re-taken again after issue #215's layout recovery (issue #224): 0.0004845 LSB worst (`ff_-40c_3.63v`)**, a noise-floor +1.5 % move on the pre-#215 figure, **~1032× inside the bound** (was ~1047×) — the DR-0014 sampling mechanism lives entirely in the CDAC array and local drivers, which #215 did not touch. **Double-checked against the #238/#249 acquisition-leg-widening candidate (evaluated and NOT adopted, DR-0025)**: item 1 of that investigation's five deferred measurements ([`sim/dr0014-sampling/records/20260825-015032-446a3c4.md`](dr0014-sampling/records/20260825-015032-446a3c4.md)) found this row's own risk terms move by noise-floor amounts even at the candidate's 2.068× width (`samp_inl_worst_lsb` 0.30895 → 0.30915 LSB), so this row was never actually at material risk from that candidate — moot now that it is not adopted, since the ratified design (`CDAC_SW_WN`/`CDAC_SW_WP` = `10u`/`20u`) is unchanged. **Re-taken again against the drawn-well-tap re-extraction (issue #381, DR-0035/#356 + DR-0037/#378): 0.000981002 LSB worst (`ff_-40c_3.63v`), ~510× inside the bound** (was ~1032×) — the quantity doubles, off a floor a thousand times below its bound, because the sampling T-gates' bodies now sit on real drawn supplies instead of floating `Nwell` islands, so their junction charge is modelled where it previously was not. 27/27 PASS; the row stays deeply inside its bound at every corner (`sim/extracted-delta-summary.md` §4.14.4). **Environment spread, measured (issue #459)**: the #393 ideal-supply control arm ran the byte-identical deck on a different `ngspice-46` host environment and reads 0.0010063 LSB at the same corner. The +2.5e-5 LSB gap is a solver-path difference between the two environments: a −0.0067 LSB shift common to all five sampled levels, of which max − min keeps only the level-to-level residue. It is not a deck, harness or dirty-tree change. Each environment repeats bit-identically. The governing figure stays 0.000981002 LSB, about 2e4× below the margin to the bound ([investigation](dr0014-sampling/investigations/20261009-issue-459-gain-error-control-arm-delta.md)) | **PASS** (governing extracted re-run at the current design, and schematic; wider margin than before the DR-0019 resize on both sides) | [`sim/dr0014-sampling/records/20261020-233008-0bf0747.md`](dr0014-sampling/records/20261020-233008-0bf0747.md) <!-- evidence role=governing mode=extracted --> (re-qualified at open_pdks `f6eeac7`, issue #615, `Supersedes: 20260923-104443-904af96`; `sim/requalification-595-dr0014-sampling.md`); [`sim/dr0014-sampling/records/20260923-104443-904af96.md`](dr0014-sampling/records/20260923-104443-904af96.md) <!-- evidence role=historical mode=extracted --> (superseded, retained append-only) (**extracted, GOVERNING, post-DR-0035/DR-0037 re-extraction**, issue #381, supersedes `20260817-204729-076d545`; `sim/extracted-delta-summary.md` §4.14.4); [`sim/dr0014-sampling/records/20260817-204729-076d545.md`](dr0014-sampling/records/20260817-204729-076d545.md) <!-- evidence role=historical mode=extracted --> (extracted, pre-#356 geometry, post-#215 layout, issue #224, supersedes `20260817-172040-5c0f0cc`; `sim/extracted-delta-summary.md` §4.13.4); [`sim/dr0014-sampling/records/20260817-172040-5c0f0cc.md`](dr0014-sampling/records/20260817-172040-5c0f0cc.md) <!-- evidence role=historical mode=extracted --> (extracted, pre-#215, resized `C_u`, issue #218, supersedes `20260807-091733-434dc37`); [`sim/dr0014-sampling/records/20261020-235635-0bf0747.md`](dr0014-sampling/records/20261020-235635-0bf0747.md) <!-- evidence role=current mode=schematic --> (re-qualified at open_pdks `f6eeac7`, issue #615, `Supersedes: 20260817-134517-cde979d`; `sim/requalification-595-dr0014-sampling.md`); [`sim/dr0014-sampling/records/20260817-134517-cde979d.md`](dr0014-sampling/records/20260817-134517-cde979d.md) <!-- evidence role=historical mode=schematic --> (superseded, retained append-only) (schematic, resized `C_u`, issue #197, supersedes `20260802-141402-1224e11`); `spec/testbench-suite-memo.md` §11.9.6; `sim/extracted-delta-summary.md` §4.9/§4.12.4 |
| CMRR (differential) | ≥ 60 dB (≥ 65 stretch) | Worst-corner-of-45 (`ss_-40c_3.63v`), clean-tree re-run: systematic Δoffset over ±50 mV CM implies **118.2 dB**; 3σ-mismatch Δoffset implies **85.6 dB**. Both clear ≥ 60 dB by ≥ 25.6 dB. Direct ±100 mV measurement not performed — linear extrapolation from the ±50 mV band, stated as such | **PASS**, wide margin | [`sim/comparator-offset-mc/records/20260816-050001-d002e66.md`](comparator-offset-mc/records/20260816-050001-d002e66.md) <!-- evidence role=governing mode=schematic --> + [`20260816-050504-66a0e2e.md`](comparator-offset-mc/records/20260816-050504-66a0e2e.md) <!-- evidence role=governing mode=other --> (issue #172, 2026-08-16 — corrects the prior 99.0/117.5 dB citation, which never reached the true worst corner); `spec/testbench-suite-memo.md` §10 |
| Input (drive contract) | External driver, R_source/C_pin budget | **Re-run at the physically-implemented DR-0019 resize (`C_u = 35.6528 fF`, 18.254 pF array, issue #197): full 117-point PVT grid at the DR-0013 network, sampling-switch gain-error contribution +0.082…+0.370 LSB** (worst `ff_125c_3.63v`, `gain_px500_lsb`), *improved* from the pre-resize −0.293…+0.421 LSB: every charge-injection term is `Q_inj/C_hold` and the resize took `C_hold` ×2.068, so pedestals, gain terms and nonlinear residuals all land at ×0.49–0.52. **Flagged, not absorbed**: the one quantity that moves the other way is acquisition settling at the 100 pF/250 Ω drive point (`acqerr_px250_lsb` 0.0021 → **0.0103 LSB** worst, ×5.0) — still ~49× inside the 0.5 LSB stretch, but it scales *with* the array and would grow again on a further resize. This deck carries no `checks` block, so its harness PASS means 117 points simulated, not that the row passes; the verdict here is stated against the ratified row | **PASS** (schematic, current design; wider margin than before the resize) | [`sim/track-switch-sampling/records/20261105-083025-9de35aa.md`](track-switch-sampling/records/20261105-083025-9de35aa.md) <!-- evidence role=governing mode=schematic --> (resized `C_u`, re-qualified on the batch fleet, issue #618; supersedes `20260817-142951-72d15de`, itself issue #197, which superseded `20260802-141402-1224e11`); [`sim/track-switch-sampling/records/20260802-141402-1224e11.md`](track-switch-sampling/records/20260802-141402-1224e11.md) <!-- evidence role=historical mode=schematic --> (pre-resize baseline); `spec/testbench-suite-memo.md` §11.9.12 |
| Input structure (C_in, R_on, T/H BW) | C_in **18.254 pF/side** (512 · C_u at DR-0019's resized `C_u = 35.6528 fF`, per `README.md#target-specification`; was 8.827 pF pre-resize); R_on 21.3–60.0 Ω (array); T/H BW ≥ 5.3 MHz | Schematic R_on (drawn `adc_tgate` leaf) 570.436 Ω (`ss_125c_2.97v`); extracted (in-path) **647.818 Ω**, +13.6 % — **re-taken against the post-#202 extraction (issue #218) and an exact null**: `adc_tgate.para.spice` is byte-identical across the two extraction vintages (DR-0019 resizes the CDAC unit cap only, not the switch leaf) and every one of 45 corners × 24 measurements reproduces, max per-corner delta 0 on 21 of 24 and 0.001 Ω on the rest. **Re-taken again after issue #215's layout recovery (issue #224): also an exact null** — `adc_tgate.para.spice` byte-identical to the pre-#215 vintage too (#215 touches the comparator load resistors and supply corridors, not the CDAC's fourth-leg switch cell), `ron_t_max`/`ron_t_min`/`ron_t_flatness` all delta 0. **Re-taken again against the drawn-well-tap re-extraction (issue #381, DR-0035/#356 + DR-0037/#378): still an exact null, and this time the leaf netlist DID change** — DR-0035 drew a tap in `adc_tgate`'s own `Nwell`, so the cell gained a `vdd` pin (5 -> 6), a parasitic R (6 -> 7) and more than doubled its ΣR (302.798 -> 759.5911 Ω), yet `ron_t_max`/`ron_t_min`/`ron_t_flatness` still delta **exactly 0** at their worst corners. The added resistance is in the well-tap path, not the switch's signal path, so the measured on-resistance cannot see it (`sim/extracted-delta-summary.md` §4.14.5) | **PASS**, both sides | [`sim/device-switch-ron/records/20260923-102440-904af96.md`](device-switch-ron/records/20260923-102440-904af96.md) <!-- evidence role=governing mode=extracted --> (**extracted, GOVERNING, post-DR-0035/DR-0037 re-extraction**, issue #381, supersedes `20260817-204715-076d545`; same pre-existing `ron_t_max` supply-axis sensitivity witness, bit-identical at 9.71502 %; `sim/extracted-delta-summary.md` §4.14.5); [`sim/device-switch-ron/records/20260817-204715-076d545.md`](device-switch-ron/records/20260817-204715-076d545.md) <!-- evidence role=historical mode=extracted --> (extracted, pre-#356 geometry, post-#215 layout, issue #224, supersedes `20260817-172213-5c0f0cc`; the record's own overall verdict is FAIL for the same pre-existing deck sensitivity witness as its predecessors — `ron_t_max` supply-axis spread 9.715 % vs a 10 % floor — not a spec check, `sim/extracted-delta-summary.md` §4.13.5); [`sim/device-switch-ron/records/20260817-172213-5c0f0cc.md`](device-switch-ron/records/20260817-172213-5c0f0cc.md) <!-- evidence role=historical mode=extracted --> (extracted, pre-#215, post-resize extraction vintage, issue #218, supersedes `20260814-191138-f613571`); [`sim/dr0014-sampling/records/20261020-235635-0bf0747.md`](dr0014-sampling/records/20261020-235635-0bf0747.md) <!-- evidence role=current mode=schematic --> (re-qualified at open_pdks `f6eeac7`, issue #615, `Supersedes: 20260817-134517-cde979d`; `sim/requalification-595-dr0014-sampling.md`); [`sim/dr0014-sampling/records/20260817-134517-cde979d.md`](dr0014-sampling/records/20260817-134517-cde979d.md) <!-- evidence role=historical mode=schematic --> (superseded, retained append-only) (array-path `R_on` re-measured at the resized `C_u`, issue #197: **21.329–60.022 Ω, bit-identical** to the pre-resize record at all 27 points — `spec/testbench-suite-memo.md` §11.9.6); `sim/extracted-delta-summary.md` §4.8 |
| Reference (Z_ref, C_dec) | V_REF = 3.3 V ext.; ≥ 40 nF decoupling; Z_ref ≤ 240 Ω | Bit-cycle settling **PASS at all 117 PVT points, re-run at the DR-0019-resized `C_u = 35.6528 fF`** (issue #197). The gating budget check `err_1msps_*` — top-plate settling error 62.5 ns after the bit trial, bound ±1.6113 mV (0.5 LSB) — is **unchanged at 0 mV** on the whole grid, i.e. the 2.068× array-capacitance increase costs this row nothing measurable. The 1.5 ns in-transient anchor does move: worst-corner (`ss_125c_2.97v`) residual lag rises 0.738 → 0.863 of the step (w=256) and the `lag_ord_256_64` ordering margin narrows 0.242 → 0.148 against its ≥ 0.05 floor (4.85× → 2.96×) — **still PASS, flagged as a margin trend, not absorbed**. Schematic; not re-taken post-layout — this row is off the extracted `ADC_TOP` boundary, so it has no extracted counterpart to go stale | **PASS** (schematic-level, at the resized `C_u`) | [`sim/cdac-bit-settling/records/20261105-060810-1b30cf0.md`](cdac-bit-settling/records/20261105-060810-1b30cf0.md) <!-- evidence role=governing mode=schematic --> (issue #197, re-run at the resized `C_u`; supersedes [`20260731-231537-1ee5578`](cdac-bit-settling/records/20260731-231537-1ee5578.md) <!-- evidence role=historical mode=schematic -->, the pre-resize baseline) |
| V_CM (Z_vcm, C_dec) | V_cm = V_REF/2 = 1.65 V ext.; ≥ 40 nF decoupling; Z_vcm ≤ 220 Ω ([DR-0026](../spec/decision-records/DR-0026-vcm-drive-source.md), **proposed — not yet operator-ratified**) | **The budget is derived; the converter's sensitivity to a real V_cm network at that budget is now measured against the ratified rows themselves, at full PVT, on the governing netlists (issue #358).** Replacing the ideal, zero-impedance V_cm source every other ADC-level deck in this table uses with an R‖L + C_dec network at DR-0026's budget (Z_vcm = 220 Ω, C_dec = 40 nF, modelled exactly the way these decks already model V_REF, DR-0002) was run as **paired same-commit arms** — each deck taken twice, once with its ideal source and once with the network, so the difference carries the network and nothing else. Eight arms, every point PASS, every arm clean-tree; each ideal control arm reproduces the committed citation it controlled for **at the commit the campaign ran on** (extracted INL/DNL 0.528287 / 0.727556 LSB, i.e. the pre-#381 `…076d545` citation — see the vintage caveat below; schematic 0.1100 / 0.0938 LSB; Power 207.884 µW — the same numbers, transitions and corners, the latter two still current). **On that extracted netlist, worst INL moves 0.5283 → 0.6651 LSB and worst DNL 0.7276 → 0.7874 LSB.** Two distinct figures, stated separately because they are different quantities: the **worst-case remaining margin** under the budget — the number DR-0026's sign-off actually rests on — is **0.2126 LSB** against the ratified `< 1 LSB` window (`dnl_t767_t768_lsb`, `ss_125c_2.97v`, where the ideal control arm already sits at 0.2724 LSB, so the network costs 0.0599 LSB there); the **largest single paired move** is **0.6163 LSB** (`dnl_t1_t2_lsb`, `ss_27c_2.97v`), which at that corner leaves 0.3334 LSB — 0.54× the move, i.e. 65 % of the margin that transition had. Points outside the < 0.5 LSB **stretch** target go from **1 of 27 to 20 of 27**. **Post-#381 re-take (issue #392, measured 2026-10-15, supersedes the pre-#381 extracted figures above as the current citation; they stay as history)**: on the current governing extraction (clean-tree, both arms 27/27 PASS, batch fleet, klt 0.7.1.dev451 client / 0.7.0 runner, `match`), the ideal control arm reproduces the #381 citation exactly (worst INL 0.517546 / DNL 0.681240 LSB, `ss_125c_2.97v`) and the V_cm network at DR-0026's budget gives worst INL **0.522497** / worst DNL **0.644374** LSB, both at the same corner and transitions (`inl_t768_lsb`, `dnl_t767_t768_lsb`, `ss_125c_2.97v`). The **worst-case remaining margin** under the budget is therefore **0.3556 LSB** (`dnl_t767_t768_lsb`, `ss_125c_2.97v`; the ideal arm has 0.3188 LSB there), *wider* than the pre-#381 0.2126 LSB, as the earlier inference predicted -- now measured rather than inferred. At that point the network moves the DNL *toward* zero by 0.0368 LSB. The **largest single paired move** is **0.3631 LSB** (`dnl_t1_t2_lsb`, `ss_27c_3.30v`), leaving 0.5912 LSB there (1.63x the move; 38 % of that transition's 0.9543 LSB margin spent), against 0.6163 LSB on the pre-#381 vintage. Points outside the < 0.5 LSB stretch target: **1 of 27 in both arms** (`ss_125c_2.97v`, INL 0.5175 -> 0.5225 LSB), against 1 -> 20 of 27 on the pre-#381 vintage. These are the measured numbers; why the re-extraction shrank the network's effect this much was not investigated. Pre-#381 history, retained: the extraction-vintage caveat as originally flagged: the extracted pair ran on the pre-#381 netlist; issue #381 re-extracted and moved the ideal arm's worst DNL to 0.681240 LSB (minimum headroom 0.3188 LSB) — *away* from the bound — so the 0.2126 LSB figure is the pessimistic one and the V_cm delta on the current extraction is unmeasured (**#392**). The schematic, Power and sampling arms are unaffected by that re-extraction. Schematic side: worst INL 0.1100 → 0.4834 LSB, worst DNL 0.0938 → 0.4856 LSB (63/63 points). Power: worst p_total 207.884 → **203.608 µW**, margin 4.81× → **4.91×** against the 1 mW target — i.e. the network very slightly *reduces* worst-case total power, because `C_dec` supplies the switching transients the ideal source otherwise delivers through the pin. **This corrects the 207.884 → 223.961 µW / 4.47× figure this row carried until issue #395**: the V_cm arm's ammeter had been generated with its terminals reversed relative to the ideal source line it substitutes for, which flipped the sign of `i(vcms)` and therefore of the `p_vcm` term inside `p_total`; the superseding record is [`20260924-041435-cda7de5`](adc-power/records/20260924-041435-cda7de5.md) (superseding `20260923-114021-836a876`). The paired ideal-source control (207.884 µW) is unaffected — its deck carries no ammeter — and was re-run point-for-point at the corrected commit, reproducing every measurement to the last printed digit. The row's PASS verdict never depended on the error. `sim/dr0014-sampling/` is **insensitive** by more than three orders of magnitude (`samp_gain_err_lsb` 12.7674 → 12.7676 LSB), which is the mechanism DR-0026 derives showing up as data: that deck holds V_cm through one sampling event, while the converter deck releases the array onto V_cm twice per conversion. **The ≈ 0.2 LSB the exploratory sweep published is reproduced exactly at its own point** (`tt_27c_3.30v`: `gain_err_lsb` −2.00532 → −2.20527, `inl_t256_lsb` −0.01342 → −0.28053) and understates the effect ≈ 3× because of the transitions it quoted and its capacitor-only process axis — **not** because it held temperature and supply fixed (the worst move varies only 0.3765–0.4669 LSB across the whole 63-point grid). ENOB/SFDR and the extracted power deck were **not** re-run (both wired into `sim/vcm-full-pvt/run_full_pvt.sh`); see that README's findings for the margin arithmetic that deferred them | **PASS — no ratified row moves outside its bound under a real V_cm network meeting DR-0026's budget, at full PVT, on the schematic and on the extracted netlist the INL/DNL row was cited from when the campaign ran.** This is now a measured result against the ratified rows, not a stated gap: the ideal-source assumption is **not conservative**, and the price is quantified — the INL/DNL row's worst-case remaining margin under the budget is **0.3556 LSB** of its `< 1 LSB` window on the current (post-#381) governing extraction (issue #392; 0.2126 LSB on the pre-#381 vintage the #358 campaign first ran on), and at the corner the network perturbs hardest it keeps 1.63× the perturbation (0.5912 LSB after a 0.3631 LSB move). **Flagged, not absorbed**: no bound, target or manifest was changed by this campaign; and ENOB/SFDR and the extracted power deck were not re-run at all. DR-0026 is still *proposed*, pending operator ratification, and the sign-off question it now carries is whether 220 Ω is the right ceiling given how much of that margin it spends | **Full-PVT paired campaign (issue #358)**: [`sim/adc-inl-dnl/records/20260923-095803-836a876.md`](adc-inl-dnl/records/20260923-095803-836a876.md) <!-- evidence role=historical mode=extracted --> (extracted, pre-#381 vintage, historical — ideal-V_cm control) and [`20260923-100947-836a876.md`](adc-inl-dnl/records/20260923-100947-836a876.md) <!-- evidence role=historical mode=extracted --> (extracted, V_cm network at budget, pre-#381 vintage, historical); post-#381 re-take (issue #392): [`20261015-000027-74685b3.md`](adc-inl-dnl/records/20261015-000027-74685b3.md) <!-- evidence role=governing mode=extracted --> (extracted, ideal-V_cm control) and [`20261015-001125-74685b3.md`](adc-inl-dnl/records/20261015-001125-74685b3.md) <!-- evidence role=governing mode=extracted --> (extracted, V_cm network at budget); [`20261105-065009-758b973.md`](adc-inl-dnl/records/20261105-065009-758b973.md) <!-- evidence role=governing mode=schematic --> / [`20260923-071835-664c8dc.md`](adc-inl-dnl/records/20260923-071835-664c8dc.md) <!-- evidence role=governing mode=schematic --> (schematic, 63 pt, the pair); [`sim/adc-power/records/20261105-050939-bca53f9.md`](adc-power/records/20261105-050939-bca53f9.md) <!-- evidence role=governing mode=schematic --> (Power, ideal-V_cm control, re-qualified under open_pdks f6eeac7, issue #594, `Supersedes: 20260923-112459-836a876`; worst `p_total` 207.884 µW at `ff_-40c_3.63v`, unchanged) / [`sim/adc-power/records/20260923-112459-836a876.md`](adc-power/records/20260923-112459-836a876.md) <!-- evidence role=historical mode=schematic --> / [`20260923-114021-836a876.md`](adc-power/records/20260923-114021-836a876.md) <!-- evidence role=historical mode=schematic --> (Power, the pair — the V_cm-network arm `20260923-114021-836a876` is **superseded**, retained as history); [`20260924-041435-cda7de5.md`](adc-power/records/20260924-041435-cda7de5.md) <!-- evidence role=governing mode=schematic --> (Power, V_cm-network arm re-run with the ammeter orientation corrected, issue #395, `Supersedes: 20260923-114021-836a876` — the source of the 203.608 µW figure; added to this column by issue #437, the value cell already cited it); [`sim/dr0014-sampling/records/20261020-231040-0bf0747.md`](dr0014-sampling/records/20261020-231040-0bf0747.md) <!-- evidence role=governing mode=schematic --> (re-qualified at open_pdks `f6eeac7`, issue #615, `Supersedes: 20260923-085243-664c8dc`; `sim/requalification-595-dr0014-sampling.md`); [`sim/dr0014-sampling/records/20260923-085243-664c8dc.md`](dr0014-sampling/records/20260923-085243-664c8dc.md) <!-- evidence role=historical mode=schematic --> (superseded, retained append-only) / [`20261020-235634-0bf0747.md`](dr0014-sampling/records/20261020-235634-0bf0747.md) <!-- evidence role=governing mode=schematic --> (re-qualified at open_pdks `f6eeac7`, issue #615, `Supersedes: 20260923-092849-664c8dc`; `sim/requalification-595-dr0014-sampling.md`); [`20260923-092849-664c8dc.md`](dr0014-sampling/records/20260923-092849-664c8dc.md) <!-- evidence role=historical mode=schematic --> (superseded, retained append-only) (sampling, the pair); [`sim/vcm-full-pvt/README.md`](vcm-full-pvt/README.md) (findings, method, and what was not run). **Prior exploratory sweep (issue #260, superseded as the citation for this row but retained):** [`sim/vcm-drive-impedance/records/20260825-162620-e09a2d0.md`](vcm-drive-impedance/records/20260825-162620-e09a2d0.md) <!-- evidence role=historical mode=schematic --> (ideal, Z_vcm = 0); [`20260825-163251-cb36f0a.md`](vcm-drive-impedance/records/20260825-163251-cb36f0a.md) <!-- evidence role=historical mode=schematic --> (at budget); [`20260825-163508-64203b5.md`](vcm-drive-impedance/records/20260825-163508-64203b5.md) <!-- evidence role=historical mode=schematic --> (5× beyond); [`DR-0026`](../spec/decision-records/DR-0026-vcm-drive-source.md); `spec/testbench-suite-memo.md` §12 item 3 |
| Clock (M = 16, jitter) | 16 MHz @ 1 MS/s; jitter ≤ 250 ps rms (analytic, DR-0003) | 16-phase conversion completes deterministically | **PASS** on the sequencing claim; the **jitter** half is an analytic DR-0003 budget, not measured against a real clock source — stated, not folded into the PASS | [`sim/sar-logic-timing/records/20261031-191202-befcce4.md`](sar-logic-timing/records/20261031-191202-befcce4.md) <!-- evidence role=governing mode=schematic --> (**current**; `Supersedes: 20260802-102758-d8a363d`; tt / 27 °C / 2.97, 3.30, 3.63 V on the deck as corrected by #371/DR-0031 part 2(b), 3/3 points PASS, every check within its unchanged bound, `iso_gap_ns` 62.4891 / 62.4893 / 62.4895 ns against 62.4887 / 62.4888 / 62.4889 ns in the record it supersedes); [`20260802-102758-d8a363d.md`](sar-logic-timing/records/20260802-102758-d8a363d.md) <!-- evidence role=historical mode=schematic --> (**superseded**: pre-#371 deck, retained append-only); [`20260801-033032-06bad60.md`](sar-logic-timing/records/20260801-033032-06bad60.md) <!-- evidence role=historical mode=schematic --> (**superseded**, retained append-only) |
| Supply (V_DD ±10 %; C_dec, Z_vdd) | V_DD = 3.3 V ±10 % (2.97 / 3.30 / 3.63 V grid), single supply, 3.3 V devices throughout ([DR-0004](../spec/decision-records/DR-0004-device-flavor.md)); external decoupling **≥ 40 nF** at the V_DD pin; effective source impedance **≤ 3 Ω** in the switching band; **plus a required on-die local decoupling term inside `ADC_BLOCK`, not yet sized** ([DR-0036](../spec/decision-records/DR-0036-vdd-decoupling-budget.md), **proposed — requires operator sign-off, i.e. not yet ratified**, and carried in `README.md#target-specification` with that caveat inline). Stretch: `Z_vdd ≈ ≤ 1.6 Ω @ 2 MS/s` (conversion period halves; not further resolved, DR-0036) | **This row has two halves and they are verified differently — stated separately rather than averaged into one verdict.** **(1) The ±10 % supply window** is spanned by the supply axis of every PVT sweep cited above: 2.97 / 3.30 / 3.63 V on every grid in this table. **(2) The DR-0036 drive requirement is *derived*, not measured, and has no measured verdict.** Its input is measured — [`sim/adc-rail-current/`](adc-rail-current/records/20260923-002945-1cefe83.md) (27-point PVT grid) reports a **34.383980 mA** `i_vdd_peak_ua` at `ff_-40c_3.63v` (of which the CDAC bottom-plate driver branch carries 34.2987 mA, **99.75 %**, at the peak instant `t = 7.00286 µs`) against a **39.5421 µA** window average in that same corner, a factor of **869**, and a grid-worst average of **40.120 µA** at `ff_125c_3.63v`. DR-0036 bounds the per-conversion charge from that average (`ΔQ_conv ≤ 40.120 pC`), divides by the 0.5 LSB = 1.611328 mV allowance to get `C_dec ≥ 24.90 nF`, and provisions **≥ 40 nF** (per-conversion sag 1.003 mV) with `Z_vdd,max ≈ 3.28 Ω` → provisioned **≤ 3 Ω**. **What no record in this repo contains is a measurement of the converter behind such a source.** Every ADC-level deck in this table models the three supply islands as ideal DC sources (`sim/adc-power/testbench/tb_adc_power.spice`: `vddc`/`vddd`/`vddt` are `dc {vdd_val}`), so what the ≥ 40 nF / ≤ 3 Ω budget buys — and what missing it costs — is **unmeasured**. That was exactly the position the `V_CM` row was in before issue #358 measured it against DR-0026's budget; **issue #393 has now done the V_DD counterpart**, below. Two further bounds travel with the budget and are stated, not absorbed: the switching event's charge is **bounded from the window average, never integrated** (route A is 4.3× looser than the CDAC-branch attribution, and the event's width — ≤ 1.150 ns total / ≈ 0.272 ns attributed — is derived rather than measured, both below the deck's own 2 ns timestep), which **#386** is filed to close; and DR-0036 step 8's **523 Ω** landing-site-to-decode-bank effective resistance was read off [`layout/power/records/20260923-010407-d84c7b4.md`](../layout/power/records/20260923-010407-d84c7b4.md), **before** #378/PR #388 moved the block-level straps to Metal2 — the same `peak-upper-bound.COMPARATOR` case now reads **4.93 V** instead of 17.99 V in the governing [`20260923-084734-5f13cf9`](../layout/power/records/20260923-084734-5f13cf9.md) (`layout/power/README.md`), so the resistance behind clause 3's *placement* argument has fallen and DR-0036's own Consequences clause — *"whichever of #378 / this record is settled second must re-read the other"* — is **unsatisfied**: #388 landed second and did not re-read it. **(2b) The converter behind a real V_DD network at that budget is now measured against the ratified rows (issue #393, [`sim/vdd-full-pvt/README.md`](vdd-full-pvt/README.md)).** One shared pin network at the *edge* of DR-0036's budget (Z_vdd = 3 Ω, C_dec = 40 nF, R‖L corner at the 1 MHz conversion rate, one pin feeding all three islands through 0 V ammeters — one pin, not three, because DR-0036 budgets one pin off the summed current and three independent networks would silently grade against 3× the decoupling) replaced the ideal island sources in the four governing extracted decks, run as paired same-commit arms (`800bf53`, clean clones, 90 points per side, every point PASS) over each deck's own grid. **Result: no ratified row moves measurably and none changes status.** INL/DNL worst 0.5175 / 0.6812 LSB → 0.5175 / 0.6812 LSB (largest paired move 0.0018 LSB; `ss_125c_2.97v`); Gain error systematic's own term 0.0010063 → 0.000834 LSB (~500× inside 0.5 LSB; largest move 0.000766 LSB); Power worst `p_total` 218.627 → 218.554 µW (4.57× against 1 mW, unchanged; largest move 2.555 µW, 1.2 % of the window); ENOB/SFDR identical at all 9 points (all 64 output codes identical; ENOB 8.860 bits and SFDR 60.41 dB worst, both rows still FAIL exactly as before, in both arms). Each ideal arm reproduces its cited record (INL/DNL max \|Δ\| 2e-5, ENOB/SFDR exact, Power 218.628 vs 218.627 µW; the gain-error term 0.000981 → 0.001006 LSB, same PASS and corner, not bit-identical). **So the external ≥ 40 nF / ≤ 3 Ω budget is not what limits any ratified row.** What this does *not* show, stated rather than absorbed: the network has no package inductance, no on-die rail resistance and no on-die decoupling (all of which worsen the real rail), the switching event is still bounded rather than integrated (**#386**), and the four **schematic** pairs were wired but **not run** (every governing citation is extracted; ~2–3 h per arm on a contended host) — so DR-0036's 0.5 LSB denominator is neither relaxed nor confirmed by this. **(3) The on-die term is required and unmet as drawn.** `ADC_BLOCK` carries no on-die decoupling at all, and DR-0036 deliberately does not size it; see the "What is not yet measured" section below | **PASS on the ratified ±10 % supply window** (no dedicated record — it is the corner axis every other row already sweeps). **The converter's sensitivity to DR-0036's decoupling / source-impedance budget is now measured (issue #393, the (2b) paragraph above) and is nil on every ratified row; there is still no measured verdict on the budget's own sag, because the switching event is not integrated (#386)**: it is a drive requirement on whoever integrates this block, derived from a measured rail current, and, until #393, nothing in `sim/` had been run against a V_DD source that meets or misses it; the four governing extracted decks now show no ratified row responding to a source at the budget's edge. **DR-0036 is *proposed*, not operator-ratified** ("Status: proposed — requires operator sign-off"), so the ≥ 40 nF / ≤ 3 Ω figures are reported here against a proposed budget — the same footing on which the `Area` row above reports DR-0024's proposed `< 0.16 mm²` — not graded as a ratified bound this row passes or fails. **The on-die `ADC_BLOCK` term is a stated, unmet requirement**, which DR-0036's own Consequences call *"a stated FAIL-shaped gap rather than an unasked question … not a formality this block passes"*; it is unsized, so it cannot be graded either, and it is carried in the "not yet measured" list rather than folded into the PASS above | [`spec/decision-records/DR-0036-vdd-decoupling-budget.md`](../spec/decision-records/DR-0036-vdd-decoupling-budget.md) (**proposed — requires operator sign-off**; the budget, its derivation and its four open questions); [`sim/adc-rail-current/records/20260923-002945-1cefe83.md`](adc-rail-current/records/20260923-002945-1cefe83.md) <!-- evidence role=governing mode=schematic --> (27-point PVT grid — the 34.383980 mA peak, the 39.5421 / 40.120 µA averages and the per-branch split the budget is derived from; its own manifest states the peak is a **lower** bound, twice over); [`layout/power/records/20260923-010407-d84c7b4.md`](../layout/power/records/20260923-010407-d84c7b4.md) (the solved rail DR-0036 step 8 reads 523 Ω off) and [`layout/power/records/20260923-084734-5f13cf9.md`](../layout/power/records/20260923-084734-5f13cf9.md) (**current governing**, post-#378/#388 Metal2 straps); [`DR-0034`](../spec/decision-records/DR-0034-supply-droop-budget.md) (the *static* droop budget, also proposed, which DR-0036 does not re-open); [`DR-0004`](../spec/decision-records/DR-0004-device-flavor.md) (device flavour and the supply itself); every PVT record above (the ±10 % window). Filed follow-ups: **#386** (integrate the event directly), **#393** (drive the converter through a real V_DD network, the V_CM row's #358 done for this rail — **done on the four governing extracted decks**, no ratified row responds; schematic pairs not run) |
| Latency / conversion timing | 1 conversion, M = 16 clocks = 1 µs @ 1 MS/s | Deterministic, as above | **PASS** (rung-1; the rung-2 gate-level re-check of this same row is open — digital-partition section below) | `sar-logic-functional` `20260802-110241-131989b` + `sar-logic-timing` `20261031-191202-befcce4`, both cited in full in the Resolution and Clock rows above |
| Power @ 1 MS/s | < 1 mW (< 500 µW stretch) | **Schematic, DR-0019-resized `C_u = 35.6528 fF` (issue #205): 207.9 µW worst (`ff_-40c_3.63v`), +13.4 % vs. the pre-resize 183.3 µW** (worst-of-grid deltas per block, each at its own worst point: comparator −3.6 %, CDAC switch+driver essentially flat at −0.09 %, DR-0014 top-plate V_cm switch essentially flat at +0.26 %, V_REF +92.2 %, V_cm bias +38.9 %); **extracted (in-path, governing), re-taken at the same resize (issue #218): 246.5 µW worst (`ff_27c_3.63v`), +11.6 % on the 220.9 µW the pre-resize extraction reported and +18.6 % on the post-resize schematic number** — the growth lands on the two array-facing rails (`p_ref` +89.9 %, `p_cdac` +20.7 %) while the comparator term falls 16.6 %, the same decomposition consistency check the schematic side passes. The one-corner (`tt_125c_3.63v`) 2× comparator-current excursion does **not** reappear in this vintage, consistent with its diagnosis as a non-reproducible marginal-decision artefact rather than a corner/layout property. **Re-taken again after issue #215's comparator load-resistor fold and supply-corridor re-derivation (issue #224): 231.8 µW worst (`ff_27c_3.63v`, same corner), −6.0 % on the pre-#215 246.5 µW** — the one campaign where the layout change's effect is larger than `adc_top`'s aggregate −0.03 %/−0.21 % ΣR/ΣC move would suggest, because the comparator load-resistor fold changed a resistor the comparator's own dynamic switching current runs through directly (`p_cmp_f050_uw` −4.2 %); margins *widen* to 2.16× against the 500 µW stretch and 4.31× against the 1 mW primary target. **Re-taken again against the drawn-well-tap re-extraction (issue #381, DR-0035/#356 + DR-0037/#378): 218.6 µW worst (`ff_125c_3.63v`), −5.7 % on the pre-#356 231.8 µW, 27/27 PASS** — and that −5.7 % is not a broad improvement but the disappearance of one local comparator-current excursion the superseded record carried at `ff_27c_3.63v` (`p_cmp_f050_uw` 129.297 -> 114.715 µW, against ~111 µW at every other corner), the third time that class of excursion has failed to reproduce (`sim/extracted-delta-summary.md` §4.14.3). Margins widen to 2.29× against the 500 µW stretch and 4.57× against the 1 mW primary target | **PASS** (governing extracted result at the current design), 2.29× margin against the 500 µW stretch target and 4.57× against the 1 mW primary target; excursion tracked open (#107), not absorbed | [`sim/adc-power/records/20260923-102440-904af96.md`](adc-power/records/20260923-102440-904af96.md) <!-- evidence role=governing mode=extracted --> (**extracted, GOVERNING, post-DR-0035/DR-0037 re-extraction**, issue #381, supersedes `20260817-211252-076d545`; `sim/extracted-delta-summary.md` §4.14.3); [`sim/adc-power/records/20260817-211252-076d545.md`](adc-power/records/20260817-211252-076d545.md) <!-- evidence role=historical mode=extracted --> (extracted, pre-#356 geometry, post-#215 layout, issue #224, supersedes `20260817-174602-71b6844`; `sim/extracted-delta-summary.md` §4.13.3); [`sim/adc-power/records/20260817-174602-71b6844.md`](adc-power/records/20260817-174602-71b6844.md) <!-- evidence role=historical mode=extracted --> (extracted, pre-#215, resized `C_u`, issue #218, supersedes `20260807-084749-290d003`); [`sim/adc-power/records/20260826-085142-155595d.md`](adc-power/records/20260826-085142-155595d.md) <!-- evidence role=current mode=schematic --> (**schematic, current** — clean-tree re-run through `sim/characterize.sh` after issue #266 restored that script's missing `--corners tt ss ff` MOS-corner override on the schematic-baseline branch; reads **207.884 µW** at the same `ff_-40c_3.63v` corner, i.e. it **reproduces** the schematic figure quoted here rather than moving it, and confirms DR-0018's 2 % process-axis floor is correct as written); [`sim/adc-power/records/20260817-081223-afb1b3a.md`](adc-power/records/20260817-081223-afb1b3a.md) <!-- evidence role=historical mode=schematic --> (schematic, DR-0019 resized-`C_u` re-take, issue #205, supersedes [`20260802-141402-1224e11.md`](adc-power/records/20260802-141402-1224e11.md) <!-- evidence role=historical mode=schematic -->); `sim/extracted-delta-summary.md` §4.12.3 (§4.7/§4.10/§4.11.1 for the pre-resize campaign), tracking issue **#107** |
| Area | < 0.1 mm² | **151,827.342 µm² = 0.151827 mm² (current, as-built — `layout/adc-top/area.json` `block_total`, re-derived at issue #381)** — 152 % of the ratified `< 0.1 mm²` budget, after the CDAC MiM stack legalization (#70), issue #118's comparator growth, the DR-0019 unit-cap resize, issue #215's corridor/comparator-bbox recovery (−29,910 µm², −16.57 %, off the resize's own 0.18045 mm²), and **DR-0035's drawn well taps and tie straps (#356, +1,291.103 µm², +0.86 % off the previous 150,536.239 µm²)**; DR-0037's Metal2 strap move (#378) widens two comparator supply columns but leaves `block_total` unchanged. Superseded intermediate figures (0.12100 mm² pre-#118, 0.15446 mm² pre-resize, 0.18045 mm² pre-#215, 0.150536 mm² pre-#356) are no longer current. **Double-checked against the #238/#249 acquisition-leg-widening candidate**: this figure is unaffected because that candidate is evaluated and NOT adopted (DR-0025) — its own item-5 measurement ([`layout/adc-top/candidates/records/20260825-030447-4e220d1.md`](../layout/adc-top/candidates/records/20260825-030447-4e220d1.md)) is precisely why: at the candidate width `block_total` would grow to 176,126.8006 µm² (+17.00 %), +76.1 % over this row's still-ratified `< 0.1 mm²` target and +10.1 % over even the `< 0.16 mm²` figure proposed below, which is exactly the regression that ruled the candidate out | **FAIL against the ratified `< 0.1 mm²` budget**; a `< 0.16 mm²` revision bounding the current as-built figure is proposed for operator ratification, superseding DR-0017's own stale (and never-ratified) `< 0.13 mm²` proposal — not yet ratified | [`spec/decision-records/DR-0024-adc-top-area-budget-reconciliation.md`](../spec/decision-records/DR-0024-adc-top-area-budget-reconciliation.md) (supersedes [`DR-0017`](../spec/decision-records/DR-0017-adc-top-area-budget-overrun.md)); `layout/adc-top/area.json`; `layout/adc-top/README.md`; candidate NOT adopted: [`spec/decision-records/DR-0025-acquisition-leg-widening-not-adopted.md`](../spec/decision-records/DR-0025-acquisition-leg-widening-not-adopted.md) |
| Interface | Parallel register in scope; SPI deferred | Parallel output register verified functional on the current DR-0011 + DR-0014 controller | **PASS** (SPI explicitly out of scope, DR-0005; rung-1 — the rung-2 gate-level re-check is open, digital-partition section below) | [`sim/sar-logic-functional/records/20260802-110241-131989b.md`](sar-logic-functional/records/20260802-110241-131989b.md) <!-- evidence role=governing mode=schematic --> (**current controller**); [`20260801-041242-96c2ea7.md`](sar-logic-functional/records/20260801-041242-96c2ea7.md) <!-- evidence role=historical mode=schematic --> (first proof, pre-DR-0014) |

## What is not yet measured, stated rather than silently dropped

- **On-die local decoupling inside `ADC_BLOCK` — required, unsized, and not
  drawn.** This is the `Supply` row's third clause, reported here rather than
  as a value in the row because it has no value to report.
  [DR-0036](../spec/decision-records/DR-0036-vdd-decoupling-budget.md) clause
  3 (**proposed — requires operator sign-off, not yet ratified**) requires a
  local decoupling capacitance drawn adjacent to the CDAC decode banks,
  *inside* this block — not at its boundary and not in the parent — because
  the off-die ≥ 40 nF cannot deliver the sub-nanosecond leading edge of the
  34.38 mA switching peak through a package loop inductance. **The block as
  drawn has none**, which DR-0036's own Consequences record as "a stated
  FAIL-shaped gap rather than an unasked question". It is **unsized on
  purpose**: `C_local ≥ L·I_pk²/(2·ΔV_inst²)` needs a package loop inductance
  (this repo has no package model) and a ratified instantaneous-excursion
  allowance `ΔV_inst` for `V_DD` (none exists — DR-0034's 33 mV is a *static*
  figure, already spent on the static drop), and the record's own sensitivity
  table spans **5.43 pF to 228 nF** — 0.0027 mm² to 114 mm² at 2 fF/µm² —
  across the plausible `ΔV_inst` range. Nothing in the `Supply` row can be
  graded against it until one of those two inputs exists. Two filed
  follow-ups bound it from different ends — **#386** (integrate the switching
  event directly, replacing the 4.3×-loose charge bound with a measured
  `ΔQ_event` and width) and **#393** (drive the converter through a real
  `V_DD` network at the budget, the `V_CM` row's #358 done for this rail;
  **now measured: no ratified row responds**, but the event is still not
  integrated, so this does not by itself resolve `ΔV_inst`) —
  and the geometry it lands on moved after DR-0036 was written: #378 / PR #388
  put the block-level straps on Metal2, which DR-0036's Consequences say
  obliges a mutual re-read that has not happened.
- **Comparator-inclusive (`ADC_BLOCK`) statistical Monte Carlo** — the
  ratified `Offset ≤ 2 LSB` row's own 3σ population through the extracted
  core. `ADC_BLOCK` converts (issue #118) and its regeneration-margin
  campaign has run (issue #116), but the statistical offset population has
  not — issue #89 Scope item 2's remaining half.
- **INL/DNL's own `klt yield` envelope at the *built* `C_u`** — PR #149
  landed the envelope (`617de90`, 2026-08-17), but at the pre-resize
  `C_u = 17.24 fF`. No `klt yield` reformat of the INL/DNL row exists at
  DR-0019's built `C_u = 35.6528 fF`. The underlying measurement and verdict
  (PASS on the ratified row) are not in question — they come from
  `sim/adc-inl-dnl/`'s own post-resize records — only the machine-checkable
  envelope is stale, which is why `signoff/` cites the Gain-error-mismatch
  row's post-resize envelope for item 6 instead.
- **`klt pex` (T1 item 7)** — tried directly against the post-layout
  comparator and found structurally blocked (a DUT-interface pin-count
  mismatch `klt pex`'s single-`.include` swap mechanism cannot bridge, filed
  generically as [`klayout-tools#1030`](https://github.com/2AMLogic/klayout-tools/issues/1030)).
  This repo's own hand-built extracted-core wiring (`gen_extracted_core_tb.py`
  et al.) remains the operative post-layout methodology for every row above
  that cites an "extracted" figure; `klt pex` is not a gap in *this*
  document's numbers, only in tooling this repo would rather have used.
  [`sim/comparator-pex/records/20260815-230715-56fbe50.md`](comparator-pex/records/20260815-230715-56fbe50.md)

  **HISTORICAL — superseded for T1 item 7 by the 2026-10-08 update below.**
  The paragraph above describes the comparator-scoped 2026-08-15 run and the
  comparator-interface failure it hit. It is kept as the record of that
  attempt, not as the current state of `klt pex` on this repo.

  **Update — 2026-10-08, issue #428 / #432.** A block-scoped `klt pex` run
  against the current `layout/adc-top/adc_block.gds` (`ADC_BLOCK`: both CDAC
  sides, switch networks and drivers, top-plate switches, comparator) now
  completes: `klt` 0.7.0, exit 0, report `status: pass`, 4 of 4 delta rows
  passing. What unblocked it was `klt pex --pins` / `--deck-option`
  (klayout-tools#1558) plus a pin-matched schematic `ADC_BLOCK`;
  klayout-tools#1030 closed with diagnostics only.
  [`sim/adc-block-pex/records/20261008-185501-c618a90d.md`](adc-block-pex/records/20261008-185501-c618a90d.md)
  **Scope, stated rather than implied**: this is **one nominal PVT point**
  (`tt`, 3.3 V, 27 C) of the declared **117-point grid**, not the grid. The
  full grid was submitted to the Spot batch fleet first and did not run: every
  job failed `batch_job_failed` / `batch_runner_version_mismatch`, because the
  fleet runner image runs klt 0.5.0 and refuses a 0.7.0 client. Widening the
  run is a runner-image (worker-spec) change; it is a tooling limit, not an
  argument that the other corners would agree. The run also uses a separate,
  investigative `klt` pin; `layout/toolchain.json` is unchanged. Its rows are
  schematic-vs-extracted deltas of one sample/redistribute/decide sequence;
  they carry no ratified spec limit and are **not** the governing extracted
  spec measurements above. T1 item 7 (analog) being `met` is therefore not a
  full-corner performance signoff, and no row of the per-spec-row table moves
  because of it. This document's extracted figures still rest on the
  hand-built extracted-core methodology.

  **Update — 2026-10-15, issue #439: the committed 117-point grid has now
  run.** The one-point scope stated above is superseded. The fleet runner now
  runs klt 0.7.0 (`runner_compatibility: match`), so the same committed
  request
  (`CORNER_SETS['full']` × V_dd {2.97, 3.3, 3.63} V × {−40, 27, 125} C) ran
  on the Spot batch fleet under the same released `klt` 0.7.0 pin, against
  the same GDS (`sha256:501f3985…d748`). It extracted the same netlist
  (`sha256:91c044dc…baf0`, 1349 devices). Result: exit 0, `status: pass`,
  **468 of 468 delta rows passing over 117 corners**. Every corner resolves
  the sign the stimulus sets (dout ≤ 5.04e-5 V, doutb ≥ 2.97 V on the
  extracted side). The extracted residue `vres_diff` is −0.4906 … −0.4886 V,
  1.24 … 1.54 % below the schematic side.
  [`sim/adc-block-pex/records/20261015-071816-0dacd542.md`](adc-block-pex/records/20261015-071816-0dacd542.md)
  The remaining caveats above still hold. This is one
  sample/redistribute/decide stimulus, not the spec suite. Its rows carry no
  ratified limit. No row of the per-spec-row table moves because of it.
- **The Gain error, mismatch resizing decision** — issue #177 /
  `spec/decision-records/DR-0019-cdac-unit-cap-resize-for-gain-error-margin.md`
  make and verify the sizing decision that closes the 2.12σ-vs-3σ gap the
  pre-resize measurement reported as FAIL (now the governing **PASS**,
  `sigma_to_spec = 3.13` at the resized `σ_u`,
  `sim/mc-cdac-mismatch/records/20260816-125421-737d16e.md`; superseded —
  see the Gain error, mismatch row above); per CLAUDE.md, no spec value is
  relaxed to close it. **Physically implementing the
  resize** — updating `design/adc-top/gen_adc_top.py` / `layout/adc-top/`'s
  unit-cap constants — is **DONE** (issue #196, merged PR #202).
  **Re-running the full transistor-level PVT verification suite at the new
  `C_u`** is issue #190/#197's decomposed follow-up. It is now **complete at
  the schematic level** — every campaign whose recorded result depends on
  `C_u` has been re-run and recorded (the eight-item list below); the
  **extracted** side is untouched and is issue #218. The
  schematic-level ENOB/FFT + SFDR slice (issue #204)
  surfaces a **new, unbudgeted regression** — worst schematic ENOB drops
  from 9.163 to 8.5064 bits (now FAILING the > 9.0 target at 2 of 9 grid
  points) and the pre-existing SFDR FAIL widens from a 0.67 dB to a 5.59 dB
  gap (see the ENOB @ Nyquist / SFDR @ Nyquist rows above). This is
  reported, not fixed, here — DR-0019's own sizing decision is not
  re-litigated by this document, but the dynamic-performance cost of that
  decision was not previously measured and is now on the record.
  **Per-campaign status of that re-verification, as of this revision**
  (**eight** schematic-level slices, one per campaign whose recorded result
  depends on `C_u` — #197's own scope named four; re-running them found two
  more decks PR #202 had regenerated without re-taking their records, and a
  further two that PR #202 could not have reached at all because they model
  the array as one lumped MiM capacitor rather than consuming generated
  `adc-top` output).
  The consolidated before/after adjudication for all of them, with the
  commands that re-derive each number, is
  `spec/testbench-suite-memo.md` §11.9:
  - ENOB/FFT + SFDR — **done** (issue #204, PR #210): regression, see above.
  - Power — **done** (issue #205, PR #212): +13.4 % total, still PASS with
    2.4× margin against the 500 µW stretch (Power row above).
  - CDAC bit-settling, 117-point grid — **done** (issue #197, this change):
    the gating `err_1msps_*` budget check does not move at all (0 mV on the
    whole grid); the 1.5 ns in-transient lag and the `lag_ord_256_64`
    ordering margin do move, both still PASS (Reference row above). This
    slice also had to fix the campaign's own testbench first: PR #202 resized
    the three sibling `adc-top`-derived decks but not
    `sim/cdac-bit-settling/testbench/tb_cdac_bit_settling.spice`, so a re-run
    without that fix would have re-certified the pre-resize array.
  - Top-plate `C_par` decomposition — **done** (issue #197): the array
    scales ×2.068 and the load on it does not, so the
    `C_arr/(C_arr + C_par)` divider loss *halves* (0.9951 → 0.4821 % mean);
    the top-plate `V_cm` switch term is **bit-identical** before and after
    (16.7721 fF mean). This slice also had to fix its own deck first, the
    same way the settling slice did: PR #202 regenerated
    `tb_top_plate_cpar.spice` at the new geometry but left the deck's
    `c_arr_v1p65_ff` window hard-coded around the pre-resize array, so all
    63 points failed a bound that is a sanity check on `512 × C_u`, not a
    ratified target. The window is now *computed* from `C_UNIT_FF`
    (§11.9.5).
  - DR-0014 mechanism deck (`sim/dr0014-sampling/`) — **done** (issue #197):
    27/27 PASS. The **Gain error, systematic** row improves 2.26×
    (0.0045–0.0088 → 0.0021–0.0039 LSB) and the **Input structure `R_on`**
    range is **bit-identical** at all 27 points — see both rows above and
    §11.9.6. Its re-take also complicates the mechanism story behind the
    ENOB/SFDR regression: the acquisition bow `spec/testbench-suite-memo.md`
    §11.2 argues from *improves* across the resize at 8 of 9 corners while
    SFDR degrades (§11.9.7) — a datum for #211, not a resolution of it.
  - Static INL/DNL — **done** (issue #203, PR #214): 63/63 PASS and the row
    the resize was *for* does not move — worst \|INL\| 0.1036 → 0.1100 LSB,
    worst \|DNL\| 0.1036 → 0.0938 LSB, both still 4.5–5.3× inside the
    < 0.5 LSB stretch (INL/DNL row above, §11.9.10). Per corner the movement
    is mixed rather than systematic, which is the expected null for a
    linearity set by *ratios* of units that all scaled together.
  - Track-mode THD, the switch's own SFDR share (`sim/track-switch-thd/`) —
    **done** (issue #197, this change): **a ratified-target miss, flagged**.
    All 117 points lose 4.96–5.77 dB and 11 of 117 fall below the ratified
    62 dB where none did before (SFDR row above, §11.9.11). This deck's
    distortion term is *linear* in the array capacitance, which makes it the
    first measured mechanism that moves the same way and by the same size as
    the end-to-end SFDR regression #211 owns.
  - Input drive contract (`sim/track-switch-sampling/`) — **done** (issue
    #197, this change): 117/117 PASS and the ratified row *improves*
    (+0.082…+0.370 LSB, was −0.293…+0.421), because every charge-injection
    term is `Q_inj/C_hold`. One quantity moves the other way and is recorded:
    acquisition settling at the 100 pF/250 Ω drive point ×5.0, to 0.0103 LSB
    (Input drive-contract row above, §11.9.12).
  - **Neither of the last two decks was regenerated by PR #202** — they do
    not consume `adc-top` generator output, so both still drew the pre-resize
    66.36 µm lumped array square (8.827 pF) and their standing records
    certified a load half the size of the array now drawn. The census of
    `C_u`-bearing decks is therefore eight, not six.
  - **Extracted (post-layout) re-verification of all of the above — done**
    (issue #218). The #202 layout was re-extracted (1024 MiM caps at
    `c_f = 35.6528 fF` / 16.0 µm², against 17.245 fF / 7.366 µm² before) and
    all five extracted campaigns re-run against it, each superseding its
    pre-resize record on the same deck, manifest and grid. Every extracted
    figure this document cites is now post-resize. Outcome, per
    `sim/extracted-delta-summary.md` §4.12: **ENOB and SFDR now FAIL on the
    governing side** (8.857 bits, 60.40 dB) — the SFDR row had *no* valid
    governing result while its extracted side was pre-resize, and its first
    valid one is a 1.60 dB miss; **INL/DNL still PASSes its ratified row but
    misses the `< 0.5 LSB` stretch** post-layout (0.528 / 0.728 LSB);
    **power PASSes** at 246.5 µW (+11.6 %); the **`Gain error, systematic`**
    row *improves* to ~1047× inside its bound; and the **Input structure
    `R_on`** row is an **exact null** (the switch leaf is not resized). The
    mechanism behind the ENOB/SFDR regression remains #211's, which has since
    isolated it to the acquisition `R_on·C_arr` time constant
    (`sim/dr0019-cu-sweep-findings.md`) — the post-layout re-take is
    consistent with that, since the drawn in-path resistance is exactly what
    the extraction adds.
- **CDAC capacitor mismatch under Monte Carlo** — not applicable: the PDK's
  MiM subckt has no local mismatch model on either netlist (`sim/tools/pdk_mismatch_audit.py`).
- **Direct CMRR at the ratified ±100 mV common-mode band** — measured at
  ±50 mV and linearly extrapolated (stated limitation, `spec/testbench-suite-memo.md`
  §10/§12 item 7).
- **A 2× comparator-current excursion at one power corner** (`tt_125c_3.63v`,
  #107) — investigated across two independent campaigns and found not to
  reproduce run-to-run; carried open as a marginal-decision artefact rather
  than absorbed into the passing Power row's margin statement.

## Digital partition (`sar_ctrl_a`) — Fmax, area and power across the corner set

**Why this section exists separately.** This block's `kind` is
`mixed-signal`, and T1 item 8 asks a *digital* partition for something the
analog table above does not carry: *"Fmax, area, and power across the corner
set, not just functional pass/fail"*
(`klayout-tools`' `docs/design-evidence-tiers.md`). The SAR sequencer is no
longer the rung-1 ideal XSPICE model the analog rows above are simulated
against — it is RTL, synthesized to `gf180mcu_fd_sc_mcu7t5v0` standard
cells, formally equivalence-checked, placed and routed into the footprint
`layout/adc-top/` reserves for it, DRC-clean, and timed post-route across a
corner set. This section aggregates that, from the committed `klt` response
JSONs, and states what it does **not** cover.

**Everything below is transcribed from a committed `klt` response, exactly
as the analog table is transcribed from `sim/` records.** This section
creates no numbers of its own.

### Implementation summary

| Quantity | Value | Source |
|---|---|---|
| RTL top | `sar_ctrl_a` | `design/sar-logic/rtl/` |
| Synthesis (`klt synthesize`, yosys `0.69+post`) | `status: ok`; **181 instances**, cell area **4961.152 µm²** (sequential 2864.736 µm²) on `gf180mcu_fd_sc_mcu7t5v0` | [`…2d1394f.mcu7t5v0.synthesize_response.json`](../design/sar-logic/flow/sar_ctrl/reports/20260910-224930-2d1394f.mcu7t5v0.synthesize_response.json), record [`20260910-224930-2d1394f.mcu7t5v0.md`](../design/sar-logic/flow/sar_ctrl/records/20260910-224930-2d1394f.mcu7t5v0.md) |
| Second library, synthesized but **not** carried forward | `gf180mcu_fd_sc_mcu9t5v0`: 187 instances, 6917.7024 µm² — the 7-track library is the one placed and routed | `…2d1394f.mcu9t5v0.synthesize_response.json` |
| Formal equivalence RTL ↔ gates (`klt equiv`, `yosys-sequential`) | **`status: equivalent`**, induction depth 4, zero counterexamples — on **both** libraries | `…2d1394f.{mcu7t5v0,mcu9t5v0}.equiv_response.json` |
| Place & route (`klt place-and-route`, OpenROAD `26Q3-1510-g6cb3f2b704`) | `status: ok`, `stage_reached: route`. **Die area 7968.400 µm²** (199.210 × 40.000 µm) = **exactly** the ring-exclusive core box `layout/adc-top/` reserves; core 7792.96 µm²; utilization **67.72 %**; wirelength 7274 µm; **0 route-DRC, 0 antenna** violations | [`…3a9a8ba.mcu7t5v0.pnr_response.json`](../design/sar-logic/flow/sar_ctrl/reports/20260915-000027-3a9a8ba.mcu7t5v0.pnr_response.json), record [`20260915-000027-3a9a8ba.mcu7t5v0.pnr.md`](../design/sar-logic/flow/sar_ctrl/records/20260915-000027-3a9a8ba.mcu7t5v0.pnr.md) |
| DRC of the merged routed GDS (`klt drc`, deck `gf180mcu`) | **`status: clean`**, 0 violations — this is the artifact `signoff/`'s item **3.digital** cites | `…3a9a8ba.mcu7t5v0.pnr_drc.json` |
| LVS of the routed macro | **Does not exist.** No golden SPICE reference for the merged GDS is generated in this repo — which is why `signoff/`'s item **4.digital** is uncited rather than borrowing the analog block's compare | `…pnr.md` §Scope |

The reserved-footprint claim is stronger than "the reported area matches":
the run used an **explicit** floorplan fixed at the reserved box with no
margin, so OpenROAD reaching `stage_reached: "route"` at all *is* the
fit evidence — a design that did not fit would have raised a
legalization/placement failure before any routed DEF was written.

### Fmax, timing and power across the corner set (post-route)

One fixed routed DEF (`layout/adc-top/sar_ctrl/sar_ctrl.def`,
`geometry_source: "routed"`), swept across corners by real `klt sta` — **not**
re-placed per corner. Budget: DR-0003's 62.5 ns bit-cycle period
(16.00 MHz, M = 16 at 1 MS/s).

| Corner | Setup slack (ns) | Setup TNS | Hold slack (ns) | Hold TNS | **Fmax (MHz)** | **Est. power (mW)** |
|---|---|---|---|---|---|---|
| `tt_025C_3v30` † | PASS +59.4791 | 0.0000 | PASS +1.1464 | 0.0000 | 331.02 | 0.2787 |
| `ss_125C_3v00` † | PASS +56.3650 | 0.0000 | PASS +2.3195 | 0.0000 | **163.00** | 0.2360 |
| `ss_n40C_3v00` | PASS +58.1701 | 0.0000 | PASS +1.6311 | 0.0000 | 230.95 | **0.2260** |
| `ff_125C_3v60` | PASS +60.0932 | 0.0000 | PASS +0.9096 | 0.0000 | 415.49 | **0.3476** |
| `ff_n40C_3v60` † | PASS +60.7878 | 0.0000 | PASS +0.6512 | 0.0000 | 584.03 | 0.3310 |

† named individually by DR-0023's ratified 3.3 V corner grid; the other two
are the remaining 3.3 V corners `gf180mcu_fd_sc_mcu7t5v0` ships, swept here
rather than left unasked.

- **Setup: PASS at every corner. Hold: PASS at every corner.** Worst setup
  slack **+56.3650 ns** against the 62.5000 ns budget (90.2 % of the period
  still unspent) at `ss_125C_3v00`; worst hold slack **+0.6512 ns** at
  `ff_n40C_3v60`.
- **Worst-corner Fmax 163.00 MHz against a 16.00 MHz requirement** — a
  10.2× margin. Fmax is `report_fmax_metric`'s own extrapolation, **not** a
  bisected search (`klt`'s own stated caveat for every `sta` run).
- **Estimated power 0.2260 – 0.3476 mW** across the corner set, worst at
  `ff_125C_3v60`. This is OpenSTA's estimate for the routed macro alone; it
  is **not** additive with the analog table's Power row without care — that
  row's 231.8 µW is the extracted **analog** core, and its records state
  plainly that the rung-1 sequencer contributes zero measured current
  because it contains no devices (DR-0010 rung 1). Summing the two is the
  obvious next step and is **not** done here, because nobody has run the
  combined measurement and this document transcribes rather than derives.
- Source: record
  [`20260915-093934-7ab8971.mcu7t5v0.sta_postroute.md`](../design/sar-logic/flow/sar_ctrl/records/20260915-093934-7ab8971.mcu7t5v0.sta_postroute.md)
  and the five per-corner `…sta_postroute_<corner>.sta_response.json` files
  beside it. It carries `Supersedes: 20260914-235615-7022eab.mcu7t5v0.sta`
  — the pre-route record, whose `klt place-and-route --target_stage place`
  substitution re-placed the design per corner (a sweep of N designs, not a
  characterization of one) and reported hold as a violation count only.

**Disclosed limitations of these timing numbers**, carried from the record
rather than dropped:

1. **No wire parasitics; not SPEF-annotated.** These timing numbers carry
   no wire parasitics at all (unannotated, Liberty pin capacitance only). The
   generated `klt sta` script has no `estimate_parasitics`, `set_wire_rc` or
   `read_spef` step, and `klt`'s `sta` documentation calls the no-`spef` case
   "unannotated, LEF-capacitance-only". An earlier version of this paragraph
   described the baseline as timed from a LEF/DEF-geometry RC estimate; that
   was wrong, and is corrected by the "Correction to how the baseline is
   described" section of
   [`20261009-131918-bf22e71c.mcu7t5v0.sta_postroute_spef.md`](../design/sar-logic/flow/sar_ctrl/records/20261009-131918-bf22e71c.mcu7t5v0.sta_postroute_spef.md)
   (the baseline record itself is append-only and unedited). The clock tree,
   placement and routing are #279's real committed geometry, but this is not
   a SPEF-annotated signoff number. A later experiment (issue #481, that
   same record) extracted a SPEF from the routed GDS and annotated it, but
   the annotation was only partial and was REJECTED at all five corners, so
   no extracted-parasitics timing is quoted here and the Fmax figures above
   are not replaced by it. The margin at every corner is wide enough that
   the gap is unlikely to flip the verdict; that is an engineering judgment,
   stated, not a proof.
2. **Ideal SDC clock, not propagated; Fmax not bisected.** The same caveat
   `klt`'s `sta` documentation states for every run of that verb.
3. **Interconnect corner `nom` only** on the P&R run; the 15-corner liberty
   sweep the P&R response also reports (worst setup +41.0121 ns at
   `ss_125C_1v62`) spans the library's 1.62–5.50 V range, most of which is
   outside this block's ratified 2.97–3.63 V supply row and is therefore
   **not** quoted as this partition's corner set.

### Functional status of the digital partition — open, and deliberately a pointer

T1 item 8's digital sentence says Fmax/area/power is wanted *"not just"*
functional pass/fail, so the functional half belongs here too. It is
**not closed**, and this document deliberately states its status by pointer
rather than transcribing figures that are moving week to week:

- **Rung-1 (ideal XSPICE sequencer model, DR-0010)** — **PASS**. This is
  what the analog table's Resolution / Latency / Clock / Interface rows rest
  on: `sim/sar-logic-functional/records/20260802-110241-131989b.md` and
  `sim/sar-logic-timing/records/20261031-191202-befcce4.md`.
- **Rung-2 (SPICE replay of the real synthesized gate netlist)** —
  **NOT PASSING, and under active root-causing.** Six campaigns
  have committed records (`sim/sar-logic-functional-gates/`,
  `sim/sar-logic-timing-gates{,-ok,-tie,-lt,-xl}/`; a seventh,
  `sim/sar-logic-timing-gates-bad/`, has a testbench and no record yet);
  as of `93ddfe3` each of those six's latest record reads `FAIL` or
  `ERROR`, with
  causes so far attributed to deck-composition and ngspice-convergence
  artifacts rather than to sequencer defects, plus two accepted findings
  already carried into decision records ([DR-0027](../spec/decision-records/DR-0027-gate-decode-one-hot-hazard-budget.md)'s
  bounded gate-decode one-hot hazard, [DR-0028](../spec/decision-records/DR-0028-gate-level-acquisition-isolation-bounds.md)/[DR-0030](../spec/decision-records/DR-0030-functional-deck-acquisition-isolation-bounds.md)'s
  acquisition/isolation bounds, [DR-0031](../spec/decision-records/DR-0031-power-up-first-conversion-validity.md)'s
  power-up first conversion). **Read each campaign's own latest record for
  its current state — not this paragraph.** This is a deliberate choice:
  transcribing a figure from a campaign that mints a new record every day or
  two would make this document stale on the day it is written, which is the
  exact defect the Freshness section above exists to prevent.
- **Consequence for `signoff/`**: this is also why the digital partition's
  item **5** ("Full corner verification vs a ratified spec") is uncited
  there. Item 8 grades whether an *aggregated, current characterization
  artifact* exists; it does not grade whether the partition passes. Those
  are different rows on purpose.

## How this document is kept in sync

This is a **snapshot table**, not a live query — it will drift the same way
`README.md`'s Status paragraph drifted before this issue. There is no
automated freshness check *of its contents* (a candidate for future tooling,
not built here). The discipline that keeps drift bounded: every PR that mints
a new `sim/` record superseding a citation in this table, or that changes a
verdict, is expected to update the corresponding row here in the same PR —
the same discipline `README.md`'s own Status table and
`spec/testbench-suite-memo.md`'s coverage map already follow. A reader who
finds a citation here that no longer matches its record's own `Supersedes`
chain has found a drift and should file it, the same way `README.md`'s own
one-PR lag was found and fixed by this issue — and the same way this
document's own four currency defects were found and fixed by the 2026-09-21
re-read recorded in the Freshness section.

**What *is* machine-checked, as of issue #339.** This file's bytes are
pinned. `signoff/evidence/characterization-summary.{analog,digital}.json`
are two generic evidence envelopes (`"kind": "generic"`, the only kind T1
item 8 accepts) that record this document's sha256 and assert
`status: "pass"` over it; `signoff/gf180-sar-adc.manifest.json` cites them
for `8.analog` / `8.digital`, and `python3 signoff/run_signoff.py --check`
re-hashes this file on every pull request. **That check proves the bytes
graded are the bytes committed — it cannot prove the bytes are still
true.** Editing this document without re-running
`python3 signoff/run_signoff.py --regen` turns CI red, which is the point:
a change here is a change to a signed claim, and it has to be re-asserted
deliberately rather than drift in unremarked. What still has to be done by a
human is the re-read itself.

**What is machine-checked about the *contents*, as of issue #437.** The
"no automated freshness check *of its contents*" sentence above was true
when it was written. Issue #437 built that check for one part of this
document: `python3 sim/tools/check_characterization_summary.py`, which runs in
`npm run check:ci` and in headless CI. It covers the `Source (dated)` column
of the per-spec-row table only:

- every link from that column into `sim/<campaign>/records/` must carry a
  `<!-- evidence role=governing|current|historical
  mode=schematic|extracted|other -->` marker right after it, and the mode
  must match the record's own `Netlist provenance`;
- a `governing` or `current` citation fails if a same-mode record declares
  `Supersedes` on it (directly or through a chain);
- it also fails if a newer same-campaign, same-mode record is neither cited
  in that row as `governing` or `current` (so it is checked in its own
  right) nor listed, with a reason, in
  `sim/tools/characterization_citation_exceptions.json` under the exact
  (row, mode, cited, newer) tuple. Linking the newer record in the row as
  `historical` does not count.

`historical` citations only have to exist. When a PR mints a record that
supersedes or post-dates a citation here, CI now goes red until this table, or
an exact exception, says what that record is. The check still does not prove
that a transcribed figure is right. The re-read remains a human job.
