2AMLogic/gf180-sar-adc/sim/adc-enob-fft/investigations/20261105-issue-430-27pt-temperature-coverage-result.md

# Issue #430 -- 27-point extracted ENOB/SFDR temperature-coverage result (2026-11-05)

- **Date**: 2026-11-05 (UTC), submit 12:52, record minted 12:52:30, wall time 1004 s
- **Base commit**: `b281aa87` (main), clean tree at run time
- **Evidence record**: [`records/20261105-125230-b281aa8.md`](../records/20261105-125230-b281aa8.md) -- **27 of 27 declared points completed**, no aborts, no missing points. Raw logs and klt reports are in the artifact store (manifest `manifests/artifacts/adc-enob-fft-20261105-125230-b281aa8.manifest.json`, fetched hash-verified for this analysis).
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
