2AMLogic/gf180-sar-adc/WORK_LOG.md

# Work Log

Merged pull requests and closed issues from the initial 30-day lookback (2026-09-07 onward). Earlier activity remains in GitHub history. Guide document maintenance PRs are excluded.

## Archives

- [2026-09](work_log/WORK_LOG_2026-09.md)

### 2026-11-14

- **PR #787**: evidence(sim): record #779's fleet refusal and the deck's measured per-point cost

### 2026-11-13

- **PR #791**: refactor: retire the dead --in-path-control positive control
- **Issue #789** (closed): gen_extracted_switch_ron_tb.py --in-path-control raises instead of emitting its positive control
- **PR #790**: fix: decide the body tie from the remediation partition, drop the dead raw probe
- **Issue #784** (closed): Remove the dead raw-body probe from verify_remediation_dc.py and fix its stale body-tie check
- **PR #785**: fix: skip the non-ok deck copy when the log dir is the workdir
- **Issue #783** (closed): bug: --no-write crashes with SameFileError when a batch point does not score ok
- **PR #775**: docs: name the OSU 3.3 V libraries in every ciel enable command
- **Issue #772** (closed): docs(environment-setup §3): the documented `ciel enable` command installs neither the OSU 3.3 V libraries nor mcu7t5v0
- **PR #773**: evidence(sar-logic-timing-gates-ok): 45/45 under f6eeac7, and the batch job-split that made it runnable
- **PR #766**: fix(sim/harness): scope the fleet pin check to members that banked points
- **Issue #760** (closed): sim/harness: a Spot-interrupted member discards every good point in the set as 'toolchain drift'
- **PR #768**: feat(signoff): re-hash the files an attestation envelope records in --check
- **Issue #764** (closed): signoff --check passes with a stale item-9/10 envelope; --regen does not re-attest them
- **PR #767**: test(signoff): fail CI when a testbench inventory's PDK pin drifts from sim/toolchain.json
- **Issue #762** (closed): signoff: add a CI test that the testbench-inventory PDK pin matches sim/toolchain.json
- **PR #763**: docs(spec): cite the standard-cell device by its f6eeac7 name; repair the LVS wrong-width control
- **Issue #757** (closed): Stale 6V-oxide standard-cell references after the f6eeac7 re-pin (tb.json note, DR-0023 evidence, LVS runner regex)
- **Issue #761** (closed): signoff: both testbench inventories still pin the pre-#517 open_pdks revision c6d73a3
- **PR #758**: fix(harness): withhold the Supersedes pointer when no point reached ok
- **Issue #755** (closed): run_corners.py writes a Supersedes pointer even when every point errored, letting a measurement-free record displace a measured one
- **PR #756**: sim(sar-logic): regenerate the gate-level decks under open_pdks f6eeac7 and re-pin T1 item 9
- **Issue #632** (closed): Nightly PDK check failed (sim/selftest.sh stages 2-4)
- **PR #752**: docs(signoff): replace per-re-pin chain narration with id-named row movers
- **Issue #750** (closed): signoff/README.md: prose after the current-record pointer describes an older record
- **PR #751**: docs(DR-0043): record that the deferred power/PEX/signoff re-baseline landed
- **Issue #692** (closed): Re-baseline klt power droop and re-run block PEX sims after the SAR-reserve notch layout (follow-up to #667)
- **PR #747**: sim: re-qualify sar-logic-functional under f6eeac7; wait for batch capacity

### 2026-11-12

- **PR #744**: Bump Repo Skills 0.25.10 -> 0.26.1

### 2026-11-09

- **PR #740**: sim: re-qualify C_u, acquisition-width and V_cm drive sweeps under open_pdks f6eeac7
- **Issue #622** (closed): Re-pin signoff T1 item 8 evidence after dr0014-sampling re-qualification edited characterization-summary.md
- **Issue #616** (closed): Re-qualify dr0019-cu-sweep, acq-leg-width-sweep (x1.1..x2.068), vcm-drive-impedance under open_pdks f6eeac7 (part of #595)

### 2026-11-08

- **PR #737**: sim(comparator-preamp-noise): re-qualify noise grid under f6eeac7 on the batch fleet
- **Issue #609** (closed): Re-qualify comparator-offset-gof/-offset-mc/-preamp-noise records under open_pdks f6eeac7 (part of #593)
- **PR #736**: ci: run the headless check list from package.json only
- **Issue #734** (closed): Collapse duplicated CI check list: package.json check:ci and ci.yml have drifted
- **PR #733**: feat(sim): record platform, ngspice banner and observed front-end mode
- **Issue #468** (closed): sim(harness): record platform, full ngspice banner and ngspice front-end mode in every record (follow-up to #459)

### 2026-11-07

- **PR #730**: Bump Repo Skills 0.25.1 -> 0.25.10

### 2026-11-06

- **PR #693**: layout(adc-top): SAR reserve in top-right notch with L-shaped analog guard ring
- **Issue #667** (closed): layout: place the SAR-logic reserve in or beside the analog core instead of a full-width stacked band
- **Issue #471** (closed): Auditor Capability Request: ngspice >=46 on audit host (installed 42 trips toolchain pin)
- **PR #725**: refactor(sim): share sweep point-loop driver across the three run_sweep.sh scripts
- **Issue #724** (closed): Simplify: share one sweep driver across the three sim run_sweep.sh scripts

### 2026-11-05

- **PR #723**: refactor(sim): share full-PVT campaign driver between vcm and vdd
- **Issue #722** (closed): Consolidate vcm/vdd run_full_pvt.sh campaign drivers (parallel drift: vdd lacks KLT_CMD/SUPERSEDES hooks)
- **PR #718**: feat(sim): re-qualify adc-offset-mc pilot under open_pdks f6eeac7 on the batch fleet
- **PR #717**: feat(sim): 27-point extracted ENOB/SFDR temperature grid; cold corner governs both rows
- **Issue #430** (closed): Establish extracted ENOB/SFDR temperature coverage beyond the hot-only FFT subset
- **PR #714**: feat(sim): re-qualify adc-enob-fft schematic 9-point grid under open_pdks f6eeac7 on the batch fleet
- **PR #715**: feat(sim): re-qualify track-switch sampling and THD on the batch fleet
- **Issue #618** (closed): Re-qualify track-switch-sampling and track-switch-thd under open_pdks f6eeac7 (part of #595; blocked on klt sim control steps)
- **PR #713**: docs(sim): record #430 preflight on 0.9.0 runner refused by fleet vCPU budget
- **PR #711**: feat(sim): re-qualify adc-inl-dnl schematic grid under open_pdks f6eeac7 (batch fleet)
- **PR #704**: feat(sim): re-qualify adc-power grid under open_pdks f6eeac7 (batch fleet)
- **PR #706**: sim: re-qualify four device/comparator experiments under open_pdks f6eeac7 on the batch fleet
- **Issue #601** (closed): Re-qualify cdac-bit-settling, top-plate-cpar, smoke-sar-bias, adc-block-pex records under open_pdks f6eeac7 (part of #593)
- **PR #709**: fix(pex): store adc-block-pex evidence via the artifact store
- **Issue #708** (closed): run_pex_adc_block.py commits raw per-corner PEX output; store it via the artifact store (DR-0041)
- **PR #705**: docs(adc-offset-mc): record passing batch-compatibility gate on rebaked runner

### 2026-11-04

- **PR #702**: docs(sta): record clean-tree re-run of the 0.8.0 gated SPEF qualification
- **PR #701**: docs(sar_ctrl): note the 0.8.0 gated SPEF run and its limits in the macro README
- **PR #698**: feat(sta): pin klt for the extracted-SPEF STA flow and record a 0.8.0 qualification run
- **PR #697**: sim: re-qualify device-comparator-gm-id under open_pdks f6eeac7 (1 of 7)

### 2026-11-01

- **PR #688**: Bump Repo Skills 0.24.7 -> 0.25.1

### 2026-10-31

- **PR #686**: sim: measure intermediate acquisition-leg width spectral points (1.1x-2.068x)
- **Issue #429** (closed): Measure intermediate acquisition-leg widths before choosing an ENOB/SFDR recovery candidate
- **PR #684**: sim: re-take sar-logic-timing supply grid on corrected deck
- **Issue #460** (closed): sim(sar-logic-timing): re-take the Clock row's supply-axis grid on the #371-corrected deck
- **PR #680**: docs: index superseded evidence records outside records/
- **Issue #679** (closed): Follow-on from PR #676: list superseding records next to the record they supersede
- **PR #676**: docs: append correction for ADC_TOP 10 µm fold-point area (+5.3 %, not +7 %)
- **Issue #674** (closed): Correct '+7 %' ADC_TOP figure in decode-bank folding record 20261030-223000-be1c350

### 2026-10-30

- **PR #670**: docs(layout): area-limit analysis of adc_block per sub-block
- **Issue #644** (closed): T1 item 5 (analog, Area row): resolve adc_block 0.151827 mm^2 against the ratified < 0.1 mm^2 (DR-0024 is proposed, not ratified)
- **PR #673**: docs(layout): record decode-bank folding as a null area result
- **PR #672**: analysis(layout): CDAC array edge margin is the dummy ring; keep it
- **PR #671**: docs: SAR-reserve right-column placement analysis and DR-0042
- **Issue #669** (closed): layout: quantify the CDAC array edge-margin area against its matching role
- **Issue #668** (closed): layout: fold the decode banks to recover their non-drawn bbox area

### 2026-10-28

- **PR #663**: refactor(flow): route synth_sar_ctrl klt calls through run_klt_json
- **PR #661**: refactor(flow): route sar_ctrl klt calls through run_klt_json
- **PR #657**: sim: add post-resize klt yield evidence for INL/DNL 3σ row
- **Issue #656** (closed): INL/DNL 3σ Monte Carlo klt yield evidence for T1 item 6 (split from #654)

### 2026-10-27

- **PR #649**: refactor: share liberty_path and working_tree_dirty via flow_env
- **PR #648**: feat(signoff): cite multi-corner STA and cocotb suite as 5.digital
- **Issue #646** (closed): Consolidate duplicated liberty_path/working_tree_dirty helpers into flow_env.py
- **Issue #642** (closed): T1 item 5 (corner verification, digital): one multi-corner klt sta citation and a klt functional-verification envelope for sar_ctrl

### 2026-10-23

- **PR #637**: feat(sim): store new run evidence in the artifact store, commit manifests
- **Issue #636** (closed): Adopt the common artifact store for sim evidence (manifests in git, bytes via klt artifact)

### 2026-10-21

- **PR #630**: Bump Repo Skills 0.24.3 -> 0.24.7
- **PR #577**: ci: drop loom-ui OIDC result step from nightly-pdk
- **Issue #576** (closed): Drop the loom-ui result step from nightly-pdk (CI pushes nothing; no OIDC)
- **PR #626**: sim(dr0014-sampling): narrow the Linux-vs-macOS tp_inj offset to the host ngspice environment
- **Issue #623** (closed): Explain ~0.007 LSB tp_inj offset between extracted dr0014-sampling records 20261007-0719/0721 and 20260923-1044 (same deck bytes)
- **PR #624**: sim(dr0014-sampling): re-qualify the 7 live records under open_pdks f6eeac7 on the batch fleet
- **Issue #615** (closed): Re-qualify dr0014-sampling records under open_pdks f6eeac7 (part of #595)
- **PR #620**: docs: record #617 re-qualification refused by saturated batch fleet

### 2026-10-20

- **PR #619**: test: collect qualification-request seed-schedule test under unittest
- **Issue #613** (closed): Fix inert test: qualification-request test in test_adc_offset_mc.py is never collected
- **PR #612**: sim(harness): export klt_sim analysis steps; record blocked fleet re-run of comparator noise/offset decks
- **PR #611**: sim(comparator): re-qualify offset and regeneration under f6eeac7 on the batch fleet
- **Issue #600** (closed): Re-qualify comparator-* characterization records under open_pdks f6eeac7 (part of #593)
- **PR #604**: sim(comparator-kickback): re-qualify under open_pdks f6eeac7 via batch fleet
- **PR #603**: sim: re-qualify timing-budget-closure and acq-leg-width-sweep x1.0 under open_pdks f6eeac7 (partial)
- **PR #602**: fix(signoff): re-pin T1 evidence after #517 changed pinned files
- **Issue #598** (closed): main CI red: signoff freshness check fails with 4 stale evidence pins
- **PR #597**: ci: request standard-cell library in ciel enable and guard its SPICE file
- **PR #517**: feat(pdk): re-pin open_pdks to f6eeac7 and move PDK install/search to ciel
- **Issue #514** (closed): Re-pin open_pdks to f6eeac7 and move PDK install/search to ciel (part of #513)
- **PR #590**: refactor: consolidate evidence-record helpers into layout/klt_env
- **Issue #589** (closed): Dedupe git()/record_id()/klt_version()/sha256() between layout/klt_env.py and design/sar-logic/flow/flow_env.py
- **PR #587**: fix(sim): surface ngspice abort on error corners and retain non-ok decks
- **Issue #585** (closed): sim/harness/batch.py: abort scan is unreachable for klt error corners, and the generated corner deck is not kept as evidence
- **PR #586**: docs(sim): reconcile the bad-loop grid with its raw logs and plan a capped one-point pilot
- **Issue #584** (closed): Diagnose #303 bad-loop aborts from existing evidence and prepare a costed one-point pilot
- **PR #582**: sim(sar-logic-timing-gates-bad): batch-fleet 45-point grid ran, 0 of 45 scored
- **PR #581**: refactor(layout): retire comparator-only klt pex runner with verified recovery recipe
- **Issue #550** (closed): Remove or de-duplicate run_pex_comparator.py: superseded by run_pex_adc_block.py

### 2026-10-17

- **PR #573**: refactor: import sar_ctrl flow constants from flow_env in signoff-pinned drivers
- **Issue #572** (closed): Finish hoisting sar_ctrl constants into flow_env.py for signoff-pinned drivers
- **PR #570**: refactor: hoist shared sar_ctrl flow constants into flow_env.py
- **Issue #569** (closed): Consolidate duplicated sar_ctrl flow constants into flow_env.py
- **PR #568**: docs(signoff): drop hard-coded tampered-input count from prose
- **Issue #567** (closed): signoff: selftest control count in docs drifts from run_signoff.py --selftest
- **PR #566**: signoff: record T1 item 6 not applicable for the digital partition
- **Issue #562** (closed): signoff: record T1 item 6 as not applicable for the digital partition, with every digital row classified
- **PR #565**: feat(signoff): attest T1 items 9 and 10 with klt signoff --attest
- **Issue #561** (closed): signoff: attest T1 items 9 and 10 for both partitions with klt signoff --attest envelopes
- **PR #564**: feat(signoff): attest T1 items 1 and 2 for both partitions, bump grader pin
- **Issue #560** (closed): signoff: attest T1 items 1 and 2 for both partitions with artifact-anchored envelopes
- **PR #563**: signoff: cite sar_ctrl gate-level LVS and ERC supply run for digital items 4 and 11
- **Issue #559** (closed): signoff: cite the routed sar_ctrl gate-level LVS and add its klt erc supply run (T1 items 4 and 11, digital)
- **PR #547**: refactor(sim/tests): share one import-by-path helper across tests
- **Issue #544** (closed): Remove 17 copies of the importlib load-by-path boilerplate in sim/tests: share one helper
- **PR #553**: refactor: share one stair-PWL stimulus helper across extracted-core deck generators
- **Issue #552** (closed): Consolidate copy-pasted stair-PWL stimulus loop across five extracted-core deck generators
- **PR #546**: refactor(layout): share klt JSON+text report runner in klt_env
- **Issue #542** (closed): Dedupe run_case() klt-report runner between run_erc.py and run_power.py into klt_env.py
- **PR #551**: feat(spef-audit): record and regression-test no-net prover on committed sar_ctrl
- **PR #545**: refactor(parasitics): share one ngspice -b runner across extraction scripts
- **Issue #548** (closed): Record and regression-test the no-net prover on the committed sar_ctrl inputs
- **Issue #541** (closed): Dedupe NGSPICE constant and ngspice -b wrapper across parasitics scripts
- **PR #543**: feat(spef-audit): exempt unannotated outputs only with an independent no-net proof
- **PR #539**: refactor(signoff): import klt provenance helpers from klt_env instead of forking them
- **Issue #538** (closed): Dedupe klt_env helpers still forked in signoff/run_signoff.py
- **PR #540**: refactor(flow): share klt JSON runner and STA result classes in flow_env
- **Issue #537** (closed): Consolidate duplicated klt runner and CornerResult in sar_ctrl flow drivers

### 2026-10-16

- **PR #536**: fix(sta): condition SPEF record prose on audit data
- **Issue #533** (closed): sta_postroute_spef record template emits stale/contradictory prose when annotation is complete
- **PR #532**: docs(sta): record third gated SPEF retry, rejected only by repo floating-driver gate
- **PR #530**: docs(sta): record second gated SPEF retry, still rejected on annotation
- **PR #528**: docs: record extracted-SPEF timing retry on fixed klt, still rejected on annotation_complete
- **Issue #376** (closed): README: embed the fleet burndown chart (one line)
- **PR #523**: Bump Repo Skills 0.24.1 -> 0.24.3

### 2026-10-15

- **PR #521**: docs: classify sar_ctrl macro DRC markers via isolated PDK-cell runs
- **PR #519**: fix: add Metal4 VDD/VSS straps to SAR macro PDN and verify with LVS supply control
- **Issue #520** (closed): sar_ctrl macro: 208 klt drc violations (nplus.space.pcomp.1 / pplus.enclosing.comp.1) from PDK endcap/filltie/fill cells
- **Issue #485** (closed): Repair disconnected SAR macro supply rails with a macro-sized PDN
- **PR #510**: signoff: re-take T1 item 7 (block-scoped klt pex) across the committed 117-point grid on the batch fleet
- **PR #508**: Bump Repo Skills 0.19.5 -> 0.24.1
- **Issue #439** (closed): signoff: re-take T1 item 7 (block-scoped klt pex) across the committed 117-point grid once the batch fleet accepts the pinned klt
- **PR #507**: sim(vcm): extracted V_cm pair re-taken on the post-#381 netlist (#392)
- **Issue #392** (closed): sim(vcm): re-take the extracted V_cm pair against the post-#381 re-extraction

### 2026-10-14

- **PR #506**: sim/harness: export the supply axis as one klt request per vdd_val (#505)
- **Issue #505** (closed): sim/harness: batch export keys corners.supply_v by .param, rejected by current klt

### 2026-10-13

- **PR #501**: ci(nightly-pdk): record selftest failures on loom-ui

### 2026-10-10

- **Issue #499** (closed): Check: extracted comparator netlists with bare M model cards bypass the PDK mismatch subckt (zero Monte-Carlo spread)

### 2026-10-09

- **Issue #494** (closed): Guard decision review: keep git clean -fd protected
- **PR #493**: signoff: correct sar_ctrl baseline STA parasitics wording (#484)
- **PR #492**: docs(readme): cap line length at 600 and relocate spec-table narrative
- **Issue #484** (closed): signoff: correct sar_ctrl STA parasitics wording in characterization-summary.digital.json (no RC estimate was applied)
- **Issue #475** (closed): docs: cap README spec-table cell length and machine-check it (longest line is 5,238 chars)
- **PR #490**: docs(sim): #430 batch preflight still blocked by runner version mismatch
- **Issue #480** (closed): Qualify standalone routed SAR macro LVS against its golden circuit
- **PR #488**: sim: fail characterization on incomplete or aborted V_CM sweeps
- **PR #487**: sim(adc-enob-fft): #430 preflight re-check 2 -- batch runner mismatch persists (0/27)
- **PR #483**: feat(sta): extracted-SPEF mode for routed sar_ctrl STA with annotation gate; SPEF rejected, limits retained
- **PR #482**: LVS qualification for standalone sar_ctrl macro: path works, committed GDS is mismatch (VDD split) (#480)
- **PR #479**: sim(adc-offset-mc): #478 screening qualification attempt (refused by fleet runner skew)
- **PR #477**: sim: evidence footprint report + DR-0039 retention proposal (#476)
- **PR #474**: ci: machine-check relative markdown links (#472)
- **Issue #481** (closed): Close routed SAR timing evidence gaps with extracted SPEF and propagated clock
- **Issue #478** (closed): sim(adc-offset-mc): qualify the bidirectional screening null and measured runtime before the population
- **Issue #476** (closed): sim: measure evidence footprint (~440 MB of tracked logs) and draft a retention decision record
- **Issue #472** (closed): ci: machine-check relative markdown links (18 currently broken)
- **Issue #456** (closed): sim: fail characterization on incomplete or aborted V_CM sweeps
- **PR #470**: Issue #429: second fleet probe of acq-leg width sweep (still blocked on PDK include)
- **PR #469**: sim(dr0014-sampling): isolate the #393 gain-error control-arm delta (#459)
- **PR #467**: docs: reconcile SAR routing/STA status and the fixed #266 power-corner warning
- **PR #466**: Issue #430: preflight re-check, both 0.7.0 and 0.6.0 clients blocked (no points run)
- **PR #465**: spec: assess input-pair cascode applicability vs ADC kickback evidence (#443)
- **PR #462**: sim: machine-check characterization-summary evidence citations (#437)
- **PR #463**: Issue #430: preflight re-check, runner version mismatch persists (partial)
- **PR #461**: Issue #430: batch preflight refused by fleet concurrency cap (no points run)
- **PR #458**: Issue #454: campaign-ready offset-MC estimator, per-corner requests, record writer
- **PR #455**: Issue #453: DR-0038 (proposed) offset-error definition
- **PR #452**: Issue #427: qualify batch path for ADC_BLOCK offset Monte Carlo (pilot + campaign protocol)
- **Issue #459** (closed): sim(dr0014-sampling): isolate why the #393 ideal-supply control arm reads 0.001006 LSB vs the governing 0.000981 LSB
- **Issue #457** (closed): docs: reconcile live SAR routing and STA status and the fixed power-corner reproduction warning
- **Issue #443** (closed): Assess input-pair cascode applicability against ADC kickback evidence and budget
- **Issue #437** (closed): sim: machine-check characterization-summary evidence citations against the newest campaign records
- **Issue #454** (closed): sim(adc-offset-mc): build the campaign-ready estimator, per-corner request split and record writer ahead of the screening population
- **Issue #453** (closed): Decide the ADC offset-error definition (spread vs. mean-plus-spread) before the comparator-inclusive population runs
- **Issue #427** (closed): Qualify a faithful batch path for ADC_BLOCK offset Monte Carlo before the full population

- **PR #450**: Issue #438: deterministic decision-record status index
- **PR #448**: Issue #430: record 0.7.0-client batch preflight version mismatch (no points run)
- **Issue #438** (closed): spec: generate and CI-check a deterministic decision-record status index
- **Issue #441** (closed): Auditor guard review: retain git clean -fd protection
- **PR #447**: Issue #429: fleet re-check of x1.0 control still fails on PDK include (blocker evidence)
- **PR #446**: Issue #430: fleet re-opened (preflight passes), cold leg refused for capacity
- **PR #444**: adc-enob-fft: #430 preflight re-check, fleet still blocked (partial increment)

### 2026-10-08

- **PR #440**: Intermediate acquisition-leg widths: layout screened, spectral blocked (#429)
- **PR #436**: adc-enob-fft: #430 temperature-coverage campaign attempt (blocked; partial, 0/27 new points)
- **PR #435**: docs: bring klt pex statements current in the two summaries after #428; re-anchor signoff item 8
- **Issue #432** (closed): docs: characterization-summary and extracted-delta-summary section 9 still describe klt pex as blocked after #428
- **PR #433**: Reconcile klt pins (PyPI 0.6.0 where tested) and run layout runners nightly (#426)
- **PR #431**: signoff: block-scoped klt pex retry for T1 item 7, met on one PVT point (#428)
- **PR #425**: README: relocate over-long State-table cells to docs/, check Layout area (#421)
- **PR #424**: Dedupe resolve_klt()/latest_record() into klt_env.py
- **PR #423**: sim(vcm): extracted V_cm pair re-take blocked on fleet runner klt skew (Part of #392)
- **PR #419**: sim/harness: export run_corners.py grids as klt sim requests for the batch fleet
- **PR #418**: README: signoff-checked Status summary; archive DR-0019-era narrative (#415)
- **PR #417**: CI: enforce the 'sim/ results are append-only' rule mechanically
- **Issue #428** (closed): signoff: retry block-scoped klt pex for T1 item 7 now that klayout-tools#1030 is closed
- **Issue #426** (closed): Reconcile klt pins (docs say 0.4.0/no PyPI; layout and signoff pin different commits) and run the klt layout checks in nightly CI
- **Issue #421** (closed): README: relocate the over-long State-table cells (Schematics/Layout/Verification suite) to docs/ and check the Layout area figure
- **Issue #420** (closed): Dedupe resolve_klt()/latest_record() from run_erc.py and run_power.py into klt_env.py
- **Issue #412** (closed): sim/harness: export run_corners.py grids as klt sim requests so they run on the batch fleet
- **Issue #415** (closed): README: lead Status with a signoff-derived current summary; move the DR-0019-era narrative to docs/
- **Issue #414** (closed): CI: enforce the 'sim/ results are append-only' rule mechanically

### 2026-10-07

- **Issue #409** (closed): Auditor guard review: keep git clean -fd confirmation
- **PR #407**: sim(supply): measure the converter behind a real V_DD drive network at DR-0036's budget
- **Issue #393** (closed): sim(supply): measure the converter behind a real V_DD drive network at DR-0036's budget
- **PR #405**: sim: measure the V_DD switching-event charge and width (#386)
- **Issue #386** (closed): sim/adc-rail-current/ never integrates the CDAC switching event, so DR-0036's charge budget is bounded 4.3x loose

### 2026-09-24

- **PR #402**: signoff: extend the current-record check to the repo-root README.md
- **PR #401**: refactor(layout): dedupe klt_identity() into klt_env.py
- **PR #398**: signoff: check README.md's current-record pointer instead of hand-maintaining it
- **PR #396**: fix(sim): correct the V_cm ammeter polarity and withdraw the sign-flipped p_total figure
- **Issue #400** (closed): Dedupe klt_identity() between layout/erc/run_erc.py and layout/power/run_power.py
- **Issue #399** (closed): signoff: repo-root README.md names the same two-re-grades-stale record, outside #397's new check
- **Issue #397** (closed): signoff: README.md's "Current verdict" block names a record two re-grades stale
- **Issue #395** (closed): sim(vcm): the #358 power pair's ammeter flipped i(vcms)'s sign between its arms -- p_total in the vcmnet arm is understated by 2x|p_vcm|
- **Issue #382** (closed): layout(adc-top): contacts fail the PDK runset's CO.1 exact-size rule and MOSFETs fail DF.6/PL.4/PL.5, and the PDK runset has no committed runner

### 2026-09-23

- **PR #394**: docs(sim): reconcile the characterization summary's Supply row with DR-0036's proposed V_DD decoupling budget
- **PR #391**: sim(vcm): re-run the ratified decks against a real V_cm network at full PVT (#358)
- **PR #390**: extract(parasitics): re-extract against the tapped Metal2-strapped GDS, retire the body-tie rewrite, and re-run all five post-layout campaigns
- **PR #388**: layout,power: carry ADC_BLOCK's block-level supply straps on Metal2, making the droop verdict landing-site independent
- **PR #387**: spec(DR-0036): budget the V_DD switching transient as charge, and require an on-die term inside ADC_BLOCK
- **PR #385**: sim/harness: reserve record-id atomically to stop same-second collisions
- **PR #384**: layout(adc-top): draw and route 25 n-well taps, close and strap both substrate-tie rings
- **PR #380**: power: measure ADC_BLOCK's Poly2-stitched supply rails for IR drop and EM, and budget the droop (#346)
- **Issue #389** (closed): docs(sim): reconcile characterization-summary's Supply row with DR-0036's post-#387 ratified budget
- **Issue #383** (closed): sim(parasitics): re-extract and re-run the five extracted campaigns against #356's tapped geometry
- **Issue #381** (closed): layout(adc-top): re-extract parasitics and re-run the post-layout campaigns against the tapped GDS (post-#356)
- **Issue #379** (closed): No V_DD decoupling budget exists, and the measured CDAC switching peak is 860x the average supply current
- **Issue #378** (closed): ADC_BLOCK's supply droop verdict depends on where the parent lands the supply: carry the rails above Metal1, or ratify the landing-site constraint
- **Issue #377** (closed): sim/harness: concurrent run_corners.py runs of one experiment in the same second collide on record id
- **Issue #358** (closed): Re-run the three ADC-level decks against a real V_cm network at full PVT (DR-0026's named follow-up)
- **Issue #356** (closed): layout(adc-top): no n-well tap is drawn in any of ADC_BLOCK's 25 wells, and both substrate-tie rings reach no supply
- **Issue #346** (closed): No supply geometry above Metal1: both rails are stitched block-to-block through Poly2 risers, and no IR/EM read exists

### 2026-09-22

- **PR #375**: docs: re-point stale SAR-sequencer record citations (#357)
- **PR #374**: docs(sar-logic): replace the tie grid's "not yet attributable" 512 claim with #337's measured decode transient
- **PR #373**: chore(reuse): add reuse.lock.json recording the in-tree comparator as undecided against sibling gf180-comparator
- **PR #372**: sim: locate the delay-line decks' step-control collapse at the line's termination node
- **PR #371**: sim(sar-logic): gate the code-error measurement on a settled drdy and start it after the discarded first conversion
- **Issue #366** (closed): 2am: reuse rule 9 — in-tree comparator (preamp + StrongARM latch) duplicates sibling canary gf180-comparator — add reuse.lock.json in_tree entry (evaluate), then adopt or record
- **Issue #357** (closed): Stale SAR-sequencer record citations in testbench-suite-memo, timing-budget-memo and the Chipalooza proposal
- **Issue #343** (closed): sar-logic-timing-gates-{lt,xl,bad}: every point that reaches a verdict aborts with Timestep too small at 15-32% of the ratified transient, and the ideal lossless transmission line is the only structural difference from the deck that passes
- **Issue #327** (closed): Correct the gate-level code-error measurement: start after the discarded first conversion, and strobe after the output register settles (DR-0029 part 2)

### 2026-09-21

- **PR #369**: test: enforce spec/decision-records DR-NNNN one-number-one-record rule
- **PR #368**: signoff: teach run_signoff.py item 11's compound evidence list, then cite the klt erc report
- **PR #367**: refactor(sar-logic): one provenance implementation for the flow drivers (#352)
- **PR #365**: docs(erc): correct the Metal1 disjoint-polygon count for vdd/vss (3 -> 4) (#349)
- **PR #364**: spec(DR-0033): price sf_27c_2.97v's non-convergence as attributed coverage rather than change the tie loop
- **PR #362**: sim/harness: never score a mid-transient abort as a completed point (#341)
- **PR #361**: signoff: cite T1 item 8 on both partitions via generic evidence envelopes (#339)
- **PR #360**: fix(layout,signoff): bump klt to close T1 item 4's unpinned LVS citation
- **PR #359**: feat(erc): settle ADC_BLOCK's well-tie question from geometry (DR-0032)
- **PR #355**: sim(sar-logic-timing-gates-tie): root-cause tie_code_deviation=512 to the output register read mid-carry
- **PR #354**: spec: renumber the power-up first-conversion record DR-0029 -> DR-0031 (#335)
- **PR #351**: sim(sar-logic-functional{,-gates}): add iso_skew_ns cross-loop asymmetry check
- **PR #350**: sim(sar-logic-timing-gates-tie): root-cause the sf_27c_2.97v abort to a hard sign test at the floating-point ulp on a quiescent supply row
- **PR #348**: feat(erc): stand up klt erc and record ADC_BLOCK's structural supply read
- **PR #344**: sim(sar-logic-timing-gates-{lt,xl}): both 45-point grids ran, and neither completed a single ratified transient (#303)
- **PR #342**: feat(signoff): commit a klt signoff block manifest so this block's T1 state is graded, not hand-read
- **Issue #353** (closed): spec/decision-records/: nothing enforces the README's one-number-one-record rule, so a DR-NNNN collision can only be caught by hand
- **Issue #352** (closed): Dedupe _run/_git/_git_status_porcelain/klt_version/record_id between synth_sar_ctrl.py and pnr_sar_ctrl.py
- **Issue #349** (closed): layout/erc/README.md: the "three disjoint polygons" Metal1 count for vdd does not reproduce (measures 4)
- **Issue #347** (closed): signoff: teach run_signoff.py item 11's compound evidence list, then cite the klt erc report
- **Issue #345** (closed): DR-0029's supersede trigger is met: write the successor record for the tie loop's near-metastable model
- **Issue #341** (closed): sim/harness: a point whose transient aborts mid-run is scored as a completed PASS when the manifest has one measurement
- **Issue #340** (closed): adc_block.gds draws no implant or tap geometry, so klt erc's erc.missing_tie is uncomputable (T1 item 11 residual gap)
- **Issue #339** (closed): T1 item 8: wrap sim/characterization-summary.md in a klt generic evidence envelope so the row is graded
- **Issue #338** (closed): T1 item 4's signoff citation cannot carry a content_hash: the committed LVS report predates klayout-tools#1969
- **Issue #337** (closed): sar-logic-timing-gates-tie: tie_code_deviation=512 (code lands on 0/1024) at 6/29 scored PVT corners — not confirmed as DR-0029 chatter
- **Issue #335** (closed): spec/decision-records/: two records both numbered DR-0029, which the directory's own README forbids and nothing enforces
- **Issue #334** (closed): sim/sar-logic-functional{,-gates}: no check sees a small cross-loop isolation-gap asymmetry now that both loops carry DR-0028's wide margin bounds
- **Issue #332** (closed): sar-logic-timing-gates-tie: sf_27c_2.97v aborts with Timestep too small (new, post-#296)
- **Issue #331** (closed): Commit a klt signoff block manifest so this block's T1 state is graded, not hand-read
- **Issue #330** (closed): T1 item 11 (power delivery, structural): no klt erc supply spec or report in this repo

### 2026-09-20

- **PR #336**: spec(DR-0030): bind the acquisition/isolation limits to the DUT's rung, not the deck (#324)
- **PR #333**: sim(sar-logic-timing-gates-tie): run the ratified 45-point mos grid; lt/xl/bad launched, in flight (#303)
- **Issue #324** (closed): sim/sar-logic-functional{,-gates}/ still carry the pre-DR-0028 acq_window_ns / iso_gap_ns bounds, and now hold the coarse deck tighter than the tight one

### 2026-09-19

- **PR #329**: sar-logic-timing-gates-ok: root-cause abs_err_delay_0ns to an unreset first conversion plus a mid-update decode transient, and record DR-0029 (#320)
- **PR #326**: spec(DR-0029): settle the tie loop's decision chatter as a recorded model property (#322)
- **PR #325**: spec(DR-0028): derive the gate-level acq_window_ns / iso_gap_ns bounds from the margin each protects (#319)
- **PR #323**: sar-logic-timing-gates: the second Timestep too small abort is a five-loop composition artifact, not a comparator defect (#310)
- **PR #321**: feat(sim): decompose the gate-level timing deck into per-loop decks and run the first scored 45-point grid (#311)
- **Issue #322** (closed): tie loop's hard comparator decision chatters on the exact-tie input (found under #310; needs a spec decision, not a testbench edit)
- **Issue #320** (closed): Gate-level sar_ctrl converts incorrectly at 10 of 45 PVT points with zero added delay (up to 512 LSB, concentrated at 125 C and slow-logic corners)
- **Issue #319** (closed): acq_window_ns / iso_gap_ns bounds on the gate-level timing deck were inherited from an idealised model and the real netlist does not meet them
- **Issue #311** (closed): Decompose sim/sar-logic-timing-gates into per-loop decks: its five-loop composition, not the host, is why the 45-point grid has never run
- **Issue #310** (closed): sar-logic-timing-gates: second Timestep too small non-convergence past 200 ns, node vvdd_gate#branch, distinct from #296's fixed defect

### 2026-09-18

- **PR #318**: test(sim): pin the gate-netlist byte check and add a version-independent drift guard
- **PR #317**: fix(sar-logic): derive klt synthesize artifact paths instead of reading them back (#314)
- **PR #315**: docs(sim): measure save-vectors/threads neutrality on a full-length gate-level deck
- **PR #313**: docs(sim): measure KLU vs SPARSE 1.3 on the gate-level decks; not adopted
- **PR #312**: docs(sim): measure that sar-logic-timing-gates' five-loop composition, not the host, is why its grid has never run (#303)
- **Issue #316** (closed): sim/tests: gate-netlist drift test has an undocumented hard pin on Yosys 0.69+post, and its failure text tells you to overwrite the goldens
- **Issue #314** (closed): sim/tests: gate-netlist drift test fails before it compares anything — klt synthesize returns a dict where synth_sar_ctrl.py expects a path
- **Issue #309** (closed): Settle whether --save-measured-vectors and --ngspice-threads are measurement-neutral on gate-level decks (they change the accepted-timestep sequence)
- **Issue #308** (closed): Evaluate ngspice's KLU solver for the gate-level decks: it is compiled in and unused, and per-point cost is what blocks the sar-logic-timing-gates grid

### 2026-09-17

- **PR #307**: docs(sim): measure the sar-logic-timing-gates grid cost wall and correct the retention-knob claims (#303)
- **PR #306**: docs(sim): correct stale 'no corner-grid run recorded' notes in gate-level tb.json
- **PR #304**: fix(sar-logic): slew the gate-level comparator output so ngspice can step over the decision (#296)
- **Issue #305** (closed): sim/sar-logic-functional-gates tb.json note claims no corner-grid run exists, and every record inherits it
- **Issue #296** (closed): ngspice non-convergence ('Timestep too small') in gate-level SAR replay, distinct from #282's fixed vdd_gate bug

### 2026-09-16

- **PR #302**: docs(DR-0027): fix garbled lead-in sentence mixing units
- **PR #300**: fix: accept bounded gate-decode one-hot hazard via decision record (DR-0027)
- **PR #299**: docs: root-cause the gate-level sw_conflict one-hot violation
- **Issue #301** (closed): docs(DR-0027): fix garbled lead-in sentence mixing ns-per-day / ps-per-conversion units
- **Issue #298** (closed): fix: real gate-delay hazard in sar_ctrl_a switch decode (rel_n races sel_in_n)
- **Issue #295** (closed): Gate-level SAR switch-decode one-hot invariant violated on every corner tested (sw_conflict_se/df, DR-0014)

### 2026-09-15

- **PR #297**: feat(sar-logic): execute and record the gate-level SPICE replay corner grid (#289)
- **PR #294**: fix(loom): break SIGPIPE/pipefail false-MISS in verify-proposal-refs.sh
- **PR #293**: fix(ci): stop pruning libs.ref from cached gf180mcu PDK in nightly-pdk.yml
- **PR #290**: fix(sar-logic): declare vdd_gate .global in translated gate netlists (#282)
- **PR #288**: fix: isolate gate-netlist drift test from committed synth output
- **PR #286**: layout(adc-top): refresh the stale "Area, as drawn" table against live area.json
- **PR #285**: refactor: remove unused label() function from geometry.py
- **PR #283**: Scaffold gate-level SAR-sequencer SPICE replay testbenches (#273)
- **PR #279**: DR-0023 follow-on (b): place-and-route the SAR sequencer gate netlist
- **PR #278**: feat: pre-route STA evidence for sar_ctrl_a vs DR-0003's 62.5 ns budget
- **Issue #292** (closed): verify-proposal-refs.sh false-flags real files as MISSING via SIGPIPE/pipefail bug
- **Issue #291** (closed): Nightly PDK check failed (sim/selftest.sh stages 2-4)
- **Issue #289** (closed): Execute and record the sar-logic gate-level SPICE replay corner-grid now that #282 unblocks it
- **Issue #287** (closed): check:ci's gate-netlist drift test mutates the working tree (yosys version drift, unrelated file changes land as a side effect)
- **Issue #284** (closed): Remove unused geometry.label() Metal1 helper
- **Issue #282** (closed): Gate-level SPICE replay of the SAR sequencer does not reach a valid digital operating point (blocks #273's corner-grid run)
- **Issue #280** (closed): layout/adc-top/README.md's 'Area, as drawn' table is stale against area.json
- **Issue #277** (closed): Complete the mos-corner-grid temperature/supply axes for sim/sar-logic-timing-gates/ (issue #273 follow-on)
- **Issue #275** (closed): DR-0023 follow-on (c): STA closure for the SAR sequencer gate netlist (klt sta)
- **Issue #274** (closed): DR-0023 follow-on (b): place-and-route the SAR sequencer gate netlist (klt place-and-route)
- **Issue #273** (closed): Gate-level functional/timing corner-grid replay for the SAR sequencer (issue #272 continuation)
- **Issue #272** (closed): Synthesize the SAR sequencer to a gf180mcu gate-level netlist (DR-0023 follow-on (a): RTL + `klt synthesize`, rung-1 replay as equivalence evidence)
