2AMLogic/gf180-sar-adc/docs/status-history-2026-10-08-state-table.md

# Status history: the over-long README State-table cells

This file holds the `Schematics`, `Layout` and `Verification suite` cells of
the root `README.md` `| Area | State |` table exactly as they stood when they
were relocated on **2026-10-08** (issue #421), each verbatim and unedited. It
is a **relocated snapshot, not a current claim**: the text was accumulated
issue by issue, partly predates the DR-0019 resize and the #381 re-extraction,
and its figures (for example the `Layout` cell's 0.15054 mm^2, now 0.151827
mm^2 per `layout/adc-top/area.json`) have been superseded. The checker
`sim/tools/check_readme_status.py` scans the retained README only, never this
file. For the current state read the root [`README.md`](../README.md) Status
section, [`signoff/README.md`](../signoff/README.md) and
[`sim/characterization-summary.md`](../sim/characterization-summary.md).

## Schematics

Sub-blocks captured (CDAC array, comparator, track switch) and assembled into a transistor-level analog-core netlist — `design/adc-top/`; SAR control logic at DR-0010's rung-1 ideal-logic abstraction remains the executable specification, and (DR-0023, issue #272) a hand-authored RTL implementation now exists and is synthesized to a gate-level netlist against both PDK-shipped standard-cell libraries (`gf180mcu_fd_sc_mcu7t5v0` chosen, `mcu9t5v0` also committed), proven register-correspondence equivalent to the RTL via `klt equiv` — `design/sar-logic/rtl/README.md`. Gate-level functional/timing re-verification over the full PVT corner grid (#273), place-and-route (#274), and STA closure (#275) are follow-on work, not yet done — `design/sar-logic/README.md`

## Layout

Block layout drawn, DRC-clean, LVS-matched: 323-device `adc_block` at 0.15054 mm² (`layout/adc-top/area.json`, cross-checked by `klt economy` at utilization 0.4146 — `layout/adc-top/economy/records/20260817-185745-40cfeb8.md`). That is after issue #215's two-step recovery — a load-resistor fold plus a re-derivation of both top-level strap corridors — took 29,910 µm² (−16.57 %) off the 0.18045 mm² the DR-0019 unit-cap resize built. Over the ratified `< 0.1 mm²` budget (151 %) once the CDAC MiM stack is drawn at its legal geometry (#70) and the ratified `C_u` at DR-0019's resized plate: recovery to `< 0.1 mm²` is infeasible at the ratified unit-cap geometry, so a target revision was proposed for operator ratification (`spec/decision-records/DR-0017-adc-top-area-budget-overrun.md`, itself predating DR-0019 and now itself superseded by a current reconciliation). That reconciliation, using the current as-built 0.150536 mm² figure rather than DR-0017's stale one, is [DR-0024](../spec/decision-records/DR-0024-adc-top-area-budget-reconciliation.md) (`< 0.16 mm²`, proposed, issue #198, pending operator ratification-via-PR) — `layout/adc-top/README.md`

## Verification suite

**At the DR-0019-resized `C_u` the design is built at (#196/#202): the schematic-level 9-corner ADC suite now has TWO failing rows, not one** — ENOB 8.5064 bits worst (`ss_125c_2.97v`), below the `> 9.0` target at 2 of 9 points, and SFDR 56.41 dB worst, missing `≥ 62 dB` by 5.59 dB; power passes at 207.9 µW (2.4× stretch margin), bit settling passes 117/117, `Gain error, systematic` improves to 0.0021–0.0039 LSB and the array-path `R_on` is bit-identical. Consolidated before/after: `spec/testbench-suite-memo.md` §11.9; regression tracked in #211. INL/DNL's re-take is **done** (#203/PR #214: worst \|INL\| 0.1036 → 0.1100 LSB, worst \|DNL\| 0.1036 → 0.0938 LSB, 63/63 PASS), and so are the two input-path decks PR #202 could not reach because they model the array as one lumped capacitor: the drive contract *improves* to +0.082…+0.370 LSB (117/117 PASS) while the switch's own track-mode SFDR contribution loses 4.96–5.77 dB everywhere and drops below the ratified 62 dB at 11 of 117 points (§11.9.11/§11.9.12). **Everything that follows in this cell describes the pre-resize design at `C_u = 17.24 fF` and is retained as the record of it, not as a current claim.** Schematic-level, 9-corner ADC suite at that `C_u`: INL/DNL and ENOB pass; SFDR misses the ≥ 62 dB target by 0.67 dB at one corner of nine — `spec/testbench-suite-memo.md` §11.2. Post-layout extracted re-run **done** (#17/#89): every #13 spec-line bench — static linearity (27-point `mos` grid plus a 63-point `cdac` capacitor-corner-set isolation), ENOB/FFT/SFDR (9-point grid), power (27-point grid), and the DR-0012/13 systematic gain-error row — re-run against the parasitic-extracted CDAC core, plus the #14 Monte Carlo question answered for both halves (MOS local mismatch measured, σ = 2.0e-3 LSB at the worst carry with a null control; CDAC capacitor mismatch absent from the PDK on either netlist). Every row that passed schematic-level still passes extracted. The three spec-line decks were then re-run again (#123) on the **in-path** extraction the `875eac3` toolchain pin ratifies — the earlier capture used a superseded topology whose parasitic resistance carried no device current — and independently replicated by a second concurrent campaign, agreeing to ≥ 4 significant figures on all 5904 static and dynamic result cells (the 675 FFT-capture cells bit-identically) and on 26 of 27 power corners: INL 0.148 LSB, DNL 0.098 LSB, ENOB 9.31 bits, power 185–221 µW at 4.5–5.4× margin, all PASS — §4.10/§4.11. On that basis no corner of the 9-point grid falls below the SFDR row (worst 64.38 dB, at `ff_125c_3.63v`). The schematic baseline still misses it at `ss_125c_2.97v` (61.33 dB) — confirmed **not stale** by a fresh re-run against current sources (#151) — but the extracted grid's own worst corner relocates away from `ss_125c_2.97v` (which measures 64.93 dB extracted, independently replicated twice), a real, corner-dependent effect of the in-path CDAC parasitics on the acquisition's own sampling-bow nonlinearity rather than a testbench artifact: #151 rules out both baseline staleness and a schematic/extracted deck-comparability gap directly (`spec/testbench-suite-memo.md` §11.2). SFDR's escalation was reconciled on that basis: the extracted, independently-replicated result governed the row for the design *as then laid out*, and it passed. **That reconciliation does not survive the DR-0019 resize.** The extracted grid above was taken on the pre-resize layout; #218 re-extracted the #202 layout and re-ran all five extracted campaigns against it, and the row's first valid post-resize governing result is a **FAIL at 60.40 dB worst** (`ff_125c_3.63v`, 4 of 9 corners short of `≥ 62 dB`), alongside a schematic side that fails by 5.59 dB — so the extracted result no longer rescues the row, it confirms the miss (`sim/extracted-delta-summary.md` §4.12.2). Two findings are carried open rather than absorbed: the 2× comparator-current excursion at one power corner (#107), which the two campaigns show does not reproduce run-to-run and is therefore a marginal-decision artefact rather than a corner or layout property (§4.11.1), and a comparator-inclusive (`ADC_BLOCK`) extraction, on which the comparator-offset claim (the ratified `Offset ≤ 2 LSB` 3σ-mismatch Monte Carlo population) still depends — `ADC_BLOCK` itself converts (issue #118) and a comparator-inclusive regeneration-margin campaign against it has run, but the statistical offset population has not. **Rate (1 MS/s) closure is no longer one of the open items**: as of issue #116 (2026-08-14) all three of its post-layout inputs are measured and the row is PASS — `sim/extracted-delta-summary.md` §6.3/§6.4, `sim/issue-17-acceptance-review.md`. A separate, non-layout finding surfaced by issue #172's `klt yield` evidence: at the historical `C_u = 17.24 fF` this design no longer draws, the Gain error, mismatch row measured **2.12σ against its ratified 3σ condition** (0.708 LSB at 3σ vs the ≤ 0.5 LSB target) — a sizing gap in README note **[e]**'s ceiling assumption, not a layout effect (`sim/mc-cdac-mismatch/records/20260816-044942-56fbe50.md`, **superseded**, `spec/testbench-suite-memo.md` §12 item 8c); issue #177 records and verifies the resizing decision that closes it ([DR-0019](../spec/decision-records/DR-0019-cdac-unit-cap-resize-for-gain-error-margin.md), `sigma_to_spec = 3.13`), and the physical implementation landed in #196/PR #202. The transistor-level PVT re-verification tracked separately as #197 — **all eight** of its schematic campaigns are now done (§11.9; the census grew from six when the scope sentence turned up two input-path decks that model the array as a lumped capacitor and so were never regenerated), and the post-layout half is done too (#218, §11.9.8) — covers the *other* `C_u`-dependent rows, not this one: the `Gain error, mismatch` row's own evidence is the standalone Monte Carlo mismatch model, evaluated at nominal PVT rather than corner-swept, which #177 already re-ran at the resized `sigma_u` (`sim/mc-cdac-mismatch/records/20260816-125421-737d16e.md`). With the resize now physically built, that re-run is governing and the row above quotes it: **3.13σ, `klt yield` status `pass`**. What #197 measured is the *cost* of the resize on the other rows, and it is not free. **See [`sim/characterization-summary.md`](../sim/characterization-summary.md) for the single, dated, per-spec-row characterization status this paragraph summarizes.** All of the above is this repo's own hand-built extracted-core re-simulation methodology; `klayout-tools`' own single-command schematic-vs-extracted tool for this (`klt pex`, epic #709) was tried directly once it shipped (#173) and found blocked for every block this repo extracts — its DUT-swap mechanism requires the schematic and extracted netlists to share one identical top-level pin interface, which `klt extract`'s promoted body/tap/internal nets never do here — filed generically as [`klayout-tools#1030`](https://github.com/2AMLogic/klayout-tools/issues/1030); evidence in `sim/comparator-pex/`, `sim/extracted-delta-summary.md` §9. **The ENOB/SFDR regression's one measured candidate fix (#211's acquisition-leg widening) has since been evaluated end to end (#238/#249) and is NOT adopted** — [DR-0025](../spec/decision-records/DR-0025-acquisition-leg-widening-not-adopted.md): items 1/2/4 of five deferred measurements cost little, but item 5's `klt`-verified re-layout grows `adc_block` area +17.00 %, past both the ratified and the still-proposed Area targets; the clean-tree re-take of the governing ENOB/SFDR campaign at the unchanged, ratified design reproduces the same 8.857 bits / 60.40 dB worst-corner FAIL exactly ([`20260825-061750-d00911a`](../sim/adc-enob-fft/records/20260825-061750-d00911a.md))
