2AMLogic/gf180-sar-adc/sim/adc-enob-fft/investigations/20261009-issue-430-0.7.0-client-mismatch-recurs.md

# Issue #430 -- preflight on a 0.7.0-client worker: version mismatch recurs (2026-10-09)

- **Date**: 2026-10-09 (UTC), 03:48-03:49
- **Base commit**: `6ec639d6` (main), clean worktree
- **Status**: **STILL PARTIAL -- ZERO of the 27 declared points have a banked record.** Follow-on to the three earlier 2026-10-08/09 notes (not edited). This is an investigation note, not a `records/` entry: no number below is a result. Coverage statement unchanged (hot, 125 C only); `README.md`, `spec/`, hardware and targets untouched.

## 1. The one preflight (not retried)

`python3 sim/run_corners.py adc-enob-fft --netlist sim/adc-enob-fft/testbench/tb_adc_enob_fft_extracted.spice --netlist-provenance 'extracted (as records/20261007-072654-800bf53.md)' --corners tt --temps 27 125 --supply-tol 0 --backend batch --no-write --timeout 3600`

Host client `klt 0.7.0+g4cbdfa769875`, `KLT_SIM_BACKEND=batch`.

| Item | Result |
|---|---|
| Fleet job | `klt-sim-81f4b2af5092` |
| Outcome | both points `error`, 0 passed; client status `ERROR`; wall time 55 s |
| Error, verbatim (both points) | `batch_job_failed: batch job klt-sim-81f4b2af5092 finished 'failed' (job command exited 87): the job's klt reported: the fleet runner runs klt 0.5.0 but the submitting client is 0.7.0+g4cbdfa769875 -- the request was not run (update the runner image or use a compatible client)` |

## 2. Reading

The 01:26 UTC pass in `20261009-issue-430-fleet-reopened-no-capacity.md` used a `0.6.0` client (job `klt-sim-6f2cb7260edf`). This worker's installed client is `0.7.0`, which the `0.5.0` runner still refuses. The host-wide tool must not be changed from here (worker spec), and a throwaway `uvx --from klayout-tools==0.6.0` client was not tried because the task protocol allows exactly one preflight and a 9/27-point request would also hit the capacity refusal recorded earlier. The runner image is therefore still the gate; which client a worker has decides pass/fail.

## 3. Declared vs completed

| Leg | Declared | Banked as a record |
|---|---|---|
| -40 C (tt/ss/ff x 3 supplies) | 9 | 0 (not submitted; preflight failed) |
| 27 C | 9 | 0 (not submitted) |
| 125 C | 9 | 0 new; the 9 points in `records/20261007-072654-800bf53.md` remain the hot control |
| Total | 27 | 0 new / 9 historical hot |

No local fallback was run.

## 4. To finish #430

Either the runner image is updated to a klt matching the worker client, or the campaign is dispatched from a worker whose client passes the version gate (0.6.0 passed on 2026-10-09 01:26) at a time with fleet capacity. Then the full 27-point request from a clean tree, `compose_enob_by_corner.py` on the new corner dir, and reconcile the 125 C points against `records/20261007-072654-800bf53.md`, as in section 5 of `20261009-issue-430-fleet-reopened-no-capacity.md`.
