2AMLogic/gf180-sar-adc/sim/adc-offset-mc/testbench/tb_adc_offset_screen.spice

* tb_adc_offset_screen -- GENERATED by gen_pilot.py, do not edit.
* Comparator-inclusive ADC_BLOCK input-offset measurement, issue #454 (screening, up+down staircase).
* One transient = one mismatch draw = 82 back-to-back DR-0014 conversions of a
* differential-input staircase (-6.0 mV start, 0.50 mV step; ascending then descending, section 6.6). See sim/adc-offset-mc/README.md.
*
* Mismatch switch: sw_stat_mismatch=1 (ON: per-instance MOS mismatch). sw_stat_global=0 in both, so the
* population is mismatch-only (no global process spread).
.include "../../adc-block-pex/netlist-snapshots/20261008-185501-c618a90d.spice"

.param sw_stat_global=0 sw_stat_mismatch=1 mc_skew=3 res_mc_skew=3
+ cap_mc_skew=3 fnoicor=0

Vdd   vdd  0 dc 3.3
Vref  vref 0 dc 3.3
Vcm   vcm  0 dc 1.65
* parasitic caps in the extracted deck reference the global substrate net `vsubs`;
* tied to ground (the bodies are already tied inside the extracted netlist, DR-0035).
Vsubs vsubs 0 dc 0
Ibias vdd  ibias dc 10u

* inputs are stacked on the vcm node, so V_cm (and the +/-d/2 about it) follow the
* per-corner supply_v override of Vcm; the differential stimulus is supply-independent.
Vinp  pinp vcm pwl(0.0000n -0.003 192.0000n -0.003 192.2000n -0.00275 392.0000n -0.00275 392.2000n
+ -0.0025 592.0000n -0.0025 592.2000n -0.00225 792.0000n -0.00225 792.2000n -0.002 992.0000n -0.002
+ 992.2000n -0.00175 1192.0000n -0.00175 1192.2000n -0.0015 1392.0000n -0.0015 1392.2000n -0.00125
+ 1592.0000n -0.00125 1592.2000n -0.001 1792.0000n -0.001 1792.2000n -0.00075 1992.0000n -0.00075
+ 1992.2000n -0.0005 2192.0000n -0.0005 2192.2000n -0.00025 2392.0000n -0.00025 2392.2000n 0
+ 2592.0000n 0 2592.2000n 0.00025 2792.0000n 0.00025 2792.2000n 0.0005 2992.0000n 0.0005 2992.2000n
+ 0.00075 3192.0000n 0.00075 3192.2000n 0.001 3392.0000n 0.001 3392.2000n 0.00125 3592.0000n 0.00125
+ 3592.2000n 0.0015 3792.0000n 0.0015 3792.2000n 0.00175 3992.0000n 0.00175 3992.2000n 0.002
+ 4192.0000n 0.002 4192.2000n 0.00225 4392.0000n 0.00225 4392.2000n 0.0025 4592.0000n 0.0025
+ 4592.2000n 0.00275 4792.0000n 0.00275 4792.2000n 0.003 4992.0000n 0.003 4992.2000n 0.00325
+ 5192.0000n 0.00325 5192.2000n 0.0035 5392.0000n 0.0035 5392.2000n 0.00375 5592.0000n 0.00375
+ 5592.2000n 0.004 5792.0000n 0.004 5792.2000n 0.00425 5992.0000n 0.00425 5992.2000n 0.0045
+ 6192.0000n 0.0045 6192.2000n 0.00475 6392.0000n 0.00475 6392.2000n 0.005 6592.0000n 0.005
+ 6592.2000n 0.00525 6792.0000n 0.00525 6792.2000n 0.0055 6992.0000n 0.0055 6992.2000n 0.00575
+ 7192.0000n 0.00575 7192.2000n 0.006 7392.0000n 0.006 7392.2000n 0.00625 7592.0000n 0.00625
+ 7592.2000n 0.0065 7792.0000n 0.0065 7792.2000n 0.00675 7992.0000n 0.00675 7992.2000n 0.007
+ 8192.0000n 0.007 8192.2000n 0.007 8392.0000n 0.007 8392.2000n 0.00675 8592.0000n 0.00675
+ 8592.2000n 0.0065 8792.0000n 0.0065 8792.2000n 0.00625 8992.0000n 0.00625 8992.2000n 0.006
+ 9192.0000n 0.006 9192.2000n 0.00575 9392.0000n 0.00575 9392.2000n 0.0055 9592.0000n 0.0055
+ 9592.2000n 0.00525 9792.0000n 0.00525 9792.2000n 0.005 9992.0000n 0.005 9992.2000n 0.00475
+ 10192.0000n 0.00475 10192.2000n 0.0045 10392.0000n 0.0045 10392.2000n 0.00425 10592.0000n 0.00425
+ 10592.2000n 0.004 10792.0000n 0.004 10792.2000n 0.00375 10992.0000n 0.00375 10992.2000n 0.0035
+ 11192.0000n 0.0035 11192.2000n 0.00325 11392.0000n 0.00325 11392.2000n 0.003 11592.0000n 0.003
+ 11592.2000n 0.00275 11792.0000n 0.00275 11792.2000n 0.0025 11992.0000n 0.0025 11992.2000n 0.00225
+ 12192.0000n 0.00225 12192.2000n 0.002 12392.0000n 0.002 12392.2000n 0.00175 12592.0000n 0.00175
+ 12592.2000n 0.0015 12792.0000n 0.0015 12792.2000n 0.00125 12992.0000n 0.00125 12992.2000n 0.001
+ 13192.0000n 0.001 13192.2000n 0.00075 13392.0000n 0.00075 13392.2000n 0.0005 13592.0000n 0.0005
+ 13592.2000n 0.00025 13792.0000n 0.00025 13792.2000n 0 13992.0000n 0 13992.2000n -0.00025
+ 14192.0000n -0.00025 14192.2000n -0.0005 14392.0000n -0.0005 14392.2000n -0.00075 14592.0000n
+ -0.00075 14592.2000n -0.001 14792.0000n -0.001 14792.2000n -0.00125 14992.0000n -0.00125
+ 14992.2000n -0.0015 15192.0000n -0.0015 15192.2000n -0.00175 15392.0000n -0.00175 15392.2000n
+ -0.002 15592.0000n -0.002 15592.2000n -0.00225 15792.0000n -0.00225 15792.2000n -0.0025
+ 15992.0000n -0.0025 15992.2000n -0.00275 16192.0000n -0.00275 16192.2000n -0.003)
Vinn  pinn vcm pwl(0.0000n 0.003 192.0000n 0.003 192.2000n 0.00275 392.0000n 0.00275 392.2000n
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
+ 0 0 0 0 0 0 0 0 0 0 0 0 0 0 0 0 0 0
+ ibias
+ 0 0 0 0 0 0 0 0 0 0 0 0 0 0 0 0 0 0
+ pinn pinp
+ relall relall relall relall relall relall relall relall relall
+ relall relall relall relall relall relall relall relall relall
+ sel_in topn topp tp_gn vcm vdd vref 0
+ ADC_BLOCK
