2AMLogic/gf180-sar-adc/sim/adc-inl-dnl/testbench/tb_adc_inl_dnl_extracted.spice

* ==================================================================
* tb_adc_inl_dnl_extracted -- static linearity of the extracted,
* PMOS-body-remediated, MiM-mapped ADC_TOP core over the PVT grid
* (issue #89 Scope item 1). GENERATED by
* layout/adc-top/parasitics/gen_extracted_inl_dnl_tb.py -- do not edit.
*
* Reuses sim/adc-inl-dnl/testbench/tb.json UNMODIFIED (via
* `run_corners.py --netlist ... --netlist-provenance extracted`): the
* input ladder and the ideal-shadow-DAC error/code nodes are byte-for-
* byte ports of design/adc-top/gen_adc_top.py's inl_netlist()/_core(),
* tagged `se_*` to match that manifest's measure/check expressions
* exactly. The ONLY thing that differs from the schematic deck is the
* analog core itself: one extracted ADC_TOP instance (both CDAC array
* sides + the per-side top-plate V_cm switch, PMOS-body-remediated to
* vdd, MiM-mapped to the native PDK subckt) in place of two
* adc_cdac_side instances + two adc_tp_sw instances. Comparator and
* rung-1 controller stay schematic-level (issue #89 Scope item 0).
* See gen_extracted_inl_dnl_tb.py's module docstring for the full
* rationale.
* ==================================================================

* ---- retained waveforms --------------------------------------------
* ngspice keeps a transient waveform for EVERY node unless told which
* ones matter. The in-path extraction splits every net into one leg
* node per device terminal, so the full store overruns what ngspice
* will allocate and the point dies before measuring anything. These
* are exactly the vectors this deck's manifest reads, derived from it
* rather than hand-listed. Retention only: no model, tolerance or
* timestep changes, and the measurements are bit-identical with and
* without this line. See gen_extracted_core_tb.saved_vectors_lines.
.save v(se_aerrh) v(se_code) v(se_err) v(vrefn)

* ---- ratiometric rails --------------------------------------------
* V_REF = V_DD. README.md note [c] makes V_REF <= V_DD a hard
* condition of the ratified spec, so a fixed 3.3 V reference is not
* legal at the 2.97 V corner; taking V_REF = V_DD keeps the deck legal
* at every point of the supply axis, and every figure below is in LSB
* of whatever full scale that point has.
.param vref={vdd_val}
.param vcm={vdd_val/2}
.param vth={vdd_val/2}
.param lsb={vdd_val/1024}


* ---- clocks --------------------------------------------------------
* DR-0003: one external clock pin at 16 x f_s. The comparator strobe
* is the same clock shifted half a bit cycle, so the CDAC settles in
* the first 31.25 ns and the comparator decides in the second -- the
* split spec/prior-art-survey.md Sec 1.4 allocates and
* sim/comparator-regeneration/ measured 863 ps of worst-case decision
* delay against.
vclk clk 0 pulse(0 {vdd_val} 0 100p 100p 31.25n 62.5n)
vcmpclk cmpclk 0 pulse(0 {vdd_val} 31.25n 100p 100p 31.25n 62.5n)
vcmpclkb cmpclkb 0 pulse({vdd_val} 0 31.25n 100p 100p 31.25n 62.5n)

* ---- supplies, split per block so power is attributable -----------
vddt vddt 0 dc {vdd_val}
vddd vddd 0 dc {vdd_val}
vddc vddc 0 dc {vdd_val}

* ---- reference network, DR-0002 -----------------------------------
* DR-0002 specifies an EXTERNAL V_REF pin with an effective source
* impedance <= 240 ohm IN THE SWITCHING BAND and >= 40 nF of external
* decoupling. Both halves of that sentence are modelled: the inductor
* in parallel with the 240 ohm makes the network 240 ohm at the
* switching band and DC-accurate below it, which is what an external
* reference buffer behind a decoupling capacitor actually is. A bare
* 240 ohm series resistor would instead assert a DC offset DR-0002
* never specified -- and, with 40 nF, a 9.6 us settling tail that
* would dominate any run shorter than ~50 us.
vrefs vrefs 0 dc {vref}
rref vrefs vrefn 240
lref vrefs vrefn 2.3873u
cref vrefn 0 40n
* V_cm generation is explicitly unbudgeted work (DR-0011
* Consequences: 'a new, currently-unbudgeted deliverable for a future
* issue'), so there is no ratified envelope to model it against and it
* is an IDEAL source here. That is a stated assumption of every record
* this deck produces, not a measured result -- see the known-
* limitations section of spec/testbench-suite-memo.md.
vcms vcmn 0 dc {vcm}

* ---- input: piecewise-constant ladder of probed transitions -------
* Identical to gen_adc_top.inl_netlist() -- same INL_TRANSITIONS,
* same schedule, same tag.
vsevinp se_vinp 0 pwl(
+ 0 {(1+0.25)*lsb} 2990.0n {(1+0.25)*lsb} 3000.0n {(2+0.25)*lsb} 3990.0n {(2+0.25)*lsb} 4000.0n {(128+0.25)*lsb} 4990.0n {(128+0.25)*lsb} 5000.0n {(129+0.25)*lsb} 5990.0n {(129+0.25)*lsb} 6000.0n {(255+0.25)*lsb} 6990.0n {(255+0.25)*lsb} 7000.0n {(256+0.25)*lsb} 7990.0n {(256+0.25)*lsb} 8000.0n {(257+0.25)*lsb} 8990.0n {(257+0.25)*lsb} 9000.0n {(384+0.25)*lsb} 9990.0n {(384+0.25)*lsb} 10000.0n {(511+0.25)*lsb} 10990.0n {(511+0.25)*lsb} 11000.0n {(512+0.25)*lsb} 11990.0n {(512+0.25)*lsb} 12000.0n {(513+0.25)*lsb} 12990.0n {(513+0.25)*lsb} 13000.0n {(640+0.25)*lsb} 13990.0n {(640+0.25)*lsb} 14000.0n {(767+0.25)*lsb} 14990.0n {(767+0.25)*lsb} 15000.0n {(768+0.25)*lsb} 15990.0n {(768+0.25)*lsb} 16000.0n {(769+0.25)*lsb} 16990.0n {(769+0.25)*lsb} 17000.0n {(896+0.25)*lsb} 17990.0n {(896+0.25)*lsb} 18000.0n {(1022+0.25)*lsb} 18990.0n {(1022+0.25)*lsb} 19000.0n {(1023+0.25)*lsb} 20000.0n {(1023+0.25)*lsb})
vsevinn se_vinn 0 dc {vcm}

* ---- library: comparator + SAR controller + extracted core -------
* --- COMPARATOR-NETLIST-BEGIN (verbatim-copied into every testbench) ---
.subckt preamp vinp vinn ibias pop pon vdd vss
* 1:1 NMOS current mirror; ibias is forced into the diode branch.
Xmb  ibias ibias vss vss nfet_03v3 w=20u l=2u
Xmt  ptail ibias vss vss nfet_03v3 w=20u l=2u
* Input pair. The device whose gate is vinp drives the INVERTING node
* pon, so v(pop) - v(pon) = +A_v * (v(vinp) - v(vinn)).
Xmip pon vinp ptail vss nfet_03v3 w=40u l=1u
Xmin pop vinn ptail vss nfet_03v3 w=40u l=1u
* Unsalicided 1 kohm/sq p+ poly loads, 150 squares = 150 kohm nominal.
* Third terminal is the substrate/body contact. `ppolyf_u_1k`, not the
* 2 kohm/sq `ppolyf_u_2k` an earlier revision assumed: issue #118 drew
* SAB(49/0)+RES_MK(110/5)+Resistor(62/0) markers over the load-resistor
* bodies so `klt extract`'s gf180mcu deck recognises them as real devices
* instead of a Poly2 short, and at this repo's pinned klt commit that
* marker geometry can only select `ppolyf_u_1k` (1000 ohm/sq) -- the
* `_2k`/`_3k` flavours share the identical drawn geometry and are chosen by
* a build-time deck option this curated deck does not implement
* (`2AMLogic/klayout-tools#595`, open). `r_length` is doubled (75u -> 150u)
* at the same `r_width=1u` to preserve the 150 kohm target at the new
* sheet-rho -- see layout/adc-top/README.md "Resistors".
Xrlp vdd pop vss ppolyf_u_1k r_width=1u r_length=150u
Xrln vdd pon vss ppolyf_u_1k r_width=1u r_length=150u
.ends preamp

.subckt sarlatch inp inn clk outp outn vdd vss
* clk low  -> tail off; outp/outn/dip/din precharged to vdd
* clk high -> tail on; the input pair discharges dip/din at rates set by
*             v(inp)/v(inn), then the cross-coupled pairs regenerate.
Xmlt ltail clk   vss   vss nfet_03v3 w=16u l=0.35u
Xmlp dip   inp   ltail vss nfet_03v3 w=8u  l=0.5u
Xmln din   inn   ltail vss nfet_03v3 w=8u  l=0.5u
Xmnp outn  outp  dip   vss nfet_03v3 w=6u  l=0.35u
Xmnn outp  outn  din   vss nfet_03v3 w=6u  l=0.35u
Xmpp outn  outp  vdd   vdd pfet_03v3 w=8u  l=0.35u
Xmpn outp  outn  vdd   vdd pfet_03v3 w=8u  l=0.35u
Xmrp outn  clk   vdd   vdd pfet_03v3 w=4u  l=0.35u
Xmrn outp  clk   vdd   vdd pfet_03v3 w=4u  l=0.35u
Xmrd dip   clk   vdd   vdd pfet_03v3 w=2u  l=0.35u
Xmre din   clk   vdd   vdd pfet_03v3 w=2u  l=0.35u
.ends sarlatch

* Minimum-ish isolation inverter. Deliberately small: it is the only
* thing the regeneration nodes drive, so its gate capacitance is added
* directly to the latch's own output nodes and shows up as regeneration
* time.
.subckt inv a y vdd vss
Xp y a vdd vdd pfet_03v3 w=2u   l=0.35u
Xn y a vss vss nfet_03v3 w=1u   l=0.35u
.ends inv

.subckt nor2 a b y vdd vss
Xp1 ps a vdd vdd pfet_03v3 w=8u l=0.35u
Xp2 y  b ps  vdd pfet_03v3 w=8u l=0.35u
Xn1 y  a vss vss nfet_03v3 w=4u l=0.35u
Xn2 y  b vss vss nfet_03v3 w=4u l=0.35u
.ends nor2

.subckt comparator vinp vinn clk ibias dout doutb vdd vss
Xpre preamp_in1 preamp_in2 ibias pop pon vdd vss preamp
Xlat pop pon clk outp outn vdd vss sarlatch
* THE ISOLATION INVERTERS ARE NOT OPTIONAL -- they fix a measured
* hysteresis defect. Both StrongARM outputs precharge HIGH, so the
* decision arrives as an active-low pulse on exactly one of them, and
* the obvious way to hold it is a NAND SR latch wired straight to
* outp/outn. That circuit was built first and MEASURED: after deciding
* one way it would not flip back until the input reached ~10 mV of the
* opposite polarity -- about 3 LSB of hysteresis, which in a SAR (where
* the same comparator makes ten successive decisions on a shrinking
* residue) is a code-dependent error, not an offset.
*
* The cause is that a NAND SR latch's HELD STATE loads the two
* regeneration nodes asymmetrically. Wired directly, the node driving
* the NAND whose output is LOW sees that output swing when it falls
* (Miller-multiplied C_gd, ~26 fF against a regeneration node of a few
* tens of fF), while its twin drives a NAND whose output is already
* HIGH and stays there. The latch is therefore biased toward keeping
* the answer it already holds.
*
* Interposing one small inverter per side removes the coupling: the
* inverters are identical, both of their inputs precharge to V_DD, and
* neither loading depends on what the SR latch is holding. The SR latch
* becomes NOR-type because the inverters make the decision pulses
* active-HIGH. dout goes HIGH when outn falls, i.e. when
* v(vinp) > v(vinn), exactly as before.
Xis outn sset vdd vss inv
Xir outp srst vdd vss inv
Xno1 srst doutb dout  vdd vss nor2
Xno2 sset dout  doutb vdd vss nor2
* Input pass-through (zero-volt sources) so a testbench can probe the
* current the comparator draws from each CDAC top plate directly.
Vpp preamp_in1 vinp dc 0
Vpn preamp_in2 vinn dc 0
.ends comparator
* --- COMPARATOR-NETLIST-END ---
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
