2AMLogic/gf180-sar-adc/sim/device-switch-ron/testbench/tb_switch_ron_extracted.spice

* ==================================================================
* tb_switch_ron_extracted -- the switch-R_on testbench with its
* transmission-gate branch wired against the EXTRACTED, PMOS-body-
* remediated `adc_tgate` leaf cell (sim/extracted-delta-summary.md
* SS6.3's Input-structure R_on re-take). GENERATED by
* layout/adc-top/parasitics/gen_extracted_switch_ron_tb.py -- do not
* edit.
*
* Runs sim/device-switch-ron/testbench/tb.json UNMODIFIED, via
* `run_corners.py device-switch-ron --netlist <this file>`. Everything
* above the transmission-gate section below -- the supply, the seven
* supply-tracking input points, and the whole NMOS-only and PMOS-only
* branches -- is copied VERBATIM from tb_switch_ron.spice, so ron_n_*
* and ron_p_* are a built-in control (they must come back bit-
* identical) and ron_t_* is the only measurement that can move.
* ==================================================================
* tb_switch_ron -- sampling-switch on-resistance vs input voltage
*
* Netlist FRAGMENT. The harness supplies the models, the corner .lib
* sections, .temp, the .control block and .end. Parameters provided by the
* harness: vdd_val, vdd_nom, temp_c.
*
* Question this answers (feeds #10, switch topology): how flat is R_on across
* the input range for an NMOS-only, a PMOS-only and a transmission-gate
* sampling switch, and which PVT corner is worst?
*
* Method. Each branch holds the switch source at a fixed input voltage and
* forces V_ds = 10 mV across the channel -- deep triode, small enough that
* R_on = 10 mV / |I| is the small-signal channel resistance rather than a
* large-signal average. One 10 mV source per branch means its current IS the
* channel current, with no divider or probe to correct for.
*
* WHY THE INPUT POINTS TRACK THE SUPPLY. The input is swept as a fraction of
* vdd_val, not as a fixed 0-3.3 V ladder. At the low-supply corner (2.97 V) a
* 3.3 V input would sit 330 mV above the rail: the PMOS source-body junction
* forward-biases and the "R_on" measured there is a forward-biased diode, not
* a switch. Sweeping f * vdd_val characterises each supply corner across its
* own rail-to-rail range, which is the physically meaningful comparison.
* (That a 0-3.3 V input range is NOT samplable at a drooped 2.97 V supply is
* itself a finding for #1/#10; see the characterization report.)
*
* Body connections are the single-well reality: NMOS body to ground, PMOS
* body to vdd. R_on therefore carries the body effect, which is most of the
* reason the NMOS degrades toward the top of the range.
*
* Device sizing. W is a free variable for #10 -- R_on scales as 1/W to first
* order -- so this testbench pins one geometry and reports the resistance for
* it: NMOS W = 10 um, PMOS W = 20 um (2:1 for the mobility ratio), both at
* L = 0.28 um (the 3.3 V minimum). The transmission gate is exactly those two
* devices in parallel. Scale by 10 um / W_actual to re-use these numbers.

vsup vdd 0 dc {vdd_val}

* ---- input ladder: 7 points from rail to rail ----------------------------
vin_f00  nf00  0 dc 0
vin_f17  nf17  0 dc {vdd_val/6}
vin_f33  nf33  0 dc {vdd_val/3}
vin_f50  nf50  0 dc {vdd_val/2}
vin_f67  nf67  0 dc {2*vdd_val/3}
vin_f83  nf83  0 dc {5*vdd_val/6}
vin_f100 nf100 0 dc {vdd_val}
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
