2AMLogic/gf180-sar-adc/(list of files, drawings)

Other design files:
layout/adc-top/parasitics/reports/20260805-224500-2c21be4/schematic-ff_125c_3.63v.json
layout/adc-top/parasitics/reports/20260805-224500-2c21be4/schematic-ss_-40c_2.97v.json
layout/adc-top/parasitics/reports/20260805-224500-2c21be4/schematic-tt_27c_2.97v.json
