2AMLogic/gf180-sar-adc/layout/adc-top/sar_ctrl/sar_ctrl.v

module sar_ctrl_a (c0,
    c1,
    c2,
    c3,
    c4,
    c5,
    c6,
    c7,
    c8,
    c9,
    clk,
    cmp,
    mode,
    drdy,
    rel_n_128n,
    rel_n_128p,
    rel_n_16n,
    rel_n_16p,
    rel_n_1n,
    rel_n_1p,
    rel_n_256n,
    rel_n_256p,
    rel_n_2n,
    rel_n_2p,
    rel_n_32n,
    rel_n_32p,
    rel_n_4n,
    rel_n_4p,
    rel_n_64n,
    rel_n_64p,
    rel_n_8n,
    rel_n_8p,
    samp_tp_n,
    sel_hi_n_128n,
    sel_hi_n_128p,
    sel_hi_n_16n,
    sel_hi_n_16p,
    sel_hi_n_1n,
    sel_hi_n_1p,
    sel_hi_n_256n,
    sel_hi_n_256p,
    sel_hi_n_2n,
    sel_hi_n_2p,
    sel_hi_n_32n,
    sel_hi_n_32p,
    sel_hi_n_4n,
    sel_hi_n_4p,
    sel_hi_n_64n,
    sel_hi_n_64p,
    sel_hi_n_8n,
    sel_hi_n_8p,
    sel_in_n,
    sel_lo_n_128n,
    sel_lo_n_128p,
    sel_lo_n_16n,
    sel_lo_n_16p,
    sel_lo_n_1n,
    sel_lo_n_1p,
    sel_lo_n_256n,
    sel_lo_n_256p,
    sel_lo_n_2n,
    sel_lo_n_2p,
    sel_lo_n_32n,
    sel_lo_n_32p,
    sel_lo_n_4n,
    sel_lo_n_4p,
    sel_lo_n_64n,
    sel_lo_n_64p,
    sel_lo_n_8n,
    sel_lo_n_8p,
    start);
 output c0;
 output c1;
 output c2;
 output c3;
 output c4;
 output c5;
 output c6;
 output c7;
 output c8;
 output c9;
 input clk;
 input cmp;
 input mode;
 output drdy;
 output rel_n_128n;
 output rel_n_128p;
 output rel_n_16n;
 output rel_n_16p;
 output rel_n_1n;
 output rel_n_1p;
 output rel_n_256n;
 output rel_n_256p;
 output rel_n_2n;
 output rel_n_2p;
 output rel_n_32n;
 output rel_n_32p;
 output rel_n_4n;
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
    .CLK(clknet_2_0__leaf_clk),
    .Q(ph[11]));
 gf180mcu_fd_sc_mcu7t5v0__dffq_1 _242_ (.D(_009_[12]),
    .CLK(clknet_2_1__leaf_clk),
    .Q(ph[12]));
 gf180mcu_fd_sc_mcu7t5v0__dffq_1 _243_ (.D(_009_[13]),
    .CLK(clknet_2_1__leaf_clk),
    .Q(ph[13]));
 gf180mcu_fd_sc_mcu7t5v0__dffq_1 _244_ (.D(_009_[14]),
    .CLK(clknet_2_1__leaf_clk),
    .Q(ph[14]));
 gf180mcu_fd_sc_mcu7t5v0__dffq_1 _245_ (.D(_009_[15]),
    .CLK(clknet_2_3__leaf_clk),
    .Q(ph[15]));
 gf180mcu_fd_sc_mcu7t5v0__buf_4 clkbuf_0_clk (.I(clk),
    .Z(clknet_0_clk));
 gf180mcu_fd_sc_mcu7t5v0__buf_4 clkbuf_2_0__f_clk (.I(clknet_0_clk),
    .Z(clknet_2_0__leaf_clk));
 gf180mcu_fd_sc_mcu7t5v0__buf_4 clkbuf_2_1__f_clk (.I(clknet_0_clk),
    .Z(clknet_2_1__leaf_clk));
 gf180mcu_fd_sc_mcu7t5v0__buf_4 clkbuf_2_2__f_clk (.I(clknet_0_clk),
    .Z(clknet_2_2__leaf_clk));
 gf180mcu_fd_sc_mcu7t5v0__buf_4 clkbuf_2_3__f_clk (.I(clknet_0_clk),
    .Z(clknet_2_3__leaf_clk));
 gf180mcu_fd_sc_mcu7t5v0__buf_4 clkload0 (.I(clknet_2_0__leaf_clk));
 gf180mcu_fd_sc_mcu7t5v0__inv_3 clkload1 (.I(clknet_2_2__leaf_clk));
 assign c0 = c0_r;
 assign c1 = c1_r;
 assign c2 = c2_r;
 assign c3 = c3_r;
 assign c4 = c4_r;
 assign c5 = c5_r;
 assign c6 = c6_r;
 assign c7 = c7_r;
 assign c8 = c8_r;
 assign c9 = c9_r;
 assign drdy = ph[15];
endmodule
