2AMLogic/gf180-sar-adc/design/adc-top/gen_adc_top.py

#!/usr/bin/env python3
"""Generate the top-level SAR ADC netlist and issue #13's testbench suite.

Single source of truth for the committed artifacts listed in ``TARGETS``:

  design/adc-top/adc_top.spice                        the analog-core library
  sim/adc-inl-dnl/testbench/tb_adc_inl_dnl.spice      static linearity
  sim/adc-inl-dnl/testbench/tb.json
  sim/adc-enob-fft/testbench/tb_adc_enob_fft.spice    dynamic performance
  sim/adc-enob-fft/testbench/tb.json
  sim/adc-power/testbench/tb_adc_power.spice          power breakdown
  sim/adc-power/testbench/tb.json

``sim/harness/testbench.py`` rejects ``.include`` inside a testbench fragment
(the harness owns the includes so one fragment can sweep the whole PVT grid
unedited), so a testbench cannot pull the DUT in by reference -- it has to
carry it inline.  That is the same constraint
``design/sar-logic/gen_sar_logic.py`` already lives under, and the same answer
is used here: the copies are generated, and
``sim/tests/test_adc_top_netlist.py`` fails CI if a committed file stops
matching this generator.

Every deck this file writes is composed from three inlined sources, none of
which is retyped here:

  1. ``design/comparator/comparator.spice``  -- copied verbatim between its own
     BEGIN/END markers, so ``sim/tests/test_comparator_netlist.py`` guards it.
  2. ``design/sar-logic/gen_sar_logic.py``   -- imported and called, so the
     rung-1 controller is the same text ``sim/sar-logic-functional/`` verifies.
  3. ``library()`` below                     -- the CDAC array, its switches and
     their local drivers, which exist nowhere else yet.

Usage:
    python3 design/adc-top/gen_adc_top.py            # write the files
    python3 design/adc-top/gen_adc_top.py --check    # exit 1 if stale
    python3 design/adc-top/gen_adc_top.py --stdout library

Architecture implemented here is fixed by ratified decision records and by
already-closed evidence records; this file implements them, it does not choose
them:

  DR-0002  V_REF external, <= 240 ohm in the switching band, >= 40 nF decap
  DR-0003  external clock, M = 16 -> 16 phases per conversion, 1 MS/s
  DR-0004  3.3 V devices throughout
  DR-0007  comparator: static preamp + StrongARM latch (design/comparator/)
  DR-0007  track switch: dummy-compensated T-gate (bootstrap rejected)
  DR-0009  plain binary weighting, no redundancy
  DR-0010  fidelity ladder -- rung 1 for the sequencer, transistor level for
           everything in the analog signal path
  DR-0011  MCS / Vcm switching, free MSB, 9 switched weights (256..1) per
           side, terminating unit fixed to V_cm -- superseded by DR-0014 on
           the sampling phase only, every other decision re-ratified
  DR-0014  BOTTOM-PLATE sampling: a fourth leg to V_in per cell, one
           top-plate switch to V_cm per side which opens FIRST, and the
           dedicated top-plate sampling switch removed
  DR-0013  input drive network: series source R and a pin capacitor sized so
           R_source * (C_pin + C_in) <= 30 ns. The dummy/main width ratio of
           7/16 belonged to the dedicated sampling switch DR-0014 removes;
           the drive contract stands, the dummy ratio no longer applies
  spec/cdac-sizing-memo.md Sec 4 / DR-0019   C_u = 35.6528 fF (4.0 um square),
           MiM 2.0 fF/um^2 flavour; supersedes the original 17.24 fF
  sim/device-characterization-report.md Sec 1.2  MiM density law used to turn
           a target capacitance into a drawn square side
"""

from __future__ import annotations

import argparse
import importlib.util
import json
import math
import sys
from pathlib import Path

REPO = Path(__file__).resolve().parents[2]

# --- the two netlists this generator inlines rather than retypes ------------
_GEN_SAR = REPO / "design" / "sar-logic" / "gen_sar_logic.py"
_spec = importlib.util.spec_from_file_location("gen_sar_logic", _GEN_SAR)
sar = importlib.util.module_from_spec(_spec)
sys.modules["gen_sar_logic"] = sar
_spec.loader.exec_module(sar)

_COMPARATOR = REPO / "design" / "comparator" / "comparator.spice"
_CMP_BEGIN = "* --- COMPARATOR-NETLIST-BEGIN"
_CMP_END = "* --- COMPARATOR-NETLIST-END ---"

ADC_BEGIN = "* --- ADC-TOP-NETLIST-BEGIN (verbatim-copied into every testbench) ---"
ADC_END = "* --- ADC-TOP-NETLIST-END ---"


def comparator_block() -> str:
    """The canonical comparator netlist, verbatim, markers included."""
    lines = _COMPARATOR.read_text().splitlines(keepends=True)
    b = [i for i, ln in enumerate(lines) if ln.startswith(_CMP_BEGIN)]
    e = [i for i, ln in enumerate(lines) if ln.startswith(_CMP_END)]
    assert len(b) == 1 and len(e) == 1 and b[0] < e[0], _COMPARATOR
    return "".join(lines[b[0] : e[0] + 1])


# ---------------------------------------------------------------------------
# Sizing constants -- every one of these is consumed from a ratified record,
# not chosen here.
# ---------------------------------------------------------------------------

#: spec/cdac-sizing-memo.md Sec 4 -- the chosen unit capacitance. DR-0019
#: (issue #177) resized it from 17.24 fF (2.7136 um square) to close the
#: ratified "Gain error, mismatch" row's 2.12-sigma gap: 4.0 um square at the
#: measured 2.0 fF/um^2 MiM density law below, i.e. 1.99*4^2 + 0.9532*4.
C_UNIT_FF = 35.6528

#: sim/device-characterization-report.md Sec 1.2 -- measured MiM 2.0 fF/um^2
#: density law for a square of side s um:  C(s) = A*s^2 + B*s  fF.
MIM_A = 1.99
MIM_B = 0.9532

#: DR-0011 -- 2^(N-1) unit positions per side: 511 switched + 1 terminating.
WEIGHTS = [2 ** (9 - i) for i in range(1, 10)]  # 256 .. 1
N_UNIT_PER_SIDE = 512

#: sim/device-switch-ron/ + sim/cdac-bit-settling/ -- the CDAC bottom-plate
#: T-gate geometry every existing settling record was taken at.
CDAC_SW_WN = "10u"
CDAC_SW_WP = "20u"

#: DR-0013 / sim/track-switch-sampling/ "cxopt" branch -- the dedicated
#: top-plate sampling switch and the drive network its gain-error number was
#: measured at. DR-0014 REMOVES that switch from the converter: the input now
#: reaches the array through the nine cell T-gates of each side's fourth leg.
#: The geometry is kept here because sim/top-plate-cpar/ still instantiates it
#: -- that deck measures the load set of the SUPERSEDED topology, which is the
#: evidence DR-0014's Context rests on, and #61 owns re-taking it on the new
#: topology. TRACK_RS_OHM / TRACK_CPIN are unchanged and still in the
#: converter: DR-0014 leaves DR-0013's drive contract standing.
TRACK_SW_WN = "40u"
TRACK_SW_WP = "80u"
TRACK_SW_RD = 0.4375  # dummy/main width ratio, 7/16
TRACK_RS_OHM = 25
TRACK_CPIN = "1n"

#: DR-0002 -- reference envelope.
VREF_Z_OHM = 240
VREF_CDEC = "40n"

#: DR-0003 -- M = 16 at 1 MS/s.
CLK_PERIOD_NS = sar.CLK_PERIOD_NS  # 62.5
CONV_NS = sar.CONV_NS  # 1000
#: The comparator strobe rises in the middle of the bit cycle: the CDAC gets
#: the first half of the cycle to settle, the comparator the second half --
#: the 31.25 ns / 31.25 ns split spec/prior-art-survey.md Sec 1.4 allocates and
#: sim/comparator-regeneration/ measured its 863 ps worst-case delay against.
CMP_STROBE_NS = CLK_PERIOD_NS / 2

#: Phase index of trial i (i = 1..10):  ph(3+i).  Trial 1 is DR-0011's free
#: MSB (no array switching), trials 2..10 engage weights 256..1.
def trial_decision_ns(trial: int) -> float:
    """Time from the start of a conversion to trial `trial`'s strobe edge."""
    return (3 + trial) * CLK_PERIOD_NS + CMP_STROBE_NS


def mim_side_um(c_ff: float) -> float:
    """Drawn square side that realises `c_ff` under the measured density law."""
    return (-MIM_B + math.sqrt(MIM_B**2 + 4 * MIM_A * c_ff)) / (2 * MIM_A)


def _fmt(x: float, nd: int = 4) -> str:
    return f"{x:.{nd}f}"


# ---------------------------------------------------------------------------
# library: the analog core's own subckts
# ---------------------------------------------------------------------------


def library() -> str:
    """`design/adc-top/adc_top.spice` -- the reusable analog-core subckts."""
    L: list[str] = []
    a = L.append
    a("* ==================================================================")
    a("* adc_top.spice -- the SAR ADC analog core: CDAC array, its four-leg")
    a("* bottom-plate switch network and the local drivers, and the")
    a("* top-plate V_cm switch DR-0014's sampling phase turns on.")
    a("*")
    a("* GENERATED by design/adc-top/gen_adc_top.py -- do not edit.")
    a("*")
    a("* This library holds ONLY what is not already owned by another")
    a("* canonical file. The comparator lives in design/comparator/")
    a("* comparator.spice and the SAR controller in design/sar-logic/")
    a("* sar_ctrl.spice; the testbenches under sim/adc-*/ inline all three.")
    a("*")
    a("* Fidelity (DR-0010): everything here is transistor level. The")
    a("* sequencer and the output register stay at rung 1 (ideal XSPICE")
    a("* primitives) because the open gf180mcu PDK ships no 3.3 V standard-")
    a("* cell library -- the gap DR-0010 names as an open precondition of")
    a("* rung 3. The T-gate DRIVERS are transistor level even so: they are")
    a("* custom cells placed with the CDAC (design/sar-logic/README.md), not")
    a("* standard cells, so the library gap does not apply to them, and they")
    a("* are the dominant digital load in a SAR ADC.")
    a("* ==================================================================")
    a("")
    a(ADC_BEGIN)
    a("* ---- switches ----------------------------------------------------")
    a("* CDAC bottom-plate T-gate. Same geometry as sim/device-switch-ron/")
    a("* and sim/cdac-bit-settling/, so R_on carries the corner sensitivity")
    a("* those records already characterised.")
    a(".subckt adc_tgate vin vout gn gp vdd wn=10u wp=20u")
    a("XN vin gn vout 0   nfet_03v3 w='wn' l=0.28u")
    a("XP vin gp vout vdd pfet_03v3 w='wp' l=0.28u")
    a(".ends adc_tgate")
    a("")
    a("* Dedicated top-plate input sampling switch: dummy-compensated T-gate,")
    a("* DR-0007 (track switch) / DR-0013. NO LONGER IN THE CONVERTER --")
    a("* DR-0014 samples on the bottom plates, so the input reaches the array")
    a("* through the nine cell T-gates of each side's fourth leg and this")
    a("* switch is gone from adc_cdac_side and from every adc-* deck. It is")
    a("* kept in the library because sim/top-plate-cpar/ instantiates it to")
    a("* measure the SUPERSEDED topology's top-plate load set -- the measured")
    a("* evidence DR-0014's Context rests on -- and because #61 re-takes that")
    a("* measurement on the new topology from this same library. Identical")
    a("* device text to the `tgate_dum` subckt sim/track-switch-sampling/")
    a("* measured the ratified gain-error number with, at the same default")
    a("* rd = 7/16.")
    a(".subckt adc_tgate_dum vin vout clk clkb vdd wn=40u wp=80u rd=0.4375")
    a("XN  vin  clk  vout 0   nfet_03v3 w='wn' l=0.28u")
    a("XP  vin  clkb vout vdd pfet_03v3 w='wp' l=0.28u")
    a("XDN vout clkb vout 0   nfet_03v3 w='wn*rd' l=0.28u")
    a("XDP vout clk  vout vdd pfet_03v3 w='wp*rd' l=0.28u")
    a(".ends adc_tgate_dum")
    a("")
    a("* Local T-gate driver -- one per leg, placed with the CDAC cell. This")
    a("* is design/sar-logic/sar_ctrl.spice's `sar_tgate_drv` promoted from")
    a("* its rung-1 ideal inverter to real devices: the controller routes")
    a("* only the active-high (NMOS gate) half of each leg, and the")
    a("* complementary PMOS gate is made here.")
    a(".subckt adc_drv a y vdd vss")
    a("Xp y a vdd vdd pfet_03v3 w=8u l=0.35u")
    a("Xn y a vss vss nfet_03v3 w=4u l=0.35u")
    a(".ends adc_drv")
    a("")
    a("* ---- top-plate V_cm switch (DR-0014) ------------------------------")
    a("* One per array side. Closed for ph0..ph2 and OPENED ON THE EDGE INTO")
    a("* ph3 -- that edge is the sampling instant, and it is the reason the")
    a("* whole record exists: with the top plate released before the bottom")
    a("* plates move, the sampled input and every subsequent DAC step land in")
    a("* the same numerator over the same denominator, so C_arr/(C_arr+C_par)")
    a("* cancels from the comparator's decision instead of dividing the DAC")
    a("* step alone.")
    a("*")
    a("* Plain T-gate at the CDAC bottom-plate geometry -- deliberately NOT")
    a("* dummy-compensated, and this is a choice, not an omission. DR-0013's")
    a("* dummies exist because the OLD sampling switch opened with an")
    a("* input-dependent voltage on its channel. This switch always opens")
    a("* with its node at V_cm, so its injection is signal-independent: a")
    a("* fixed offset, common to both sides, which differential operation")
    a("* removes and which DR-0007's Offset row already covers. Adding")
    a("* dummies would instead re-hang two permanently-connected MOS")
    a("* capacitors on the top plate -- the 194 fF sim/top-plate-cpar/")
    a("* measured as 66 % of C_par -- which no longer costs gain under this")
    a("* record but does cost bit-trial settling. The residual side-to-side")
    a("* MISMATCH of this injection is one of the four things DR-0014's")
    a("* Consequences require #61 to measure; it is not claimed here.")
    a("*")
    a("* Sizing, from the acquisition it has to support: it holds the top")
    a("* node at V_cm while the bottom plates slew, so its own time constant")
    a("* is R_on * (C_arr + C_par) = 570 ohm * 9.1 pF = 5.2 ns worst case,")
    a("* i.e. 36 tau inside the 187.5 ns acquisition window and 0.21 of the")
    a("* input network's own 25 ns tau. The lag it leaves at the sampling")
    a("* instant is (tau_sw/tau_in)*exp(-7.5) = 1.1e-4 of the input step --")
    a("* 0.12 LSB at full scale, and LINEAR in the input, so it is a gain")
    a("* term and not a linearity term. Widening it would buy that back at")
    a("* the price of more injection to mismatch, which is the term this")
    a("* topology cannot cancel.")
    a(".subckt adc_tp_sw top vcm gn vdd vss")
    a("Xd gn gp vdd vss adc_drv")
    a(f"Xs vcm top gn gp vdd adc_tgate wn={CDAC_SW_WN} wp={CDAC_SW_WP}")
    a(".ends adc_tp_sw")
    a("")
    a("* ---- one CDAC cell ------------------------------------------------")
    a("* A weight-w block of unit capacitors and its FOUR-way bottom-plate")
    a("* switch: driven to V_in while sampling (DR-0014's fourth leg),")
    a("* released to V_cm, or engaged to V_REF or GND (DR-0011, unchanged).")
    a("* Exactly one leg conducts at a time -- the four-leg one-hot invariant")
    a("* sim/sar-logic-functional/ checks on the control side.")
    a("*")
    a("* The fourth leg is the same T-gate as the other three. That is what")
    a("* makes the cell one repeated device rather than four different ones,")
    a("* and it is why the Input-structure row's series R_on has to be")
    a("* re-measured rather than carried over (DR-0014, and #61 owns it): the")
    a("* input now reaches the array through nine of these in parallel,")
    a("* instead of through one dedicated 40u/80u switch.")
    a(".subckt adc_cdac_cell top vin vref vcm vss vdd gn_in gn_rel gn_hi gn_lo")
    a("+ cw=10u cl=10u")
    a("Xc  top bp mim_cap_2f0 c_width='cw' c_length='cl'")
    a("Xdi gn_in  gp_in  vdd vss adc_drv")
    a("Xdr gn_rel gp_rel vdd vss adc_drv")
    a("Xdh gn_hi  gp_hi  vdd vss adc_drv")
    a("Xdl gn_lo  gp_lo  vdd vss adc_drv")
    a(f"Xsi vin  bp gn_in  gp_in  vdd adc_tgate wn={CDAC_SW_WN} wp={CDAC_SW_WP}")
    a(f"Xsr vcm  bp gn_rel gp_rel vdd adc_tgate wn={CDAC_SW_WN} wp={CDAC_SW_WP}")
    a(f"Xsh vref bp gn_hi  gp_hi  vdd adc_tgate wn={CDAC_SW_WN} wp={CDAC_SW_WP}")
    a(f"Xsl vss  bp gn_lo  gp_lo  vdd adc_tgate wn={CDAC_SW_WN} wp={CDAC_SW_WP}")
    a(".ends adc_cdac_cell")
    a("")
    a("* ---- one array side -----------------------------------------------")
    a("* DR-0011: 2^(N-1) = 512 unit positions per side -- nine binary")
    a("* weighted blocks (256..1, 511 units) plus one terminating unit fixed")
    a(f"* to V_cm. C_u = {C_UNIT_FF} fF (spec/cdac-sizing-memo.md Sec 4), so the")
    a("* per-side track-mode capacitance is 512 * C_u = "
      f"{N_UNIT_PER_SIDE * C_UNIT_FF / 1000:.3f} pF, which is")
    a("* the C_in the ratified Input-structure row publishes.")
    a("*")
    a("* Each block is drawn as ONE capacitor of the block's total area, not")
    a("* as w separate unit cells. That is exact for this campaign and it is")
    a("* deliberate: these records verify the NOMINAL design over PVT, where")
    a("* unit-to-unit mismatch is zero by construction, and the statistical")
    a("* spread of the same array is sim/mc-cdac-mismatch/'s claim, taken at")
    a("* nominal PVT with a behavioural model because the open PDK ships no")
    a("* local capacitor mismatch model at all. Drawing 1022 unit cells here")
    a("* would multiply simulation cost by ~50x and change no number.")
    a("*")
    a("* Areas from the measured MiM density law (devchar Sec 1.2),")
    a(f"* C(s) = {MIM_A}*s^2 + {MIM_B}*s fF for a square of side s um:")
    for w in WEIGHTS + [1]:
        c = w * C_UNIT_FF
        tag = "terminating unit" if w == 1 and WEIGHTS[-1] == 1 else ""
        a(f"*   w={w:>3}  C = {c:>9.2f} fF  ->  s = {mim_side_um(c):.4f} um")
        if tag:
            break
    a("*")
    a("* `sel_in` is ONE port, not nine: every cell's fourth leg is driven by")
    a("* the same broadcast control, because all bottom plates sample")
    a("* together by construction (design/sar-logic/README.md states the same")
    a("* bus-width argument from the controller side). The per-cell decode is")
    a("* still four one-hot legs; one of the four is shared.")
    ports = ["top", "vin", "vref", "vcm", "vss", "vdd", "sel_in"]
    for w in WEIGHTS:
        ports += [f"rel_{w}", f"hi_{w}", f"lo_{w}"]
    L += sar._wrap(".subckt adc_cdac_side", ports)
    for w in WEIGHTS:
        s = mim_side_um(w * C_UNIT_FF)
        a(
            f"X{w} top vin vref vcm vss vdd sel_in rel_{w} hi_{w} lo_{w}"
            f" adc_cdac_cell cw={_fmt(s)}u cl={_fmt(s)}u"
        )
    s1 = mim_side_um(C_UNIT_FF)
    a("* terminating unit: DR-0011's 512th position, fixed to V_cm, never")
    a("* switched -- it is what makes the weight-1 trial resolve exactly one")
    a("* LSB of full scale rather than one part in 511. Under DR-0014 it is")
    a("* also the one unit that does NOT track V_in during acquisition, so")
    a("* the capacitance the input PIN drives is 511*C_u = "
      f"{(N_UNIT_PER_SIDE - 1) * C_UNIT_FF / 1000:.3f} pF while the")
    a("* C_arr the charge balance runs on is still 512*C_u = "
      f"{N_UNIT_PER_SIDE * C_UNIT_FF / 1000:.3f} pF. The")
    a("* 0.2 % difference sits inside the ratified Input-structure row's own")
    a("* rounding and does not change DR-0013's <= 30 ns drive contract.")
    a(f"Xterm top vcm mim_cap_2f0 c_width={_fmt(s1)}u c_length={_fmt(s1)}u")
    a(".ends adc_cdac_side")
    a(ADC_END)
    return "\n".join(L) + "\n"


# ---------------------------------------------------------------------------
# the core: one complete converter, emitted flat with a tag prefix
# ---------------------------------------------------------------------------


def _core(tag: str, mode: str) -> list[str]:
    """One complete ADC: front end, array, comparator, rung-1 controller.

    `mode` is "0" (single-ended) or "{vdd_val}" (differential), the same
    encoding `sar_ctrl_a`'s `mode` pin takes.

    Supplies are brought out as four separate nodes so a power record can
    attribute current per block rather than reporting one lump:

        vddt  top-plate V_cm switch and its driver (DR-0014); before that
              record this rail supplied the dedicated top-plate sampling
              switch, i.e. it still means "the switch that defines the
              sampling instant"
        vddd  CDAC bottom-plate switches and their local drivers -- now four
              legs per cell, so DR-0014's fourth (V_in) leg and its driver
              are measured here rather than analytically
        vddc  comparator
        plus the vref / vcm reference sources, measured separately

    The rung-1 sequencer draws no supply current at all -- it is XSPICE
    event-driven primitives, not devices. That is a stated gap in the power
    record, not an omission.
    """
    L: list[str] = []
    a = L.append
    a(f"* ================= core {tag} ({'differential' if mode != '0' else 'single-ended'}) ==")
    a(f"v{tag}start {tag}_start 0 dc 0")
    a(f"v{tag}mode {tag}_mode 0 dc {mode}")

    # --- controller (rung 1) ------------------------------------------------
    ports = [f"{tag}_{p}" for p in sar._ports_ctrl_analog()]
    ports[0] = "clk"
    ports[1] = f"{tag}_start"
    ports[2] = f"{tag}_mode"
    ports[3] = f"{tag}_cmp"
    L += sar._wrap(f"x{tag}ctrl", ports + ["sar_ctrl_a"])

    # --- input drive network + DR-0014's top-plate switches -----------------
    a("* Input drive network, DR-0013: series source resistance and a pin")
    a("* capacitor, at the compliant point sim/track-switch-sampling/")
    a(f"* measured the ratified gain-error number at ({TRACK_RS_OHM} ohm,"
      f" {TRACK_CPIN}). DR-0014 leaves that contract standing and removes the")
    a("* DEDICATED sampling switch that used to sit behind it: the pin now")
    a("* drives the array's fourth-leg T-gates directly, nine per side.")
    for s in ("p", "n"):
        a(f"R{tag}s{s} {tag}_vin{s} {tag}_pin{s} {TRACK_RS_OHM}")
        a(f"C{tag}x{s} {tag}_pin{s} 0 {TRACK_CPIN}")
    a("* The top-plate V_cm switch, one per side (DR-0014). It opens on the")
    a("* edge into ph3 -- one whole bit cycle before the bottom plates leave")
    a("* V_in -- and THAT edge is the sampling instant. Both sides are driven")
    a("* by the SAME control net: their skew is precisely the term this")
    a("* topology cannot cancel, so it is not manufactured here by routing")
    a("* two copies. Body ties go to vddt, which used to supply the")
    a("* dedicated sampling switch, so the power record's `trk` block still")
    a("* reports 'the switch that defines the sampling instant'.")
    for s in ("p", "n"):
        a(
            f"X{tag}tsw{s} {tag}_top{s} vcmn {tag}_samp_tp_n vddt 0"
            f" adc_tp_sw"
        )

    # --- the two array sides ------------------------------------------------
    for s in ("p", "n"):
        ports = [
            f"{tag}_top{s}",
            f"{tag}_pin{s}",
            "vrefn",
            "vcmn",
            "0",
            "vddd",
            f"{tag}_sel_in_n",
        ]
        for w in WEIGHTS:
            ports += [
                f"{tag}_rel_n_{w}{s}",
                f"{tag}_sel_hi_n_{w}{s}",
                f"{tag}_sel_lo_n_{w}{s}",
            ]
        L += sar._wrap(f"X{tag}arr{s}", ports + ["adc_cdac_side"])

    # --- comparator ---------------------------------------------------------
    a("* Comparator, DR-0015: static preamp + StrongARM latch. Its inputs")
    a("* ARE the CDAC top plates, so its input capacitance and its kickback")
    a("* are inside every number this deck reports, not bolted on after.")
    a("* Wired conventionally (top_p to the + input) even though DR-0014")
    a("* inverts the residue: the inversion is taken once inside the")
    a("* controller instead, so `cmp` keeps meaning 'top_p > top_n'")
    a("* everywhere in this repo. Under this record the comparator's own")
    a("* input capacitance is still ON the sampling node, but it no longer")
    a("* divides the DAC step against an undivided sampled input -- both are")
    a("* now over the same C_arr + C_par, which is the term that cancels.")
    a(f"i{tag}b vddc {tag}_ibias dc 10u")
    a(
        f"X{tag}cmp {tag}_topp {tag}_topn cmpclk {tag}_ibias {tag}_cmp"
        f" {tag}_cmpb vddc 0 comparator"
    )

    # --- ideal shadow: the same conversion with an exact DAC ----------------
    a("* ---- the ideal shadow --------------------------------------------")
    a("* The reference this deck measures against is NOT a second simulation:")
    a("* it is the exact charge-domain result of THE DECISIONS THE REAL")
    a("* CONVERTER JUST MADE, computed from the controller's own switch-")
    a("* driver outputs. So the error node below isolates the analog error")
    a("* mechanisms (acquisition, charge injection, incomplete settling,")
    a("* reference movement, comparator kickback, top-plate parasitic")
    a("* attenuation) from decision errors, which the code check catches")
    a("* separately.")
    for s in ("p", "n"):
        terms = [
            f"{w}*((v({tag}_rel_n_{w}{s})*vcm+v({tag}_sel_hi_n_{w}{s})*vref"
            f"+v({tag}_sel_in_n)*v({tag}_vin{s}))/vdd_val-vcm)"
            for w in WEIGHTS
        ]
        L += sar._wrap(
            f"b{tag}dac{s} {tag}_dac{s} 0 V = (1.0/512)*(",
            [" + ".join(terms) + " )"],
        )
    a("* The ideal differential top plate under DR-0014 bottom-plate")
    a("* sampling. The sampled input enters INVERTED about V_cm -- charge")
    a("* conservation on a top node released at V_cm gives")
    a("*   V_top,s = V_cm + k*[(V_cm - V_in,s) + dac_s],  k = C_arr/(C_arr+C_par)")
    a("* -- so the ideal (k = 1) differential residue is")
    a("*   di = (V_inn - V_inp) + dac_p - dac_n")
    a("* where under DR-0011 it was +(V_inp - V_inn) + dac_p - dac_n. This")
    a("* one sign is the whole behavioural consequence of the record, and it")
    a("* is why the controller inverts the comparator once at its own")
    a("* boundary (design/sar-logic/, `dec = !cmp`).")
    a(
        f"b{tag}di {tag}_di 0 V = v({tag}_vinn)-v({tag}_vinp)"
        f"+v({tag}_dacp)-v({tag}_dacn)"
    )
    a("* Error, in LSB of this deck's own mode. Referenced to zero, not to a")
    a("* mid-rail level, so the ~1 uV `meas` result-precision floor")
    a("* (sim/harness/README.md) lands 3 decades below one LSB instead of on")
    a("* top of the quantity being measured.")
    a("*")
    a("* NEGATED with respect to the superseded version, deliberately: the")
    a("* residue now moves OPPOSITE the input, so d(top_p-top_n)/dV_in = -1")
    a("* and an INPUT-REFERRED error is (ideal - actual), not (actual -")
    a("* ideal). Keeping the node input-referred is what makes this deck's")
    a("* terr/INL numbers comparable in sign with the records taken before")
    a("* DR-0014 instead of silently flipping every one of them.")
    a(
        f"b{tag}e {tag}_err 0 V = (v({tag}_di)-(v({tag}_topp)-v({tag}_topn)))"
        f"/lsb"
    )
    a("* The error, GATED TO THE DECIDE PHASES ONLY. A comparator decides on")
    a("* the strobe, so the only instants at which the input-referred error")
    a("* matters are the ten strobe-high windows; in between, the residue is")
    a("* still settling and its excursion is a transient nobody samples. So")
    a("* this node is |err| while cmpclk is high and zero otherwise, and MAX")
    a("* over a conversion's trial window is that conversion's WORST DECISION")
    a("* ERROR -- one number instead of ten.")
    a("*")
    a("* An earlier draft used a track-and-hold switched by cmpclkb instead.")
    a("* That was wrong in a way worth recording: the T/H TRACKS during the")
    a("* settling half of each bit cycle, so a MAX over the same window picked")
    a("* up the settling transient it was supposed to blank -- reporting ~300")
    a("* LSB where the decisions were actually taken within a few LSB. Gating")
    a("* is the correct primitive here; holding is not.")
    a(f"b{tag}ea {tag}_aerrh 0 V = abs(v({tag}_err))*(v(cmpclk)>vth ? 1 : 0)")
    a("* Decoded output code (the parallel register, DR-0005).")
    terms = [f"({2 ** b})*(v({tag}_c{b})>vth ? 1 : 0)" for b in range(9, -1, -1)]
    L += sar._wrap(f"b{tag}code {tag}_code 0 V = ", [" + ".join(terms)])
    return L


def _preamble(mode_lsb: str) -> list[str]:
    """Params, models, clocks and reference network shared by every deck."""
    L: list[str] = []
    a = L.append
    a("* ---- ratiometric rails --------------------------------------------")
    a("* V_REF = V_DD. README.md note [c] makes V_REF <= V_DD a hard")
    a("* condition of the ratified spec, so a fixed 3.3 V reference is not")
    a("* legal at the 2.97 V corner; taking V_REF = V_DD keeps the deck legal")
    a("* at every point of the supply axis, and every figure below is in LSB")
    a("* of whatever full scale that point has.")
    a(".param vref={vdd_val}")
    a(".param vcm={vdd_val/2}")
    a(".param vth={vdd_val/2}")
    a(f".param lsb={mode_lsb}")
    a("")
    a("")
    a("* ---- clocks --------------------------------------------------------")
    a("* DR-0003: one external clock pin at 16 x f_s. The comparator strobe")
    a("* is the same clock shifted half a bit cycle, so the CDAC settles in")
    a("* the first 31.25 ns and the comparator decides in the second -- the")
    a("* split spec/prior-art-survey.md Sec 1.4 allocates and")
    a("* sim/comparator-regeneration/ measured 863 ps of worst-case decision")
    a("* delay against.")
    a(
        f"vclk clk 0 pulse(0 {{vdd_val}} 0 100p 100p {CLK_PERIOD_NS / 2}n"
        f" {CLK_PERIOD_NS}n)"
    )
    a(
        f"vcmpclk cmpclk 0 pulse(0 {{vdd_val}} {CMP_STROBE_NS}n 100p 100p"
        f" {CLK_PERIOD_NS / 2}n {CLK_PERIOD_NS}n)"
    )
    a(
        f"vcmpclkb cmpclkb 0 pulse({{vdd_val}} 0 {CMP_STROBE_NS}n 100p 100p"
        f" {CLK_PERIOD_NS / 2}n {CLK_PERIOD_NS}n)"
    )
    a("")
    a("* ---- supplies, split per block so power is attributable -----------")
    a("vddt vddt 0 dc {vdd_val}")
    a("vddd vddd 0 dc {vdd_val}")
    a("vddc vddc 0 dc {vdd_val}")
    a("")
    a("* ---- reference network, DR-0002 -----------------------------------")
    a("* DR-0002 specifies an EXTERNAL V_REF pin with an effective source")
    a("* impedance <= 240 ohm IN THE SWITCHING BAND and >= 40 nF of external")
    a("* decoupling. Both halves of that sentence are modelled: the inductor")
    a("* in parallel with the 240 ohm makes the network 240 ohm at the")
    a("* switching band and DC-accurate below it, which is what an external")
    a("* reference buffer behind a decoupling capacitor actually is. A bare")
    a("* 240 ohm series resistor would instead assert a DC offset DR-0002")
    a("* never specified -- and, with 40 nF, a 9.6 us settling tail that")
    a("* would dominate any run shorter than ~50 us.")
    a(f"vrefs vrefs 0 dc {{vref}}")
    a(f"rref vrefs vrefn {VREF_Z_OHM}")
    a(f"lref vrefs vrefn {VREF_Z_OHM / (2 * math.pi * 16e6) * 1e6:.4f}u")
    a(f"cref vrefn 0 {VREF_CDEC}")
    a("* V_cm generation is explicitly unbudgeted work (DR-0011")
    a("* Consequences: 'a new, currently-unbudgeted deliverable for a future")
    a("* issue'), so there is no ratified envelope to model it against and it")
    a("* is an IDEAL source here. That is a stated assumption of every record")
    a("* this deck produces, not a measured result -- see the known-")
    a("* limitations section of spec/testbench-suite-memo.md.")
    a("vcms vcmn 0 dc {vcm}")
    return L


# ---------------------------------------------------------------------------
# deck 1: static linearity
# ---------------------------------------------------------------------------

#: Transitions probed by the static-linearity deck. Chosen from DR-0011's
#: actual array, not assumed binary-weighted-with-a-mid-scale-carry: see the
#: header comment the deck carries.
INL_TRANSITIONS = [
    1, 2,          # bottom of range: endpoint-fit anchor + its DNL partner
    128, 129,      # weight-128 carry
    255, 256, 257, # weight-256 carry (the sub-array MSB) and both neighbours
    384,           # weight-128 carry in the upper half of the lower segment
    511, 512, 513, # the free-MSB transition and both neighbours
    640,
    767, 768, 769, # weight-256 carry, MSB = 1
    896,
    1022, 1023,    # top of range: endpoint-fit anchor + its DNL partner
]

#: (lower, upper) transition pairs whose DNL this deck reports.
INL_DNL_PAIRS = [
    (1, 2), (128, 129), (255, 256), (256, 257), (511, 512), (512, 513),
    (767, 768), (768, 769), (1022, 1023),
]

#: Tolerance on the end-to-end code check, in LSB. Sized to absorb the gain
#: error the SUPERSEDED top-plate-sampling topology measured (~31 LSB full
#: scale) plus margin, so this check tests liveness and tracking rather than
#: restating the gain claim. The LINEARITY bound (inl_t<k>_lsb) is NOT widened:
#: it stays at the ratified 1 LSB.
#:
#: DELIBERATELY NOT TIGHTENED FOR DR-0014. That record's derivation says the
#: term this window was opened for should now cancel, which would allow a much
#: tighter window -- but tightening it here would be asserting the outcome of a
#: run that has not been taken. #61 owns the re-run on this topology and owns
#: closing the window against what it measures. Loosening is what CLAUDE.md
#: forbids; leaving an inherited bound in place while the evidence is re-taken
#: is not.
CODE_TOL_LSB = 45.0

#: Bound on the worst per-decision input-referred error, in LSB. Same argument
#: and the same inheritance: an early trial's residue carried the full gain
#: error under the superseded topology, so this could not be tighter than the
#: gain term without restating it, and it is left where it was until #61
#: measures the new one.
DECERR_MAX_LSB = 45.0

#: Conversions of settling before the first measured one.
INL_WARMUP_CONV = 2
#: Conversions per test point. ONE: the input steps 10 ns before the
#: conversion boundary and DR-0014's acquisition window -- ph0..ph2, which is
#: where the input has to be settled, because the top-plate switch opens on the
#: edge into ph3 -- is 187.5 ns, i.e. 7.5 tau of DR-0013's 25 ns input network.
#: The ladder's largest step between adjacent probed transitions is 126 LSB, so
#: the residual acquisition error is 126 * exp(-7.5) = 0.07 LSB, an order under
#: the 1 LSB claim. (Under the superseded top-plate sampling phase the whole
#: 250 ns sample window was acquisition time and the same number was 0.006 LSB;
#: DR-0014 spends the last of the four clocks isolating the top plate instead,
#: and this is what that costs.) An earlier draft spent a second, un-measured
#: conversion per
#: point re-acquiring the level; that doubled the cost of the single most
#: expensive deck in the suite to buy 0.006 LSB, and it made the deck LESS
#: representative, not more: converting the same code twice in a row lets the
#: reference network (DR-0002, tau = 9.6 us, which never settles between
#: conversions in any case) see a repeat it would never see in service.
INL_CONV_PER_POINT = 1


def _first_differing_bit(k: int) -> int:
    """Bit position (9 = MSB .. 0 = LSB) that resolves the transition k-1 -> k."""
    diff = (k - 1) ^ k
    return diff.bit_length() - 1


def _inl_trial(k: int) -> int:
    """Trial index (1..10) whose decision sets transition `k`'s voltage."""
    return 10 - _first_differing_bit(k)


def _inl_conv_start_ns(idx: int) -> float:
    """Start of the conversion that is MEASURED for probed transition `idx`.

    The input ladder steps 10 ns before conversion
    ``INL_WARMUP_CONV + INL_CONV_PER_POINT*idx``; the measured conversion is
    the LAST of that point's group, so the offset is
    ``INL_CONV_PER_POINT - 1``, not a hardcoded 1. (With the earlier
    two-conversion schedule the two happened to be the same number, which is
    exactly why an off-by-one hid here when the schedule changed: DNL jumped to
    2-5 LSB because every point was being read one conversion late, i.e.
    against the NEXT point's input.)
    """
    return (
        INL_WARMUP_CONV + INL_CONV_PER_POINT * idx + INL_CONV_PER_POINT - 1
    ) * CONV_NS


def _inl_end_ns() -> float:
    return (INL_WARMUP_CONV + INL_CONV_PER_POINT * len(INL_TRANSITIONS)) * CONV_NS
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
