2AMLogic/gf180-sar-adc/layout/adc-top/parasitics/gen_extracted_timing_budget_tb.py

#!/usr/bin/env python3
"""Issue #12's conversion-timing-budget deck, re-composed with the settling
network's **post-layout** R and C.

    python3 layout/adc-top/parasitics/gen_extracted_timing_budget_tb.py
    python3 layout/adc-top/parasitics/gen_extracted_timing_budget_tb.py --check

Writes ONE file:

    sim/timing-budget-closure/testbench/tb_timing_budget_closure_extracted.spice

into the SAME experiment directory as the schematic-level deck, per
`sim/README.md` "Extracted vs schematic semantics", and deliberately does NOT
write a second `tb.json`: the run is

    python3 sim/run_corners.py timing-budget-closure \\
        --netlist sim/timing-budget-closure/testbench/tb_timing_budget_closure_extracted.spice \\
        --netlist-provenance 'extracted (...)'

i.e. the UNMODIFIED manifest -- same analyses, same `meas` expressions, same
checks, same ratified pass/fail thresholds. Nothing about the spec moves.

## What is post-layout here, and what is NOT

Issue #12's closed-loop budget consumes exactly three numbers
(`design/sar-logic/gen_sar_logic.py`):

| input | schematic | this deck | post-layout? |
|---|---|---|---|
| `R_WORST_BIT_OHM` | 570 Ω | **648 Ω** | **yes** |
| `C_WORST_BIT_F` | 2.20672 pF | **2.40712 pF** | **yes** |
| `T_COMP_REGEN_NS` | 0.863 ns | **1.257 ns** | **yes (issue #116)** |

so this deck is now **fully post-layout on all three inputs** -- the last
one closed at issue #116. Per CLAUDE.md's no-relaxation rule, a schematic
number relabelled as an extracted one is exactly what must not happen; the
honest form is to state which input is which and where each came from, and
that is what this module and the record it feeds do.

**`R_WORST_BIT_OHM` = 648 Ω** -- `ron_t_max` at `ss_125c_2.97v`, the worst
cell of the 45 point PVT grid in
`sim/device-switch-ron/records/20260814-191138-f613571.md`, measured against
the extracted `adc_tgate` leaf at the `875eac3` toolchain pin (647.818 Ω,
rounded up). The schematic number it replaces, 570 Ω, is `ron_t_max` at the
SAME corner from the same deck's schematic run -- so the two are like-for-
like and the +78 Ω delta is the drawn cell's own in-path interconnect,
which no earlier pin could express (every prior extracted run measured a
delta of exactly zero; `records/20260806-parasitic-topology.md`).

The cited record moved (issue #150) without the number moving. This constant
was first sourced from `20260806-194322-68ad582`, whose own **Netlist
provenance** field declares it "taken against a dirty working tree ... not
citable as a clean-tree result". `20260814-191138-f613571` is the clean-tree
re-take of that same deck at that same pin, and **Supersedes** it; all 45
corners x 25 columns come back bit-identical, `ron_t_max` at `ss_125c_2.97v`
included. So this is a citation repair, not a re-measurement: 647.818 Ω is
unchanged, and no `sim/timing-budget-closure/` re-run is owed -- only this
deck's provenance comment moves, exactly as PR #130 moved
`gen_extracted_switch_ron_tb.py`'s `* Source:` line without minting a record.

**`C_WORST_BIT_F` = 2.40712 pF** -- the schematic's 2.20672 pF
(`Ceq(w=256) = 128 * C_u`, `spec/cdac-sizing-memo.md` §5.3) PLUS 200.4 fF of
extracted top-plate parasitic capacitance, the `topp` net's own extracted C
in `layout/adc-top/parasitics/reports/20260806-193910-68ad582/adc_top.para.spice`
(the worse of the two sides; `topn` is 189.7 fF). The unit capacitor itself
needs no correction any more: at this pin the deck's MiM model is the PDK
model card's own two-term area+fringe formula (`klayout-tools#512`), so the
extracted unit cap is 17.2449 fF against the 17.24 fF the schematic figure
was derived from -- agreement to the drawn-geometry rounding, where every
earlier pin was 14.6 % low.

**`T_COMP_REGEN_NS` = 1.257 ns** -- worst-corner (`ss_125c_2.97v`, same
corner as every other row above) `td_half_ns` from a comparator-inclusive
`ADC_BLOCK` regeneration-margin campaign, measured 1.25638 ns and rounded up
(`sim/comparator-regeneration/records/20260814-215626-f613571.md`, 45-point
PVT grid, all ratified checks PASS). `ADC_BLOCK`'s own preamp/StrongARM
comparator is baked INSIDE the extraction (issue #118 closed the functional
blocker that used to prevent this -- the preamp's load resistors now extract
as real `ppolyf_u_1k` devices instead of shorting); `layout/adc-top/
parasitics/measure_extracted_regeneration.py` forces `topp`/`topn` (the
comparator's own input pins) directly and drives the SAME 0.5 LSB / 100 mV /
0.1 mV overdrive ladder #9's schematic deck uses, referred to the extracted
core's own MEASURED systematic offset (a real, deterministic post-layout
finding -- see that record's own "Why the ladder is offset-referred"
section) rather than to 0 V. `2AMLogic/klayout-tools#595` remains open
(the `ppolyf_u_1k`-vs-`ppolyf_u_2k` sheet-rho selection is a modelling
nicety this repo's local resize already works around, per issue #118 --
not a blocker for this measurement).

## The `.save`, and why its reason here is NOT the other decks' reason

`gen_extracted_core_tb.saved_vectors_lines()` (PR #130, issue #123) emits a
`.save` naming exactly the vectors a deck's manifest reads -- derived from
the manifest, never hand-listed. Issue #131 brought this deck under that
treatment too, but the reason it needs one is a different one, and the
emitted comment block says so rather than repeating the ADC decks' text.

In `gen_extracted_{inl_dnl,enob_fft,power,dr0014_sampling}_tb.py` the cause
is node COUNT: the star-split in-path extraction (`klayout-tools#593`, the
`875eac3` pin) gives every device terminal on a net its own leg node, so the
full-node store overruns what ngspice will allocate. **That cause does not
apply here** -- this deck wraps no extracted core at all. What is post-layout
about it is two SCALAR component values (the table above); the netlist is
`gen_sar_logic.budget_closure()`'s own schematic text with those two values
substituted, one lumped R and one lumped C per loop, rung-1 XSPICE digital,
zero parasitic elements.

The cause here is transient LENGTH across eight parallel loops: `tb.json`'s
`tran 5n 8.55u 0 5n` runs 8.55 us over eight full SAR loops' worth of nodes
(11 634 data rows), and ngspice keeps a waveform per node per step either
way. Measured on `tt_27c_3.30v` with `/usr/bin/time -l ngspice -b` against
the harness-composed point (issue #131, ngspice-46, `num_threads=1`, two
runs each): **241.2 / 241.4 MB peak RSS without the `.save`, 32.8 / 32.6 MB
with it** -- a 7.4x cut.

Stated honestly: this deck **did not fail** without the `.save`, on this
host, at one point at a time. What it did was sit within a factor of ~1.1 of
the 260.8 MB store PR #130's INL/DNL deck was refused outright, on a
threshold that is the OS's *available* memory rather than a fixed ngspice
cap -- so it collapses as concurrent `-j` points allocate. The claim being
made here is therefore "one busy host away from a load-dependent,
comes-and-goes failure", not "it cannot run"; the line is worth having on
those merits without borrowing the extraction's stronger rationale, which
would be an overstatement in this deck.

**It cannot move a number**, and that was checked on this deck rather than
inferred from PR #130's check on another one: the same `tt_27c_3.30v` point
run with and without the `.save` returns all eight measurements bit-identical
(`aerr_r1_l55 = 2.55000e+02 at= 4.00256e-06`, and so on for the other seven).
`.save` selects which waveforms are RETAINED; it touches no model, tolerance
or timestep.

This does mean the deck now differs from the committed schematic-level
`tb_timing_budget_closure.spice` in one more line than the two component
values -- `_header()` below states that, rather than keeping its previous
"and in nothing else" wording, because the whole point of that sentence is
that a reader can trust it literally.
"""

from __future__ import annotations

import argparse
import importlib.util
import json
import sys
from pathlib import Path
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
