2AMLogic/gf180-sar-adc/(commit log)

2026-07-29 Scaffold canary block: 10-bit SAR ADC on gf180mcu
    Selected by the scored block matrix (marketing repo strategy/).
    Draft spec pending engineering ratification.
2026-07-31 docs: define sim/ evidence record format ported from gf180-bandgap (#18)
    Ports the sim/README.md append-only evidence-record format from
    2AMLogic/gf180-bandgap (directory/naming convention, record-id and
    corner-id schemes, base summary-record schema) and adds ADC-specific
    extensions: dynamic-test (FFT) metadata, a linearity methodology
    field, an extended Monte Carlo convention (seed handling + mismatch
    scope), a noise methodology field, and a characterization-record
    variant with a data-provenance field. Includes two worked example
    records using placeholder values only.
2026-07-31 docs: add SAR ADC prior-art survey for gf180mcu 3.3 V (#19)
    Adds spec/prior-art-survey.md, a literature and open-source survey covering
    the three architecture axes that gate the downstream design work.
    - CDAC switching: conventional / split-cap / monotonic / merged-cap (Vcm),
    compared on switching energy (closed forms reproducing the published
    1363.3 / 255.5 / 170.2 C_u*Vref^2 figures), comparator-input common-mode
    excursion, and array capacitance vs reference-drive burden.
    - Comparator: StrongARM / double-tail / multi-stage on offset, noise, speed
    and kickback; an eight-row offset-cancellation cost table; and the
    noise-verification path each topology implies given that ngspice of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
2026-07-31 feat: add gf180mcu PVT corner harness with verified corner switching (#22)
    * feat(sim): add gf180mcu PVT corner harness with per-axis sensitivity checks
    Ports the sim-harness pattern from 2AMLogic/gf180-bandgap@58024be (PDK
    resolution, deck composition, manifest schema, record-id scheme, append-only
    writer) and adapts it to this block's device inventory and evidence format.
    Corner runner:
    - corner bundles for the 3.3 V MOS analog path plus MiM/MOS capacitor
    families, with a `cdac` corner set; the five MOS corners leave both cap
    families at typical, so nothing in a MOS-only sweep would notice a broken
    mimcap/moscap include.
    - MIM subckts are bound to the resolved PDK variant's metal s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
    [smoke_test.sch]
2026-07-31 docs: add idempotency marker for Champion size-check failure comments (#24)
    The size-check failure path in champion-pr-merge.md had no guard against
    re-posting the identical "Cannot Auto-Merge: size" comment on every
    10-minute Champion tick, causing spam (observed: 4 duplicate comments on
    PR #20). Mirror the existing stale-PR idempotency-marker pattern
    (<!-- champion:stale-pr-notice -->) with a new
    <!-- champion:size-limit-notice --> marker, but keep loom:pr (unlike
    stale PRs) since the fix is a single loom:auto-merge-ok label addition
    rather than a rebase/re-review. Also documents the new edge case in
    champion-reference.md's decision table.
2026-07-31 feat(sim): characterize gf180mcu CDAC caps, switches and comparator input devices (#25)
    * feat(sim): forward dtemp through the MiM wrapper, add a PDK model-capability audit
    Three harness-level changes that the device-characterization testbenches need.
    1. mim_cap_<density> now takes and forwards dtemp (default 0). `.temp` is
    global to a deck, so a capacitor temperature coefficient cannot be measured
    *within* one PVT point without a per-instance temperature offset -- a tempco
    read off the grid's temperature axis is arithmetic a reader performs on the
    record table, not a measured quantity a `checks` entry can bound. The PDK
    subckts already accepted dtemp; the wrapper was hiding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
2026-07-31 docs: rewrite README for a public audience and add Apache-2.0 LICENSE (#27)
    Replaces the PRIVATE/catalog framing in README.md with a public-facing
    description: the gf180mcu open-PDK target, an honest early-stage status
    table, the DRAFT spec table (unchanged), the append-only evidence rule,
    and the klayout-tools friction protocol. Drops the internal
    selection-rationale line and the shuttle/maturity-ladder phrasing.
    Adds LICENSE with the Apache-2.0 text.
2026-07-31 docs(spec): resolve #7 scope decisions (input drive, reference, clocking, device flavor) (#26)
    * docs(spec): resolve input drive, reference, clocking, device-flavor scope decisions
    Four decision records close the scope questions blocking #8, #10, #11,
    #12: external-driven input (<=500 ohm source impedance, 1 MS/s only),
    external V_REF pin with a reference-drive model, an external 16-32 MHz
    clock (no on-chip oscillator, budgeted aperture jitter), and 3.3 V
    devices throughout with SPI deferred past simulation-complete.
    Closes #7
    * docs(spec): split DR-0004 into device-flavor and interface-scope records
    Judge review of #26: DR-0004-device-flavor-interface-scope.md bundled two
    independent de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
2026-07-31 ci: add headless GitHub Actions workflow for the repo's self-checks (#31)
    Adds .github/workflows/ci.yml, which runs on push to main and on every pull
    request. It executes the checks that need no PDK:
    - sim/selftest.sh stage 1 (harness unit tests), invoked byte-identically to
    the script so local and CI runs cannot diverge
    - bash -n on sim/selftest.sh, sim/env.sh, sim/smoke_test/run_smoke_test.sh
    - python3 -m compileall over sim/, which covers
    sim/tools/pdk_mismatch_audit.py (no unit-test coverage, needs a PDK to run)
    The workflow header enumerates every self-check in the repo and states, for
    each, whether it runs in CI or is excluded and why. selftest.sh stages 2-4
    (toolchain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
2026-07-31 spec: ratify the target specification with the #33 amendments (#35)
    * docs: add reference, clock, supply and error rows to the target spec table
    Transcribes the expert spec-review amendments into README's DRAFT target
    specification table. Every number comes from an existing record in the
    repo (DR-0001..0004, sim/device-characterization-report.md,
    spec/prior-art-survey.md) — no new analysis.
    - New rows: Reference, Clock, Supply, Offset error, Gain error, Input
    structure, SFDR @ Nyquist, Latency/conversion timing, CMRR.
    - Input row is now ratiometric (0-V_REF with V_REF <= V_DD), resolving
    the contradiction between a fixed 0-3.3 V range and the 2.97 V supply
    corner where such an inpu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
2026-07-31 Size the CDAC unit cap from kT/C and matching, ratify MCS/Vcm switching, verify per-bit settling (#38)
    * feat(cdac): ratify MCS/Vcm switching scheme, size unit cap from kT/C + matching
    Adds DR-0006 (CDAC switching-scheme decision record, consuming the #3
    survey's shortlist), spec/cdac-sizing-memo.md (kT/C noise budget allocation
    and matching-to-linearity propagation re-derived for the chosen
    top-plate-sampling MCS array rather than the plain-binary formula, dominant-
    constraint statement, DR-0002 reference-drive cross-check), and a
    representative xschem schematic of the CDAC array implementing the chosen
    scheme.
    * test(cdac): sweep four bit weights so the worst settling bit is measured
    Th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
    [cdac_array.sch]
2026-08-01 ci: run PDK-dependent self-checks nightly on a cached gf180mcu install (#36)
    * ci: run PDK-dependent self-checks nightly on a cached gf180mcu install
    sim/selftest.sh stages 2-4 -- the toolchain pin check, the end-to-end PVT
    sweeps, and the --sabotage-corners negative control -- only ever ran on a
    developer's machine, so nothing automated noticed if corner switching
    regressed. Stage 4 is the only check that can tell a live corner sweep from
    one silently simulating typical everywhere.
    Add .github/workflows/nightly-pdk.yml, which installs a real PDK on a hosted
    runner and runs `sim/selftest.sh --require-pdk` nightly, on demand, or on a PR
    labelled ci:pdk:
    - gf180mcu comes from volare at the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
2026-08-01 feat(spec): choose 4x T-gate track switch over bootstrap, with PVT SFDR evidence (#40)
    Adds DR-0007: T-gate-vs-bootstrap topology decision for the CDAC input
    sampling switch, backed by two new PVT-swept testbenches rather than
    assumption. sim/track-switch-thd's full 117-point grid shows the nominal
    10u/20u T-gate fails the SFDR >= 62 dB floor by ~8 dB (53.8 dB worst case),
    while upsizing 4x clears it with margin; a real bootstrap is rejected on
    an independent device-reliability ground (its boosted node reaches up to
    6.6 V, ~2x the 3.3 V device flavor's rating). sim/track-switch-sampling's
    full 117-point grid (bootstrap branches disabled after their internal
    feedback loop was measured to domi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
    [track_switch.sch]
2026-08-01 feat(sar-logic): synchronous SAR controller at rung-1, with sim strategy decision (#42)
    * feat(design): add synchronous SAR control logic at the rung-1 abstraction
    Bit-cycle sequencer (16 phases: 4 sample + 10 trials + 2 output/reset),
    per-weight CDAC switch drivers with DR-0006's mode-dependent side
    switching, and the 10-bit parallel output register of DR-0005, built from
    ideal XSPICE digital primitives and generated from a single source so the
    design and its two testbench fragments cannot drift apart.
    Adds the exhaustive functional testbench (all 1024 codes in each input
    mode) and the timing-margin testbench (how much of the 62.5 ns bit cycle
    the architecture can lose before conversions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
    [test_sar_logic_netlist.py]
2026-08-01 fix: resolve DR-0006 filename collision by renumbering CDAC switching-scheme record to DR-0011 (#44)
    spec/decision-records/ had two unrelated records both numbered DR-0006:
    DR-0006-cdac-switching-scheme.md (issue #8) and
    DR-0006-spec-ratification.md (issue #33/#1). Per the directory's own
    collision tie-break ("the later-merged one is renumbered"), the
    ratification record merged first and keeps DR-0006; the CDAC
    switching-scheme record is renumbered to DR-0011 (the next unused
    number, recomputed at implementation time -- DR-0007..DR-0010 are now
    all claimed on main).
    Renames the file (path + heading) and updates every cross-reference in
    design/, sim/, and spec/ that cites the switching-schem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
    [cdac_array.sch, track_switch.sch]
2026-08-01 Comparator: static preamp + StrongARM latch, offset/noise/metastability budget closed on measured PVT evidence (#45)
    * sim: add comparator preamp DC/offset-MC/noise testbenches and canonical netlist
    Adds the static-preamp + StrongARM-latch comparator netlist as the single
    source of truth (design/comparator/comparator.spice), the sync tool and unit
    test that keep its verbatim copies in the testbench fragments from drifting,
    and three corner-runner experiments against it: deterministic preamp DC
    behaviour, a mismatch Monte Carlo of the preamp's input-referred offset, and
    an ngspice .noise measurement of its input-referred noise.
    The noise manifest's measure expressions take ngspice's onoise_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
    [comparator.sch]
2026-08-01 ci: run the xschem smoke test in a separate nightly job (#43)
    Adds an `xschem-smoke` job to nightly-pdk.yml that builds xschem from
    source (cached, keyed on a new xschem_tag/xschem_commit pin in
    sim/toolchain.json) and runs sim/smoke_test/run_smoke_test.sh
    --no-write against a real PDK, so xschem netlisting -- previously
    untested by any automated workflow -- gets nightly coverage. Kept as
    its own job (not a step in `selftest`) so a broken from-source xschem
    build reports separately from a corner-switching regression, with its
    own dedup marker and never escalating to loom:urgent. Updates the
    exclusion inventory in ci.yml to reflect the new coverage.
    Closes #37
2026-08-01 docs(comparator): restate kickback as a ~1 uV-floor-limited bound, fix stale cross-references (#48)
    The kickback memo and manifest claimed `vntol = 1 nV` put the numerical floor
    "three decades below the reported values". It does not: the binding limit is
    ngspice's `meas` RESULT precision (~6 significant digits), which quantizes a
    level read off a ~1.7 V top plate to ~1 uV before any `measure` expression
    differences it -- which is why all 43 completed points of the kickback record
    report exact integer uV. The tolerances do reach the deck; they buy solver
    accuracy, not reported resolution.
    - spec/comparator-budget-memo.md S5.2: residual-kick rows restated as
    resolution-limited bounds (<= N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
2026-08-01 spec: separate systematic from mismatch gain error, and pin the sampling switch's charge split (#47)
    * sim(track-switch-sampling): sweep dummy ratio, source impedance and pin-shunt capacitance
    The existing deck fixed two things at once -- the textbook 1:2 dummy-to-main
    width ratio and DR-0001's contracted 500 ohm source impedance -- so its
    gain-error result could not distinguish a mis-sized dummy from a drive-condition
    dependency. Adds three orthogonal axes on the DR-0007 switch (40u/80u main,
    unchanged): dummy ratio at fixed Rs, Rs at fixed dummy ratio, and an external
    shunt capacitor at the input pin measured at both ends of the allowed Rs range,
    plus a candidate configuration and a worst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
    [track_switch.sch]
2026-08-01 docs(spec): Monte Carlo verification of CDAC mismatch and comparator offset (#50)
    * test: add CDAC unit-cap mismatch and comparator-offset GOF testbenches
    Behavioral Monte Carlo of CDAC unit-cap mismatch (calibrated to
    sim/device-characterization-report.md's Pelgrom coefficient, propagated
    through DR-0011's actual 511-unit-cap sub-array topology), plus a new
    comparator-offset goodness-of-fit companion to sim/comparator-offset-mc/
    that prints the raw per-draw offset population so a normality check can
    run against it. Supports issue #14.
    * docs(spec): add Monte Carlo methodology memo and evidence records for #14
    Fit-and-extrapolate CDAC unit-cap mismatch INL/DNL yield (N=5000, seed
    20260801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
    [trials_n20000.csv, trials_n5000.csv]
2026-08-01 feat(layout): stand up the gf180mcu klt drc flow with asserted proof cells (#52)
    * feat(layout): stand up the gf180mcu klt drc flow with asserted proof cells
    Adds layout/drc/: a reproducible, headless `klt drc --deck gf180mcu`
    invocation driven by run_drc.py, two proof cells built via the klayout.db
    API (klt has no layout-generation verb), and the append-only evidence
    convention sim/ already uses, extended to layout/.
    - sw_unit: a single switch device on all four covered layers with two
    seeded violations (contact.space.1, poly2.space.1), so the bring-up
    proves the deck catches something rather than merely running.
    - uncovered_layer_probe: grossly illegal geometry drawn only on layers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
2026-08-01 docs(layout): add CDAC/comparator floorplan and matching plan (#54)
    Writes the pre-layout floorplan/matching-plan document for #16, grounding
    every matching-technique claim in the resolved design decisions from
    DR-0007/DR-0008/DR-0009/DR-0011/DR-0013 and the cdac-sizing / comparator-
    budget memos: plain-binary free-MSB CDAC array with MiM unit caps (flagged
    to #15 for DRC deck coverage), common-centroid layout discipline for both
    the CDAC array and the comparator preamp branches (including the 150 kOhm
    load resistors, since this PDK models no capacitor or resistor mismatch),
    switch placement tied to DR-0013's revised 7/16 finger-count dummy
    construction, SAR-logic isolation against the ratif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
2026-08-01 feat(layout): stand up gf180mcu LVS flow (klt extract + klt lvs) (#55)
    * feat(layout): stand up gf180mcu LVS flow (klt extract + klt lvs)
    Bumps the layout/ klt toolchain pin to an exact upstream commit that has
    extract/lvs (e08f24f), records it in layout/toolchain.json, and stands up
    layout/lvs/run_lvs.py mirroring run_drc.py's pattern: assertion-based,
    append-only evidence, positive and negative LVS controls on a trivial
    single-device proof cell carrying the Metal1 pin labels the extraction
    deck needs for net naming.
    The exact commit (not a floating install) matters: a later upstream
    commit closes the DRC coverage gap issue #15's negative control depends
    on, which would silently break lay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
    [run_lvs.py]
2026-08-01 feat: ADC-level testbench suite, one per spec line, with its measured results (#56)
    * feat(sim,spec): add the ADC-level testbench suite and its methodology memo
    Three transistor-level testbenches, one per open spec-table line, all
    generated from one source of truth (design/adc-top/gen_adc_top.py) and all
    instantiating the same converter -- DR-0013 input network and sampling
    switch, DR-0011's 512-unit MiM array with real T-gate bottom-plate switches
    and local drivers, DR-0007's preamp+StrongARM comparator, and the rung-1
    controller sim/sar-logic-functional/ verified:
    - sim/adc-inl-dnl/ static linearity, reduced code set targeted at DR-0011's
    own weight-256 sub-array c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
2026-08-02 spec: adjudicate top-plate parasitic loading — sample on the bottom plate (DR-0014) (#59)
    * sim: measure what actually loads the CDAC top plate
    sim/adc-inl-dnl/ attributes a 2.85-3.3 % converter-level gain error and a
    -4.494 LSB INL bow to top-plate parasitic loading, with C_par inferred by
    backing it out of the gain error and attributed by assumption to the
    comparator's input pair. #53's decision rests on that attribution, so
    measure it instead: a quasi-static C(V) extraction on the top-plate node,
    decomposed into the comparator input, the sampling switch's hold-mode
    dummy devices and the array itself, with all three on one node as the
    deck's own additivity control.
    * spec: adjudicate t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
    [gen_adc_top.py]
2026-08-02 feat(layout): draw the design/adc-top/ block, DRC-clean and LVS-matched (#62)
    Adds `layout/adc-top/`: the generated block layout for the ADC analog core,
    plus the flat SPICE references `klt lvs` compares the extraction against.
    What is drawn
    - CDAC arrays: 512 unit MiM capacitor positions per side (1024 total),
    common-centroid-tiled and surrounded by a full dummy ring, plus the
    Metal5 top-plate mesh. The tiling assigns every weight to centro-
    symmetric position pairs dealt in bit-reversed order, so it is
    common-centroid by construction rather than by inspection; the per-weight
    census is written to `area.json`.
    - Decode banks: 216 transistors (9 weighted positions x 12 devices x 2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
    [gen_adc_cells.py, gen_adc_top.py, gen_comparator.py, run_lvs.py]
2026-08-02 test(layout): put a check behind centroid_tiling's matching claim (#63)
    PR #62's review found the one matching claim in layout/adc-top/ with no
    test behind it, and the claim was wrong: centroid_tiling's docstring said
    the two odd-count groups were "each displaced by half a pitch in opposite
    directions ... the minimum possible asymmetry for an odd count". Measured,
    the pair they share is dealt like any other and lands at (30, 7) / (1, 8)
    in the 32 x 16 array -- 14.5 pitches (~56.8 um) off centre each, not half
    a pitch.
    Take the docstring path, not the code path: the placement is unchanged, so
    no .gds/.spice/.json under layout/adc-top/ moves and the merged DRC/LVS
    evidence still describes the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
    [gen_adc_top.py, test_layout_centroid_tiling.py]
2026-08-02 feat(design): move sampling from top plate to bottom plates (DR-0014) (#64)
    * feat(design): move the sampling phase to the bottom plates (DR-0014)
    DR-0014 supersedes DR-0011 on the sampling phase only: the input is
    sampled onto the bottom plates through a fourth per-cell leg, and the
    top plate is held at V_cm by a new per-side switch that opens FIRST.
    That edge is the sampling instant. Everything else DR-0011 decided --
    MCS/V_cm switching, 512 unit positions per side, C_u = 17.24 fF, the
    free MSB, the mode-dependent trial sequence -- is unchanged.
    design/adc-top/gen_adc_top.py
    - adc_cdac_cell grows from three legs to four: Xsi drives the bottom
    plate from V_in through the same T-gate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
2026-08-02 test(sim): re-run the ADC suite under DR-0014 bottom-plate sampling — INL/ENOB pass, SFDR misses by 0.67 dB (#65)
    * test(sim): add the dr0014-sampling deck and re-point top-plate-cpar at DR-0014
    The four terms DR-0014's charge-balance derivation assumes away had no
    testbench, and sim/top-plate-cpar/'s branch b was still the dedicated
    top-plate sampling switch DR-0014 removed from the converter.
    - new `sim/dr0014-sampling/`: one transient carrying DR-0014's real
    two-phase schedule, producing the top-plate switch's own charge
    injection and its side-to-side mismatch, the bottom-plate switches'
    injection after that switch has already opened, the fourth leg's cost
    in bit-trial settlin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
2026-08-04 feat(layout): redraw layout/adc-top/ for DR-0014's four-leg bottom-plate sampling topology (#68)
    Adds the fourth one-hot decode leg to adc_cdac_cell (12 -> 16 devices),
    draws the new adc_tp_sw top-plate V_cm switch cell, and drops
    adc_tgate_dum from adc_top/adc_block's composition (kept standalone-
    drawable/LVS-matched since design/adc-top/adc_top.spice still defines it).
    Fixes two Metal1-over-Metal1 shorts found bringing up the vdd/vss/vcm tie
    between the switch cell and the decode banks once the wider (DR-0014)
    banks reshaped the floorplan: extends _clear_offset's collision check to
    every net either side escapes (not just topp/topn), and replaces a fixed
    bridge-Y offset with a search that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
    [gen_adc_cells.py, gen_adc_top.py]
2026-08-04 fix(layout): set the device-row column pitch from comp.space.1, restoring adc_block to 0.09619 mm² (96% of DR-0006) (#69)
    * feat(layout): halve the device-row column pitch to bring adc_block back under DR-0006
    `geometry.COLUMN_GAP` (900 nm) and `place.NWELL_KEEPOUT` (1600 nm) were the
    two constants that set every placed row's width, and neither was sized from
    a rule: `COLUMN_GAP` sat at 3.2x `comp.space.1`'s 280 nm and `NWELL_KEEPOUT`
    at 2.7x what the Nwell edge it guards actually needs. A decode bank crosses
    a column boundary 144 times and a well boundary 17 times per side, so the
    surplus was ~77 um of bank width per side -- and since DR-0014's fourth
    decode leg made the banks the widest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
2026-08-04 docs: update root README Status table to match the drawn adc-top block (#71) (#73)
    The Status table and "no ADC yet" framing predated design/adc-top/ and
    layout/adc-top/ landing (#57, #58/#60, #61, #66, #67) and had gone stale
    enough to be quoted, approvingly but incorrectly, in a public blog post.
    Narrow the framing to what is genuinely still open (the SFDR row missing
    by 0.67 dB at one corner, no post-layout extracted re-run yet, no
    silicon) and point each row at the artifact that backs it, matching the
    citation discipline sim/ records already follow.
    Also add sim/tools/check_readme_status.py, a narrow CI check (wired into
    .github/workflows/ci.yml and `npm run check:ci`) that fails the bu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
2026-08-04 docs: reconcile design/ and layout/ READMEs with the drawn adc-top block (#77)
    * docs: correct README status table against the actual tree (repo hygiene pass)
    The Status table said "no block layout yet" and "smoke-test only" for
    schematics — both false against layout/adc-top/ (DRC-clean, LVS-matched,
    0.09619 mm²) and design/'s per-block schematics composed into
    design/adc-top/adc_top.spice. Narrows "no ADC yet" to what is actually
    still missing: a converged verification suite (SFDR fails one PVT corner
    by 0.67 dB per spec/testbench-suite-memo.md) and silicon.
    Part of #72
    * docs(design): list comparator/, track-switch/, and adc-top/ in the file tree
    design/README.md's ASCII file tree p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
2026-08-04 fix(spec): renumber DR-0007-comparator-topology.md to DR-0015 (#78)
    spec/decision-records/ had two records both numbered DR-0007:
    DR-0007-track-switch-topology.md (merged first, PR #40) and
    DR-0007-comparator-topology.md (merged later, PR #45). Per the
    directory's own numbering invariant, the later-merged record is
    renumbered. DR-0014 is the highest number on main, so the comparator
    record becomes DR-0015 (rechecked against origin/main and open PRs at
    implementation time — none of the 5 recently-merged PRs, and no open
    PRs, claimed a DR-00xx number ahead of this one).
    - Renamed spec/decision-records/DR-0007-comparator-topology.md to
    DR-0015-comparator-topology.md (filename + heading onl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
    [comparator.sch]
2026-08-04 docs(spec): re-point Input-structure R_on row at DR-0014's T-gate-array path (DR-0016) (#79)
    Renumber the record from DR-0015 to DR-0016 to avoid colliding with
    DR-0015-comparator-topology.md, which landed on main via PR #78 (issue #74)
    while this PR was open. Updates the record's own heading, its filename, and
    the README.md#target-specification citation link. Rebased onto current main.
2026-08-04 fix(layout): build the MiM cap stack outward from the ratified plate (#82)
    * fix(layout): build the MiM stack outward from the ratified plate, making it DRC-clean and extractable
    The unit capacitor was drawn with cw/cl taken as the Metal4 bottom-plate
    size and FuseTop derived by insetting it, capped at 0.3 um. That is
    backwards: cw/cl are the PDK device's c_width/c_length, i.e. the FuseTop
    plate. The construction drew a plate 0.6 um smaller than the ratified
    device on every side and could not satisfy mim.enclosing.fusetop.1
    (MIMTM.3, 0.6 um) at any size.
    draw_mim_cap() now takes the plate as the input and derives Metal4 from
    the rule, with an opt-in device mode that draws CAP_MK/MIM_L_MK p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
    [gen_adc_cells.py, gen_adc_top.py, run_lvs.py, test_layout_centroid_tiling.py]
2026-08-04 docs(spec): record adc-top area overrun as irrecoverable at legal MiM geometry; propose DR-0017 (#83)
    Issue #70's legal MiM stack (ratified C_u = 17.24 fF / 2.7136 um plate with
    MIMTM.1/MIMTM.3 enclosure) tiles the CDAC unit at 5.1136 um and pushed
    adc_block to 0.12100 mm^2, 121% of the ratified < 0.1 mm^2 DR-0006 target.
    Issue #80 asked whether a legal floorplan pass could recover it. It cannot,
    and the result is now reproducible and recorded rather than dialled away:
    - layout/adc-top/area_feasibility.py: rebuilds the block in-memory at every
    legal CDAC aspect ratio (shipped 32x16 is the minimum; all others worse)
    and reports the irreducible packing floor bank_w x block_h = 440.94 x 2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
    [area_feasibility.py]
2026-08-05 feat(layout): wire the CDAC array's within-array per-weight bottom plate (#87)
    * feat(layout): wire the CDAC array's within-array per-weight bottom plate
    Draw the per-weight bottom-plate interconnect entirely inside each
    ADC_CDAC_ARRAY_{P,N} cell (issue #85, Part 1 of #81), and mark every real
    unit as a recognised MiM device:
    - draw_cdac_array() now draws, per side: one full-width Metal1 "row trunk"
    per (row, weight-present-in-row) placed just below the row and marching
    downward by TRUNK_PITCH (a row uses at most six of the ten weights); one
    Via3/Via2/Via1 riser per real unit via geometry.draw_mim_bottom_riser()
    (unchanged) onto its own trunk; and one vertical Metal2 spine per weig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
    [gen_adc_top.py]
2026-08-05 feat(layout): route the CDAC arrays' plates to the decode banks and topp/topn (#88)
    * feat(layout): route the CDAC arrays' plates out to the decode banks and topp/topn
    Completes issue #81's per-weight bottom-plate interconnect. Issue #85 left
    each ADC_CDAC_ARRAY_{P,N} electrically self-contained -- 512 real units per
    side on one floating Metal5 top-plate mesh and ten floating Metal2 per-weight
    spines -- so `klt extract` reported 22 unnamed nets and `klt lvs` could not
    compare the capacitors at all. This joins all 22 to the nets
    design/adc-top/adc_top.spice names:
    - every per-weight spine now runs down to the array cell's own bottom edge
    (SPINE_EXIT_Y), so all ten exit at one known Y inst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
    [gen_adc_top.py]
2026-08-05 feat(layout): bind adc-top parasitic extraction to gf180mcu PDK models, find the PMOS-body resimulation gap (#90)
    * feat(layout): extract adc-top parasitics and record the netlist as evidence
    Stand up the parasitic-extraction step for the DR-0014 adc-top block as
    reproducible, append-only evidence -- the parasitic-extraction half of the
    flow layout/lvs/ stood up for LVS, with klt extract --parasitics turned on.
    layout/adc-top/parasitics/run_extract_parasitics.py runs klt extract
    --parasitics live against the committed adc_top.gds / adc_block.gds, asserts
    each block's structured summary (device/net/pin counts, per-class device
    tally, and that the parasitics RC block populated) against cells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
2026-08-05 feat(layout): remediate extracted PMOS body/input-rail nets, verify DC bias over PVT (#92)
    * feat(layout): make the extracted adc-top core simulatable (PMOS body->vdd, input-rail pins) and verify DC over PVT
    Post-process the `--pdk gf180mcuD` extraction of `adc_top` into a well-posed,
    simulatable ADC core, closing the pre-work #89 needs before any bench can run
    against a physical extracted netlist, and verify it with a DC operating point
    across the full #13 `cdac` PVT grid. No ADC spec-line claim is made here; the
    transient bench, Monte Carlo and delta summary (Scope items 1-5) remain
    deferred.
    The three judgment calls the issue required, made with provenance (record
    layout/adc-top/parasit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
    [remediate_extracted.py, verify_remediation_dc.py]
2026-08-05 feat(layout): wire the extracted ADC_TOP core into a schematic-comparator/SAR conversion chain (#93)
    Adds gen_extracted_core_tb.py, a dedicated harness (issue #89 Scope item 0)
    that wires the PMOS-body-remediated, MiM-mapped extracted ADC_TOP core
    (remediate_extracted.py, PR #92) into a complete SAR conversion chain: the
    schematic comparator, rung-1 SAR controller, and DR-0013 input drive network
    stay schematic-level, per the issue's own wording. _wire_pin() maps every one
    of ADC_TOP's 65 pins onto the same net names design/sar-logic/gen_sar_logic.py's
    own _ports_ctrl_analog() convention already uses, so the controller's output
    nets connect directly with no renaming layer.
    verify_extracted_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
    [gen_extracted_core_tb.py, verify_extracted_core_conversion.py]
2026-08-05 feat(layout): draw the DR-0014 fourth-leg input pin (pinp/pinn) on adc_top/adc_block (#94)
    Root-caused as label-only: the fourth-leg input rail (design/adc-top's
    adc_cdac_side.vin) was already correctly routed into one continuous
    per-side Metal1 trunk in the decode bank, exactly like sel_in/vref/vcm/vss
    -- the pin label draw call was simply missing from that bank's pins= list.
    gen_adc_top.py now labels it pinp/pinn (matching lib/netlist.py's existing
    LVS-reference port names), with no routing change.
    A raw `klt extract` (no remediate_extracted.py post-processing) now
    declares pinp/pinn directly: pin_count 63->65 (ADC_TOP), 67->69
    (ADC_BLOCK); klt lvs/klt drc unaffected (device/net counts an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
    [gen_adc_top.py, remediate_extracted.py, verify_layout_pin_dc.py]
2026-08-05 feat(parasitics): measure extracted-core gain_err_lsb vs schematic over full PVT (#96)
    Add `measure_extracted_gain_err.py`, the first real spec-line-quantity
    measurement against the parasitic-extracted, PMOS-body-remediated ADC_TOP
    core: it drives the two endpoint transitions (1, 1023) through the extracted
    core wired to the schematic comparator + rung-1 SAR controller (issue #89
    Scope item 0 harness) and reports `gain_err_lsb` by the SAME
    endpoint-extrapolation formula sim/adc-inl-dnl/'s inl_manifest() uses, so the
    number is directly comparable to that bench's schematic column corner-for-corner.
    Records the result over the full 45-point mos PVT grid (5 process x 3 temp x 3
    supply, 0 non-co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
    [measure_extracted_gain_err.py, verify_extracted_core_conversion.py]
2026-08-05 feat(sim): re-run #13 static linearity over PVT against the extracted core (#97)
    * feat(sim): run one manifest's measure/check deck against an alternate (extracted) netlist
    Adds `run_corners.py --netlist PATH --netlist-provenance TEXT`, so a
    post-layout extracted core can be measured by the SAME manifest -- same
    claim, same analyses, same measure expressions, same checks -- that
    produced the schematic-level record, rather than by a hand-duplicated
    copy of it that can silently drift.
    - `sim/harness/testbench.py`: `Testbench.netlist_provenance` ("schematic"
    default, or a string starting with "extracted"), read from tb.json,
    validated on load, carried into `provenance()`.
    - `sim/harness/r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
    [gen_extracted_inl_dnl_tb.py, test_harness.py, test_schematic_vs_extracted.py]
2026-08-05 feat(sim): generate the schematic cdac-corner-set INL/DNL baseline (#89 Scope item 7) (#100)
    Issue #89 Scope item 7 needs a schematic-vs-extracted gain/linearity delta
    over the cdac corner set (tt, cap_ff, cap_ss, mim_ff, mim_ss, moscap_ff,
    moscap_ss) -- but no schematic baseline existed at those corners, only the
    mos set's tt/ff/ss slice (record 20260802-141402-1224e11). This lands that
    missing baseline: record 20260805-220405-bff6eaf runs tb.json's own default
    cdac corner set unmodified, 63/63 points PASS, worst gain_err_lsb -2.00234
    LSB (cap_ff_-40c_3.63v) -- consistent with the mos-set baseline's tt-corner
    values to full precision (the two records agree exactly on all 9 shared tt
    corners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
2026-08-05 feat(sim): close the extracted-core gain-error disagreement with a null control, and run the Monte Carlo half of #89 Scope item 2 (#99)
    * feat(parasitics): extracted-core Monte Carlo + a gain-error settling probe
    Rebuilt on top of PR #97, which landed the #13 INL/DNL PVT re-run against the
    extracted core, the --netlist/--netlist-provenance harness flag pair, the
    extracted-core INL/DNL deck generator, schematic_vs_extracted.py and
    sim/extracted-delta-summary.md. All of that is dropped from this branch -- #97
    already provides it, and the two implementations agreed to 3-4 significant
    figures. What is layered here is only what #97 does not have.
    - mc_extracted_core.py: the #89 Scope-item-2 pro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
    [schematic-ff_125c_3.63v.json, schematic-ss_-40c_2.97v.json, schematic-tt_27c_2.97v.json]
2026-08-05 feat(sim): add a schematic-core control to the bespoke gain_err_lsb deck (#101)
    Wires design/adc-top/gen_adc_top.py's _core() into
    measure_extracted_gain_err.py behind a new --core {extracted,schematic}
    flag, reusing the existing 2-endpoint stimulus and error-node
    instrumentation unchanged, to test whether the bespoke deck's own
    methodology (not a real parasitic effect) explains the -0.55 LSB
    extracted-vs-schematic gain_err_lsb delta record 20260805-163000-e8017f2
    reported.
    A 27-corner run (tt/ff/ss x -40/27/125C x 2.97/3.30/3.63V) against the
    schematic core reads mean -2.5545 LSB -- reproducing the extracted-core
    reading (-2.5572 LSB) to within +0.0027 LSB and disagreeing with the
    schemati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
    [measure_extracted_gain_err.py]
2026-08-06 feat(sim): close #89 Scope item 7's extracted-side cdac corner-set run (#102)
    - mc_extracted_core.py: the #89 Scope-item-2 probe. Runs a real MOS-mismatch
    population of full transist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
2026-08-06 feat(sim): close the ENOB/FFT/SFDR extracted-core re-run (issue #89 Scope item 1) (#103)
    Ports design/adc-top/gen_adc_top.py's fft_netlist() onto the
    PMOS-body-remediated, MiM-mapped extracted ADC_TOP core
    (layout/adc-top/parasitics/gen_extracted_enob_fft_tb.py), the same pattern
    gen_extracted_inl_dnl_tb.py already established for static linearity, and
    reuses gen_extracted_core_tb.shadow_dac_and_error(gated=True) directly for
    the gated ideal-shadow error node rather than re-deriving it a third time.
    Runs sim/adc-enob-fft/testbench/tb.json UNMODIFIED against the extracted
    netlist over the same 9-point tt/ss/ff x 125C x 3-supply grid the
    schematic baseline itself uses (the two-stage corner st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
    [gen_extracted_enob_fft_tb.py]
2026-08-06 feat(layout): wire ADC_BLOCK's baked-in comparator, find a reproducible functional FAIL (#106)
    * feat(layout): wire ADC_BLOCK's baked-in comparator for the extracted core harness
    Extends gen_extracted_core_tb.py's --top choice to ADC_BLOCK (the
    comparator-inclusive extraction named as remaining work in
    sim/extracted-delta-summary.md Sec6.4 / issue #89 Scope item 2's
    comparator-inclusive follow-up): dout/doutb/ibias/cmpclk pins are wired
    directly onto the controller instead of instantiating a second,
    redundant schematic comparator. verify_extracted_core_conversion.py's
    --top gains the matching choice.
    Part of #89
    * test(layout): ADC_BLOCK comparator-inclusive smoke test FAILs, reproducibly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
    [gen_extracted_core_tb.py, verify_extracted_core_conversion.py]
2026-08-06 feat(sim): close #89 delta-summary Sec 6.2 -- the extracted-core power re-run, four-way supply split (#108)
    * feat(sim): add an extracted-core power deck with a stated four-way supply split
    Ports design/adc-top/gen_adc_top.py's power_netlist() onto the
    PMOS-body-remediated, MiM-mapped extracted ADC_TOP core, on the same
    "extracted core, schematic everything-else" pattern gen_extracted_inl_dnl_tb.py
    and gen_extracted_enob_fft_tb.py already use, so that
    sim/adc-power/testbench/tb.json runs UNMODIFIED against it.
    The one thing that does not port mechanically -- the reason
    sim/extracted-delta-summary.md Sec 6.2 called this deck a methodology task
    rather than a re-run -- is the per-block supply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
2026-08-06 docs(sim): find the #89 §6.3 rate-closure/gain-error blocker is structural, not a missing deck (#110)
    sim/dr0014-sampling/ instantiates adc_cdac_side as a bare leaf subckt
    (ten-plus isolated probes), and adc_cdac_side was never drawn or extracted
    as its own GDS -- only the flat ADC_TOP/ADC_BLOCK boundary exists, so there
    is no extracted netlist to wire in place of those probes the way the three
    closed §6.1/6.2 decks swapped in the whole flat core. sim/timing-budget-closure/
    is a fully synthesized rung-1 composition with no netlist at all; two of its
    three input constants trace back to the same adc_cdac_side gap and the third
    (comparator regeneration delay) needs the ADC_BLOCK core §6.4 al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
2026-08-06 feat(sim): extract the drawn T-gate leaf and measure the post-layout R_on delta as zero, with the reason (#111)
    * feat(layout): extract the adc_tgate leaf cell and audit the parasitic topology
    Adds the extraction plumbing the post-layout switch-R_on re-take needs, which
    sim/extracted-delta-summary.md Sec 6.3 named as the one piece of its blocked
    scope that is tractable without drawing new geometry:
    - cells.json gains an `adc_tgate` LEAF target (2 devices, 5 pins, 4 parasitic
    RC pairs), so run_extract_parasitics.py asserts the drawn transmission gate's
    extraction the same way it asserts the two whole blocks.
    - remediate_extracted.py gains remediate_leaf(): a leaf cell has no supply pin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
2026-08-06 feat(sim): extracted-core dr0014-sampling re-run measures the DR-0012/13 gain-error row PASS (issue #89 Sec 6.3) (#113)
    * fix(sim): record links use the testbench's own directory, not a hardcoded one
    sim/harness/report.py hardcoded TESTBENCH_DIR ("testbench") into every
    rendered record's Netlist provenance and Links lines, so a manifest loaded
    from any other directory name (e.g. a second, differently-scoped tb.json
    sitting next to the schematic deck's own testbench/, the pattern issue #89
    Sec 6.3's extracted-core dr0014-sampling deck needs) produced a broken link
    that never resolves to a real file. Use the testbench's own provenance()
    directory name instead.
    * feat(sim): extracted-core dec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
    [gen_extracted_dr0014_sampling_tb.py, test_harness.py]
2026-08-06 docs(sim): verify #17's acceptance criteria, find AC7 (post-layout edge-case re-check) unresolved (#117)
    * docs: record the #17/#89 extracted-netlist re-run as complete in README
    The root README's Status table still described the post-layout extracted
    re-run as "partially done" with ENOB/SFDR/power "not yet done" -- stale
    since #89 (PR #90, #92-#113) closed every remaining #13/#14 slice against
    the parasitic-extracted CDAC core: static linearity (27-point mos grid +
    63-point cdac corner-set isolation), ENOB/FFT/SFDR (9-point grid), power
    (27-point grid), the DR-0012/13 gain-error row, and both halves of the
    Monte Carlo question, all documented per-line in sim/extracted-delta-summary.md.
    Up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
2026-08-06 Post-layout re-check of #17's AC7: settling/rate closure measured, regen margin blocked on klayout-tools#595 (#119)
    * fix(layout): connect the comparator's differential input pair to the CDAC top plates
    `gen_comparator.build_into()` resolved `comparator.spice`'s `Vpp`/`Vpn`
    zero-volt input probes into net aliases without passing `prefer=`, so
    `nl.resolve_aliases()` fell back to "lexicographically smallest name wins"
    -- and `preamp_in1` < `vinp`, `XCMP.preamp_in1` < `topp`. The merged net was
    therefore named after the INTERNAL node, the cell labelled and routed a
    `vinp`/`topp` trunk no device sat on, and the preamp's differential pair
    gates were left on a net with exactly one terminal: float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
    [audit_parasitic_topology.py, gen_comparator.py, gen_extracted_timing_budget_tb.py, probe_comparator_load_short.py, remediate_extracted.py, run_lvs.py, test_parasitic_topology_audit.py]
2026-08-07 feat(layout): draw SAB/RES_MK/Resistor markers so the comparator's poly load resistors extract as devices (#121)
    * feat(layout): draw SAB/RES_MK/Resistor markers so the comparator's poly load resistors extract as devices (issue #118)
    Extends draw_poly_resistor() to draw SAB (49/0) + RES_MK (110/5) +
    Resistor (62/0) over each load-resistor body, so klt extract's gf180mcu
    deck recognises them as real devices instead of an unmarked Poly2 short
    that collapsed pop/pon onto vdd in the extracted comparator/adc_block.
    Deck limitation found and worked around: the pinned klt commit can only
    select ppolyf_u_1k (1000 ohm/sq), not the schematic's original
    ppolyf_u_2k (2000 ohm/sq) -- upstream klayout-t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
    [comparator.sch]
2026-08-07 docs(sim): reword stale post-#118 'ADC_BLOCK does not convert' narrative (#129)
    layout/adc-top/parasitics/gen_extracted_timing_budget_tb.py's docstring and
    generated testbench header comment, and layout/README.md's klayout-tools#595
    friction-log row, still described the pre-#118 state (ppolyf_u_2k loads
    shorting, ADC_BLOCK failing to convert). PR #121 (issue #118) fixed the
    underlying gap and updated most files but missed these two. Reword both to
    match the post-#118 state already established in
    sim/extracted-delta-summary.md §6.4: ADC_BLOCK converts; the remaining gap
    is klayout-tools#595's sheet-rho selection (still open) and the
    comparator-inclusive Monte Carlo/regeneration campaign (iss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
    [gen_extracted_timing_budget_tb.py]
2026-08-07 Rebuild the three extracted ADC decks on the in-path extraction, re-run INL/DNL, ENOB and power, and guard --check in CI (#130)
    * feat(sim): rebuild the four extracted decks on the star-split in-path extraction and guard --check in CI
    The three `sim/adc-*` post-layout decks still embedded the pre-`875eac3`
    extraction (156 R on `adc_top`, all of it dead-end stubs carrying no signal
    current). PR #119 bumped `layout/toolchain.json` to `875eac3`, landing
    `klayout-tools#593`'s star-topology in-path parasitic resistance, and
    `remediate_extracted._latest_report()` picked the new report up
    automatically -- but the decks are only rewritten when their generator is
    run, so all three kept emitting the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
2026-08-07 test(sim): re-run INL/DNL on the in-path extraction's mos grid, re-base §3 (#135)
    Issue #123's in-path re-take (PR #130) re-ran static linearity on the
    manifest's default 63-point `cdac` corner set only. The 27-point `mos`
    (tt/ss/ff) grid that sim/extracted-delta-summary.md §3's INL and DNL
    cells actually cite, record 20260805-203322-3b6d7b7, stayed on the
    pre-in-path lumped-stub extraction because the two grids are not
    nested (cdac skews capacitor families with MOS held typical; mos does
    the reverse).
    Re-run tb_adc_inl_dnl_extracted.spice on the same 875eac3-pin in-path
    extraction at its own 27-point tt/ss/ff grid: new record
    20260807-081223-6bd9d80, 27/27 PASS, Supersedes 3b6d7b7. -j 8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
2026-08-07 Re-derive adc-power's process-axis floor for the post-layout DUT (DR-0018) (#136)
    * fix(spec): re-derive adc-power's process-axis floor for the post-layout DUT (DR-0018)
    sim/adc-power/records/20260807-060526-03e80b9's harness verdict is FAIL on
    a single bench health-check: p_cmp_f050_uw's process-axis
    min_spread_pct_by_axis witness reads 2.506% against an undocumented 3%
    floor, even though the ratified p_total_* < 1 mW row passes with 4.5x
    margin. Issue #107 (the standing investigation into the related
    comparator-current excursion) is still open with no landed mechanism
    finding, so per #133's own scoping this re-derives the floor rather than
    duplicating #107's diagnostic charter.
    Reworking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
    [gen_adc_top.py]
2026-08-07 Independently replicate the in-path post-layout re-runs; the one-corner comparator excursion does not reproduce (#137)
    * test(sim): land a second, independently-run campaign on the same in-path extraction
    Three records from a campaign that ran concurrently with the one PR #130
    merged, against the same extraction report (20260806-230838-56be937, sha256
    db800c70...) and the same three grids, by an agent that did not know the
    other campaign existed. Append-only per sim/README.md: nothing is replaced,
    and both campaigns' records now sit side by side.
    20260807-041111-ccf1f9b INL/DNL, 63 pt cdac set, 63/63 PASS, 4343 s
    20260807-052432-eac5d11 ENOB/FFT, 9 pt two-stage, 9/9 PASS, 3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
2026-08-07 Give the last two extracted decks the .save treatment, re-run both claims, and guard all six generators in CI (#138)
    * test(sim): guard the last two extracted-deck generators against drift
    test_extracted_decks_current.py's GENERATORS table covered four of the six
    gen_extracted_*_tb.py generators; dr0014_sampling and timing_budget were the
    "silent gap" the table's own comment warns about -- the next
    layout/toolchain.json pin bump could have drifted their committed decks a full
    extraction generation with nothing calling --check.
    Both decks are already in sync with the report remediate_extracted._latest_report()
    selects (20260806-230838-56be937), so this is a no-op on the tree: the suite
    stay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
    [gen_extracted_core_tb.py, gen_extracted_dr0014_sampling_tb.py, gen_extracted_timing_budget_tb.py, test_extracted_decks_current.py]
2026-08-07 diag(power): name the tt_125c_3.63v comparator-current mechanism, bound the grid (#107) (#114)
    Extends probe_power_cmp_anomaly.py with per-bit-cycle comparator-output
    transition counting and top-plate differential/common-mode instrumentation
    (--waveform) plus a fine full-scale-level sweep (--levels), reproduces the
    known extracted-vs-schematic current split, and uses the new instruments to
    find the mechanism: cmpclk free-runs every bit cycle including the
    DR-0014 acquisition window, and the extracted core's residual crosses the
    comparator's noise floor one bit cycle later than the schematic core's (bit
    cycle 3, the first undamped cycle after the top-plate switch opens, vs bit
    cycle 2, still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
    [probe_power_cmp_anomaly.py]
2026-08-10 chore(repo-skills): update installed Repo Skills to 0.10.0
    Rolled straight to main rather than via a per-repo branch. The 0.8.1 rollout
    used branch-per-repo and seven of those branches were abandoned mid-flight,
    leaving their repos parked off trunk for days — and invisible, because
    compute-drift.sh's axis 3 compares a checkout against its OWN branch, so a
    repo current with a stale branch reports clean (2AMLogic/2am#209). An
    installed-tool refresh is mechanical, already-reviewed content, so a direct
    commit removes that abandonment failure mode entirely.
    This host's fleet spanned 0.6.1 to 0.8.1 before this pass, against a 0.10.0
    source — see 2AMLogic/2am#216.
2026-08-11 refactor(layout): remove unused bbox_of() helper from geometry.py (#144)
    bbox_of() was a one-line wrapper around cell.bbox() with no callers
    anywhere in the repo and no test coverage. Deleted it to reduce dead
    surface area in layout/adc-top/lib/geometry.py.
2026-08-11 refactor(layout): extract shared klt_env module from run_drc.py/run_lvs.py (#146)
    layout/drc/run_drc.py and layout/lvs/run_lvs.py carried byte-identical
    copies of ToolingError, the exit-code constants, find_klt(),
    check_klt_capabilities(), and find_klayout_python(). Move them into a
    new layout/klt_env.py, following toolchain_pin.py's existing
    shared-module convention, so both runners fail the same way when the
    environment drifts instead of risking silent divergence on the next
    edit.
    Closes #145
    [run_lvs.py]
2026-08-11 fix(layout): wire up geo.assert_no_bar_shorts as a real cross-block Metal1-short check (#148)
    `switch`'s and `COMPARATOR`'s topp/topn near-corridor bars, and
    banks/COMPARATOR's vdd/vss far-corridor bars, are now collected as
    they're extended toward their shared stitch corridors and re-checked
    against geo.assert_no_bar_shorts before the block is finished. Neither
    Channel.extend_drawn (per-channel only) nor geo.stitch (Comp/Poly2
    crossings only) can see a different block's channel landing on the
    same Metal1 track, so this closes the exact gap the historical
    switch/vss vs. COMPARATOR/topn incident (documented above this code)
    exploited, undetected until klt lvs flagged the merge.
    Verified the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
    [gen_adc_top.py]
2026-08-14 fix(sim): close device-switch-ron's clean-tree citability gap and repoint rate-closure R_on provenance (#153)
    * feat(sim): clean-tree re-take closes device-switch-ron's citability gap, re-derives PR #120's R_on claim as fully covered
    Adds a clean-tree device-switch-ron record (45/45 corners, bit-identical to
    the dirty-tree 20260806-194322-68ad582) and documents the written
    determination in sim/extracted-delta-summary.md §4.8/§6.4: PR #130 minted no
    new switch-ron record (its own deck only moved a provenance comment), the
    actual +13.57% post-layout R_WORST_BIT_OHM re-measurement PR #120 claimed was
    already merged one day earlier via PR #119, gen_extracted_switch_ron_tb.py
    targets the extra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
    [gen_extracted_timing_budget_tb.py]
2026-08-15 feat(sim): measure post-layout comparator regeneration margin, close #12's rate closure (#154)
    Issue #116 AC2: worst-corner comparator regeneration margin measured
    against the extracted, comparator-inclusive ADC_BLOCK core (45-point PVT
    grid, all ratified checks PASS). A new measurement script
    (layout/adc-top/parasitics/measure_extracted_regeneration.py) drives one
    Xdut ADC_BLOCK instance sequentially through #9's overdrive ladder,
    forcing topp/topn directly and referring the ladder to the extracted
    core's own measured systematic offset (-0.6..-4.4 mV across the grid) --
    a real, deterministic post-layout finding a 0V-referenced ladder cannot
    resolve.
    T_COMP_REGEN_NS moves 0.863 -> 1.257 ns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
    [gen_extracted_timing_budget_tb.py, measure_extracted_regeneration.py]
2026-08-15 refactor(layout): move git/sha256/klayout_version/load_manifest/record_id into klt_env (#156)
    `layout/drc/run_drc.py` and `layout/lvs/run_lvs.py` carried byte-identical
    copies of five provenance helpers that decide what a recorded number means
    -- which interpreter's `klayout` package got stamped, which commit a record
    claims, which bytes were hashed, how a record is named. Two forks of that
    let one runner's evidence drift from the other's under the same repo state,
    which is the same argument `klt_env.py` was created for in #146.
    Both runners now import the five names from `klt_env`; the local defs are
    gone. Two of them close over a caller-specific module constant, so they take
    it as a param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
    [run_lvs.py]
2026-08-15 refactor(layout): migrate run_extract_parasitics.py onto shared klt_env.py (#161)
    layout/drc/run_drc.py and layout/lvs/run_lvs.py already consume
    klt_env.ToolingError/find_klt/check_klt_capabilities (#146). This runner
    still carried a hand-rolled ToolingError and _require_klt() that
    reimplemented the same probe with drifted error-message wording; drop
    both and import the shared implementation instead, so all three runners
    report the same klt-missing/klt-incomplete diagnosis.
    Closes #159
    [run_extract_parasitics.py]
2026-08-15 docs(sim): reconcile the schematic-vs-extracted SFDR gap at ss_125c_2.97v (#152)
    * docs(sim): reconcile the schematic-vs-extracted SFDR gap at ss_125c_2.97v
    Issue #151 tests, rather than assumes, why the in-path-extracted ADC_TOP
    core measures better SFDR (64.38 dB worst-of-grid) than the schematic
    baseline (61.33 dB) at ss_125c_2.97v, the one corner the schematic FAILs:
    - Baseline staleness: REFUTED. A fresh single-corner re-run at
    ss_125c_2.97v against current design/adc-top/gen_adc_top.py sources
    (new record 20260814-193205-f613571, Supersedes: 20260802-141402-1224e11)
    reproduces the 2026-08-02 baseline's decoded codes and measures
    SFDR = 61.3317 dB, matching 61.33 dB. gen_adc_t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
2026-08-15 refactor: remove three unused helpers (is_comment, klayout_dir, riser_x) (#163)
    Card.is_comment, Pdk.klayout_dir, and Mosfet.riser_x each have zero
    callers anywhere in the repo, confirmed via AST dead-code sweep and a
    full-repo grep (including .loom/worktrees/). Mosfet.riser_x follows the
    same dead-helper pattern as bbox_of(), already removed in #144.
    Closes #160
2026-08-15 refactor(layout): extract shared PVT-preamble helper for six extracted-core probes (#164)
    Six `compose_deck()` functions under layout/adc-top/parasitics/ each
    hand-typed the identical `.param vdd_val=` / `.include` / `.lib` corner
    loop / `.temp` block. That copy-paste already caused one real bug (the
    BUGFIX note in verify_extracted_core_conversion.py: an earlier copy
    accepted temp_c but never emitted `.temp`, so PVT spot-checks silently
    ran at ngspice's default 27C) and had to be independently re-fixed in
    measure_extracted_gain_err.py.
    Add pvt_includes() / pvt_temp_line() / pvt_preamble() to
    gen_extracted_core_tb.py and call them from all six sites instead.
    The include/temp halves are split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
    [gen_extracted_core_tb.py, mc_extracted_core.py, measure_extracted_gain_err.py, probe_comparator_load_short.py, probe_gain_err_settling.py, probe_power_cmp_anomaly.py, verify_extracted_core_conversion.py]
2026-08-15 fix(layout): apply shared PVT preamble to verify_layout_pin_dc.py / verify_remediation_dc.py (#166)
    Both compose_dc_deck()s hand-rolled the same .param/.include/.lib
    corner-loop pattern PR #164 (issue #162) already deduplicated across
    six sibling files -- and, unlike those six, never emitted a .temp
    line at all, so every op silently ran at ngspice's default 27C
    regardless of the requested corner temperature.
    Import gen_extracted_core_tb (same directory, same pattern nine other
    files here already use) and replace the hand-typed preamble with
    pvt_includes(pdk, corner, vdd) + pvt_temp_line(temp_c), adding the
    missing .temp directive. Verified the generated deck text carries the
    new .temp line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
    [verify_layout_pin_dc.py, verify_remediation_dc.py]
2026-08-15 refactor(layout): dedupe append-only record-slot guard into klt_env.py (#168)
    run_drc.py and run_lvs.py's write_record() each carried a byte-identical
    8-line block that guards a record id against overwrite and creates the
    report directory. Extract it into klt_env.reserve_record_slot(), following
    the same "runner passes its own path constants" convention as record_id()
    and load_manifest(). Pure refactor -- no behavior change, verified with a
    collision test against the new helper.
    [run_lvs.py]
2026-08-16 docs: record the #169 T1-failing-items decomposition (issue #170) (#175)
    Filed four new issues from #169's closing verdict table (#171 operator
    decision on the DR-0004 digital-device-flavor conflict blocking items
    1/2/5; #172 item 6 statistical evidence; #173 item 7 klt-pex pin bump;
    #174 item 8 characterization-report consolidation). This triage record
    documents the grouping/routing rationale so it's not only in issue
    threads.
    Closes #170
2026-08-16 feat(sim): klt-yield evidence for the Gain-error-mismatch, Offset-error and CMRR rows (T1 item 6) (#182)
    * feat(sim): add klt-yield evidence for the CDAC gain-error mismatch row
    Extends mc_cdac_mismatch.py to emit a gain_error_lsb column (total-array
    1/sqrt(1024) mismatch, spec/cdac-sizing-memo.md S5.2), re-derives the
    existing nominal campaign bit-for-bit plus a fresh 3x-sigma negative
    control, and reformats both into klt yield format
    (sim/mc-cdac-mismatch/yield-evidence/). The measured result (2.12 sigma vs
    the ratified 3 sigma target) genuinely misses README note [e]'s 0.5 LSB
    figure, which turns out to have been a generic-array ceiling rather than
    the chosen design's actual sigma_u -- r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
    [trials_n20000.csv, trials_n2000_3xsigma.csv]
2026-08-16 Run klt pex for T1 item 7 evidence; document the blocked pin bump (#173) (#184)
    * feat(layout): run klt pex against COMPARATOR for T1 item 7 evidence (#173)
    Installs klt pex (klayout-tools epic #709, shipped after this repo's
    production toolchain pin was cut) and runs it for real against the
    post-layout COMPARATOR block. It fails structurally -- klt pex's
    single-`.include` DUT-swap mechanism requires the schematic and
    extracted netlists to share one identical top-level `.subckt` interface,
    which klt extract's promoted body/tap/internal nets never satisfy here
    -- a concrete, tool-verified blocker (filed as
    klayout-tools#1030) rather than "N/A by construction". Evidence
    committed as an append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
    [run_lvs.py, run_pex_comparator.py]
2026-08-16 docs: consolidate the characterization report and fix the README/extracted-delta-summary sync lag (T1 item 8) (#186)
    Adds sim/characterization-summary.md as the single, dated, aggregated
    per-spec-row full-ADC characterization artifact -- every README target-spec
    row's latest verified value, verdict, and citation to its source record, in
    one place, with an explicit "Freshness" section stating the commit and date
    it was built against.
    Fixes README.md's Status paragraph and Verification-suite table row, which
    still said "the last of rate closure's three inputs still depend[s]" on a
    comparator-inclusive ADC_BLOCK extraction -- a one-PR sync lag against
    sim/extracted-delta-summary.md's and sim/i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
2026-08-16 refactor(sim): reuse report._fmt in cli.py instead of a duplicate copy (#188)
    sim/harness/cli.py carried its own `_fmt()` whose body was byte-identical
    to the one in sim/harness/report.py (report.py's copy additionally has a
    one-line docstring). Two forks of the same scalar-formatting helper in the
    same package means a future change -- tightening the exponent thresholds,
    handling nan/inf -- has to be remembered twice.
    Delete the cli.py copy and point its call sites at report._fmt. cli.py
    already does `from . import report`, so no new import is needed. report.py
    is unchanged: it is already the natural shared home, alongside its other
    package-private helpers.
    Three call sites are reflowed ac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
2026-08-16 refactor: dedupe run_op()/_ISUP/NGSPICE into gen_extracted_core_tb.py (#191)
    * refactor(layout): dedupe run_op()/_ISUP into gen_extracted_core_tb.py
    verify_remediation_dc.py and verify_layout_pin_dc.py each defined a
    byte-identical run_op() (and its backing _ISUP regex) for driving an
    ngspice DC op and parsing the printed isupply value, including the
    identical trailing-transient-op false-FAIL guard. Both files already
    import gen_extracted_core_tb as G, so move the shared helper there
    (alongside pvt_includes/pvt_temp_line's existing precedent) and call
    G.run_op() from both sites instead of maintaining two hand-synced
    copies. Pure refactor -- run_op()'s body is unchanged, so (ok, isup,
    out) i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
    [gen_extracted_core_tb.py, verify_layout_pin_dc.py, verify_remediation_dc.py]
2026-08-16 refactor(layout): drop the duplicate shadow-DAC emitter from gen_extracted_inl_dnl_tb.py (#192)
    `gen_extracted_inl_dnl_tb._shadow_dac_lines()` was a hand-copied second
    emitter of the ideal-shadow-DAC / error-node SPICE block that
    `gen_extracted_core_tb.shadow_dac_and_error()` already emits -- the same
    formula kept correct in two places by hand, the exact shape of duplication
    that silently dropped `.temp` from a PVT preamble before #164.
    Delete the local copy and call `G.shadow_dac_and_error(tag=TAG, gated=True)`
    instead; `gated=True` was already the parametrisation that emits the
    strobe-gated `|err|` node the #13 manifest reads, so no new code path is
    introduced. The decoded-output-code cav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
    [gen_extracted_core_tb.py, gen_extracted_inl_dnl_tb.py]
2026-08-16 spec(cdac): resize the unit cap to close the gain-error 2.12σ gap (DR-0019) (#193)
    * spec(cdac): re-derive gain-error mismatch coefficient, resize C_u to close the 2.12σ gap
    Adds spec/cdac-sizing-memo.md §3.6, deriving the gain-error mismatch
    requirement (σ(gain error) = 32·σ_u LSB, a total-array-capacitance sum
    that gets no benefit from DR-0011's free-MSB relief) as the true binding
    constraint on σ_u -- tighter than the DNL/INL coefficient the unit cap was
    actually sized against. Records the resizing decision in DR-0019
    (C_u: 17.24 fF -> 35.6528 fF, σ_u: 0.7372% -> 0.5000%), verified against the
    standalone Monte Carlo mismatch model: klt yield status pass, sigma_to_spec
    3.13 (sim/m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
    [trials_n20000.csv, trials_n2000_3xsigma.csv]
2026-08-16 refactor(layout): dedupe compose_dc_deck() DC-op deck boilerplate (#201)
    Add gen_extracted_core_tb.compose_dc_op_deck(), a shared builder for the
    DC-op verification deck shape verify_layout_pin_dc.py and
    verify_remediation_dc.py each hand-rolled: the PVT preamble, .include,
    per-pin V<pin> loop, Xdut instantiation, and .control block. Both
    compose_dc_deck() functions become thin wrappers passing their own bias
    function, header comment lines, isupply source, and trailing lines.
2026-08-16 layout: bump klt pin past 875eac3 (85b8125) and re-baseline drc/lvs/extract manifests (#195)
    * layout: bump klt pin past 875eac3 (85b8125) and re-baseline drc/lvs/extract manifests
    Deferred from #173: bumps layout/toolchain.json's klt pin from 875eac3
    to 85b8125 (upstream main HEAD, re-verified live, 17 commits ahead of
    #173's 755d3ef / 0 behind), and re-baselines everything the bump moves.
    Direct verification found the #173 paragraph's own claim ("every
    committed .spice snapshot goes stale") does not hold: none of the ten
    committed LVS .spice snapshots changed a single byte (klt extract's new
    AS/AD/PS/PD junction params land only on --pdk-bound X cards, and
    run_lvs.py never passes --pdk).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
2026-08-17 layout(adc-top): physically implement DR-0019 unit-cap resize (17.24 fF -> 35.6528 fF) (#202)
    * tmp
    * wip: pre-rebase snapshot for issue #196 (unit-cap resize regen)
    * layout: drop stale pre-rebase DRC/LVS records; update mim_pitch docstring and centroid-tiling regression guard for the DR-0019 4.0 um plate
    * layout(adc-top): mint fresh DRC/LVS evidence records for the DR-0019 resize and republish layout/adc-top/README.md's current-records pointer
    ---------
    [gen_adc_cells.py, gen_adc_top.py, test_adc_top_netlist.py, test_layout_centroid_tiling.py]
2026-08-17 cleanup(layout): remove unused AssertionFailure exception class (#209)
    class AssertionFailure(Exception) in run_extract_parasitics.py had zero
    references anywhere in the repo (never raised, caught, or imported) --
    scaffolding from an earlier draft of the error-handling design that was
    superseded by ToolingError. The exit-2 path its docstring claimed is
    implemented directly in main() without this class.
    Closes #200
    [run_extract_parasitics.py]
2026-08-17 sim(adc-enob-fft): re-run schematic ENOB/FFT + SFDR at the DR-0019-resized C_u (#210)
    Re-runs sim/adc-enob-fft/ (schematic) on the ratified 9-point grid
    (tt/ss/ff x 125C x 2.97/3.30/3.63V, spec/testbench-suite-memo.md Sec 5)
    against the physically-implemented DR-0019 resize (C_u = 35.6528 fF,
    issue #196/#202). Result: worst SFDR drops from 61.33 dB to 56.41 dB at
    ss_125c_2.97v (the pre-existing FAIL widens from 0.67 dB to 5.59 dB below
    target) and worst ENOB drops from 9.163 to 8.507 bits, now failing the
    > 9.0 target at 2 of 9 grid points (ss_125c_2.97v, ss_125c_3.30v) -- a
    regression from the prior all-PASS result. The worst corner stays
    ss_125c_2.97v / ff_125c_3.63v as before; the two-sta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
2026-08-17 test(sim): re-run schematic power campaign at DR-0019 resized C_u (#212)
    27-point PVT grid (tt/ss/ff x -40/27/125C x 2.97/3.3/3.63V) against
    sim/adc-power/testbench/tb_adc_power.spice, which already carries the
    DR-0019-resized C_u = 35.6528 fF (issue #196/#202). New record
    sim/adc-power/records/20260817-081223-afb1b3a.md supersedes the
    pre-resize baseline (20260802-141402-1224e11.md, C_u = 17.24 fF).
    Worst-corner total power moves 183.3 -> 207.9 uW (+13.4%) at the same
    corner (ff_-40c_3.63v), still well inside both the 1 mW primary target
    (4.8x margin) and the 500 uW stretch target (2.4x margin) -- PASS.
    Per block: comparator -3.6%, CDAC switch+driver essentially flat
    (-0.09%), DR-0014 top-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
2026-08-17 sim(cdac-bit-settling): re-run the 117-point settling campaign at the DR-0019-resized C_u (#213)
    * sim(cdac-bit-settling): resize C_step/C_fixed to DR-0019's 35.6528 fF unit cap
    The settling testbench still instantiated the historical 17.24 fF unit
    (2.7136 um square) after #196 resized every other adc-top-derived deck,
    so its 117-point grid was measuring the pre-resize array. Re-derive all
    ten mim_cap_2f0 instances from the same measured density law the other
    decks use (C(s) = 1.99*s^2 + 0.9532*s fF), and update the header table,
    the ideal-step note and the tau margin statement to match.
    Part of #197
    * sim(cdac-bit-settling): re-run the 117-point settling campaign at the DR-0019-resized C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
2026-08-17 evidence(layout/adc-top): klt economy + economy-review pass on adc_block, verdict revise (#208) (#217)
    Runs `klt economy` (informational + two historical-reference budget checks
    against DR-0006's 100,000 um2 and DR-0017's proposed 130,000 um2, neither
    used as a pass/fail gate) and the klayout-tools economy-review skill
    workflow (multi-zoom renders + rubric) against the current adc_block.gds
    (0.18045 mm2, post-DR-0019 resize). Verdict: revise -- the CDAC arrays and
    decode banks are legitimately spent, but the review names a ~23,000 um2
    right-side dead corridor and the comparator's own 8.55%-utilized bbox as
    recoverable, coordinate-level targets.
    Evidence committed under layout/adc-top/econom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
2026-08-17 sim(adc-inl-dnl): re-run schematic static INL/DNL at DR-0019-resized C_u (#214)
    * sim(adc-inl-dnl): re-run schematic static INL/DNL at DR-0019-resized C_u (#203)
    Full 63-point cdac-grid (7 process x 3 temp x 3 supply) schematic re-run
    against the physically-implemented DR-0019 unit-cap resize (C_u = 17.24 fF
    -> 35.6528 fF, #196/#202). All 63/63 points PASS, no check failures.
    Worst |INL| moves 0.1036 -> 0.1100 LSB (inl_t384_lsb, cap_ss_125c_2.97v),
    worst |DNL| moves 0.1036 -> 0.0938 LSB (dnl_t128_t129_lsb, same corner) --
    both effectively unchanged and still ~4.5-5.3x inside the < 0.5 LSB stretch
    target. Nothing moves outside the ratified < 1 LSB (< 0.5 stretch) target.
    Updates sim/charac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
2026-08-17 feat(sim): add klt-yield-based T1 statistical-row evidence for CDAC mismatch (#149)
    * feat(sim): add klt-yield-based T1 statistical-row evidence for CDAC mismatch
    Re-derives the existing mc-cdac-mismatch DNL/INL yield claim (record
    20260801-093800-c033611) through klt yield (2AMLogic/klayout-tools, epic
    generic, tool-independent, machine-checkable envelope
    (docs/design-evidence-tiers.md item 6). Adds a real, seeded negative
    control (unit-cap mismatch sigma forced to 3x the calibrated design
    value, N=2000) and an analytic cross-check against the experiment's own
    closed-form Pelgrom sigma predictions, neither of which the source
    record had.
    klt yield's independently-computed sigma_to_spec (5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
2026-08-17 sim: re-run the two remaining C_u-dependent campaigns and adjudicate the DR-0019 resize (#219)
    * sim(cdac-bit-settling): re-run the 117-point settling campaign at the DR-0019-resized C_u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
2026-08-17 sim(dr0019-cu-sweep): isolate the DR-0019 dynamic regression to the acquisition RC (#221)
    * sim(dr0019-cu-sweep): add a controlled C_u isolation sweep for the DR-0019 dynamic regression
    DR-0019 resized the CDAC unit cap 17.24 -> 35.6528 fF to close the gain-error
    mismatch gap, and the dynamic re-run afterwards (#204/#210) found worst-corner
    SFDR 61.33 -> 56.41 dB and composed ENOB 9.163 -> 8.507 bits. spec/testbench-
    suite-memo.md Sec 11.2 attributes the pre-resize SFDR miss to the acquisition's
    own signal-dependent nonlinearity and says in the same breath that this is "a
    nine-point correlation, not an isolation". This adds the isolation.
    - gen_cu_variant.py emits each sweep point by impor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
    [test_cu_sweep_variant.py, test_harness.py]
2026-08-17 test(sim): re-run the two lumped-load input decks at DR-0019's C_u (#220)
    * sim(track-switch): resize both decks' lumped CDAC load to DR-0019's C_u
    Both input-path decks model the per-side CDAC array as ONE MiM capacitor
    sized by the measured density law to 512 x C_u. Both were still drawn at
    the historical C_u = 17.24 fF (66.36 um square, 8.827 pF) after #196/PR
    #202 physically resized the array to C_u = 35.6528 fF, so their standing
    records certify a load half the size of the array that is now drawn.
    Resizes the 78 (sampling) + 7 (thd) load instances to a 95.5365 um square
    = 18.254 pF under the same law C(s) = 1.99*s^2 + 0.9532*s fF, and
    re-derives the load-dependent arithmetic in the de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
2026-08-17 sim: re-extract the post-#202 layout and re-run all five extracted PVT campaigns at the DR-0019 C_u (#222)
    * extract(adc-top): re-extract post-#202 layout at C_u = 35.6528 fF
    Every committed parasitic extraction of adc_top/adc_block/adc_tgate predated
    PR #202, which physically implemented DR-0019's CDAC unit-cap resize. The
    newest report (20260816-174824-539f5d9) still carries the historical unit:
    1024 MiM caps at area 7.3658 um^2 / c_f 1.7245e-14 F.
    Re-runs run_extract_parasitics.py against the current GDS. The new report
    20260817-153913-2494bd0 reports 1024 MiM caps at area 16.0 um^2 /
    c_f 3.56528e-14 F -- the drawn 4.0 um plate DR-0019 ratifies (31.840 fF area
    + 3.813 fF fringe = 35.652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
2026-08-17 layout(adc-top): recover 29,910 µm² by folding the comparator load resistors and re-deriving both strap corridors (#223)
    * layout(comparator): fold the 150 kohm load-resistor bodies into 4 legs
    Each preamp load resistor was one straight 150 um x 1 um `ppolyf_u_1k`
    body, so the 150 um run alone set `COMPARATOR`'s height (121.63 x 158.45
    um, 8.55 % of its own bbox drawn) and, through the block's
    comparator-bound right and top edges, most of the right-side dead
    corridor `klt economy` named in
    `layout/adc-top/economy/records/20260817-130012-09d8259.md`.
    `place.draw_poly_resistor` now draws the body as a serpentine of `legs`
    vertical legs joined alternately top and bottom. This is a shape cha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
2026-08-17 sim: re-extract the post-#215 layout and re-run all five extracted PVT campaigns (#225)
    PR #223 (issue #215) folded the comparator's load resistors into a compact
    serpentine and re-derived both top-level supply corridors, taking adc_block
    from 180,446 -> 150,536 um^2. That superseded the committed parasitic
    extraction (20260817-153913-2494bd0) and the five campaign records it feeds,
    which described the pre-#215 geometry -- the same situation as PR #202 ->
    issue #218, handled the same way.
    - Re-run run_extract_parasitics.py --regen-manifest: mints
    records/20260817-204449-076d545.md and re-baselines cells.json's two
    gds_sha256 pins and the four ΣR/ΣC expectations (adc_top -0.03%/-0.21%,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
2026-08-17 docs(spec): scope multi-channel/mux and noisy-substrate integration, reconcile resolution note (#227)
    Adds DR-0020 (multi-channel input mux and comparator-only fast
    threshold-detect are out of scope for this block, with the area/speed/
    crosstalk cost analysis and a pointer to where an OCP-class comparator
    belongs) and DR-0021 (guard-ring/DNW, supply/reference isolation, and
    sampling-timing assumptions for a die shared with switching power
    structures, each with an explicit evidence tier). README gets matching
    "Multi-channel / mux integration" and "Integration on a noisy,
    mixed-signal-with-power substrate" sections, a new target-spec note [h]
    reconciling the 10-bit ratified resolution against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
2026-08-19 fix: pin layout parasitics extraction to ratified gf180mcuD PDK variant (#229)
    * fix: pin layout parasitics extraction to ratified gf180mcuD PDK variant
    run_extract_parasitics.py's resolve_pdk() called `klt pdk find` with no
    --pdk argument, so it silently resolved whatever gf180mcu variant the
    host had installed (observed live: gf180mcuA via both ciel and volare,
    never the fleet-ratified gf180mcuD) and returned None on failure instead
    of raising, letting extraction degrade to bare `M ... nfet` device cards.
    Mirror run_pex_comparator.py's already-correct pattern in the same
    directory: add a PDK_VARIANT = "gf180mcuD" module constant, pass
    --pdk gf180mcuD to `klt pdk find`, and raise ToolingE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
    [run_extract_parasitics.py]
2026-08-19 docs: propose DR-0023 superseding DR-0004's digital-interface device flavor (#230)
    DR-0004 ratified 3.3 V devices throughout (analog + digital), but #169
    found the open gf180mcu PDK's only digital standard-cell libraries
    (gf180mcu_fd_sc_mcu7t5v0/mcu9t5v0) are built entirely from 6 V-oxide
    nfet_06v0/pfet_06v0 devices, characterized at exactly this block's 3.3 V
    rail — no 3.3 V-device digital library exists in this PDK at all. That
    conflict blocks a real gate-level netlist/layout/STA (T1 items 1, 2, 5).
    Re-verified #169's device counts and Liberty corners directly against
    the pinned open_pdks toolchain, and confirmed klayout-tools main now
    wires klt synthesize/place-and-route/sta/functional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
2026-08-19 refactor(parasitics): move the probes' triplicated _meas() scraper into gen_extracted_core_tb (#231)
    `probe_gain_err_settling.py`, `probe_comparator_load_short.py` and
    `probe_power_cmp_anomaly.py` each carried a private, byte-identical
    `_meas()` that scrapes one named ngspice result out of a batch run's
    combined stdout+stderr. Three independent forks of one regex is the same
    shape of risk that already bit this directory once: a hand-copied PVT
    preamble silently dropped `.temp`, so every corner ran at ngspice's
    default 27C and the fix had to be rediscovered per copy (see
    `pvt_temp_line()`'s docstring, issue #164).
    Promote it to a public `gen_extracted_core_tb.meas()`, following the
    `run_op()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
    [gen_extracted_core_tb.py, probe_comparator_load_short.py, probe_gain_err_settling.py, probe_power_cmp_anomaly.py, test_extracted_decks_current.py]
2026-08-21 docs(spec): reconcile adc-top area budget with DR-0024, superseding DR-0017 (#232)
    Proposes ratifying adc_block's Area target at < 0.16 mm², bounding the
    current as-built 150,536.239 µm² (0.150536 mm²) figure, which already
    reflects issue #215's corridor/comparator-bbox recovery on top of the
    DR-0019 unit-cap resize and issue #118's comparator growth. Supersedes
    DR-0017's stale, never-ratified 0.12100 mm² / < 0.13 mm² proposal.
    Ratification-via-PR per 2AMLogic/2am#357, matching DR-0023's precedent.
    Updates README.md and sim/characterization-summary.md's stale area
    citations to point at DR-0024 instead of DR-0017/the pre-recovery
    0.18045 mm² figure, without touching the ratified DR-00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
2026-08-21 docs(sim): state the klt pin behind every currently-governing extracted number (#233)
    Issue #189's mint-under-85b8125 / regenerate-decks / re-run-PVT-campaigns
    Scope items 1-3 were already completed by prior, independently-motivated
    work (PR #195/issue #178 minted the first 85b8125-pin record and
    regenerated all six gen_extracted_*_tb.py decks; issue #219/#224 re-ran
    the full PVT grid against 85b8125-pin decks twice more, at the DR-0019
    resize and the #215 comparator-load-resistor-fold geometries; issue
    #228/PR #229 corrected the --pdk variant to gf180mcuD, verified
    electrically identical). Confirmed directly in this worktree:
    run_extract_parasitics.py --check, every gen_extracted_*_tb.py --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
2026-08-22 chore: resync .github/CONFIGURATION.md from upstream Loom defaults
    Applied to the working tree by `resync-installed.sh` and then left
    uncommitted. `.github/` is on the Loom-shipped allowlist and is walked by the
    resync, so it updates with the rest — but the resync's own commit step stages
    `.loom/` only, so this file stays dirty in every repo the resync touches.
    That is not cosmetic. `fleet-resync.sh` refuses to run against a repo with
    uncommitted work under `.loom/`, `.claude/`, or `.gitignore`, and a repo left
    dirty this way can trip that guard on a later run and stop receiving upstream
    fixes entirely while still reporting as a healthy fleet member. The identical
    diff was found pending i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
2026-08-25 docs: reconcile Gain-error-mismatch row with the resized-Cu governing evidence (#241)
    sim/characterization-summary.md's Gain-error-mismatch row and README.md's
    Gain-error-mismatch cell (plus surrounding prose) still cited the pre-resize
    2.12sigma FAIL as the standing result and described the resize as "not yet
    physically implemented" / re-verification "still pending" -- both claims
    already falsified elsewhere in the same documents (issue #196/PR #202
    landed the resize; design/adc-top/gen_adc_top.py already reads
    C_UNIT_FF = 35.6528).
    Re-cite sim/mc-cdac-mismatch/yield-evidence-177/klt-yield-report.json
    (status: pass, sigma_to_spec=3.13, N=20000) as the governing evidence at
    the built Cu, an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
2026-08-25 sim(dr0019-cu-sweep): #238 item 1 -- dr0014-sampling at the candidate acquisition-leg width (#244)
    * sim(dr0019-cu-sweep): generalize gen_cu_variant.py to emit non-FFT decks
    Issue #238 item 1 needs the same "rebind C_UNIT_FF, patch only the
    anchored Xsi acquisition-leg line" variant machinery gen_cu_variant.py
    already built for sim/adc-enob-fft/'s FFT deck, but pointed at
    sim/dr0014-sampling/'s dr14_deck() instead -- and items 2/4 will need
    the same for sim/top-plate-cpar/'s cpar_deck() and sim/adc-power/'s
    power_deck(). Add a --deck selector (fft/inl/power/cpar/dr14) to
    variant_deck()/the CLI, defaulting to "fft" so every existing caller
    and --verify-baseline keep working unchanged.
    Also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
    [test_cu_sweep_variant.py]
2026-08-25 sim(dr0019-cu-sweep): #238 item 3 -- comparator kickback is structurally invariant to the acquisition-leg width (#251)
    Issue #238 item 3 asked to re-measure comparator kickback and the DR-0014
    sampling-instant definition at the candidate 2.068x acquisition-leg width
    using sim/comparator-kickback/. Tracing that deck (full-file read of
    tb_kickback.spice) shows it has no acquisition-leg T-gate device at all --
    unlike sim/dr0014-sampling/ (item 1, #244), it is not emitted by
    design/adc-top/gen_adc_top.py and drives the comparator from a lumped RC
    model (Cpa/Cpb=8.83pF via 1 Gohm) fed by hard-coded DC residue voltage
    sources. gen_cu_variant.py's --deck selector correctly has no `kickback`
    entry: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
2026-08-25 layout(adc-top): measure #238 item 5 -- candidate acq-leg array area (#248) (#252)
    Issue #248 (Parent #238 item 5 of 5): the array area/routing cost of the
    candidate CDAC acquisition-leg T-gate width (Xsi fourth leg, 2.068x,
    10u/20u -> 20.68u/41.36u) that sim/dr0019-cu-sweep-findings.md Sec 4
    deferred measuring.
    Confirmed both open questions the Curator's investigation left: (1)
    design/adc-top/adc_top.spice is GENERATED by design/adc-top/gen_adc_top.py
    (its own header says so), so a candidate netlist can be produced the same
    way sim/dr0019-cu-sweep/gen_cu_variant.py rebinds it for the sim decks; (2)
    layout/adc-top/lib/place.draw_devices / geometry.draw_mosfet draw every
    MOSFET at its OWN fl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
    [gen_acq_leg_candidate.py]
2026-08-25 sim(top-plate-cpar): measure top-plate C_par at the candidate acq-leg width (#254)
    * sim(top-plate-cpar): emit the candidate acquisition-leg-width deck
    Issue #238 item 2 needs sim/top-plate-cpar/ run at the DR-0019
    acquisition-leg-widening candidate geometry (2.068x, 20.68u/41.36u on
    the CDAC cell's fourth leg only). Check in the emitted deck so the run
    that follows is a clean-tree run against a committed netlist rather
    than against a scratch file.
    Emitted by, and reproducible with:
    python3 sim/dr0019-cu-sweep/gen_cu_variant.py --deck cpar \
    --c-unit-ff 35.6528 --acq-switch-scale 2.068 \
    --out sim/top-plate-cpar/testbench/tb_cpar_acq2.068.spice
    Diffed against the same generator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
2026-08-25 refactor(layout): dedupe resolve_pdk()/PDK_VARIANT into klt_env.py (#255)
    * refactor(layout): dedupe resolve_pdk()/PDK_VARIANT into klt_env.py
    run_extract_parasitics.py and run_pex_comparator.py carried byte-identical
    copies of resolve_pdk()/PDK_VARIANT (a fork issue #194 originally excluded
    from consolidation was closed by #229, which made both implementations
    identical). Move the shared implementation into klt_env.py, following the
    klt_version() precedent from #199/#194, and have both scripts import it.
    Closes #253
    * refactor(layout): drop unused PDK_VARIANT import from both parasitics runners
    Judge review on PR #255 found a dead import introduced by this PR's own
    dedup pass: both run_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
    [run_extract_parasitics.py, run_pex_comparator.py]
2026-08-25 sim(comparator-kickback): recalibrate peak_dip_uv temperature floor, resolve FAIL (#256)
    * sim(comparator-kickback): recalibrate peak_dip_uv temperature floor 3.0 -> 2.0
    The first clean-tree, complete (45/45) run of this deck's mos-grid
    (record 20260825-025943-4e220d1, reproduced bit-for-bit here) found the
    weakest temperature slice (ff, 3.63V) at 2.72502%, below the 3.0% floor
    set when this check was authored (PR #45) with no clean-tree evidence --
    the only prior run was both dirty-tree and incomplete, and its dirty-tree
    temperature minimum (4.14428%) cleared 3.0 by coincidence, not
    calibration.
    2.72502% is a real, monotonic physical effect (398/404/409 uV, each step
    5-6x the deck's ~1 uV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
2026-08-25 sim(dr0019-cu-sweep): #238 item 4 -- adc-power at the candidate acquisition-leg width (#257)
    * sim(adc-power): scaffold candidate acquisition-leg-width variant deck for #238 item 4
    Emitted by sim/dr0019-cu-sweep/gen_cu_variant.py --deck power --c-unit-ff
    35.6528 --acq-switch-scale 2.068 -- ratified C_u, only the Xsi acquisition
    leg widened 2.068x (10u/20u -> 20.68u/41.36u). Committed so the harness run
    that measures it starts from a clean tree; removed again once the run's own
    netlist-snapshots/ copy carries the same text as permanent evidence.
    Part of #238
    * sim(dr0019-cu-sweep): measure #238 item 4 -- adc-power at the candidate acquisition-leg width
    Issue #247 (#238 item 4): clock-driv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
2026-08-25 spec(dr-0025): decide against acquisition-leg widening, re-run governing ENOB/SFDR (#258)
    All five deferred measurements from #238 have landed. Items 1 (charge
    injection), 2 (top-plate C_par), 3 (comparator kickback structural
    invariance), and 4 (clock-driver power) cost little, but item 5's
    DRC-clean, LVS-matched re-layout grows adc_block area +17.00%, pushing
    it past both the ratified and the still-proposed Area targets. Per
    CLAUDE.md, adopting the candidate would trade the ENOB/SFDR FAIL for a
    worse regression on Area rather than fixing it -- so the candidate
    acquisition-leg widening is NOT adopted.
    Re-ran the governing extracted ENOB/SFDR campaign on a clean tree
    (superseding the dirty-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
2026-08-25 docs(chipalooza): Challenge #3 proposal for the SAR ADC (#261)
    Add docs/chipalooza/challenge-3-proposal.md: type-of-block, I/O list mapped
    onto the Challenge #3 pad budget, functional description, a target-spec
    table re-derived from this repo's own sim/ evidence at the challenge's
    3.3V-digital-rail coverage (with the 5.0V-analog-rail mismatch stated
    explicitly rather than assumed), a packaged-part test-plan outline, and the
    input-interface note the rules require. Every unmet row is flagged with its
    open-issue/DR citation rather than absorbed, and the two genuinely new gaps
    found while writing this (V_CM's undated drive-impedance budget, and the
    still-unbuilt SAR-sequencer transistor-level ne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
2026-08-25 spec(dr-0026): derive V_cm drive-impedance/decoupling budget, add sensitivity sim (#262)
    * spec(dr-0026): derive V_cm drive-impedance/decoupling budget, add sensitivity sim
    DR-0002 derived V_REF's drive-impedance/decoupling budget but left V_cm
    unbudgeted (DR-0011 Consequences); every ADC-level testbench sources V_cm
    from an ideal, zero-impedance source as a stated assumption. DR-0026 derives
    V_cm's own budget from the CDAC's actual release-phase/acquisition switching
    events, and sim/vcm-drive-impedance/ measures whether that ideal-source
    assumption is conservative.
    Closes #260
    * sim(vcm-drive-impedance): ideal V_cm source point (Z_vcm=0), clean-tree record
    Reference point for the sensit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
2026-08-26 docs(toolchain): pin scipy as a documented, unchecked dependency (#265)
    sim/toolchain.json and docs/environment-setup.md §1 pinned ngspice, the
    gf180mcu open_pdks hash, and python3, but not scipy -- a hard runtime
    dependency of two testbenches (sim/mc-cdac-mismatch/testbench/
    mc_cdac_mismatch.py, sim/comparator-offset-gof/testbench/analyze_gof.py).
    Add a scipy_min floor to both, matching the python_min convention.
    Decision: scipy_min is recorded but not checked by
    run_corners.py --check-env. Every enforced pin (open_pdks, ngspice,
    python) is a dependency of the generic PVT harness itself, so
    --check-env sits on the code path where a drift would matter. scipy is
    different -- it belongs to t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
2026-08-26 Chipalooza: one-command full characterization (make check/smoke/characterize) + README verification section (#267)
    * feat: one-command characterization (make check/smoke/characterize) + Chipalooza README section
    Adds the Chipalooza schematic-review entry point: `make check` (unit tests +
    env check, no PDK required), `make smoke` (one nominal corner per campaign,
    minutes), and `make characterize` (full PVT/corner campaign behind every
    spec row in docs/chipalooza/challenge-3-proposal.md Sec 4, hours), all
    backed by a new sim/characterize.sh driver over the existing
    sim/run_corners.py harness plus the two bespoke scripts (mc-cdac-mismatch,
    extracted comparator regeneration) that don't fit the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
2026-08-26 fix(sim): restore tt/ss/ff MOS corner override for adc-power schematic baseline (#268)
    * fix(sim): restore tt/ss/ff MOS corner override for adc-power schematic baseline (#266)
    sim/characterize.sh's adc-power schematic-baseline stage (added by PR #267,
    Chipalooza one-command characterization) never passed --corners tt ss ff in
    characterize mode, unlike its own extracted-GOVERNING block two lines below
    which already carries that override. Without it, run_corners.py fell back to
    sim/adc-power/testbench/tb.json's manifest default corner set (cdac) -- a
    capacitor-only sweep (tt, cap_ff/ss, mim_ff/ss, moscap_ff/ss) whose non-tt
    members only skew the moscap/mimcap .lib sections via corners.py's _s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
2026-08-27 ratification: install the two-key reviewer variant (EE key + market key) (#270)
    Phase C2 follow-up of 2AMLogic/2am#372 (2AMLogic/2am#525). Installs the two
    generated, Tier-1-clean public reviewer variants — ratification/ee-key/ (2am's
    generate-canary-variant.py) and ratification/market-key/ (product's
    generate-canary-variant.py, corporate/-leak fix applied — see
    2AMLogic/product#120), scoped to this repo's block class (sar-adc). Mirrors
    gf180-pll#176 (public-repo install pattern).
    Public-repo gate (2am#525): the private-sibling-repo grep check on the PR's
    added lines returns 0, and both generators are lint-clean with selftests
    passing (2am: 9/9, product: 4/4).
    Enables Phase C3's ratifi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
2026-08-27 ratification: fix inaccurate market-key MANIFEST.md comp-data list (#271)
    The section listed all 4 original COMP_CLASSES entries
    (ldo, pll, sar-adc, bandgap) instead of the single comp file this repo
    actually carries in ratification/market-key/comps/ — the installer
    committed generate-canary-variant.py's raw output instead of hand-scoping
    it per canary-variant.md's install procedure.
    Not a disclosure leak (every listed filename names another public
    canary's own block class); a documentation-accuracy fix only.
    Part of 2AMLogic/2am#589
2026-09-05 feat(champion): standing authorization for design-evidence auto-merge (#6850)
    Operator ruling 2026-09-05: Judge-approved, green-CI PRs whose entire
    changed-file set lives in design/, sim/, layout/, measurements/,
    verification/, or docs/ auto-merge without the four-axis human hold.
    Rationale: canary design evidence is fully revertible with no fleet-infra
    blast radius, and the held-PR pattern (sky130-sar-adc#123 sat mergeable for
    days as the sole blocker of a layout chain) costs more than it protects
    here. spec/ and every tool surface fall outside the patterns, so the
    exact-subset rule keeps them on the four-axis judgment automatically.
    C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
2026-09-14 feat: synthesize the SAR sequencer RTL to a gf180mcu gate-level netlist (#276)
    * feat: synthesize the SAR sequencer RTL to a gf180mcu gate-level netlist
    Add design/sar-logic/rtl/sar_ctrl.v, a hand-authored, port-identical
    RTL implementation of the rung-1 sar_ctrl_a model (DR-0008 one-hot
    16-phase ring, DR-0014 two-phase bottom-plate sample, the free-MSB
    trial, the nine eng/dir weight slices, the four-leg one-hot decode,
    the output register and drdy), plus a klt-synthesize-driven flow
    (design/sar-logic/flow/synth_sar_ctrl.py) that maps it to both
    DR-0023-adopted standard-cell libraries and proves register-
    correspondence equivalence between the RTL and each gate netlist via
    klt equiv. A CI t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
2026-09-15 DR-0023 follow-on (b): place-and-route the SAR sequencer gate netlist (#279)
    * feat(design): place-and-route the SAR sequencer gate netlist (klt place-and-route)
    DR-0023 follow-on (b), issue #274. Adds design/sar-logic/flow/pnr_sar_ctrl.py,
    a klt place-and-route driver that routes #272's synthesized sar_ctrl_a gate
    netlist (gf180mcu_fd_sc_mcu7t5v0) inside an explicit floorplan matching the
    reserved SAR-logic footprint layout/adc-top/gen_adc_top.py carves out and
    rings, derived from the committed area.json rather than hardcoded.
    Also corrects a stale "SAR-logic reserved region incl. its ring" figure in
    layout/adc-top/README.md's Area table (7,624 um^2, an issue #118-era
    snapshot) -- the com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
    [pnr_sar_ctrl.py, sar_ctrl.v]
2026-09-15 Scaffold gate-level SAR-sequencer SPICE replay testbenches (#273) (#283)
    Builds the functional/timing corner-grid replay scaffolding for the
    synthesized SAR sequencer (issue #272 continuation): gen_sar_ctrl_gates_tb.py
    generates sim/sar-logic-functional-gates/ and sim/sar-logic-timing-gates/ by
    reusing gen_sar_logic.py's existing closed-loop composition against the
    translated gf180mcu_fd_sc_mcu7t5v0 gate netlist instead of the ideal
    rung-1 model, with a start-pulse seed for the ring per
    design/sar-logic/rtl/README.md's "Real hardware note". Adds automated
    regression tests for gate_netlist_to_spice.py (parsing, alias resolution,
    power/ground wiring, sanitize-collision guard).
    The corner-grid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
    [gen_sar_ctrl_gates_tb.py, test_gate_netlist_to_spice.py, test_sar_ctrl_gates_tb.py]
2026-09-15 refactor: remove unused label() function from geometry.py (#285)
    Delete the label() function (Metal1/(34,10) labeling helper) that has no call
    sites anywhere in the repository. Update label_metal5()'s docstring to describe
    its purpose standalone rather than as a sibling of the deleted function.
    Verified via grep across layout/adc-top/cells/gen_adc_cells.py,
    layout/adc-top/gen_comparator.py, layout/adc-top/gen_adc_top.py,
    layout/adc-top/lib/place.py, and sim/tests/ that label() was never called
    since its introduction in #62.
2026-09-15 layout(adc-top): refresh the stale "Area, as drawn" table against live area.json (#280) (#286)
    The table's per-row figures (CDAC array/decode bank per side, comparator,
    etc.) were an issue #118 snapshot never regenerated after #196's unit-cap
    resize or #215's two-step area recovery -- only the block/analog-core
    totals got dated "Update" paragraphs along the way. Adds a full row-by-row
    refresh read live off the committed area.json (plus a live build() query
    for the two figures area.json doesn't persist -- adc_top's own standalone
    area and the comparator's live cell dimensions), following the same
    "read live, don't hand-copy" discipline issue #274 already applied to the
    SAR-logic reserved-regi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
2026-09-15 fix: isolate gate-netlist drift test from the committed synth output tree (#288)
    test_committed_netlists_match_a_fresh_synthesis re-ran synth_sar_ctrl.py
    against its real, tracked netlist/reports paths, so every check:ci run
    mutated the committed netlists and dropped fresh reports/*.json as a side
    effect of the check -- the first run silently overwrote committed-looking
    files with whatever yosys build was installed, leaving the working tree
    dirty. Add a --out-dir override to synth_sar_ctrl.py's synthesize_one/main
    so the test can redirect a fresh synthesis into an isolated temp directory
    instead. Also normalize the "Generated by Yosys <version>" preamble line
    before comparing, so a yosys ver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
    [synth_sar_ctrl.py, test_sar_ctrl_gate_netlist.py]
2026-09-15 feat: pre-route STA evidence for sar_ctrl_a vs DR-0003's 62.5 ns budget (#278)
    * feat: add pre-route STA driver for sar_ctrl_a (DR-0023 follow-on (c))
    DR-0023 follow-on (c), issue #275: adds design/sar-logic/flow/sta_sar_ctrl.py,
    which checks the mcu7t5v0 gate netlist (#272) against DR-0003's 62.5 ns
    bit-cycle clock period at every corner in DR-0023's ratified 3.3V corner
    grid plus the two remaining corners the library ships.
    klt sta (as requested by the issue) requires an already-routed DEF, which
    does not exist until #274 (place-and-route) lands -- see the driver's own
    docstring for the full reasoning and the disclosed tool-gap workaround
    (klt place-and-route's own target_stage: "place"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
    [sta_sar_ctrl.py, sta_sar_ctrl_postroute.py]
2026-09-15 fix(sar-logic): declare vdd_gate .global in translated gate netlists (issue #282) (#290)
    Root-causes and fixes the ngspice non-convergence blocker on the gate-level
    SAR-sequencer SPICE replay: the supply net every standard cell binds
    (vdd_gate) is supplied from outside the emitted `.subckt sar_ctrl_a`, and
    nothing inside it drives that net. SPICE scopes every node inside a
    `.subckt` LOCALLY to each instance unless it is a port, node `0`, or
    declared `.global` -- without that declaration, every one of the DUT's 181
    cell instances got its own private, undriven copy of the supply, so the
    whole network simulated unpowered at ~0 V. This looked like a solver/
    power-up-state problem (a slow VDD ram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
    [gate_netlist_to_spice.py, gen_sar_ctrl_gates_tb.py, test_gate_netlist_to_spice.py]
2026-09-15 fix(loom): break SIGPIPE/pipefail false-MISS in verify-proposal-refs.sh (#294)
    full_tree() piped its cached tree listing into grep -qFx, whose early exit
    on a match could SIGPIPE the printf writer before it finished; under
    set -o pipefail the pipeline reported the writer's 141 instead of grep's
    0, so real files were flagged MISSING. Feed the cache via a here-string
    instead so there is no live writer process for grep's early exit to kill.
    Closes #292
2026-09-15 fix(ci): stop pruning libs.ref from cached gf180mcu PDK in nightly-pdk.yml (#293)
    The selftest and xschem-smoke jobs' "Fetch gf180mcu PDK (volare)" steps
    were deleting libs.ref from the cached PDK tree after fetch, and the
    "Restore gf180mcu PDK" steps kept caching it under a -libstech-v1 key.
    That predates #273 (PR #283), which made
    sim/tests/test_sar_ctrl_gates_tb.py (via
    design/sar-logic/flow/gen_sar_ctrl_gates_tb.py) read
    libs.ref/<variant>/spice/<variant>.spice for the gate-level SPICE
    replay testbenches -- so a cache hit on the nightly workflow has been
    silently serving a PDK tree missing the files those testbenches need.
    Keep the full targeted variant (libs.tech + libs.ref) instead of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
2026-09-16 docs(sar-logic): root-cause the gate-level sw_conflict one-hot violation (#299)
    Disambiguates issue #295's severe DR-0014 one-hot-invariant overshoot: a
    byte-for-byte port-order diff (RTL vs synthesized-netlist module header vs
    translated SPICE .subckt) rules out a wiring/pin-mapping defect, and direct
    sub-nanosecond crossing-time measurement confirms a genuine combinational
    hazard instead -- rel_n_<weight><side> reads the shared sel_in_n net
    directly through one real standard cell, racing sel_in_n's own (undelayed)
    voltage in the one-hot check's summed expression by a measured 143-163 ps
    on every conversion. Triages the smaller nside_cells_se overshoot as the
    same root cause and the fs/sf t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
2026-09-16 fix: accept bounded gate-decode one-hot hazard via decision record (DR-0027) (#300)
    * fix: accept bounded gate-decode one-hot hazard via decision record (DR-0027)
    Issue #295 root-caused the severe sw_conflict_se/df overshoot in the
    synthesized sar_ctrl netlist to a genuine ~143-165 ps four-leg one-hot
    gap: Yosys/ABC De Morgan-folds sar_ctrl.v's shared smpb inverter into
    each rel_n_<weight><side> cell during technology mapping, breaking the
    matched-depth structure the RTL was written with.
    DR-0027 evaluates the physical significance of this gap (a floating
    node, not a shorted rail; ~12-15% of the array's own settling time
    constant; leakage-driven drift many orders of magnitude below 1 LSB;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
2026-09-17 fix(sar-logic): slew the gate-level comparator output so ngspice can step over the decision (#296) (#304)
    * fix(sar-logic): slew the gate-level comparator output so ngspice can step over the decision (#296)
    Confirms #296's root-cause hypothesis by instrumentation and fixes it.
    WHAT WAS WRONG. gen_sar_logic._loop models the comparator as an ideal
    behavioural voltage source whose VALUE is a hard ternary on
    v(top_p) > v(top_n). Driving the rung-1 XSPICE `cmp` bridge that is
    harmless (no analog load at all); driving the timing deck's lt/xl/bad
    loops it is harmless too (their T-line presents a matched 50 ohm
    resistive load). Driving a REAL synthesized standard cell's gate input
    it is not: that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
    [gen_sar_ctrl_gates_tb.py, probe_cmp_convergence.py, test_sar_ctrl_gates_tb.py]
2026-09-17 docs(sim): correct stale 'no corner-grid run recorded' notes in gate-level tb.json (#306)
    * docs(sim): correct stale 'no corner-grid run recorded' notes in both gate-level tb.json decks
    Both sim/sar-logic-functional-gates/testbench/tb.json and
    sim/sar-logic-timing-gates/testbench/tb.json carried an evidence note
    asserting that no corner-grid run was recorded for the experiment. Both
    decks now have committed records/, corners/ and netlist-snapshots/
    entries, so the claim was false -- and run_corners.py copies tb.json's
    notes verbatim into every record it mints, putting the false claim inside
    records that are themselves corner-grid runs.
    Reword each note to describe the deck's current state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
2026-09-17 docs(sim): measure the sar-logic-timing-gates grid cost wall and correct the retention-knob claims (#303) (#307)
    * feat(sim-harness): add --save-measured-vectors to cap ngspice output retention
    ngspice's default is to keep every node voltage and branch current of the
    deck in memory for the whole transient. On sim/sar-logic-timing-gates/ --
    five synthesized ~181-cell DUT instances, ~6300 output vectors -- that is
    the binding constraint on running the ratified 8.5 us transient at all,
    not CPU: measured resident-set growth is ~4.3 MB per simulated nanosecond
    (686 MB at 190 ns, 866 MB at 229 ns), i.e. ~36 GB for one 8.5 us point on
    a 15.7 GB host.
    The new flag emits an ngspice `save v(a) v(b)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
    [test_harness.py]
2026-09-18 docs(sim): measure that sar-logic-timing-gates' five-loop composition, not the host, is what makes its grid unrunnable (#303) (#312)
    Third session on #303, on a second class of host (18-core Apple M5 Max,
    48 GB, no cgroup quota). It hit the same wall the first two did, so this
    one measured where the cost actually lives rather than re-reporting that
    it is too big.
    Holding DUT, corner, solver, thread count and retention fixed at
    tt/27 C/3.30 V and varying only how many of the deck's five loops are
    instantiated:
    - the `ok` loop alone COMPLETES the whole ratified `tran 5n 8.5u 0 5n`
    in 131.9 core-s (866 s wall), no `Timestep too small`, every `meas`
    line resolved;
    - the committed f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
2026-09-18 docs(sim): measure KLU vs SPARSE 1.3 on the gate-level decks; not adopted (#308) (#313)
    ngspice-46 is compiled with KLU but every generated deck falls back to
    SPARSE 1.3. Measured it before adopting it, per #308: a truncated A/B on
    sim/sar-logic-timing-gates/ (matching #303's 0.25us probe) shows the two
    solvers cost the same to within 0.6% per accepted timepoint -- the
    wall-time gap is a timepoint-count artifact, the same false-positive shape
    --save-measured-vectors already turned out to have on this deck -- and
    KLU's peak RSS is not better either. A full-length measured-values A/B on
    sim/sar-logic-timing and sim/cdac-bit-settling confirms both solvers are
    measurement-neutral (identical m_*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
2026-09-18 docs(sim): measure --save-measured-vectors / --ngspice-threads neutrality on a full-length gate-level deck (#309) (#315)
    Full-length A/B of both harness knobs on sim/sar-logic-functional-gates
    (real synthesized gf180mcu standard cells) reaching every measurement
    window: all 16 m_* values are bit-identical (all ten printed digits)
    across --save-measured-vectors on/off and --ngspice-threads 1/4, even
    though both knobs measurably perturb the accepted-timestep sequence
    (diverging at the 2nd/3rd accepted point). The two claims -- measured
    values vs. accepted-timestep sequence -- are separate, and only the
    first generalizes from the small reference decks to the gate-level
    class. Neither flag is re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
2026-09-18 fix(sar-logic): derive klt synthesize artifact paths instead of reading them back (#314) (#317)
    `klt synthesize`'s `SCHEMA_VERSION` went 1 -> 2 in klayout-tools#1873
    (`5cbe3971`, 2026-09-15, documented in `docs/cli/synthesize.md`): the
    response's top-level `netlist_path`/`script_path` changed from bare path
    strings to `{"path": ..., "scope": "repo"|"external"|"absent"}` objects.
    `synthesize_one`'s `Path(synth_resp["netlist_path"])` therefore raised
    `TypeError: argument should be a str or an os.PathLike object where
    __fspath__ returns a str, not 'dict'` before it ever wrote a netlist --
    which meant `sim/tests/test_sar_ctrl_gate_netlist.py` failed on the driver
    subprocess's non-zero exit and n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
    [synth_sar_ctrl.py]
2026-09-18 test(sim): pin the gate-netlist byte check, add a version-independent drift guard (#316) (#318)
    `sim/tests/test_sar_ctrl_gate_netlist.py` byte-compared a fresh
    `synth_sar_ctrl.py` run against the committed gate netlists, which is only
    reproducible on the exact Yosys build that wrote them (0.69+post). On any
    other build it reported a mapping difference as "stale relative to
    sar_ctrl.v -- run: python3 design/sar-logic/flow/synth_sar_ctrl.py", and
    following that remediation would overwrite correct goldens with
    version-skewed ones and silently re-baseline the STA/P&R records built on
    them. Nothing in the repo stated the required versions.
    The module now makes the two claims separately, by what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
    [test_sar_ctrl_gate_netlist.py]
2026-09-19 feat(sim): decompose the gate-level timing deck into per-loop decks and run the first scored 45-point grid (#311) (#321)
    * feat(sim): decompose the gate-level timing deck into five per-loop decks (#311)
    `sim/sar-logic-timing-gates/` has never produced a scored PVT point. Three
    sessions tried its ratified 45-point `mos` grid (#289, #296/#307, #303) and
    none finished a point. The third measured where the cost lives and it is not
    the host: holding DUT, corner, solver, thread count and retention fixed and
    varying ONLY how many of the deck's five loops are instantiated, the `ok`
    loop alone completes the whole ratified `tran 5n 8.5u 0 5n` in 131.9 core-s
    while the five-loop deck spent 276.3 core-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
    [gen_sar_ctrl_gates_tb.py, test_sar_ctrl_gates_tb.py]
2026-09-19 sar-logic-timing-gates: the second Timestep too small abort is a five-loop composition artifact, not a comparator defect (#310) (#323)
    * sim(probe): extend probe_cmp_convergence past 200 ns for issue #310
    #296's B side was only validated to --until 200n. #303 then ran
    tt/27 C/3.30 V to natural completion and hit a SECOND abort at
    t = 3.84657e-07 s on node vvdd_gate#branch -- the SHARED DUT supply
    branch, so unlike b<tag>cmp#branch the node name alone does not name a
    loop. Three additions make the A/B that isolates it re-runnable:
    - --only-loops TAG[,TAG...] cuts the composed testbench at its
    `* ---- loop <tag> ----` banners, so a per-loop A/B that costs ~50 min
    on the five-loop deck co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
    [probe_cmp_convergence.py, test_probe_cmp_convergence.py, test_sar_ctrl_gates_tb.py]
2026-09-19 spec(DR-0029): settle the tie loop's decision chatter as a recorded model property (#322) (#326)
    Issue #310's investigation measured, but deliberately did not act on, the
    `tie` loop's hard-comparator decision chatter (42 reversals against 2 for
    every other loop on the five-loop deck) and named three candidate responses,
    each of which changes what the loop CLAIMS. DR-0008 defines the loop and
    `tb.json`'s bounds are ratified, so #322 asked for the decision to be made
    and recorded in `spec/`.
    **Decision: candidate 3 — record it, change nothing.** The `tie` input stays
    `dc {vcm}` (pinned exactly on the threshold), the comparator stays the
    continuous-time hard ternary, `CMP_OUT_RC` stays 100 p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
    [probe_cmp_convergence.py, test_probe_cmp_convergence.py]
2026-09-19 sar-logic-timing-gates-ok: root-cause abs_err_delay_0ns to an unreset first conversion plus a mid-update decode transient (#320) (#329)
    The first scored 45-point gate-level grid reported abs_err_delay_0ns up to
    512 LSB at 10 of 45 PVT points. Measured, those ten points are TWO unrelated
    mechanisms and neither is the setup-time violation the issue hypothesised.
    A. The first conversion after power-up is genuinely invalid (8 of the 10;
    settled code errors of 1, 5, 28 and 252 LSB). sar_ctrl.v's `start` seeds
    the ph[15:0] ring and nothing else; eng[9:1] clears only at
    endconv = ph[13], i.e. inside the first conversion, so conversion 1
    searches against arbitrary already-engaged CDAC w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
    [probe_code_readout.py, test_probe_code_readout.py]
2026-09-20 spec(DR-0030): bind the acquisition/isolation limits to the DUT's rung, not the deck (#336)
    `sim/sar-logic-functional-gates/` wraps the same synthesized gf180mcu
    netlist as `sim/sar-logic-timing-gates/`, measures the same expressions,
    and was still scoring them against the pre-DR-0028 185..190 / 60..65
    windows inherited from the rung-1 ideal model. That left the 20 ns-timestep
    coarse deck holding the netlist to a tighter window than the 5 ns deck that
    owns the tight claim, and failing at `fs`/`sf` for exactly the reason
    DR-0028 adjudicates.
    DR-0030 states the rule the two records together imply: these limits are a
    property of the DUT, not of the deck. Gate-level decks carry DR-0028's
    derive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
    [test_sar_logic_netlist.py]
2026-09-20 sim(sar-logic-timing-gates-tie): run the ratified 45-point mos grid; lt/xl/bad launched, in flight (#303) (#333)
    * sim(sar-logic-timing-gates-tie): run the ratified 45-point mos grid (#303)
    Scores 29 of 45 points on the tie loop's ratified 45-point mos grid at
    tt/27C/3.30V (-j 8, --ngspice-threads 1, --save-measured-vectors,
    --timeout 3600). 16 points did not produce a scored measurement: 15 hit
    the 1-hour per-point timeout (this deck measures 233.7 core-s/point
    uncontended; the host was independently observed at load average ~39 on
    28 cores during this run, so wall time is inflated by contention rather
    than the deck being newly expensive), and sf_27c_2.97v aborted with a
    genuine "Timestep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
2026-09-21 feat(signoff): commit a klt signoff block manifest so this block's T1 state is graded, not hand-read (#342)
    * feat(signoff): commit a klt signoff block manifest so this block's T1 state is graded, not hand-read
    This repo had no `klt signoff` block manifest, so "how far is this block
    from T1" was prose that went stale the moment either the evidence or the
    checklist moved. Both had already moved: the T1 checklist grew an eleventh
    item on 2026-09-17 (klayout-tools#2025), and this block's digital partition
    went from a behavioural model to RTL + synthesis + STA + a routed macro.
    New `signoff/` directory:
    - `gf180-sar-adc.manifest.json` -- block manifest, `kind: mixed-signal`,
    with every cita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
2026-09-21 sim(sar-logic-timing-gates-{lt,xl}): both 45-point grids ran, and neither completed a single ratified transient (#303) (#344)
    * sim(sar-logic-timing-gates-lt): run the ratified 45-point mos grid (#303)
    Commits the record `run_corners.py` wrote for the `lt` per-loop deck's full
    ratified 45-point mos grid (-j 12 --ngspice-threads 1 --save-measured-vectors
    --timeout 7200, launchd-dispatched so ngspice ran at normal QoS).
    Headline, stated the way the raw logs read rather than the way the record's
    own Result table reads: **0 of 45 points completed the ratified
    `tran 5n 8.5u 0 5n`.**
    - 35 of 45 hit the 7200 s per-point cap.
    - The other 10 all aborted with `doAnalyses: TRAN: Timestep too small`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
2026-09-21 feat(erc): stand up klt erc and record ADC_BLOCK's structural supply read (#330) (#348)
    T1 item 11 (`Power delivery (structural)`, klayout-tools#2025) is graded
    from a `klt erc` supply-spec run, and this repo had neither a spec nor a
    report. `layout/erc/` is that flow, built to the same shape as
    `layout/drc/` and `layout/lvs/`: a pinned toolchain, a runner that asserts
    rather than eyeballs, and append-only reports plus a record.
    The committed run says `vdd` and `vss` each resolve to **exactly one**
    electrical island in `layout/adc-top/adc_block.gds` -- zero
    `erc.unconnected_net`, zero `erc.supply_short` -- and its
    `provenance.input.content_hash` is the committed GDS's own sha256.
    What it d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
2026-09-21 sim(sar-logic-timing-gates-tie): root-cause the sf_27c_2.97v abort to a sign test at the floating-point ulp on a quiescent supply row (#332) (#350)
    Issue #303's ratified 45-point `mos` grid produced one genuine ngspice
    non-convergence on this deck:
    sf_27c_2.97v: doAnalyses: TRAN: Timestep too small; time = 3.99655e-07,
    timestep = 6.25e-21: trouble with node "vvdd_gate#branch"
    Reproduced exactly by three independent probe invocations (2446 accepted
    timepoints and the same abort time to every printed digit as the corner
    runner's own log), then root-caused:
    * At the abort the comparator's two input nodes differ by 0 .. 3.8e-13 V --
    0 .. 1690 ulp of a 1.485 V node, with two accepte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
    [probe_cmp_convergence.py, test_probe_cmp_convergence.py]
2026-09-21 sim(sar-logic-functional{,-gates}): add iso_skew_ns cross-loop asymmetry check (#351)
    DR-0030 moved iso_gap_ns/iso_gap_df_ns on the gate-level functional deck to
    DR-0028's wide 31.3..75.0 ns margin bounds, which leaves the two loops free
    to part company by tens of ns with both still passing. Add
    iso_skew_ns = (iso_av_df-iso_av)*1000 to both sar-logic-functional and
    sar-logic-functional-gates tb.json (measure + checks), bounded at +/-0.01 ns
    -- 25x the worst cross-loop residual measured across every committed
    gate-level record (<= 0.0004 ns) and ~100x tighter than the per-loop
    iso_gap_ns window, grounded in the fact that both loops sample through the
    same two controls in the same phase so the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
    [test_sar_logic_netlist.py]
2026-09-21 spec: renumber the power-up first-conversion record DR-0029 -> DR-0031 (#354)
    Two records shared the number DR-0029, which
    spec/decision-records/README.md forbids outright ("Two records must never
    share a number, even when one of them is superseded"). Its tie-break is
    to renumber the later-merged record; git log --follow --diff-filter=A
    puts DR-0029-power-up-first-conversion-validity.md at 2043286
    (2026-09-19 03:41:48), four seconds after
    DR-0029-tie-loop-decision-chatter.md at c94b9c2 (03:41:44), so the
    power-up record is the one renumbered here.
    DR-0031 is the next unused number, re-derived against the tree rather
    than assumed: DR-0030 is taken by
    DR-0030-functional-deck-acquisition-isola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
2026-09-21 feat(erc): settle ADC_BLOCK's well-tie question from geometry (DR-0032) (#359)
    * feat(erc): settle ADC_BLOCK's well-tie question from geometry, and record DR-0032
    Adds layout/erc/well_tap_audit.py plus its committed result
    well-tap-audit.json: a well tap is diffusion inside a well that is not
    part of a transistor, and ADC_BLOCK has none -- all 160 COMP polygons
    interacting with its 25 Nwell islands also interact with Poly2. The two
    tap structures it does draw are the substrate-tie guard rings, and
    neither carries a Metal1 label or a route to a supply.
    That makes item 11's tie half failed-on-evidence rather than uncomputed,
    and corrects the prior reading that the tie-narrowed control's 25
    e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
    [test_well_tap_audit.py]
2026-09-21 signoff: cite T1 item 8 on both partitions via generic evidence envelopes (#339) (#361)
    T1 item 8 ("Characterization report") rendered `unmet`/`no_evidence` in both
    partitions of the committed verdict. It is the only T1 item that names no
    `klt` verb, so no verb's output can satisfy it; `klt signoff` ingests it
    through an opt-in generic evidence envelope (`"kind": "generic"`,
    klayout-tools#1152) a project hand-writes -- and item 8 is the only item that
    accepts one.
    Writing that envelope is a fresh claim that the characterization report is
    currently true, not a manifest edit, so this change re-reads the report first
    and asserts second.
    ## The re-read (six currency defects settled)
    `sim/char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
2026-09-21 sim(sar-logic-timing-gates-tie): root-cause tie_code_deviation=512 to the output register read mid-carry (#337) (#355)
    Issue #303's ratified 45-point `mos` grid failed `tie_code_deviation`
    (max=1) with a value of exactly 512 at 6 of its 29 scored points. Measured,
    none of the six is a saturated code and none is a SAR-logic defect: every
    conversion at every one of the six settles on 511 or 512 -- inside the
    bound, and exactly the "either adjacent code answers an exact tie" behaviour
    the bound was written for.
    All six are DR-0031's mechanism B (`DR-0031-power-up-first-conversion-
    validity.md`, renumbered from DR-0029 by #354), reproduced on this deck at
    its own corners: `drdy = ph[15]` and `c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
    [probe_code_readout.py, test_probe_code_readout.py]
2026-09-21 sim/harness: never score a mid-transient abort as a completed point (#341) (#362)
    `_run_point` only consulted `_ERROR_RE` inside the `if missing:` branch, so a
    hard ngspice analysis failure was invisible whenever every measurement the
    manifest named happened to parse. On a manifest with exactly one measurement
    and that measurement an unbounded-right `meas ... MAX ... FROM=...`, that is
    guaranteed: `MAX` over the truncated window always yields a number, nothing is
    missing, and the point is recorded as a scored PASS/FAIL even though the
    transient never reached its ratified stop time.
    Add `runner.analysis_aborted()` -- a scan of the raw output for the three
    markers that mean the analysis STOPP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
    [test_harness.py]
2026-09-21 docs(erc): correct the Metal1 disjoint-polygon count for vdd/vss (3 -> 4) (#365)
    `layout/erc/README.md`'s "What the committed run says" bullet claimed the
    `vdd` rail is three disjoint polygons on Metal1. Re-deriving from the same
    committed bytes (layout/adc-top/adc_block.gds, sha256 b4cf6ad7...) with the
    pip `klayout` package -- flatten `ADC_BLOCK`, merge Metal1 (34/0),
    point-test each Metal1_Label (34/10) text against the merged islands --
    gives four labelled Metal1 islands for `vdd` and four for `vss`, one per
    labelled sub-block. The two other readings of "disjoint polygons" were
    checked and neither is three either (13 merged Metal1 polygons drawn
    directly in the top cell; 89 merged Metal1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
2026-09-21 refactor(sar-logic): one provenance implementation for the flow drivers (#352) (#367)
    `_git`, `_git_status_porcelain`, `_run`, and `klt_version` were
    byte-identical copies in `design/sar-logic/flow/synth_sar_ctrl.py` and
    `pnr_sar_ctrl.py`; `record_id` differed only by a docstring line. These
    five helpers decide what a recorded number *means* -- which commit a
    record claims, whether the tree that produced it was clean, which `klt`
    stamped it -- so two forks of them let one driver's provenance drift from
    the other's, silently, on the next edit to either.
    New `design/sar-logic/flow/flow_env.py` is the single implementation,
    mirroring `layout/klt_env.py` (#194/#253): same module-docstring argum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
    [flow_env.py, pnr_sar_ctrl.py, sta_sar_ctrl.py, sta_sar_ctrl_postroute.py, synth_sar_ctrl.py, test_flow_env.py]
2026-09-21 test(spec/decision-records): enforce one-number-one-record DR-NNNN uniqueness (#369)
    spec/decision-records/README.md states the invariant but nothing enforced
    it, so two branches independently claimed DR-0029 and the collision sat
    on main for two days before being caught by hand (#335, fixed by PR #354).
    Add a unittest under sim/tests/ that asserts every DR-NNNN prefix under
    spec/decision-records/ is claimed by exactly one filename, so a future
    collision fails make check instead of waiting to be noticed.
    Closes #353
    [test_decision_records.py]
2026-09-21 spec(DR-0033): price sf_27c_2.97v's non-convergence as attributed coverage rather than change the tie loop (#364)
    DR-0029 named its own supersede trigger -- "a corner where
    tie_conv_period_ns or tie_code_deviation actually fails AND the chatter is
    implicated". #345 was filed believing it had fired twice. Measured, it fired
    once, and on a fact DR-0029 did not have.
    * #337 does NOT fire it. The six tie_code_deviation=512 points have a SETTLED
    code of 511 or 512 at every conversion -- inside the max 1.0 bound. The 512
    is DR-0031 mechanism B (drdy's gate opening while the register is still
    updating), and its correction is #327. tie_code_deviation has never failed
    on a settled code. #337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
2026-09-21 fix(layout,signoff): bump klt to close T1 item 4's unpinned LVS citation (#360)
    * fix(layout,signoff): bump klt to absorb #1969/#2027, close T1 item 4's unpinned LVS citation
    layout/toolchain.json's `klt` pin (85b8125, 0.2.0) predates klayout-tools#1969,
    so `klt lvs` never populated `provenance.input` -- the reason
    signoff/gf180-sar-adc.manifest.json's item 4.analog citation was the one
    citation in the manifest with no `content_hash` (pinning one against a `null`
    field would have rendered a fresh report `unmet`/`stale_evidence`).
    Bumps the pin to `b15edf5e` (upstream main HEAD, past both klayout-tools#1969
    and #2027 -- the `input.role` field #2027 adds is absorbed in the same bump
    rather t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
    [run_lvs.py]
2026-09-22 sim: locate the delay-line decks' step-control collapse at the line's termination node (#372)
    * sim(sar-logic-timing-gates): locate the delay-line decks' step-control collapse at the line's termination node
    Issue #343 asked whether the ideal lossless transmission line is the
    mechanism behind the `Timestep too small` aborts that kill every
    `sar-logic-timing-gates-lt`/`-xl` point that runs long enough to reach a
    verdict. Answer: confirmed, with a correction to which half of the
    structure does the damage.
    The A/B is one corner (`lt`/`ss`/27 C/2.97 V -- the `lt` grid's earliest
    abort) on a truncated `tran 5n 1.5u`, in a scratch copy. Arm A is the
    committed deck, byte-identical. Arm B keeps the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
    [probe_cmp_convergence.py, test_probe_cmp_convergence.py]
2026-09-22 docs(spec,chipalooza): re-point stale SAR-sequencer record citations (#375)
    sim/sar-logic-functional/records/20260801-041242-96c2ea7.md was taken on
    the DR-0006-era sequencer, and sim/sar-logic-timing/records/20260801-033032-06bad60.md
    is formally superseded (20260802-102758-d8a363d carries
    Supersedes: 20260801-033032-06bad60). Both were still cited as the current
    evidence in spec/testbench-suite-memo.md's coverage map, spec/timing-budget-memo.md
    and docs/chipalooza/challenge-3-proposal.md's externally-facing spec table.
    Re-point all six citations at the current DR-0011 + DR-0014 controller
    records (sar-logic-functional/records/20260802-110241-131989b.md and
    sar-logic-timing/records/2026080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
2026-09-23 power: measure ADC_BLOCK's Poly2-stitched supply rails for IR drop and EM, and budget the droop (#346) (#380)
    * sim(adc-rail-current): add the peak/average vdd-rail current experiment (#346)
    * sim(adc-rail-current): point the manifest at DR-0034, the record that actually carries the budget (#346)
    The `i_vdd_peak_ua` check's description cited DR-0033 as the ratified row
    this experiment feeds. That number was an estimate made before the budget
    record was written, and it has since been taken by an unrelated decision
    (`DR-0033-tie-loop-nonconvergence-coverage-hole.md`, merged in #364). The
    supply-droop budget this deck's currents are consumed by is DR-0034.
    Comment-only; no measured value, no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
2026-09-23 layout(adc-top): draw and route 25 n-well taps, close and strap both substrate-tie rings (#384)
    Every PMOS body in ADC_BLOCK sat in a well biased by nothing, and both
    substrate-tie guard rings were drawn but reached no supply. `well_tap_audit.py`
    measured it directly in #340: 0 well taps in 25 wells; 0 `Metal1_Label` texts on
    either ring; each ring's Metal1 four mutually disjoint bars, open at all four
    corners, so labelling one bar would have strapped a quarter of a ring and fired
    `erc.unconnected_net` on a second island named `vss`.
    Geometry (`lib/geometry.py`, `lib/place.py`, `gen_adc_top.py`):
    * `draw_shared_nwell` now draws an `Nplus`-marked n+ tap strip above each
    device row and ret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
2026-09-23 sim/harness: reserve record-id atomically to stop same-second collisions (#385)
    allocate_record_id() only checked records/<id>.md existence, but a record
    is written at the *end* of a run -- two concurrent run_corners.py runs of
    the same experiment started in the same second both saw the id as free
    and minted the same one, colliding on both the work dir and the evidence
    dir (#377).
    reserve_dir now lets a caller atomically mkdir a per-id directory at
    allocation time (mkdir is atomic create-if-absent, unlike exists()-then-
    write-later); a losing concurrent caller gets FileExistsError and
    advances the timestamp exactly as it does for an existing record.
    run_corners.py passes its scratch .work/<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
    [test_harness.py]
2026-09-23 spec(DR-0036): budget the V_DD switching transient as charge, and require an on-die term inside ADC_BLOCK (#379) (#387)
    layout/power/ (#346) measured what ADC_BLOCK's vdd island is asked to
    deliver -- 34.383980 mA peak at ff_-40c_3.63v, 869x that corner's own
    39.5421 uA average, because the CDAC's 72 bottom-plate T-gate legs switch
    together -- and DR-0034 budgeted only the STATIC droop, saying in its own
    Consequences that "this record does NOT settle decoupling ... A decoupling
    budget is separate work." The ratified table allocates external decoupling
    for V_REF (DR-0002) and V_CM (DR-0026) and says nothing about V_DD, even
    though the same once-per-conversion CDAC event loads all three.
    DR-0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
2026-09-23 layout,power: carry ADC_BLOCK's block-level supply straps on Metal2, making the droop verdict landing-site independent (#388)
    * layout(adc-top): carry the block-level vdd/vss straps on Metal2 instead of Poly2
    `ADC_BLOCK`'s block-level supply continuity ran entirely on the Poly2
    risers `geo.stitch` draws: at 7.3 ohm/sq nominal (15.0 pessimistic), a
    corridor tens of microns long carrying everything one sub-block draws from
    a supply landed at another. That made the DR-0034 droop verdict a property
    of WHICH labelled site a parent lands the supply at rather than of the
    block -- 5.722 mV landed at `COMPARATOR`, 33.552 mV (over the 33 mV budget)
    landed at `ADC_DECODE_BANK_P` (issue #378).
    * `geo.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
    [gen_adc_top.py]
2026-09-23 extract(parasitics): re-extract against the tapped Metal2-strapped GDS, retire the body-tie rewrite, and re-run all five post-layout campaigns (#390)
    Two layout changes landed without the parasitics directory absorbing either:
    DR-0035 (#356 / PR #384) drew an n+ tap in all 25 Nwell islands and closed
    and strapped both substrate-tie rings, and DR-0037 (#378 / PR #388) moved the
    block-level vdd/vss straps onto Metal2. cells.json still pinned the pre-#356
    bytes, so run_extract_parasitics.py refused to mint anything and the whole
    directory was a standing disclosure.
    Re-extracted under the same pinned klt (0.5.0+gb15edf5e3a2e) the merged
    DRC/LVS records of #384/#388 used, and re-pinned cells.jso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
2026-09-23 sim(vcm): re-run the ratified decks against a real V_cm network at full PVT (#358) (#391)
    * sim(vcm): parametrize the V_cm variant generator and add the full-PVT campaign driver (#358)
    `gen_vcm_variant.py` hardcoded `BASELINE_DECK` to `sim/adc-inl-dnl/`'s deck,
    so it could only emit a V_cm-network variant of that one testbench. Every
    deck in this repo that sources V_cm from an ideal supply spells it with the
    identical `vcms vcmn 0 dc {vcm}` anchor, so a single `--deck` argument opens
    the generator to all of them; the existing hit-count-must-be-1 assertion is
    now evaluated per-deck, and the generated header states honestly whether the
    target deck carries DR-0002's own V_REF R||L+C network to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
2026-09-23 docs(sim): reconcile the characterization summary's Supply row with DR-0036's proposed V_DD decoupling budget (#394)
    * docs(sim): reconcile the characterization summary's Supply row with DR-0036
    `sim/characterization-summary.md`'s contract is one row per ratified
    `README.md#target-specification` row, and its Supply row still read as of the
    `93ddfe3` full re-read. PR #387 (issue #379) rewrote the ratified Supply row
    after that re-read, to carry DR-0036's external decoupling figure (>= 40 nF at
    the V_DD pin), its source-impedance budget (<= 3 Ohm in the switching band,
    Z_vdd ~ <= 1.6 Ohm at the 2 MS/s stretch) and a required-but-unsized on-die
    local decoupling term inside ADC_BLOCK. Issue #38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
2026-09-24 signoff: check README.md's current-record pointer instead of hand-maintaining it (#397) (#398)
    `signoff/README.md`'s "Current verdict" pointer, and the second citation of
    the same record in the per-row-reasoning paragraph, both named record
    `20260923-114030-904af96` — two re-grades stale on `main`
    (`20260923-130547-7256414`, then `20260923-142807-f58df2b` from #389/PR
    #394). Nothing failed, because neither intervening re-grade moved a row: the
    verdict block it printed was still accidentally true while pointing a reader
    at a record that does not describe the pinned inputs.
    Both citations are now re-pointed at `20260923-142807-f58df2b` (the tip of
    the `Supersedes` chain, and the record `fre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
2026-09-24 fix(sim): correct the V_cm ammeter polarity and withdraw the sign-flipped p_total figure (#396)
    * sim(vcm): flip the V_cm ammeter to island-side positive so i(vcms) keeps its sign
    `gen_vcm_variant.py`'s `needs_ammeter` branch substituted a 0 V ammeter for
    the ideal V_cm source on decks whose manifest measures `i(vcms)` -- but wired
    it `vcms vcmi vcmd dc 0`, i.e. '+' on the SOURCE side, the opposite of the
    line it replaces (`vcms vcmn 0 dc {vcm}`, '+' on the island node `vcmn`).
    ngspice reports `i(vsrc)` as the current INTO the positive terminal, so a
    source delivering current reads negative -- the convention
    `sim/adc-rail-current/testbench/tb.json` states outright and
    `sim/adc-power/testbe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
    [gen_vcm_variant.py, test_vcm_variant.py]
2026-09-24 signoff: extend the current-record check to the repo-root README.md (#402)
    The repo-root README.md's "Evidence tier" section named record
    20260923-114030-904af96, two re-grades stale on main (superseded first
    by 20260923-130547-7256414, then by 20260924-044244-cda7de50) -- the
    same defect #397 fixed for signoff/README.md, one file over, unnoticed
    for the same reason: none of the intervening re-grades moved a row.
    - README_REL becomes README_CURRENT_RECORD_FILES, a tuple of every file
    whose "Current verdict" pointer --check step 6 machine-checks;
    README_CURRENT_MARKER_MIN becomes a per-file floor (signoff/README.md
    needs 2, README.md needs 1) rather than one global count.
    - The root RE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
2026-10-01 chore: resync installed Loom surfaces
    resynced_by: fleet-resync
    invocation: fleet-resync.sh --fleet-only --push
    <!-- loom:provenance v1 build=unknown 19f4e67fd0a0afbd3d8b6606ca91ceac911377a3 clean prompts=none sweep=none story=none trace=78a5dfbdfd8c530aecd1bb436fd096df host=loom-worker-2 base=415b57e274a4cbf897bc82af76dfda1b97571fb9 run=loom-run/v1:timer:loom-worker-2/fleet-resync:67c759f7ef3c43e38d3fa8d5f19a2dd1 installs=0.19.593 658650a4f0eff932ac66a8f690eaedf8123fc83b -->
    Loom-Story: none
    Loom-Trace-Id: 78a5dfbdfd8c530aecd1bb436fd096df
    Loom-Build: unknown 19f4e67fd0a0afbd3d8b6606ca91ceac911377a3 clean
2026-10-01 chore: resync installed Loom surfaces
    <!-- loom:provenance v1 build=unknown 56435bf476452911283e43940ecfd9a30f804af9 clean prompts=none sweep=none story=none trace=342405c5ebc99bdbf17afbd983c0c41c host=loom-worker-2 base=3cc52f366b483edb6ad1f9890779371ceca5fd5e run=loom-run/v1:timer:loom-worker-2/fleet-resync:20c09f231d424cd5b57ca7991848dd8a installs=0.19.603 8c39bf7cde8a8c03d1aaee441f397c017b6a3a9e -->
    Loom-Trace-Id: 342405c5ebc99bdbf17afbd983c0c41c
    Loom-Build: unknown 56435bf476452911283e43940ecfd9a30f804af9 clean
    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
2026-10-01 chore: resync installed Loom surfaces
    <!-- loom:provenance v1 build=unknown f2868e6b4d60d11a8ab47d25cad9e248229d2f66 clean prompts=none sweep=none story=none trace=4e2766ed5160781df891476246a9be2e host=robb-studio base=14e494ab135a084005c12455b6833f6b86bfa948 run=loom-run/v1:timer:robb-studio/fleet-resync:2d3851d5-1673-43ae-bcc6-e5c971b37f33 installs=0.19.603 74778a6aeea5d9e06b489400942b35f33c8bb766 -->
    Loom-Trace-Id: 4e2766ed5160781df891476246a9be2e
    Loom-Build: unknown f2868e6b4d60d11a8ab47d25cad9e248229d2f66 clean
    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
2026-10-01 chore: resync installed Loom surfaces
    <!-- loom:provenance v1 build=unknown d6714830391f7596338b8de40ee2d0f45dcd12f5 clean prompts=none sweep=none story=none trace=af273f717e759e690d07f372734e9278 host=robb-pro base=f026f64ef156fae4b38a3bd7f8991ace175b670e run=loom-run/v1:timer:robb-pro/fleet-resync:92e2f9ba-d083-411b-833b-ae52d169ef04 installs=0.19.605 6eb2b65a4496b7becb84ef1f944493a541fd01cd -->
    Loom-Trace-Id: af273f717e759e690d07f372734e9278
    Loom-Build: unknown d6714830391f7596338b8de40ee2d0f45dcd12f5 clean
    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
2026-10-01 chore: resync installed Loom surfaces
    <!-- loom:provenance v1 build=unknown 617257919edc1b9b9ee27532c5ec1b8a64523388 clean prompts=none sweep=none story=none trace=cb047565635d880cd4ae328b5cfaaf68 host=loom-worker-1 base=4c7c80ca178c16cccd0766fa29477b2e82e8edfe run=loom-run/v1:script:loom-worker-1/fleet-resync:9973280a-d0de-4196-8cdb-f221825edc41 installs=0.19.609 ff30576dacc8c2734b1c7434bedd29c47122caeb -->
    Loom-Trace-Id: cb047565635d880cd4ae328b5cfaaf68
    Loom-Build: unknown 617257919edc1b9b9ee27532c5ec1b8a64523388 clean
    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
2026-10-01 chore: resync installed Loom surfaces
    <!-- loom:provenance v1 build=unknown 617257919edc1b9b9ee27532c5ec1b8a64523388 clean prompts=none sweep=none story=none trace=dbafe4f8526617aa07c890721298a080 host=robb-studio base=6ef001b2fe83fcfd532ed57fe9077f0b4ab678ff run=loom-run/v1:timer:robb-studio/fleet-resync:1817df66-02cc-4b27-927d-a38485da550a installs=0.19.610 c94891dd526cf6db5ee02045424c6913be522048 -->
    Loom-Trace-Id: dbafe4f8526617aa07c890721298a080
    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
2026-10-01 chore: resync installed Loom surfaces
    <!-- loom:provenance v1 build=unknown a2a39ac2736eb2686e2c65412d939e67c0438a7d clean prompts=none sweep=none story=none trace=fc1a121767151aae5bd7427c683b7db6 host=robb-pro base=05489f686bdd9aaf072f472ca9ca4f46ef385ffe run=loom-run/v1:timer:robb-pro/fleet-resync:708eb7c8-469d-4783-80b7-bafe142df3c4 installs=0.19.612 d25614656adcf70162da95c5e1035e99a0639a1a -->
    Loom-Trace-Id: fc1a121767151aae5bd7427c683b7db6
    Loom-Build: unknown a2a39ac2736eb2686e2c65412d939e67c0438a7d clean
    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
2026-10-01 chore(tooling): update repo-skills to v0.19.5
    Fleet-wide Repo Skills rollout (2026-10-01). compute-drift's axis 6
    reported repo-skills at 11 different versions across the fleet's
    checkouts; this brings gf180-sar-adc from v0.10.0 to v0.19.5 (rjwalters/repo
    @ ff282cd), staging only the installer's own surface.
    Loom-Trace-Id: 038dce5d677bceeeca3c111787ac5b68
    Loom-Build: unknown unknown unknown
    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
2026-10-01 chore: resync installed Loom surfaces
    <!-- loom:provenance v1 build=unknown 126c80914e42f913c4fc778d3ddce96daa2c7a77 clean prompts=none sweep=none story=none trace=15a20fbea7a00d0922b943088c80e19d host=loom-worker-1 base=bde1a37e7e72350d2ac33bd7b01d24b019fd18d8 run=loom-run/v1:script:loom-worker-1/fleet-resync:ecc423da-4625-49de-b25a-692fd669a029 installs=0.19.612 d47e0c57a6bea6f7b61ef9ce62632d70c39ef5d5 -->
    Loom-Trace-Id: 15a20fbea7a00d0922b943088c80e19d
    Loom-Build: unknown 126c80914e42f913c4fc778d3ddce96daa2c7a77 clean
    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
2026-10-01 chore: resync installed Loom surfaces
    <!-- loom:provenance v1 build=unknown 126c80914e42f913c4fc778d3ddce96daa2c7a77 clean prompts=none sweep=none story=none trace=a0a42bd10fcfa6d7cbcc9c021c406848 host=loom-worker-2 base=d00f10a3491f69d591eb7f682e932f2a98dc336b run=loom-run/v1:timer:loom-worker-2/fleet-resync:9e174e6bb0fa41d786e4a86e45632b6f installs=0.19.612 6f0871dc66e62b36d8382ced980d2805bfd97e50 -->
    Loom-Trace-Id: a0a42bd10fcfa6d7cbcc9c021c406848
    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
2026-10-01 chore: resync installed Loom surfaces
    <!-- loom:provenance v1 build=unknown 6f3411c8a63e68097dde01bce8a8422230f54218 clean prompts=none sweep=none story=none trace=9aa0a46bb352b9665fdaa5f5b3b85dd7 host=robb-pro base=6e6f5d920be28e3827cb039e0840465a6628da91 run=loom-run/v1:timer:robb-pro/fleet-resync:ca419e1d-6646-4678-ac7a-b263e4b5119e installs=0.19.612 7731400b3e3e1df39074564166edf656feb0999c -->
    Loom-Trace-Id: 9aa0a46bb352b9665fdaa5f5b3b85dd7
    Loom-Build: unknown 6f3411c8a63e68097dde01bce8a8422230f54218 clean
    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
2026-10-02 chore: resync installed Loom surfaces
    <!-- loom:provenance v1 build=unknown 13c0a3ef467a888520a6529ab34486ab8be826be clean prompts=none sweep=none story=none trace=41356080f367e491d5ff03f17bb98c27 host=loom-worker-2 base=f600ff7ff493e33c8cbd0a6098f193271ae34107 run=loom-run/v1:timer:loom-worker-2/fleet-resync:44455fbcbab745abb92cea192fafbb1d installs=0.19.614 3c79f7b1d0cc14723e049cff4250ff7330804326 -->
    Loom-Trace-Id: 41356080f367e491d5ff03f17bb98c27
    Loom-Build: unknown 13c0a3ef467a888520a6529ab34486ab8be826be clean
    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
2026-10-02 chore: resync installed Loom surfaces
    <!-- loom:provenance v1 build=unknown ea2dd21f2ba310ec007d047ddfecc6cd27d220ac clean prompts=none sweep=none story=none trace=f04a67f3922788d2ccdd66578c8d18f9 host=loom-worker-1 base=a64a6b16e596d55ab6b9421672d27a10cd8ef257 run=loom-run/v1:timer:loom-worker-1/fleet-resync:1c3b601dd998488595adc09040c007d4 installs=0.19.614 79f4897c5d3c78dbfc1b022f77d244838dbf4ccb -->
    Loom-Trace-Id: f04a67f3922788d2ccdd66578c8d18f9
    Loom-Build: unknown ea2dd21f2ba310ec007d047ddfecc6cd27d220ac clean
    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
2026-10-02 chore: resync installed Loom surfaces
    <!-- loom:provenance v1 build=unknown 6f3411c8a63e68097dde01bce8a8422230f54218 clean prompts=none sweep=none story=none trace=acb28d0049e0cc75536f96d503f6e814 host=robb-studio base=f665e731520ad0c638a1da23c42782ef82a72978 run=loom-run/v1:timer:robb-studio/fleet-resync:85d2b1b5-e81d-40c3-ab6a-9a00efbc4ee2 installs=0.19.616 d86523eeadb32b95777f3cd3a76dd2f72f0bf792 -->
    Loom-Trace-Id: acb28d0049e0cc75536f96d503f6e814
    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
2026-10-02 chore: resync installed Loom surfaces
    <!-- loom:provenance v1 build=unknown 2b50bd69eddd038dd738465aa58a9ebca11410ac clean prompts=none sweep=none story=none trace=324e4f607054d0396cfdf8fdc01e93ae host=robb-pro base=0e107d6f8355a3a93b27144ef8e9d4c35a742c8d run=loom-run/v1:timer:robb-pro/fleet-resync:a63799f1-2ad7-4946-b81d-2ec231bc2d2f installs=0.19.617 81cb2ad7e091b19d6a2b95d1add6938c2100d46b -->
    Loom-Trace-Id: 324e4f607054d0396cfdf8fdc01e93ae
    Loom-Build: unknown 2b50bd69eddd038dd738465aa58a9ebca11410ac clean
    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
2026-10-02 chore: resync installed Loom surfaces
    <!-- loom:provenance v1 build=unknown 00d92b326aed50280cd90dc116b7caec27668251 clean prompts=none sweep=none story=none trace=9a5d23cc82b6d3a1c83bfee47bd04970 host=loom-worker-2 base=27bb71bc05c691c5ed287e10411c74f0905666eb run=loom-run/v1:timer:loom-worker-2/fleet-resync:12136a7a025d49f3a60b5edb04a3ff81 installs=0.19.619 4c0f505e4f0b76f8ccec07bda6d8b839030c077b -->
    Loom-Trace-Id: 9a5d23cc82b6d3a1c83bfee47bd04970
    Loom-Build: unknown 00d92b326aed50280cd90dc116b7caec27668251 clean
    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
2026-10-02 chore: resync installed Loom surfaces
    <!-- loom:provenance v1 build=unknown 456dad6d90259846313dc3bb80bf4e5471ef2d76 clean prompts=none sweep=none story=none trace=bb9688c03fb5211d06f48c8838a5505c host=robb-studio base=1732e98c03cf0c25984766ba2c7e4107466be572 run=loom-run/v1:timer:robb-studio/fleet-resync:e965c017-8ec7-485d-b46e-aeb399b81fb4 installs=0.19.620 0d28ba49f5a88fdb37271de9cb0144eb3442c6e3 -->
    Loom-Trace-Id: bb9688c03fb5211d06f48c8838a5505c
    Loom-Build: unknown 456dad6d90259846313dc3bb80bf4e5471ef2d76 clean
    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
2026-10-02 chore: resync installed Loom surfaces
    <!-- loom:provenance v1 build=unknown 6c6d2b6565dc13eff4c6811b9c670f452106516b clean prompts=none sweep=none story=none trace=539be979ae694d66ede516a7b5d17e41 host=robb-pro base=a0940be3a17866abce4fa53c8e7a48de845f93c7 run=loom-run/v1:timer:robb-pro/fleet-resync:9444d216-de08-442f-8352-ba59f6e81bb3 installs=0.19.621 a90dc1d794eb9ff70aaf939ebf495abe716f3bdd -->
    Loom-Trace-Id: 539be979ae694d66ede516a7b5d17e41
    Loom-Build: unknown 6c6d2b6565dc13eff4c6811b9c670f452106516b clean
    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
2026-10-02 chore: resync installed Loom surfaces
    <!-- loom:provenance v1 build=unknown f6d28134bfe476967e005d97424073085f55e8a3 clean prompts=none sweep=none story=none trace=27eb90670d441065f593e941066ee005 host=loom-worker-2 base=0e2046a16997b7e6fd78495e4e3b112e1599010f run=loom-run/v1:timer:loom-worker-2/fleet-resync:04001bba930241cf9e325bf304a9270a installs=0.19.623 ccc19c2bbe2aa65328427730fa53f70eb56128c6 -->
    Loom-Trace-Id: 27eb90670d441065f593e941066ee005
    Loom-Build: unknown f6d28134bfe476967e005d97424073085f55e8a3 clean
    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
2026-10-02 chore: resync installed Loom surfaces
    <!-- loom:provenance v1 build=unknown bc461736314499b6c2c4c0ad51fb2294f60336f5 clean prompts=none sweep=none story=none trace=c3ea68717dd3a908dbbd60a35bc8b5d6 host=robb-studio base=47be98bd639517f8318d54bf9d1d68252491b927 run=loom-run/v1:timer:robb-studio/fleet-resync:8d4c49e2-3258-4080-b0c8-082499053654 installs=0.19.623 a50aaf70069f8897c41a64b7d90783c5ab8294e0 -->
    Loom-Trace-Id: c3ea68717dd3a908dbbd60a35bc8b5d6
    Loom-Build: unknown bc461736314499b6c2c4c0ad51fb2294f60336f5 clean
    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
2026-10-02 chore: resync installed Loom surfaces
    <!-- loom:provenance v1 build=unknown bc461736314499b6c2c4c0ad51fb2294f60336f5 clean prompts=none sweep=none story=none trace=8bee8a664bfc89e0bbfbb3c2de7342ba host=loom-worker-2 base=e62d7015604883f37caa322bafe77605df700813 run=loom-run/v1:timer:loom-worker-2/fleet-resync:de2ceceb48ea4927a1334d08dc0082fe installs=0.19.624 5f49564fa78ae06f8c48d5224dae9ded04200bb7 -->
    Loom-Trace-Id: 8bee8a664bfc89e0bbfbb3c2de7342ba
    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
2026-10-03 chore: resync installed Loom surfaces
    <!-- loom:provenance v1 build=unknown 752d316233ed1a3da9e4f69ad760eb99bb477747 clean prompts=none sweep=none story=none trace=7851839b67c00a023e97cbdea1f580e1 host=robb-pro base=9fef9d5b4f3199cf67d14d1a7fe96f3dc0b1cc6b run=loom-run/v1:timer:robb-pro/fleet-resync:ae492b66-dca0-4da4-acab-8d26778f2d5c installs=0.19.624 121fac45f5006879bf58a18c951b9243d9099a18 -->
    Loom-Trace-Id: 7851839b67c00a023e97cbdea1f580e1
    Loom-Build: unknown 752d316233ed1a3da9e4f69ad760eb99bb477747 clean
    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
2026-10-03 chore: resync installed Loom surfaces
    <!-- loom:provenance v1 build=unknown b34a08286a42f47f917ec46647d4d167c1f5207c clean prompts=none sweep=none story=none trace=a8e453124b899b440f42c9d83837c7b6 host=loom-worker-2 base=5c2d2a2397dac8770e82066b8993b2114e4c44a4 run=loom-run/v1:timer:loom-worker-2/fleet-resync:f02dd5df715347fe90fe14b9353a1b66 installs=0.19.624 98c193cf0d12d68d3770edc1baad808c40bb5fd4 -->
    Loom-Trace-Id: a8e453124b899b440f42c9d83837c7b6
    Loom-Build: unknown b34a08286a42f47f917ec46647d4d167c1f5207c clean
    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
2026-10-03 chore: resync installed Loom surfaces
    <!-- loom:provenance v1 build=unknown 3437cece5ab759f772122f8d18a6d2f05d246cde clean prompts=none sweep=none story=none trace=1bd6b75d1c0daff2b433adf5999546a3 host=loom-worker-1 base=a66d519166eaf16af22e213fb5648d12ed0c81a5 run=loom-run/v1:timer:loom-worker-1/fleet-resync:4c0abac1c29646eaa8502afa223bdd2b installs=0.19.624 0162badc662fb30c070e70611aa8ff74a8486d54 -->
    Loom-Trace-Id: 1bd6b75d1c0daff2b433adf5999546a3
    Loom-Build: unknown 3437cece5ab759f772122f8d18a6d2f05d246cde clean
    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
2026-10-03 chore: resync installed Loom surfaces
    <!-- loom:provenance v1 build=unknown 4a837731e7c550b7c0a339f295dc627ada67dbc0 clean prompts=none sweep=none story=none trace=fe84c9b169d979d00d78d11178a426a1 host=robb-pro base=835858a5ad8c946eccf3e6f2a23e77a906b93f4d run=loom-run/v1:timer:robb-pro/fleet-resync:a057372b-b02f-45ac-b297-ca847c70b0fc installs=0.19.634 e54b8a76ee0a907fb3c7fec91e10b0d6fccfbcc7 -->
    Loom-Trace-Id: fe84c9b169d979d00d78d11178a426a1
    Loom-Build: unknown 4a837731e7c550b7c0a339f295dc627ada67dbc0 clean
    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
2026-10-03 chore: resync installed Loom surfaces
    <!-- loom:provenance v1 build=unknown 8c947aea0026cdb7cda97ea20eea706c4daaf058 clean prompts=none sweep=none story=none trace=92f6c0e06b16dbd125642521ab3357c8 host=loom-worker-2 base=835858a5ad8c946eccf3e6f2a23e77a906b93f4d run=loom-run/v1:timer:loom-worker-2/fleet-resync:8b9c88fa9d4c443197e74a90600bb0c7 installs=0.19.636 e41edfbb52c13982f7d8b0577f42957427a6514c -->
    Loom-Trace-Id: 92f6c0e06b16dbd125642521ab3357c8
    Loom-Build: unknown 8c947aea0026cdb7cda97ea20eea706c4daaf058 clean
    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
2026-10-03 chore: resync installed Loom surfaces
    <!-- loom:provenance v1 build=unknown 28040ed11a4369e20f3b7b0154a3fb2a2c35d38c clean prompts=none sweep=none story=none trace=0cd87d01c45d97a2ee57a99363fc0db2 host=robb-studio base=057ac8ff0ac5d6eb4893d99f96e8992ea3c72ab0 run=loom-run/v1:timer:robb-studio/fleet-resync:74b93657-6b04-4ac5-bc77-e0a1682b0595 installs=0.19.636 e41edfbb52c13982f7d8b0577f42957427a6514c -->
    Loom-Trace-Id: 0cd87d01c45d97a2ee57a99363fc0db2
    Loom-Build: unknown 28040ed11a4369e20f3b7b0154a3fb2a2c35d38c clean
    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
2026-10-03 chore: resync installed Loom surfaces
    <!-- loom:provenance v1 build=unknown 388c7fe0cad997f7a887f70c9f2cfe8781a2d512 clean prompts=none sweep=none story=none trace=2046ffd42f138a06b914f34851de3440 host=loom-worker-2 base=faca60e3a17a71a3eb804d63712e6ce6fac5d1e8 run=loom-run/v1:timer:loom-worker-2/fleet-resync:17c9456bb1934c70a545b12081496cce installs=0.19.647 d1fe5dead4202be12a964ab891fd5980e7836170 -->
    Loom-Trace-Id: 2046ffd42f138a06b914f34851de3440
    Loom-Build: unknown 388c7fe0cad997f7a887f70c9f2cfe8781a2d512 clean
    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
2026-10-03 chore: resync installed Loom surfaces
    <!-- loom:provenance v1 build=unknown 8078c29e691123d91cd761a786f99cfd25f1809d clean prompts=none sweep=none story=none trace=45869a6374635c036a11a6f379fe31a4 host=robb-pro base=32906a74afb90cbabf1521fe40165e666afddd62 run=loom-run/v1:timer:robb-pro/fleet-resync:b0a94991-052d-4e7d-ba2b-78b971096849 installs=0.19.647 709ca4396e074e5a4d1c5e19721f6ddac7154ca2 -->
    Loom-Trace-Id: 45869a6374635c036a11a6f379fe31a4
    Loom-Build: unknown 8078c29e691123d91cd761a786f99cfd25f1809d clean
    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
2026-10-03 chore: resync installed Loom surfaces
    <!-- loom:provenance v1 build=unknown f9cba29b0602624a23daa17ae04d31d82e10fa91 clean prompts=none sweep=none story=none trace=754b3688f97b6c34894d8cfbf272b81a host=loom-worker-1 base=4f52592ef0acc1941d6a30b106b49b6345a3c57c run=loom-run/v1:script:loom-worker-1/fleet-resync:11eb117a-9ff3-4411-88d4-fdd7d6748639 installs=0.19.649 6f2f13b1c31ce420e2250ae040d8e1050c0e761b -->
    Loom-Trace-Id: 754b3688f97b6c34894d8cfbf272b81a
    Loom-Build: unknown f9cba29b0602624a23daa17ae04d31d82e10fa91 clean
    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
2026-10-03 chore: resync installed Loom surfaces
    <!-- loom:provenance v1 build=unknown f9cba29b0602624a23daa17ae04d31d82e10fa91 clean prompts=none sweep=none story=none trace=544a028e3829d4020b8aaa144e5fa628 host=robb-studio base=80125e280436c54b984508319cf1e8a1f82a0b08 run=loom-run/v1:script:robb-studio/fleet-resync:5b5b8b83-7139-447d-88bd-417dcf375aa6 installs=0.19.649 6f2f13b1c31ce420e2250ae040d8e1050c0e761b -->
    Loom-Trace-Id: 544a028e3829d4020b8aaa144e5fa628
    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
2026-10-03 chore: resync installed Loom surfaces
    <!-- loom:provenance v1 build=unknown f9cba29b0602624a23daa17ae04d31d82e10fa91 clean prompts=none sweep=none story=none trace=1057aaaf811f6dd2d64a3bb6d4b3ac49 host=robb-pro base=780a659e2215d2be59912c36c6265d19ad386104 run=loom-run/v1:timer:robb-pro/fleet-resync:785c1ea0-d7f2-4810-99e9-cd9368aebe0c installs=0.19.649 2118aabb5a925f1ec4669b4d3d31176a46d8f2a6 -->
    Loom-Trace-Id: 1057aaaf811f6dd2d64a3bb6d4b3ac49
    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
2026-10-03 chore: resync installed Loom surfaces
    <!-- loom:provenance v1 build=unknown 72f61d9aa0fe08f1ef59f1a97a314e474455801e clean prompts=none sweep=none story=none trace=577d2185973ec59f059fa15bf5b5e514 host=loom-worker-1 base=368c4cd9b7c867af790eafa198277ab8e67b6034 run=loom-run/v1:script:loom-worker-1/fleet-resync:5728a930-137f-4d2f-a962-1cdd7a6a1d46 installs=0.19.652 235a64727b907d65529151af0a962b14f16462a0 -->
    Loom-Trace-Id: 577d2185973ec59f059fa15bf5b5e514
    Loom-Build: unknown 72f61d9aa0fe08f1ef59f1a97a314e474455801e clean
    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
2026-10-03 chore: resync installed Loom surfaces
    <!-- loom:provenance v1 build=unknown 72f61d9aa0fe08f1ef59f1a97a314e474455801e clean prompts=none sweep=none story=none trace=845aaa0eb340f80f12095e2e8b421ed1 host=robb-pro base=c59ecd522eeb801148e54470cd4ca633356f58b9 run=loom-run/v1:script:robb-pro/fleet-resync:344add4b-df8a-49e8-8563-2765673acc76 installs=0.19.652 235a64727b907d65529151af0a962b14f16462a0 -->
    Loom-Trace-Id: 845aaa0eb340f80f12095e2e8b421ed1
    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
2026-10-03 chore: resync installed Loom surfaces
    <!-- loom:provenance v1 build=unknown 61870b40779d205c1555e801c6e1d95df083cdea clean prompts=none sweep=none story=none trace=cfd2c16d2cd3651ad0d068a28bbf62b8 host=loom-worker-1 base=baf02b305b6dc01df0a48020cd2e780d20bcbbdd run=loom-run/v1:timer:loom-worker-1/fleet-resync:fd27683751ca428cb28a8d58a04fc51a installs=0.19.652 235a64727b907d65529151af0a962b14f16462a0 -->
    Loom-Trace-Id: cfd2c16d2cd3651ad0d068a28bbf62b8
    Loom-Build: unknown 61870b40779d205c1555e801c6e1d95df083cdea clean
    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
2026-10-07 sim(supply): V_DD pin-network variant generator and paired-arm driver (#393)
    gen_vdd_variant.py replaces the ideal vddt/vddd/vddc island sources with ONE
    shared R||L + C_dec pin network at DR-0036's budget (3 ohm, 40 nF, R-L corner
    at the 1 MHz conversion rate), keeping each island as a 0 V ammeter.
    run_full_pvt.sh mirrors sim/vcm-full-pvt/, pinning each extracted row's ideal
    arm to its governing record's sha256. compare_vdd.py reuses compare_vcm.py's
    arithmetic (now label-parametrized; default output byte-identical).
    Loom-Story: 2AMLogic/gf180-sar-adc#393
    Loom-Trace-Id: bd026a70f42034d0f7c1c857fb863506
    Loom-Build: 0.19.820 a7b306971c5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
    [test_vdd_variant.py]
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2026-10-08 ci: enforce append-only records mechanically (#414)
    Add sim/tools/check_append_only_records.py (merge-base diff; fails on
    modified/renamed/deleted/type-changed files under any records/ dir),
    wire into check:ci and ci.yml (fetch-depth: 0), negative-control test,
    allowlist escape hatch, and sim/README.md docs.
    Loom-Story: 2AMLogic/gf180-sar-adc#414
    Loom-Trace-Id: 53292ebeb9329861bacfe2a2eead2f02
    Loom-Build: 0.19.868 ee904e1c151bc9cf15b0eb55dfe9d57ad6136cff clean
    [test_check_append_only_records.py]
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2026-10-08 feat(sim): refuse explicit local multi-point grids on dispatch hosts
    --backend local on a multi-point grid under KLT_SIM_BACKEND=batch|remote is
    now an error unless --allow-local-grid is given.
    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
    [test_batch.py]
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2026-10-08 fix(sim): always pass the off-host backend to klt sim explicitly
    klt 0.5.x ignores $KLT_SIM_BACKEND and ran the smoke grid locally when the
    backend was left implicit. submit() now refuses an implicit backend.
    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
    [test_batch.py]
2026-10-08 fix(sim): do not let the fleet pin check mask per-point errors when no point ran
    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
2026-10-08 Dedupe resolve_klt()/latest_record() into layout/klt_env.py (#420)
    Loom-Story: 2AMLogic/gf180-sar-adc#420
    Loom-Trace-Id: bbfa680e23a5933dfa9580904425113c
    Loom-Build: 0.19.898 3d55b9a1669c132d130d98f10a292c1325322c30 clean
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2026-10-08 Add block-scoped klt pex testbench and runner for ADC_BLOCK (#428)
    sim/adc-block-pex/testbench/ holds a klt-native testbench: one DR-0014
    sample/redistribute/decide sequence through the whole ADC_BLOCK, plus a
    pin-matched schematic ADC_BLOCK subckt that is pure wiring of the
    design/ library. The 117-point PVT request is committed alongside it.
    layout/adc-top/parasitics/run_pex_adc_block.py runs klt pex 0.7.0, the
    PyPI release, which is checked by identity. It passes --pins to demote
    the comparator's LVS-only XCMP.pon/pop labels, and --deck-option to fix
    the deck flavours explicitly. It checks that the extracted header equals
    the schematic one, and it refuses a report in which nothing simula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
    [run_pex_adc_block.py]
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2026-10-08 signoff: mint record 20261008-185541-ad38795c; T1 item 7 (analog) met on one PVT point (#428)
    Ran run_signoff.py --regen under the pinned grader (0.5.0+g67d617f).
    8/22 T1 rows are now met. Only 7.analog moved, check_failed -> met. The
    new record states that the cited klt pex run is one PVT point and
    explains why: the batch fleet runner (klt 0.5.0) refuses 0.7.0 clients.
    It also states what the met does not claim.
    The current-record pointers and item-7 rows are updated in
    signoff/README.md and README.md, and the parasitics README has a
    section on the retry. The README-status unit test no longer hardcodes
    the T1 met count. Generic frictions are filed upstream as
    klayout-tools#2871 and #2872.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
    [test_check_readme_status.py]
2026-10-08 Reconcile klt pins onto PyPI klayout-tools==0.6.0 where tested; run layout runners nightly (#426)
    Layout (DRC/LVS/parasitics) and power now pin klayout-tools==0.6.0; ERC and
    signoff stay on 67d617f because run_erc.py --check fails under 0.6.0.
    Drops the stale 'no PyPI release' claims; adds nightly klt-layout job.
    Loom-Story: 2AMLogic/gf180-sar-adc#426
    Loom-Trace-Id: 3a922716ef3b9d62e30f27e41736e509
    Loom-Build: 0.19.895 9b30d293bcba1e79d49cabfc1c5bb5b6f4c0dc77 clean
2026-10-08 docs: bring klt pex statements in the two summaries current after #428; re-anchor signoff item 8 (8/22 unchanged)
    Append dated updates to sim/characterization-summary.md and
    sim/extracted-delta-summary.md section 9, label the comparator-scoped
    failure/FAIL historical, disclose one nominal PVT point of 117 and the fleet
    batch_runner_version_mismatch limit. Refresh item-8 envelopes, re-pin, mint
    signoff record 20261008-202455-4b5693ef, re-point current-record pointers.
    Loom-Story: 2AMLogic/gf180-sar-adc#432
    Loom-Trace-Id: 1421fa768961b69027544e8257a9e2cc
    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
2026-10-08 adc-enob-fft: record blocked #430 temperature-coverage attempt; per-corner noise composition script (#430)
    0 of 27 declared points completed: fleet client/runner skew (exit 87), PDK include
    unresolved on runner (klayout-tools#2882), host ngspice 42 < pinned 46 for a local
    point. Hot-only coverage limit unchanged; FAIL verdicts untouched.
    Loom-Story: 2AMLogic/gf180-sar-adc#430
    Loom-Trace-Id: 23b3d32d06883f5681721f6d10754433
    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
2026-10-09 Issue #430: record fleet re-open (2-point preflight passes) and capacity refusal of the cold leg
    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
2026-10-09 Issue #429: record 0.6.0-client fleet re-check of x1.0 control (PDK include failure)
    Part of #429
    Loom-Build: 0.19.950 72047016af9d66c08f900bb94c642a66dfd75fc5 clean
    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
2026-10-09 Issue #430: record 0.7.0-client batch preflight version mismatch (no points run)
    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
2026-10-09 docs: refresh work log and current issue plan
2026-10-09 Issue #438: generate and CI-check deterministic decision-record status index
    Loom-Story: 2AMLogic/gf180-sar-adc#438
    Loom-Trace-Id: b2214d2a0ac41f7bbcd398613d56ae92
    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
    [test_decision_record_status.py]
2026-10-09 Issue #427: qualify batch path for ADC_BLOCK offset Monte Carlo (pilot, outcome a)
    Comparator-inclusive ADC_BLOCK input-offset estimator (33-conversion
    differential staircase per mismatch draw, extracted netlist reused from
    adc-block-pex), native klt monte_carlo request, bounded batch pilot with
    null control and repeat, full-campaign sample-size/confidence protocol.
    Pilot ran under batch.runner_version_check=warn (fleet runner klt 0.5.0 vs
    client 0.7.0); the default-mode refusal is committed. Offset row stays
    Unmeasured; no spec change. Upstream: klayout-tools#2928, #2929.
    Loom-Story: 2AMLogic/gf180-sar-adc#427
    Loom-Trace-Id: 21c0639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
    [test_adc_offset_mc.py]
2026-10-09 Issue #453: DR-0038 proposed - offset-error definition for the comparator-inclusive population
    Loom-Story: 2AMLogic/gf180-sar-adc#453
    Loom-Trace-Id: e47564bb6144c32c82a9ae80fb942885
    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
2026-10-09 Issue #454: campaign-ready offset-MC estimator, per-corner requests, record writer
    - gen_pilot.py: 45 per-corner screening requests (n=30, declared base seed,
    sha256-derived unique seed schedule, README 6.3 grid) + schedule --check;
    screening testbenches with widened range (-6..+14 mV) and ascending +
    descending staircase, inputs stacked on vcm so supply overrides work.
    - analyze_pilot.py: descending readout; hysteresis = up - down threshold.
    - sample_size.py: --runtime-plan for the per-corner split.
    - record_writer.py: append-only record (json+md) with full provenance; rejects
    duplicate seeds, flags all-identical populations as path failure, reports
    failed/censored draws and lag-1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
    [test_adc_offset_mc_record.py]
2026-10-09 Issue #430: record batch preflight refused by fleet concurrency cap (no points run)
    One 2-point --no-write batch preflight at 08:20 UTC was refused at
    provisioning (8 instances running, BATCH_MAX_CONCURRENT_INSTANCES=8); no
    job id issued, no retry, no local fallback. 0 of 27 points banked;
    README, spec, hardware and historical records untouched.
    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
2026-10-09 sim: machine-check characterization-summary evidence citations (#437)
    Add sim/tools/check_characterization_summary.py (stdlib-only) and wire it
    into `npm run check:ci` and headless CI. It parses the `Source (dated)`
    column of the per-spec-row table, requires a citation-local
    `<!-- evidence role=... mode=... -->` marker on every sim-record link
    (mode cross-checked against the record's own Netlist provenance), and fails
    a governing/current citation that has a same-mode Supersedes successor or a
    newer same-mode, same-campaign record that is neither linked in the row nor
    covered by an exact (row, mode, cited, newer) entry, with a reason, in
    sim/tools/characterization_citation_exceptions.json. Am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
    [test_check_characterization_summary.py]
2026-10-09 Issue #430: record preflight re-check, runner klt 0.5.0 still rejects 0.7.0 client (no points run)
    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
2026-10-09 sim: same-row historical link no longer classifies a newer record (#437)
    Address PR #462 review. check() treated any newer same-campaign, same-mode
    record linked in the same row as classified, whatever its role marker, so a
    newer record added as role=historical beside an older governing citation
    passed silently. Only same-row governing/current citations (which get their
    own freshness check) now count; a historical one needs an exact exception.
    - regression tests: stale governing + newer historical in one row fails
    UNCLASSIFIED; the same row with a precise exception passes
    - docstring and the summary's sync-section paragraph describe the new rule
    - the summary edit re-pins both item-8 enve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
    [test_check_characterization_summary.py]
2026-10-09 Issue #430: address Judge feedback on preflight-mismatch note
    - Drop the untested 0.5.0-client remedy (0.5.0 has no batch backend);
    note 0.6.0 is the only client that passed the gate and is not a
    guaranteed fix (hit klayout-tools#2882 on 10-08).
    - Reword: the version gate was the only failure observed; later stages
    (PDK include, Spot capacity, concurrency cap) were not reached.
    - Label both netlist hashes with their sources: deck file b0baf132...
    (matches the record), as-generated input dfa76c61... (copied from the
    fleet-reopened note, not recomputed in this run).
    Loom-Trace-Id: 23b3d32d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
2026-10-09 Issue #430: append 09:04 UTC re-check, 0.6.0 client now fails klayout-tools#2882 again (no points run)
    Host 0.7.0 client: batch_runner_version_mismatch (klt-sim-b5b7038edccf).
    Throwaway 0.6.0 client: passes the gate, then PDK include failure
    (klt-sim-678b8719836e). 0 of 27 new points; coverage unchanged.
    Part of #430
    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
2026-10-09 spec: assess input-pair cascode applicability against ADC kickback evidence (#443)
    Add comparator-budget-memo section 5.3 and cross-link from DR-0015
    alternatives. Recommends retaining the current comparator; documents
    floating-CDAC vs 1 kohm metric difference, numerical floor, missing
    coverage, and falsifiable checks for a separately scoped experiment.
    Also corrects section 5.2 table to the governing 45/45 record.
    Loom-Story: 2AMLogic/gf180-sar-adc#443
    Loom-Trace-Id: 9aa2f487aebe6deb3ed28f663bd8e15a
    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
2026-10-09 docs: reconcile SAR routing/STA status and the fixed #266 power-corner warning (#457)
    Root README Schematics row: replace "place-and-route and STA closure are
    not done" with the standalone routed macro and the routed-DEF STA record
    (20260915-093934-7ab8971.mcu7t5v0.sta_postroute: setup/hold PASS at five
    mcu7t5v0 library corners, no SPEF, ideal clock), keeping LVS, integration
    and gate-level replay as not done.
    Root README independent-verification section: the adc-power schematic
    baseline is no longer an expected make-characterize failure; describe the
    #266 MOS-corner override in sim/characterize.sh (PR #268) and link its
    clean-tree resolution record 20260826-085142-155595d.
    layout/adc-top/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
2026-10-09 sim(dr0014-sampling): isolate the #393 gain-error control-arm delta (#459)
    The #393 ideal-supply control arm (20261007-071907-800bf53) reads
    tp_inj_signal_dep_lsb at 0.0010063 LSB against the governing record's
    (20260923-104443-904af96) 0.000981002 LSB at ff_-40c_3.63v. This is
    answered from committed records, snapshots and raw corner logs only; no
    simulation was run.
    Cause: a solver-path difference between two ngspice-46 execution
    environments (Linux host family with no compat mode, vs a macOS
    workstation with ngspice front-end mode 'hs a').
    - From byte-identical inputs, the t=0 operating points differ only at
    floating-point residue (<= 8.7e-11 LSB).
    - At 24 of 27 corners the transient t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
2026-10-09 docs(#459): correct over-claims from PR #469 review, re-mint signoff
    Judge review of PR #469 found sentences that claimed more than the
    committed evidence shows. No simulation was run.
    - "3 corners agree to <= 1e-10 LSB on every measurement" was wrong.
    The trace script now prints the largest |B-A| over all 43 m_*
    measurements per corner (.txt regenerated, reproduces byte-for-byte):
    tt_27c_3.63v 3.66e-8 (tp_inj_n_l0_lsb), ss_27c_2.97v 3.83e-7
    (samp_inl_l2_lsb), ff_27c_3.63v 1.0e-5 (dres_dc1_lsb, one last-digit
    count; next largest 1.03e-7), against 1.0e-4..6.9e-3 LSB at the other
    24 corners. The "same circuit/models/options" inference is softened to
    "consistent with, not proven"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
2026-10-09 Issue #429: second fleet probe of x1.0 control, same PDK include failure (blocker evidence)
    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
2026-10-09 ci: machine-check relative markdown links (#472)
    Add sim/tools/check_markdown_links.py (stdlib-only) with unit test, a reasoned
    allowlist, and a PDK-free step in the checks job. Fix the docs/status-history
    links that were root-relative after the move into docs/ (path-only).
    Records under records/ are append-only, so their broken links are allowlisted.
    Re-run: python3 sim/tools/check_markdown_links.py
    Loom-Story: 2AMLogic/gf180-sar-adc#472
    Loom-Trace-Id: 2ff686919861ed39edab03e28dc3caef
    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
    [test_check_markdown_links.py]
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2026-10-09 DR-0039: correct *.log file count to 5,238 (during evaluation)
    The 440,490,865 B total covers all 5,238 tracked logs; 5,237 was the
    corners/-only count. Re-measured at e40a353e.
    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
2026-10-09 layout/lvs: cite filed klt friction issues in record (#480)
    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
    [run_sar_ctrl_lvs.py]
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2026-10-09 sta(sar_ctrl): extracted-SPEF mode with annotation gate and negative controls (#481)
    Add `sta_sar_ctrl_postroute.py --spef`. It extracts the committed routed
    GDS with `klt extract --parasitics --spef --def-net-names
    --def-net-connections <def> --def-pins <def>`, then times the same fixed
    DEF at the same five corners and the same ideal 62.5 ns clock through
    `klt sta`'s `spef` field. Each corner runs next to a same-toolchain
    unannotated reference, which is checked against the 20260915 baseline.
    A corner is accepted only if klt's annotation_complete is true and
    spef_audit.gate() finds no other defect. That gate covers a static
    SPEF/DEF/Verilog/Liberty agreement audit (units, delimiters, net na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
    [spef_audit.py, sta_postroute_spef.py, sta_postroute_spef_record.py, sta_sar_ctrl_postroute.py, test_flow_env.py, test_spef_audit.py]
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2026-10-09 sim: fail V_CM characterization on incomplete or aborted sweeps (#456)
    Loom-Story: 2AMLogic/gf180-sar-adc#456
    Loom-Trace-Id: a38fd75276d665b2c92d7adc552ef4b3
    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
    [test_vcm_sweep_orchestration.py]
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2026-10-09 signoff: correct sar_ctrl baseline STA parasitics wording, re-mint verdict (#484)
    Baseline post-route STA included no wire parasitics (unannotated, Liberty pin
    capacitance only), not a LEF/DEF RC estimate. Row statuses/reasons unchanged.
    Loom-Story: 2AMLogic/gf180-sar-adc#484
    Loom-Trace-Id: ec88afcd92618407a9f544fb227a751d
    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
2026-10-12 ci(nightly-pdk): record selftest failures on loom-ui
    The selftest job now also posts its result to loom-ui's
    /api/alerts/external (the fleet's alert hub, 2AMLogic/loom-ui#3319) with
    the job's Actions OIDC token: `open` when a scheduled failure files or
    comments on the tracking issue (critical when stage 4's sabotaged-corner
    negative control regressed, else warning), `resolved` on a green run on
    main. Rule nightly-pdk, key selftest; the link is the tracking issue when
    there is one, else the run.
    Best-effort: continue-on-error and warning-only, so it never changes the
    job's result or the issue filing.
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2026-10-14 sim/harness: export the supply axis as one klt request per vdd_val (#505)
    klt rejects corners.supply_v keyed by the vdd_val .param, and re-keying it
    onto the DC rails would leave the clocks, vref/vcm and bridge thresholds at
    nominal. Emit one request per supply value instead, each body binding
    .param vdd_val=<V>, submitted together with klt sim --batch-set; results
    are matched back by the supply of the request that produced them. A
    request without a report becomes error points, never ok.
    Loom-Story: 2AMLogic/gf180-sar-adc#505
    Loom-Trace-Id: 1d1f5017e1872736c58d07c0526790a6
    Loom-Build: 0.19.1159 eda4f971db62b88c66ab797cd0f24f525ffc377a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
2026-10-15 fix(pex): keep PDK-relative models for the batch backend in run_pex_adc_block
    The fleet runner resolves a PDK-relative models block against its own PDK
    root; the host-absolute rewrite fails remotely with batch_job_failed /
    'model library not found'. Also record the fleet job ids and runner-side
    model library (scraped from kept corner decks) in batch records.
    Part of #439
    Loom-Story: 2AMLogic/gf180-sar-adc#439
    Loom-Trace-Id: a46a50cf8f9befb58cc848c2a326fd48
    Loom-Build: 0.19.1161 3187e328c5e0c0ef3342a3c303d4948852cfa665 clean
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2026-10-15 feat(pdk): re-pin open_pdks to f6eeac7, install via ciel, pin-aware PDK search
    sim/toolchain.json is the single pin source; tests and make_record read it.
    Harness searches ~/.ciel before ~/.volare and prefers a tree whose SOURCES
    revision equals the pin; klt_env.resolve_pdk fails on a mismatched or
    unknown revision. nightly-pdk installs ciel==2.6.1 and caches ~/.ciel.
    Loom-Story: 2AMLogic/gf180-sar-adc#514
    Loom-Trace-Id: 64a1b72851f802d1e39db746eef1cc03
    Loom-Build: 0.19.1166 8a9aad12e32504cea9a7c7d2ed774749c487f875 clean
2026-10-15 fix: add VDD/VSS Metal4 straps to SAR macro PDN and extend LVS runner with a supply control
    Metal1 followpins alone left five disjoint VDD rail segments. Add one VDD and
    one VSS full-height Metal4 strap (x=20/160 um, clear of the IO pins), regenerate
    the routed DEF/GDS, and make the transistor-level LVS runner assert a match plus
    a deleted-strap negative control. Macro DRC is unchanged at 208 library-cell
    violations (same as the pre-repair GDS under this klt).
    Loom-Story: 2AMLogic/gf180-sar-adc#485
    Loom-Trace-Id: 49e27abe2637a96a5db65cdf338034f5
    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
2026-10-15 fix(signoff): re-point 3.digital at the post-repair DRC run and regen (#485)
    The Metal4 strap repair regenerates sar_ctrl.gds, so the T1 manifest's
    3.digital citation pinned a stale GDS hash. Cite the new pnr_drc envelope
    (status: violations, 208) and --regen under the pinned klt. The grader
    renders 3.digital unmet/check_failed (7/22, was 8/22); reported as graded,
    no row or spec adjusted. Adds evidence record 20261015-222800-a90cb5ba.
    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
2026-10-17 feat(spef-audit): exempt unannotated outputs only with an independent no-net proof
    Adds DR-0040 and a fail-closed exemption in spef_audit.gate(): an unannotated
    driver passes only if klt calls it floating and a DEF/Verilog/Liberty
    connectivity proof names the same output with no net. Adversarial offline
    tests cover the rejection cases.
    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
2026-10-17 fix: drop edits to signoff-pinned drivers synth_sar_ctrl.py and gen_sar_ctrl_gates_tb.py
    Their sha256 is pinned in signoff manifests; editing them invalidates the
    recorded digital evidence (signoff --check items 1.digital, 9.digital).
    Regenerating evidence is out of scope for a behavior-preserving refactor.
2026-10-17 refactor: import sar_ctrl flow constants from flow_env in the two signoff-pinned drivers
    synth_sar_ctrl.py and gen_sar_ctrl_gates_tb.py drop their local copies of
    TOP/OUT_DIR/REPORTS_DIR/RECORDS_DIR/LIB_TAG and import them from flow_env.
    Resolved values are unchanged. Re-attests item 9, regenerates the signoff
    report (no row moved), re-pins the two sha256 digests in freshness.json and
    adds the evidence record.
    Closes #572
2026-10-20 refactor(layout): retire comparator-only klt pex runner after verifying its recovery recipe
    Remove run_pex_comparator.py, the superseded runner whose klt pex run
    failed structurally (pin-interface mismatch, exit 4) before measuring.
    Document an immutable recovery recipe (checkout 607d6e64, klt 0.2.0 at
    755d3eff, klayout 0.30.10, gf180mcuD open_pdks c6d73a35) verified offline,
    note that the record's repo sha 56fbe50 predates the runner, re-point prose
    references, and add a DR-0022 addendum. sim/comparator-pex/ is unchanged.
2026-10-20 docs(sim): reconcile the bad-loop 45-point grid with its raw logs and plan a capped one-point pilot
    Adds an append-only investigation under sim/sar-logic-timing-gates-bad/: the
    three points the #582 record reports as save_mode retention errors are
    Timestep-too-small aborts; the 42 timeouts carry no ngspice output; the
    retention hint is on all 45 diagnostics; the runner reported the pinned PDK
    while the client resolved another. Reconciles #343, traces klt retention and
    error precedence from source, and specifies an uncommitted, capped
    single-corner diagnostic pilot. No simulation was run; no record, log or deck
    is modified.
    Part of #303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
2026-10-20 fix: leave pinned sim/vdd-switching-event make_record.py untouched
    The analog testbench inventory hash-pins this file; sim/ evidence is
    append-only, so keep its local sha256 copy and restore the pin.
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2026-10-20 fix(signoff): re-pin T1 evidence after #517 touched four pinned files
    Re-mints the item 1/9/10 attestations and runs signoff --regen under the
    pinned klt build; new report and record, no row moves (17/22, 1 n/a).
2026-10-20 sim(acq-leg-width-sweep): add fleet-measured x1.0 control point; record re-qualification status
    First measured point for the sweep (all earlier records are fleet-blocked
    ERROR records), plus a status/delta document listing what was re-qualified
    and what was not, with reasons.
    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
2026-10-20 fix(signoff): re-pin T1 item 8 evidence after #603 edited characterization-summary.md
    Re-pins the item 8 envelopes and manifest pins to the new
    sim/characterization-summary.md bytes and runs signoff --regen under the
    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
2026-10-20 fix(signoff): re-pin T1 item 9 after the comparator-regeneration tb.json rewrite
    Re-attests item 9.analog and runs signoff --regen under the pinned klt build;
    new report and record, no row moves (17/22, 1 n/a).
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2026-10-21 sim(dr0014-sampling): re-qualify the 7 live records under open_pdks f6eeac7 on the batch fleet
    Seven superseding 27-point PVT records (schematic x4, extracted x3) with fleet
    job ids, an old-vs-new delta table and a delta script, plus the 9-point ERROR
    record from a Spot-reclaimed first attempt. Characterization-summary citations
    repointed to the successors with exact citation exceptions; signoff item 8
    re-pin is tracked separately.
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2026-10-21 fix(signoff): re-pin T1 item 8 evidence after #615 repointed characterization-summary.md
    pinned klt build (44cc4232); new report and record, no row moves (17/22, 1 n/a).
    Addresses the Judge's red 'T1 signoff verdict freshness' (#622).
    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
2026-10-23 feat(sim): store new run evidence in the artifact store, commit manifest and record
    Recorded runs of sim/run_corners.py stage the netlist snapshot and per-corner
    logs in git-ignored sim/.work/.stage/, put them with klt artifact put, and
    commit only manifests/artifacts/<bench>-<run-id>.manifest.json and the record.
    The store is probed before simulating and every failure is fail closed (exit
    10, nothing committed). sim/run_store_evidence.py does the same for campaign
    and layout-side outputs. CI validates manifests, refuses non-artifact: URIs,
    committed duplicates of stored bytes and new raw corner output; manifests are
    append-only. Adds DR-0041.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
2026-10-23 fix(signoff): re-pin T1 item 10 after #637 edited ci.yml and sim/README.md
    Re-attests item 10 and runs signoff --regen under the pinned klt build; new
    report and record, no row moves (17/22, 1 n/a).
2026-10-27 feat(sar-logic): add cocotb bench and multi-corner STA mode for sar_ctrl
    Adds a bit-exact cocotb suite for sar_ctrl_a with a klt functional-verification
    request, mutation proposals, and a runner that writes the evidence record, and a
    --multicorner mode on the post-route STA driver that issues one pdk.corners
    request over all five library corners.
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2026-10-27 fix(flow): keep pinned synth_sar_ctrl.py byte-identical; tolerate its local working_tree_dirty
    signoff item 1.digital pins synth_sar_ctrl.py; editing it fails the T1
    freshness gate. Other drivers stay consolidated onto flow_env.
2026-10-27 fix(sar-logic): STA drivers call flow_env.working_tree_dirty directly
    sta_sar_ctrl, sta_sar_ctrl_postroute and sta_postroute_spef referenced
    synth.OWN_OUTPUT_PREFIXES, which synth_sar_ctrl.py (hash-pinned) does not
    define. Import the shared helper and restate the prefix locally, and add
    a test that every synth.<name>/base.<name> a driver uses exists.
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2026-10-28 fix(signoff): re-pin T1 item 8 evidence after #656 edited characterization-summary.md
    pinned klt build (44cc4232); new report and record, no row moves (18/22, 1 n/a).
    Addresses the Judge's red 'T1 signoff verdict freshness' on #657.
    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
2026-10-28 refactor(flow): route sar_ctrl klt calls through flow_env.run_klt_json
    Adds ok_codes/pass_pdk to run_klt_json and replaces the hand-rolled
    place-and-route, drc, synthesize, equiv and extract wrappers. Drops the
    unused klt_version import from prove_no_net_sar_ctrl.py.
2026-10-28 fix(flow): drop synth_sar_ctrl.py change from #659 refactor
    synth_sar_ctrl.py is pinned by the T1 item 1.digital evidence; editing it
    invalidates signoff freshness and re-pinning needs a live synth/equiv run.
    Restore it to main and leave that migration to a follow-up that re-runs the
    flow. Matching test expectation restored.
2026-10-28 fix(flow): assert extract argv tail before slicing in run_extract
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2026-10-31 docs: index superseded evidence records outside records/
    Add a convention to the sim/ append-only rule for listing superseding
    records in the owning directory's README, and index the be1c350 ->
    809ed2c correction in layout/adc-top/economy/README.md.
2026-10-31 sim: re-take sar-logic-timing supply grid on the corrected deck
    New batch-fleet record 20261031-191202-befcce4 (tt, 27 C, 2.97/3.30/3.63 V,
    3/3 PASS, all bounds unchanged) supersedes 20260802-102758-d8a363d, which
    predates the settled-drdy measurement correction. The Clock and Latency
    rows now cite it as governing; the August record stays historical. The
    Clock/schematic citation exception for the October smoke record no longer
    applies and is removed.
2026-10-31 fix(signoff): re-pin T1 item 8 evidence after #684 repointed characterization-summary.md
    Addresses the Judge's red 'T1 signoff verdict freshness' on #684.
    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
2026-10-31 sim(acq-leg-width-sweep): measure 1.1x-2.068x spectral points and write findings
    Fleet-run the five remaining nine-point (125 C) schematic FFT points
    (1.1, 1.25, 1.5, 1.75, 2.068x); with the 2026-10-20 x1.0 control all six
    widths now have records. Collator accepts the fleet's `sNNN` log format and
    fetches artifact-store logs. Dated findings memo: 1.5x/1.75x merit extracted
    follow-up, 1.1x/1.25x do not; ratified Area failure and governing rows
    unchanged.
    Closes #429
2026-10-31 fix(signoff): re-pin T1 item 9 analog evidence after #686 edited analyze_width_sweep.py
    Re-attests the item 9 analog envelope (154/154, PDK-free cold start) and runs
    signoff --regen under the pinned klt build (44cc4232); new report and record,
    no row moves (18/22, 1 n/a). Addresses the Judge's red 'T1 signoff verdict
    freshness' on #686.
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2026-11-01 fix(ci): regenerate extracted decks, update README layout area, skip notched-ring test without real klayout
    - Regenerate 5 committed tb_*_extracted.spice decks from their generators
    - README Status Area/Layout rows: 0.151827 -> 0.128765 mm^2 (area.json block_total); Area stays FAIL vs < 0.1 mm^2
    - test_check_readme_status: negative-control string follows the new figure
    - test_notched_guard_ring: skip when klayout.db lacks Box/Region
2026-11-04 sim: re-qualify device-comparator-gm-id under open_pdks f6eeac7
    Mint a new 45-point full-PVT record from a batch-fleet run, superseding
    20260731-191813-5f5288b. Old record untouched.
    Part of #593
    Loom-Issue: 2AMLogic/gf180-sar-adc#599
2026-11-04 feat(sta): pin klt for the extracted-SPEF STA flow and record a 0.8.0 qualification run
    Adds design/sar-logic/flow/toolchain.json (exact `klt --version`, verbs,
    extract flags) enforced by sta_toolchain_pin.py before the --spef mode
    runs, reusing layout/toolchain_pin.py (new optional pin_path arg only
    names the pin file in the error). Offline tests cover identity mismatch,
    missing verb/flag, absent klt and malformed pin.
    Includes the append-only record from one run under a throwaway
    klayout-tools==0.8.0 env: 5/5 corners passed the unchanged annotation
    gate and the three negative controls rejected. Run was on a dirty tree
    (disclosed in the record); not a timing-closure claim.
    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
2026-11-05 fix(sim): cite adc-power re-qualification record in characterization summary
    Cite 20261105-050939-bca53f9 as governing for the V_CM row's Power pair
    (historical: 20260923-112459-836a876) and retarget the Power @ 1 MS/s
    schematic exception for 20260826-085142-155595d to the new record.
2026-11-05 fix(adc-offset-mc): store gate-655 evidence bytes in the artifact store
    CI forbids new files under sim/*/corners/ (DR-0041, #636). Move the report
    and stderr to the artifact store; commit the manifest and the GATE summary.
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2026-11-05 fix(signoff): re-pin T1 item 8 evidence after #706 re-pointed a characterization-summary citation
    Addresses the red 'T1 signoff verdict freshness' step on #706 that was
    masked by the earlier stored-evidence failure.
    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
2026-11-05 fix(pex): store adc-block-pex evidence via the artifact store, not tracked paths
    run_pex_adc_block.py now stages the report, stderr and netlist snapshot under
    sim/.work/.stage/, preflights the store before klt pex, and commits only the
    manifest and record (DR-0041 / #636).
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2026-11-05 fix(signoff): re-pin T1 item 8 after the summary cites the clean-tree cdac-bit-settling record
    New report and record; no row moves (18/22, 1 n/a).
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2026-11-05 feat(sim): re-qualify adc-enob-fft schematic 9-point 125 C grid under open_pdks f6eeac7 on the batch fleet
    New record 20261105-081016-f3046d6 supersedes 20260817-080939-afb1b3a
    (tt/ss/ff x 125 C x 2.97/3.30/3.63 V, one klt sim batch-set on
    aws-batch-fleet, ngspice 46). All 9 points PASS; output codes identical
    and decoder errors match the superseded record to <=1e-3 LSB. No code
    changes. Other adc-enob-fft records (extracted decks, DR-0036 V_DD network
    variant) are not re-qualified here.
    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
2026-11-05 fix(signoff): regen T1 verdict + record after #618 characterization-summary re-point
    Runs signoff --regen under the pinned klt build (44cc4232); new report and
    record, no row moves (18/22, 1 n/a). Addresses the red 'T1 signoff verdict
    freshness' step exposed once the stage-1 harness failure was fixed.
2026-11-05 fix(sim): repoint ENOB/SFDR summary citations to #594 record; drop manifest entries duplicating committed logs
    - characterization-summary.md:525-526: 20261105-081016-f3046d6 is now the
    current schematic citation; 20260817-080939-afb1b3a becomes historical.
    - adc-enob-fft-20261105-081016-f3046d6 manifest: the nine per-corner .log
    files are byte-identical (same sha256) to committed logs under
    sim/acq-leg-width-sweep/corners/20261020-180420-c33f4e4/, which the
    artifact-manifest guard forbids storing. Entries removed; the record now
    lists name/size/sha256 and the committed copy for each.
2026-11-05 feat(sim): 27-point extracted ENOB/SFDR temperature grid; cold governs both rows
    Runs the extracted FFT deck over tt/ss/ff x -40/27/125 C x 3 supplies on the
    batch fleet (27/27 completed, record 20261105-125230-b281aa8) and analyses
    every point with per-corner noise composition. The 125 C legs reproduce the
    20261007 hot control exactly. Worst point is cold (ss_-40c_2.97v: SFDR 57.96 dB,
    composed ENOB 8.734); both ratified rows stay FAIL.
    analyze_fft.py now also parses the batch-run log form of the per-sample code
    (sNNN = x, without the m_code_ prefix). README status rows and the
    characterization summary cite the new record. No spec, hardware or target change.
    Part of #430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
2026-11-05 fix(signoff): re-pin T1 items 8 and 9 and mint record after #430 evidence
    Re-pins item 8 to the new characterization-summary bytes, re-attests the item 9
    analog envelope (154/154, PDK-free cold start) after analyze_fft.py gained the
    batch log form, and runs signoff --regen under the pinned klt (44cc4232) from a
    throwaway venv. No row moves (18/22, 1 n/a).
    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
2026-11-05 refactor(sim): share full-PVT campaign driver between vcm and vdd scripts
    Move the arm loop, deck selection, provenance-validator preflight and
    run_corners.py argument assembly into sim/full_pvt_common.sh. Both
    run_full_pvt.sh paths stay as thin wrappers so record citations resolve.
    vdd gains the SUPERSEDES / EXTRA_NOTE / KLT_CMD hooks vcm already had, and
    vcm gains PREFLIGHT_ONLY. run_corners.py argument lists are byte-identical
    before/after for every deck and arm of both campaigns.
2026-11-05 fix(signoff): pin sim/full_pvt_common.sh in the item 9 analog inventory (#722)
    Adds the shared full-PVT driver to the analog testbench inventory, re-attests
    item 9 (155/155, PDK-free), re-pins the manifest to the new inventory hash and
    mints a new record under the pinned klt (44cc4232). No row moves (18/22, 1 n/a).
2026-11-05 fix(signoff): pin sim/full_pvt_common.sh in freshness.json item 9 artifacts (#722)
    --check hashes the tree against freshness.json's artifacts map, so listing
    the shared driver in the inventory alone left edits to it undetected. Pin it,
    re-mint via --regen with the pinned klt, add the record.
2026-11-06 refactor(sim): share sweep point-loop driver across the three run_sweep.sh scripts
    Moves selection, unknown-point rejection (exit 2), status capture, summary,
    non-zero exit on failure and the JOBS/NGSPICE_THREADS/KLT_CMD/
    RUNNER_VERSION_CHECK passthrough into sim/sweep_common.sh. Wrappers keep
    their paths, POINTS, prose and variant generation. Assembled run_corners.py
    argv is unchanged for every default point. Re-pins item 9 inputs.
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2026-11-06 power: re-baseline layout/power for the notched GDS; replace non-discriminating negative control
    Mint record 20261106-202719-e38687e0 on adc_block.gds fc10bb28 under the
    pinned klayout-tools==0.6.0 / klayout 0.30.10. cases.json layout_sha256 and
    expects updated deliberately. control.metal2-as-poly2 measured 32.60 mV
    (under the 33 mV DR-0034 budget) on the notched layout, so it was replaced
    by control.metal2-at-4x-poly2 (Metal2 at 29.2 ohm/sq), which fails at
    45.901 mV; no expected verdict was flipped to pass. Old records untouched.
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2026-11-08 feat(sim): record platform, ngspice banner and observed front-end mode
    Records now render launcher platform/hostname, the verbatim `ngspice
    --version` output and the per-point compatibility note (uniform /
    inconsistent / unavailable; absence never read as "no mode"). Batch records
    label these as launcher, not worker. Older records still render. The
    front-end mode stays host-controlled; reasoning cites the #623 A/B.
    Part of #468
    Loom-Issue: 2AMLogic/gf180-sar-adc#468
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2026-11-08 sim(comparator-preamp-noise): re-qualify the 45-point noise grid under open_pdks f6eeac7 on the batch fleet
    Record 20261108-031240-6ba19f6 supersedes 20260806-233123-56be937; all eight
    metrics match the old record to printed precision. Offset-gof/-mc stay listed
    as not re-qualified (seeded draw sequence has no klt sim equivalent).
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2026-11-13 sim: re-qualify sar-logic-functional under f6eeac7; wait for batch capacity on submit
    Adds a superseding sar-logic-functional record from a real batch run, records the
    failed gate-level attempts, and makes the harness pass --wait-for-capacity 600.
    Part of #596
2026-11-13 fix(signoff): re-pin T1 item 8 after #596 summary citation repoint; regen verdict + record
    Not a re-read; 18/22 unchanged. Regenerated with the pinned klt 44cc423 from a throwaway venv.
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2026-11-13 docs(signoff): replace per-re-pin chain narration with id-named row movers
    The paragraph after `signoff/README.md`'s `<!-- signoff:current-record -->`
    citation narrated the chain in relative terms ("That record re-pins ...",
    "Its predecessor ...", "the one before it ..."). `run_signoff.py --check`
    verifies the citation but not the prose, so every re-pin that moved only the
    marked citation left the narration one record further behind: on `main` it
    described `20261105-131702-43020bf7` while the pointer named
    `20261113-084059-865597d5`, and five records in between were named nowhere.
    Replace the narration rather than bringing it up to date:
    - Say where the chain actually lives — each record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
2026-11-13 sim(sar-logic): regenerate the 7 gate-level decks under open_pdks f6eeac7
    The pinned PDK re-bind (#514/#517, c6d73a3 -> f6eeac7) changed
    gf180mcu_fd_sc_mcu7t5v0's SPICE library from the 6V-oxide device to the
    5V-oxide one: the old library binds 4809 *fet_06v0 instances, the new one
    4810 *fet_05v0. The committed decks inline that library text, so all seven
    gate-level testbenches still described the OLD standard cells.
    Regenerated with `python3 design/sar-logic/flow/gen_sar_ctrl_gates_tb.py`.
    The diff is device-name-only: all 1148 changed lines are a *fet_06v0 ->
    *fet_05v0 swap, every W/L unchanged.
    This was invisible to CI: sim/tests/test_sar_ctrl_gates_tb.py's drift tests
    skip when no gf18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
2026-11-13 fix(signoff): re-pin T1 item 9 after the gate-level deck regeneration; regen verdict + record
    The seven gate-level decks moved in a699814d, and item 9 attests their bytes,
    so its inventories, envelopes and manifest pins had to move with them. The same
    pass corrects the open_pdks revision both item-9 inventories still declared
    (c6d73a3 -> f6eeac7), which had been stale since the #514/#517 re-pin.
    Not a re-read; 18/22 met + 1 not applicable, and the rendered row table is
    byte-identical to 20261113-084059-865597d5's. Regenerated with the pinned klt
    44cc423 from a throwaway venv, not the host-wide klt.
    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
2026-11-13 docs(sim): record the #596 gate-level deck finding and the fleet-blocked grids
    Rewrites sim/requalification-596-sar-logic.md around what tranche 2 actually
    established: the gate-level decks did not describe the pinned PDK, and the two
    grids re-attempted against the corrected decks were defeated by the batch
    fleet (one set never left 'pending' inside the 600 s capacity wait; the other
    lost two jobs to Spot reclamation and one to the 3600 s job ceiling, 45/45
    points ERROR).
    No record is committed for either run. run_corners.py writes the --supersedes
    pointer even when every point errored, so committing the timing-gates ERROR
    record would have displaced 20260915-210638-912a8ec -- the only reco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
2026-11-13 fix(harness): withhold the Supersedes pointer when no point reached ok
    A run in which every point errored (fleet timeout, Spot reclamation, a
    broken deck) measured nothing, so it cannot replace a record that did --
    but `run_corners.py --supersedes <id>` wrote the pointer unconditionally.
    Because `sim/` is append-only, such a record is a permanent chain tip: a
    reader walking the chain for "the current evidence" lands on a record whose
    every cell is `n/a`. This already happened once, in
    `sar-logic-functional-gates/records/20261113-080712-3eed6a0.md`.
    `build_record` now moves the requested id to a new `supersedes_withheld`
    field when `points_ok` is 0, leaving `supersedes` empty. The record is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
2026-11-13 fix(signoff): re-attest T1 item 10 after this PR edited sim/README.md; regen verdict + record
    The `signoff --check` gate pins `sim/README.md` by hash for T1 item 10 (repo
    hygiene), and #755's new "a record with no ok point supersedes nothing"
    paragraph moved it (sha256:3a237729... -> sha256:18be0cb5...), failing CI with
    `[FAIL] item 10.analog` / `[FAIL] item 10.digital`.
    Re-ran the flow the gate names, not the pinned hash:
    - `klt signoff --attest 10 --inventory signoff/repo-hygiene-inventory.json`
    under the `signoff/toolchain.json`-pinned klt 0.7.1.dev1744+g44cc42323184
    (throwaway venv, not the host-wide 0.9.2.dev901), 9/9 checks pass. The
    inventoried repo-root `README.md`'s recorded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
2026-11-13 docs(spec): cite the standard-cell device by its f6eeac7 name; repair the LVS wrong-width control
    The open_pdks c6d73a3 -> f6eeac7 re-pin renamed what the gf180mcu standard
    cells bind, `*fet_06v0` -> `*fet_05v0`, with every W/L unchanged. Live text
    and one regex still named the old subcircuit.
    Re-counted against the pinned library (4810 / 4816 references, zero `*_03v3`)
    and read the model file: `nfet_05v0`/`pfet_05v0` are `.subckt` wrappers whose
    MOS instance binds the `nfet_06v0`/`pfet_06v0` model card, and the PDK defines
    no `*_05v0` model card at all. So the device, the oxide and DR-0023's
    conclusion are unchanged -- only the cited name was stale, and "6 V-oxide"
    stays where it is a phys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
2026-11-13 fix(sim/harness): scope the fleet pin check to members that banked points
    A `klt sim --batch-set` member reclaimed by Spot comes back with no engine
    banner to parse. `fleet_toolchain_drifts` read that absence as an ngspice
    drift and `_run_through_klt` applied the verdict to the whole set, so one
    interrupted member refused a run in which every other member had scored
    in-bound points on a pinned toolchain (issue #753 banked 15/45 as a result).
    Pass only the outcomes whose supply produced at least one `ok`/`failed`
    point. A member that scored nothing contributed no number to the record, so
    its toolchain cannot make the recorded numbers incomparable; its points stay
    `error` points carrying klt'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
2026-11-13 test(signoff): fail CI when a testbench inventory's PDK pin drifts from sim/toolchain.json
    Both `signoff/testbench-inventory.{digital,analog}.json` restate the PDK
    revision in `pins.pdk.revision`, but the source of truth is `open_pdks` in
    `sim/toolchain.json`, and nothing compared the two. `klt signoff --attest 9`
    validates the pin against whatever the inventory itself declares, so after the
    #514/#517 re-pin both inventories kept declaring `c6d73a3` and T1 item 9 kept
    reading `met` until PR #756 corrected them by hand.
    Add `sim/tests/test_signoff_inventory_pdk_pin.py`: a stdlib `unittest` module
    whose `pin_mismatches(toolchain_path, inventory_paths)` returns one message per
    disagreement, ea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
2026-11-13 fix(sim/harness): take the record's engine identity from the banked members
    The pin check is scoped to `scored_outcomes`, but `_identity_report` still
    chose from every reporting member. An unscored member that did report a
    banner -- and reported an off-pin one -- was therefore exempt from the check
    yet still stamped the record: `conforms: true`, no drift, labelled
    `ngspice-42`, while all four banked points ran on 46. An all-`error` member
    on a drifted runner is a plausible shape (the off-pin engine can be why
    every point errored), and `sim/` records are append-only, so a mislabelled
    record cannot be corrected afterwards.
    Narrow the identity to the same subset the pin check covers: the first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
2026-11-13 docs(sim): point the tranche-3 note at the section that now holds the recipe
    Follows the job-split guidance from sim/README.md to
    sim/harness/README.md.
    Part of #753
    Loom-Issue: 2AMLogic/gf180-sar-adc#753
2026-11-13 docs: name the OSU 3.3 V libraries in every ciel enable command
    `ciel`'s `-l/--include-libraries` selects the library set rather than adding
    to it, so the documented `-l gf180mcu_fd_pr <hash>` installed only the device
    models — not the `mcu7t5v0` standard cells the sar_ctrl sign-off chain reads,
    and not the two OSU 3.3 V libraries DR-0044's `libs.ref/` listing enumerates.
    A reader following the docs literally got a tree that cannot reproduce the
    committed evidence.
    Switch every human-facing install command to
    `-l default -l gf180mcu_osu_sc_gp9t3v3 -l gf180mcu_osu_sc_gp12t3v3`, which
    resolves under ciel 2.6.1 to exactly the seven libraries DR-0044 lists, and
    add an environment-setup §3 su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
2026-11-13 fix: skip the non-ok deck copy when the log dir is the workdir
    `to_point_results` preserves the deck of every non-`ok` point next to the
    committed log. A no-record run (`--no-write`, and `--sabotage-corners`
    through the same `no_write` flag) has no log directory, so `cli` passes
    `log_dir or workdir` and the two are one directory — making that copy a
    same-path `shutil.copyfile`, which raises `SameFileError` and discarded the
    summary of fleet work that had already been paid for. A probe is run
    precisely when a timeout is likely, so this fired on the common result.
    Compare the two directories once before the loop and skip the copy when
    they are the same; the deck is already where it belongs.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
2026-11-13 refactor: share one check-or-write tail across the extracted-deck generators
    Add `gen_extracted_core_tb.emit_generated(text, out_path, *, check,
    stdout)` and route all six `gen_extracted_*_tb.py` generators' `main()`
    tails through it.
    Three of the six (`enob_fft`, `inl_dnl`, `power`) carried this as a
    byte-identical 15-line block, `switch_ron` the same block plus an `OK:`
    print, and `dr0014_sampling` / `timing_budget` hand-rolled variants of
    the same job. The copies had drifted: `--check` on a missing deck said
    `STALE:` in four and `MISSING` in two, the `--check` success path was
    silent in three and printed three different sentences in the rest, and
    two rewrote their deck unconditionally ra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
2026-11-13 fix: decide the body tie from the remediation partition, drop the dead raw probe
    `verify_remediation_dc.py` always verifies the newest committed extraction
    (`R._latest_report()`, no netlist argument), and both of its body-tie-era
    assumptions went stale under it:
    * The invariant was a string match, `pfet_bodies == {"vdd"}`. Device-card
    terminals are parasitic LEGS of their hub (`vdd__t<k>`) since the `875eac3`
    toolchain pin, and after DR-0035 drew n-well taps the bodies arrive tied
    rather than rewritten -- so it is False on both committed tapped
    extractions, and the script reported `RESULT: FAIL` before any convergence
    result mattered.
    * `raw_body_nodes()` ran a 600 s-budget RAW-co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
